lambert/26/README.md

# 26 Octave Filter

[Documentation](docs/README.md).

[Electrical CAD files](ecad/README.md)

[Mechanical CAD files](mcad/README.md)

CC BY-SA
