lambert/26/ecad/pcb/README.md

Requires [pcb version 4.1.2](https://sourceforge.net/projects/pcb/files/pcb/pcb-4.1.2/) or later.
