lambert/26/ecad/pcb/plotfiles/26.999.00.01.01.pcb.pdf

## 26.999.00.01.01.pcb

## 1. Table of Contents (This Page) Created on Sat Feb 13 14:51:58 2021 2. top 3. bottom 4. outline 5. plated-drill 6. componentmask 7. soldermask 8. topsilk 9. bottomsilk 10. bottompaste 11. topassembly 12. bottomassembly 13. fab

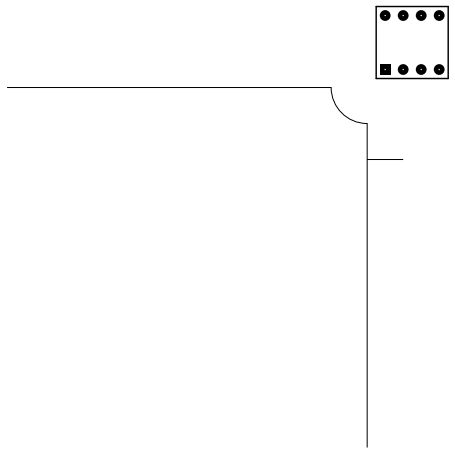
[picture p258: figure]

26.999.00.01.01.pcb, top, scale = 1:1.000

26.999.00.01.01.pcb, bottom (mirrored), scale = 1:1.000

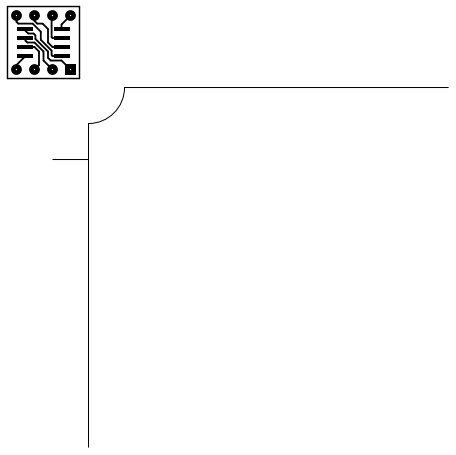
[picture p259: figure]

26.999.00.01.01.pcb, outline, scale = 1:1.000

26.999.00.01.01.pcb, plated-drill, scale = 1:1.000

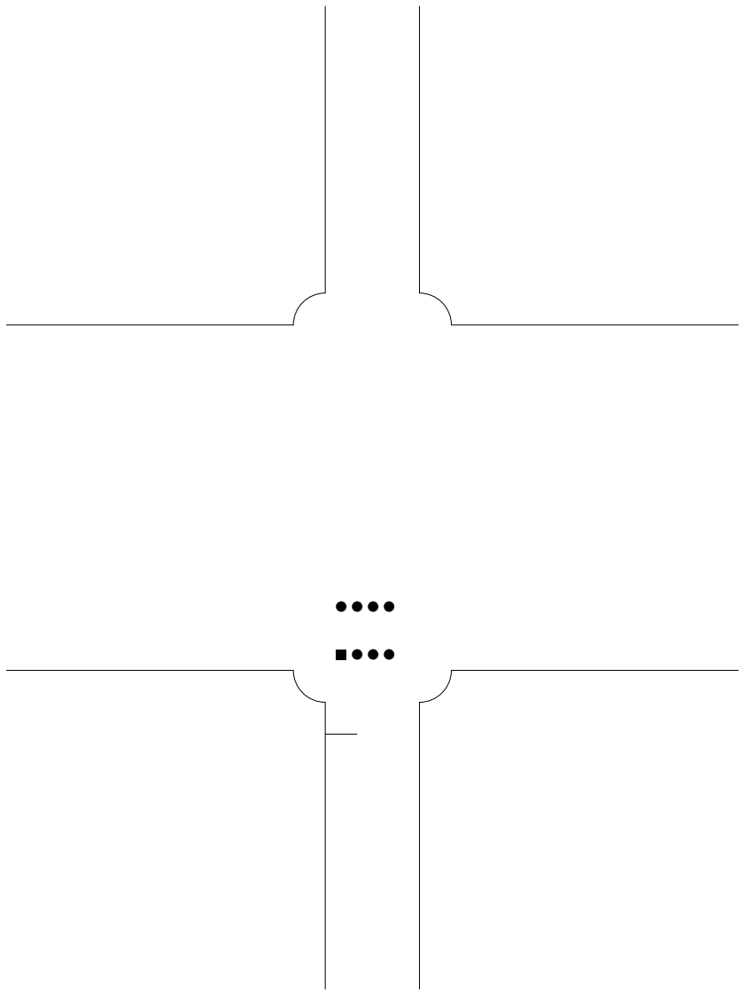
[picture p260: figure]

26.999.00.01.01.pcb, topmask, scale = 1:1.000

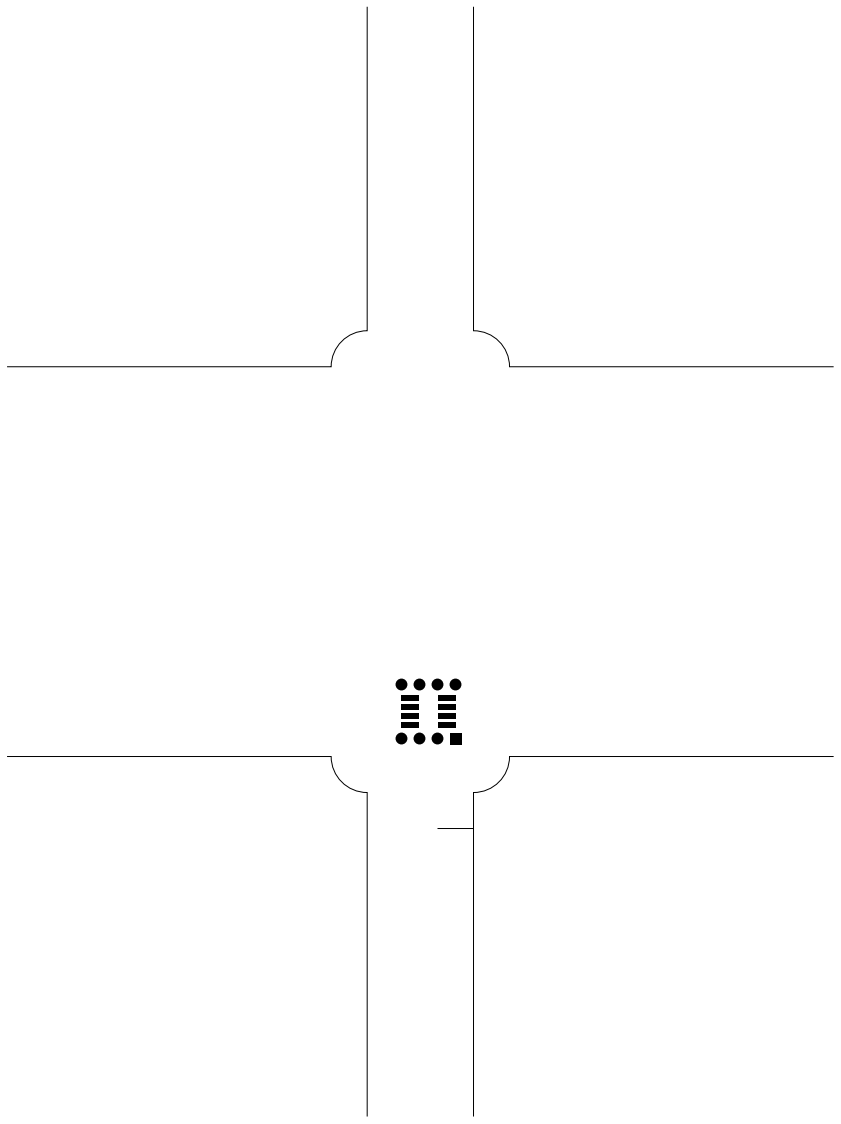
[picture p261: figure]

26.999.00.01.01.pcb, bottommask (mirrored), scale = 1:1.000

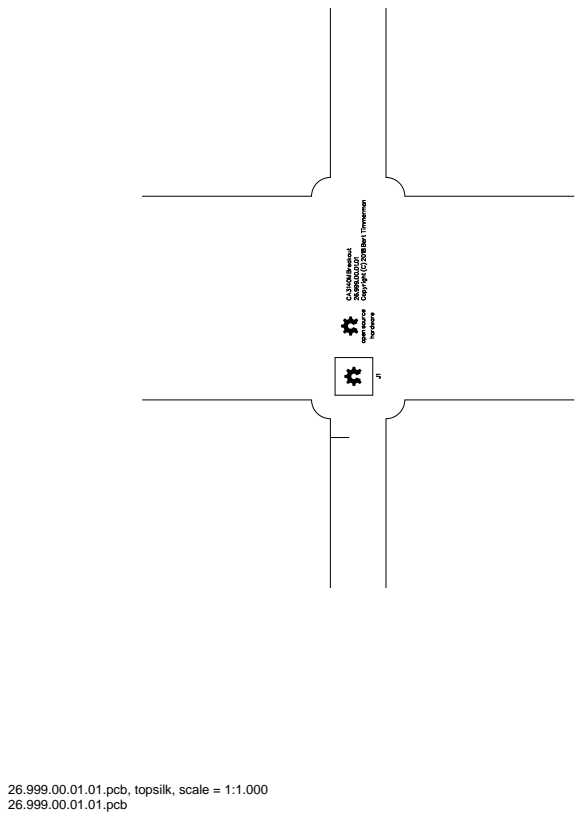
[picture p262: page 8]

26.999.00.01.01.pcb, topsilk, scale = 1:1.000

26.999.00.01.01.pcb, bottomsilk (mirrored), scale = 1:1.000

26.999.00.01.01.pcb, bottompaste (mirrored), scale = 1:1.000

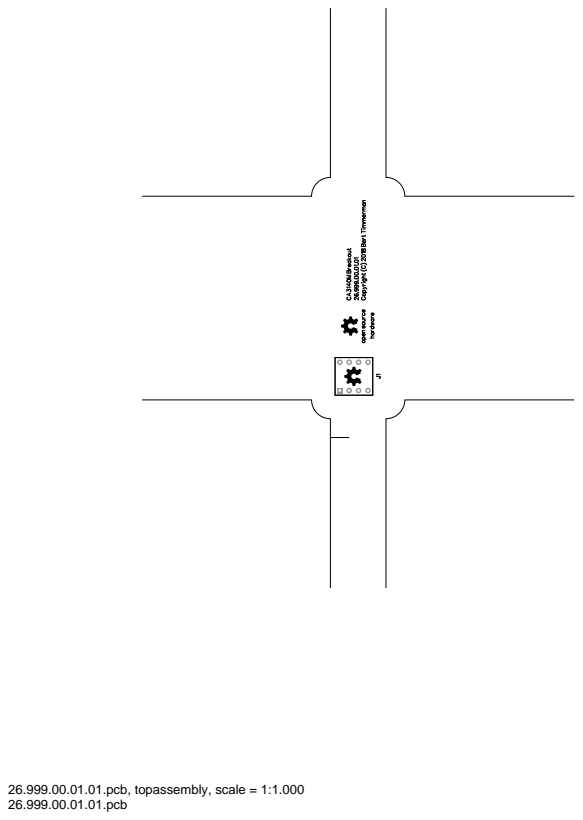
[picture p263: page 11]

26.999.00.01.01.pcb, topassembly, scale = 1:1.000

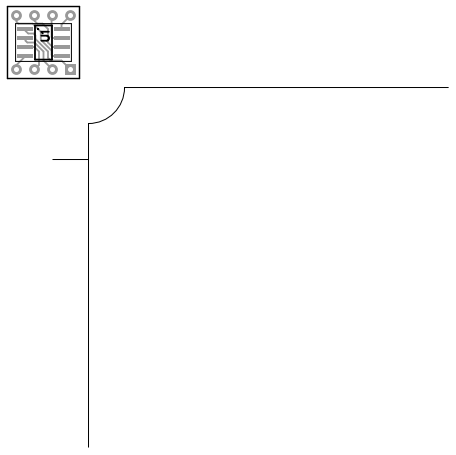
[picture p264: figure]

26.999.00.01.01.pcb, bottomassembly (mirrored), scale = 1:1.000

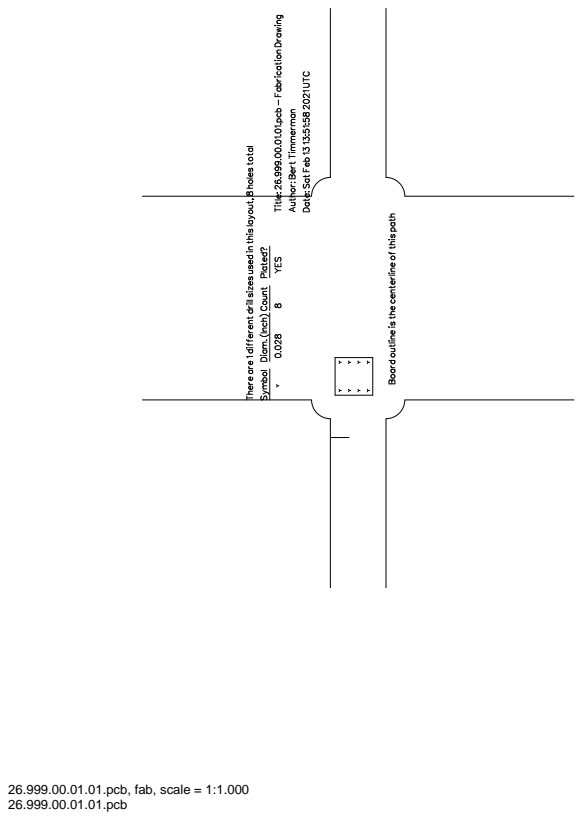
[picture p265: page 13]

26.999.00.01.01.pcb, fab, scale = 1:1.000
