lambert/26/ecad/pcb/plotfiles/26.999.01.01.01.pcb.pdf

## 26.999.01.01.01.pcb

## 1. Table of Contents (This Page) Created on Sat Feb 13 14:51:58 2021 2. top 3. bottom 4. outline 5. plated-drill 6. componentmask 7. soldermask 8. topsilk 9. bottomsilk 10. bottompaste 11. topassembly 12. bottomassembly 13. fab

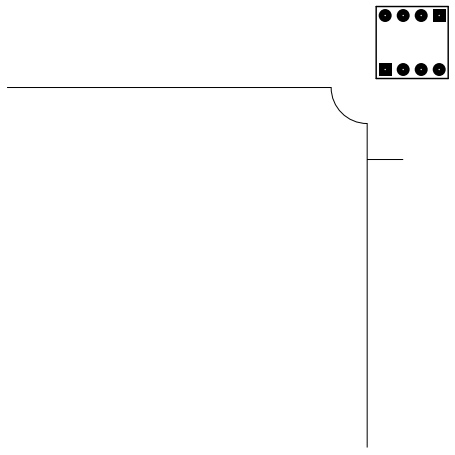
[picture p266: figure]

26.999.01.01.01.pcb, top, scale = 1:1.000

26.999.01.01.01.pcb, bottom (mirrored), scale = 1:1.000

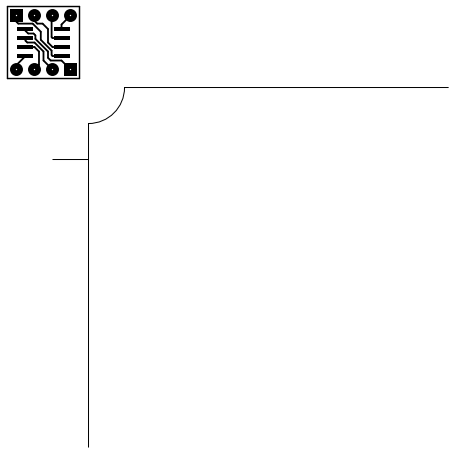
[picture p267: figure]

26.999.01.01.01.pcb, outline, scale = 1:1.000

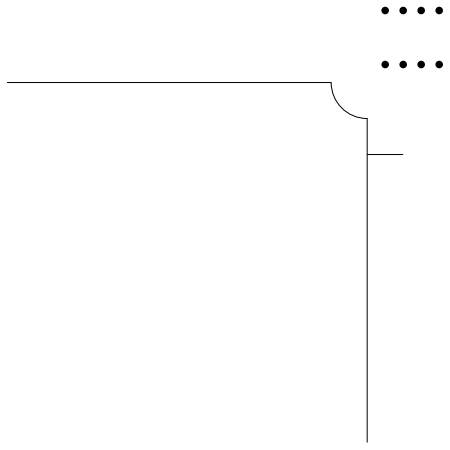
[picture p268: figure]

26.999.01.01.01.pcb, plated-drill, scale = 1:1.000

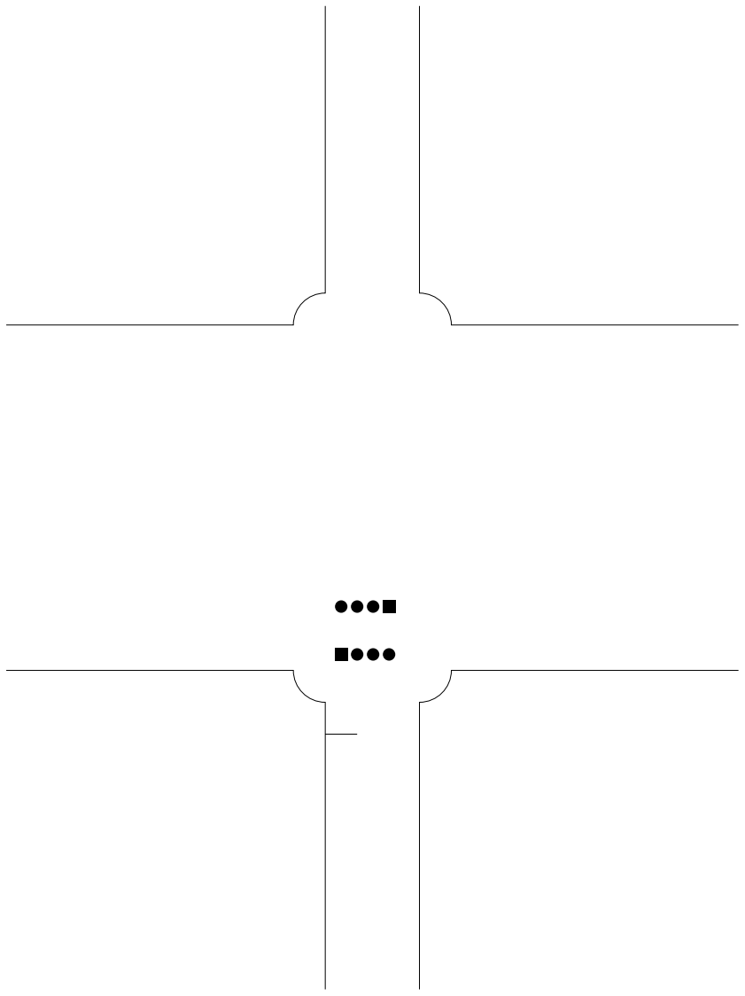
[picture p269: figure]

26.999.01.01.01.pcb, topmask, scale = 1:1.000

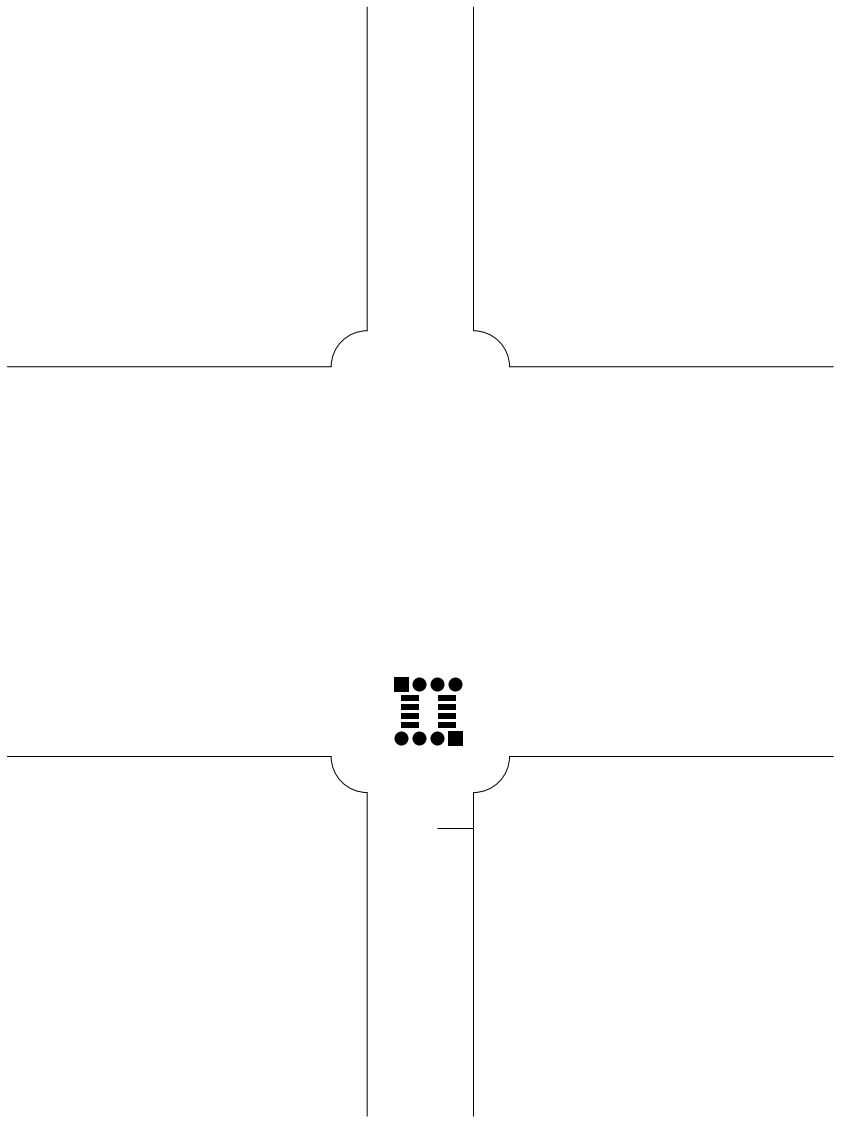
[picture p270: figure]

26.999.01.01.01.pcb, bottommask (mirrored), scale = 1:1.000

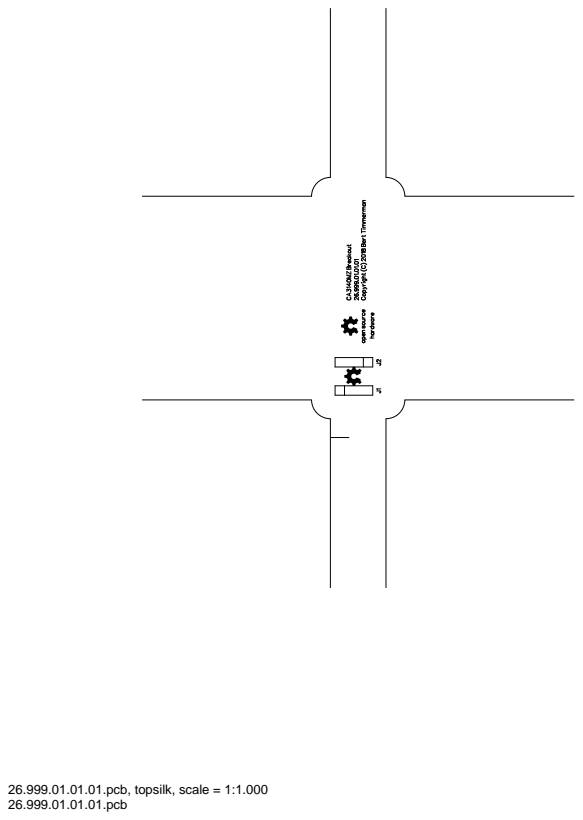
[picture p271: page 8]

26.999.01.01.01.pcb, topsilk, scale = 1:1.000

26.999.01.01.01.pcb, bottomsilk (mirrored), scale = 1:1.000

26.999.01.01.01.pcb, bottompaste (mirrored), scale = 1:1.000

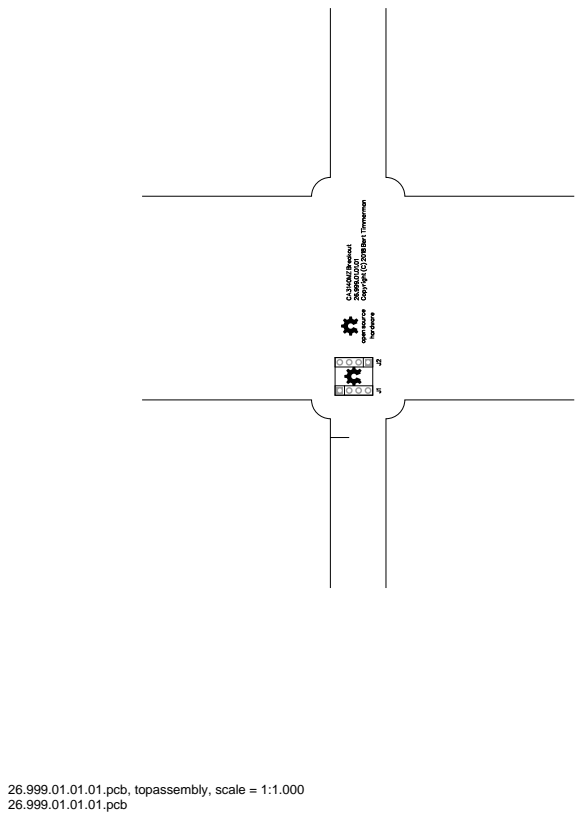
[picture p272: page 11]

26.999.01.01.01.pcb, topassembly, scale = 1:1.000

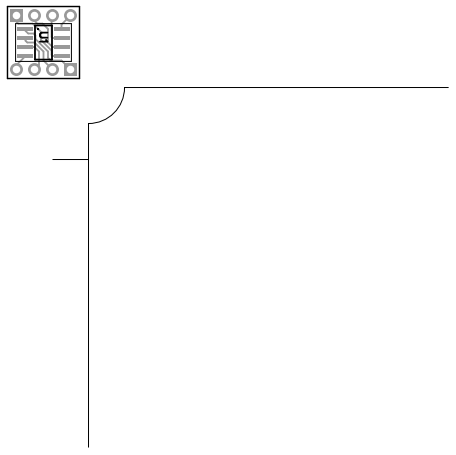
[picture p273: figure]

26.999.01.01.01.pcb, bottomassembly (mirrored), scale = 1:1.000

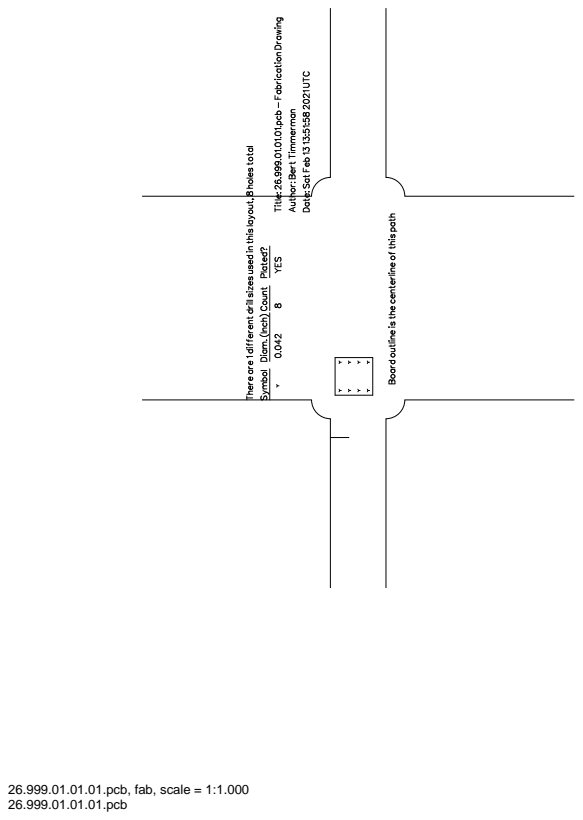
[picture p274: page 13]

26.999.01.01.01.pcb, fab, scale = 1:1.000
