lambert/26/ecad/gnucap/26.000.00.02.07.png

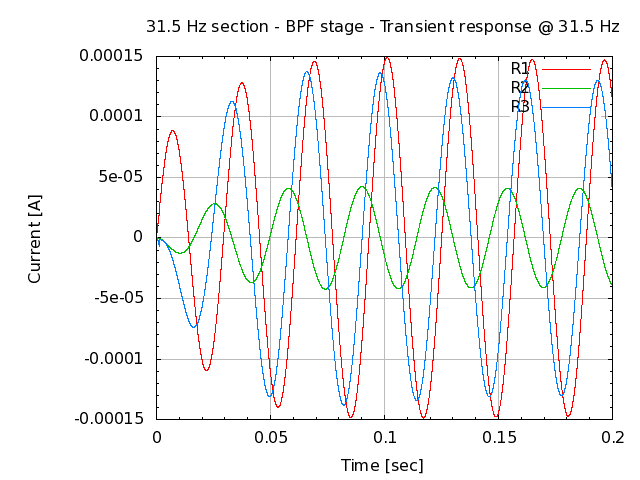
ecad/gnucap/26.000.00.02.07.png
