lambert/26/ecad/pcb/eyecandy/26.002.00.01.01.pcb.top.png

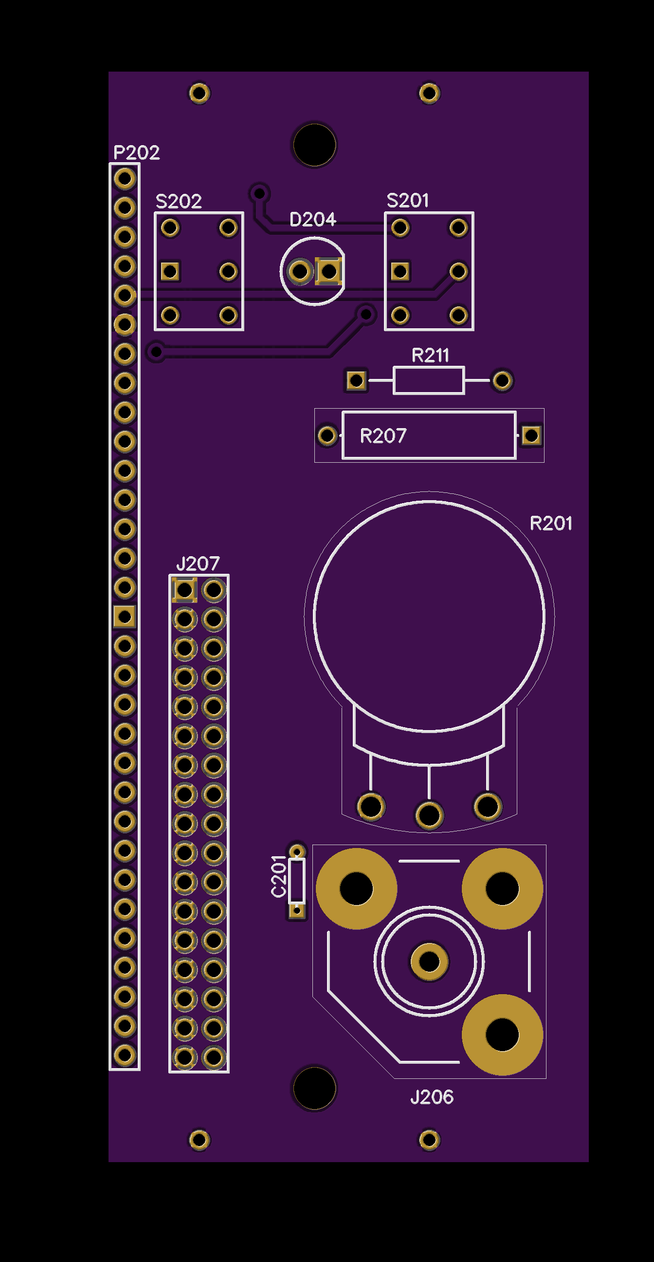
ecad/pcb/eyecandy/26.002.00.01.01.pcb.top.png
