lambert/26/ecad/pcb/eyecandy/26.003.00.01.01.pcb.top.png

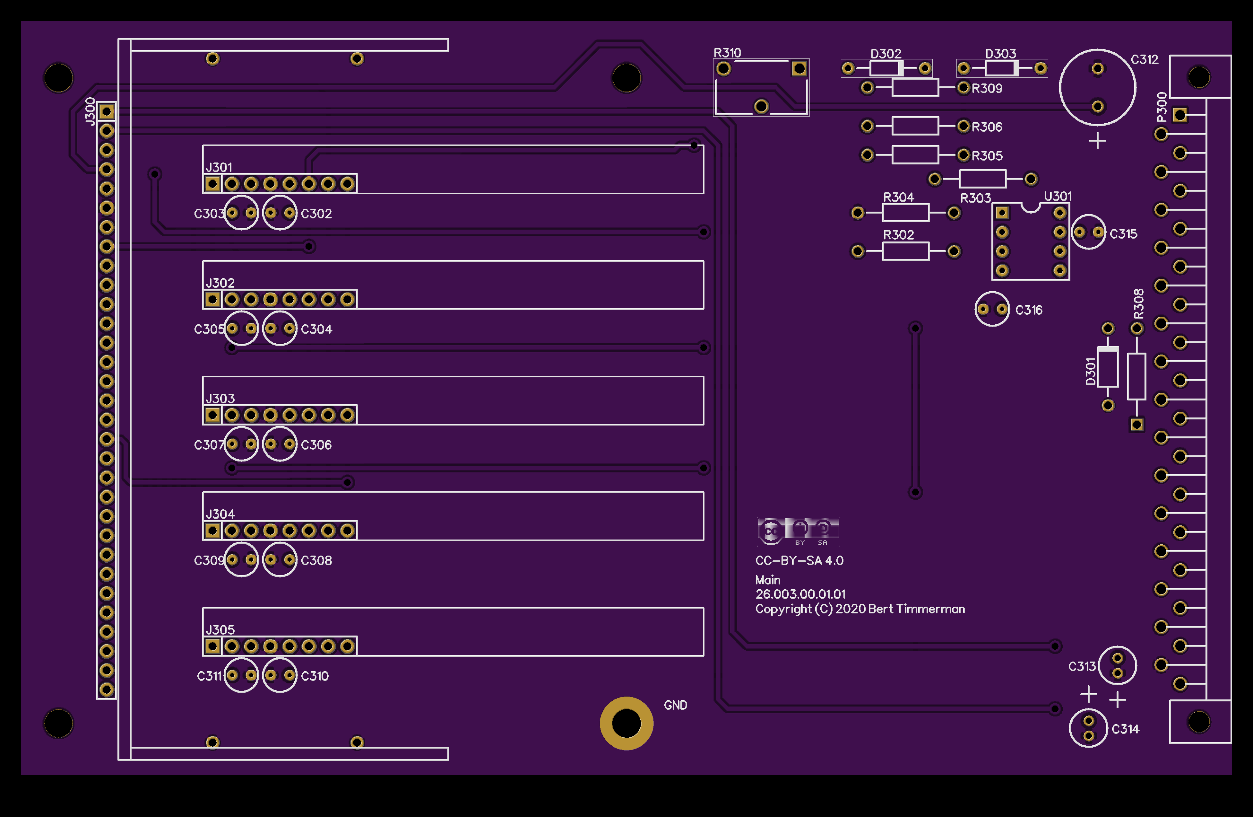
ecad/pcb/eyecandy/26.003.00.01.01.pcb.top.png
