lambert/26/ecad/pcb/eyecandy/26.005.00.01.01.pcb.top.png

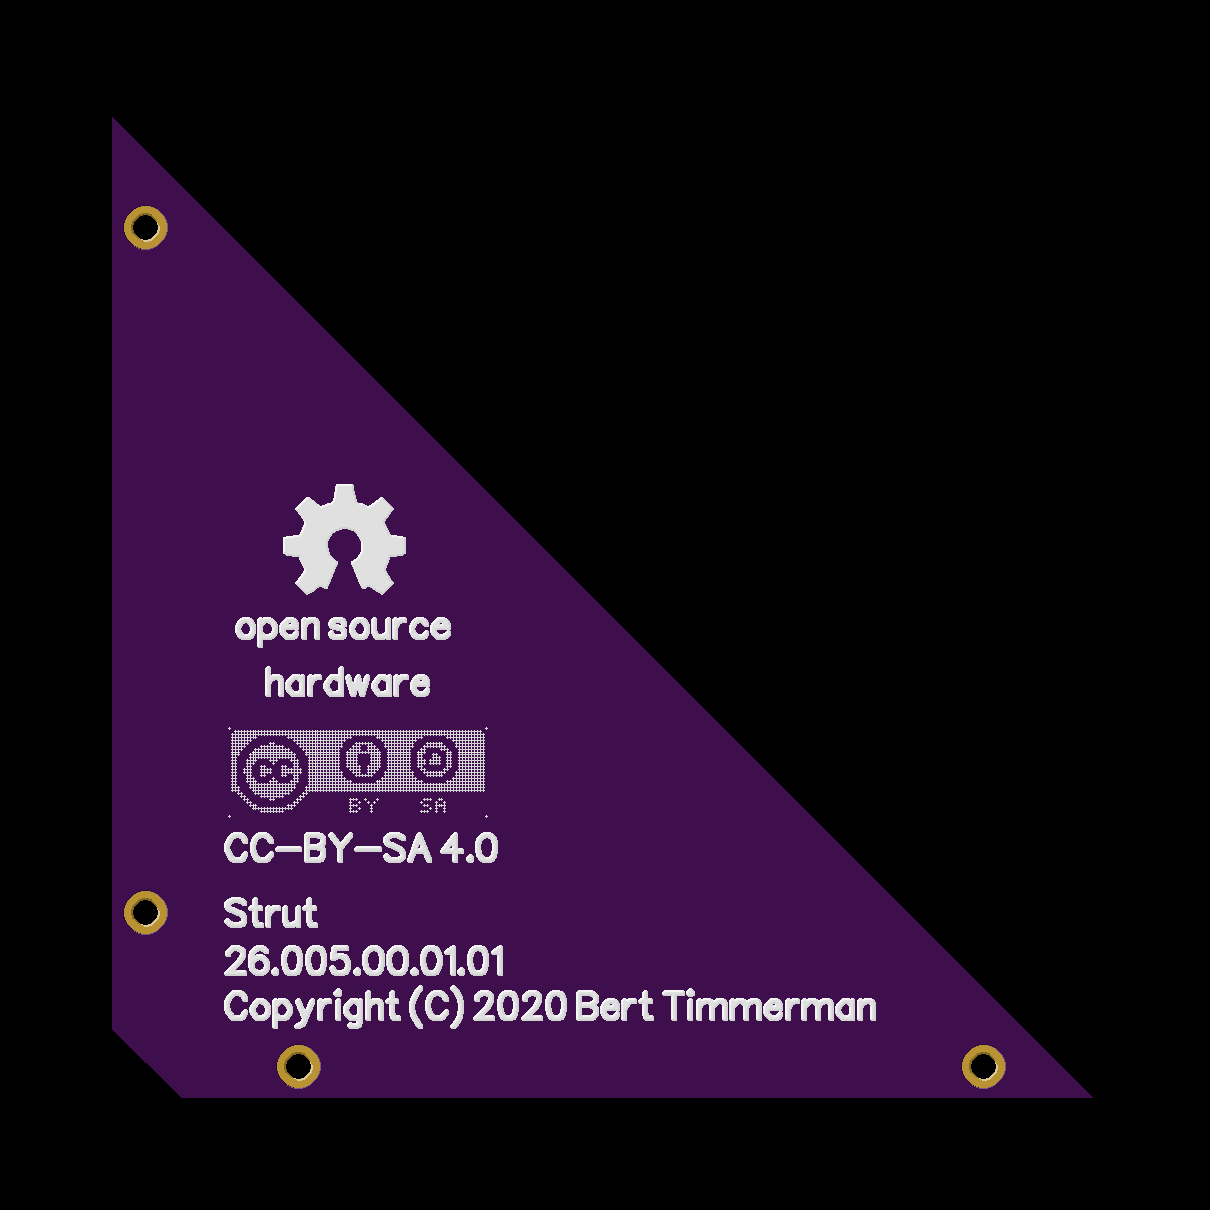
ecad/pcb/eyecandy/26.005.00.01.01.pcb.top.png
