lambert/26/ecad/pcb/eyecandy/26.006.00.01.01.pcb.bottom.png

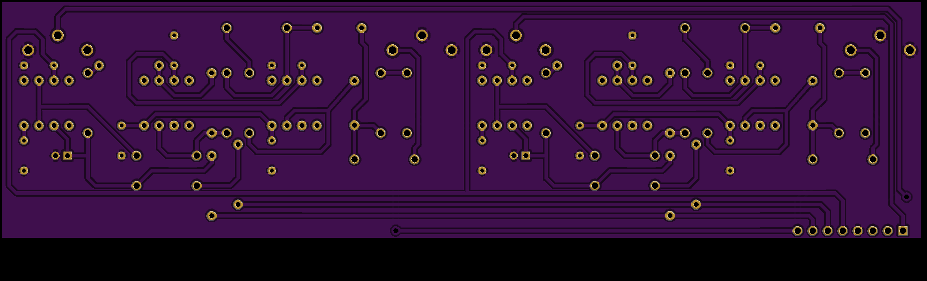
ecad/pcb/eyecandy/26.006.00.01.01.pcb.bottom.png
