lambert/26/ecad/pcb/eyecandy/26.006.02.01.01.pcb.bottom.png

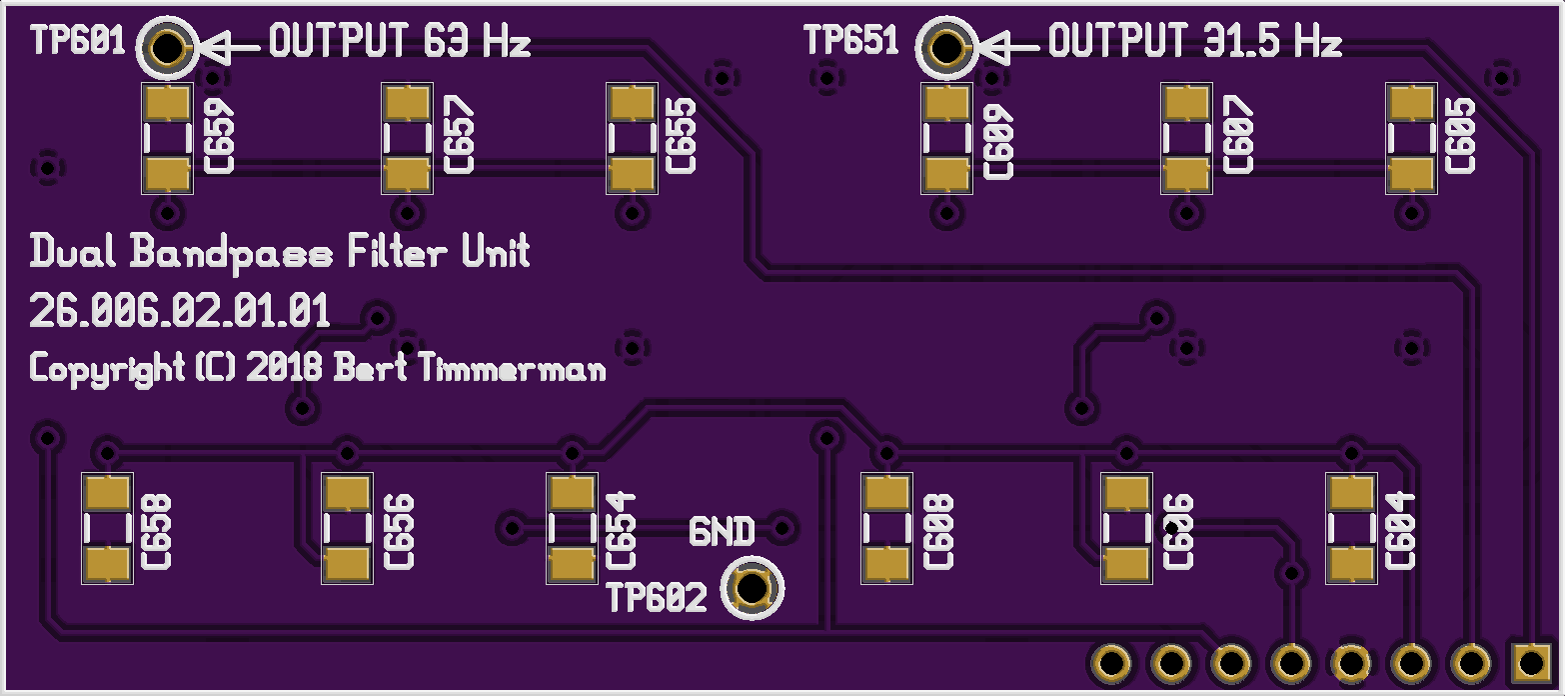
ecad/pcb/eyecandy/26.006.02.01.01.pcb.bottom.png
