lambert/26/ecad/pcb/eyecandy/26.999.00.01.01.pcb.bottom.png

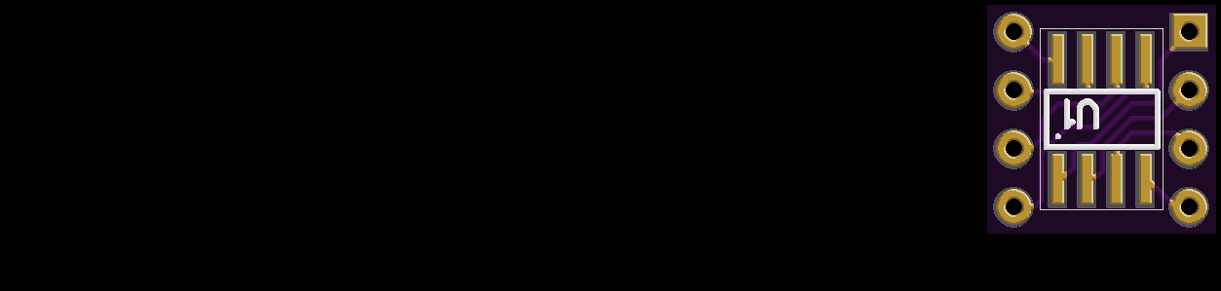
ecad/pcb/eyecandy/26.999.00.01.01.pcb.bottom.png
