lambert/26/docs/purchase/OSH_Park/README.md

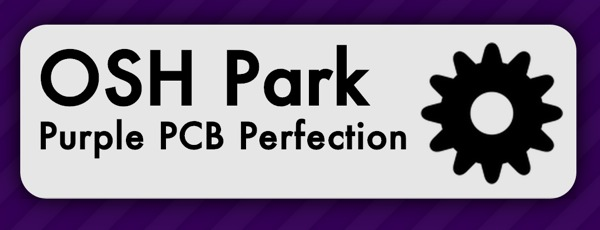
[picture p293: docs/purchase/OSH_Park/OSH_Park_logo.jpg]
OSH_Park_logo
.

----

# 26.004.00 Main board cover and shielding.

**DO NOT ORDER** (Work In Progress).

Top view:

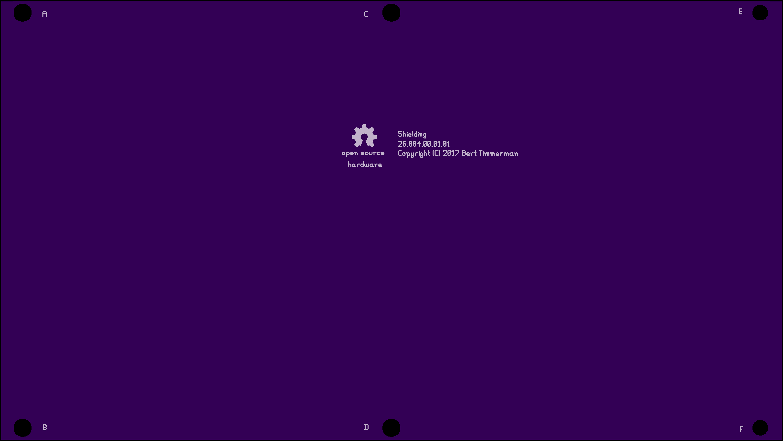
[picture p294: docs/purchase/OSH_Park/26-004-00/26-004-00_top_large.png]


Bottom view:

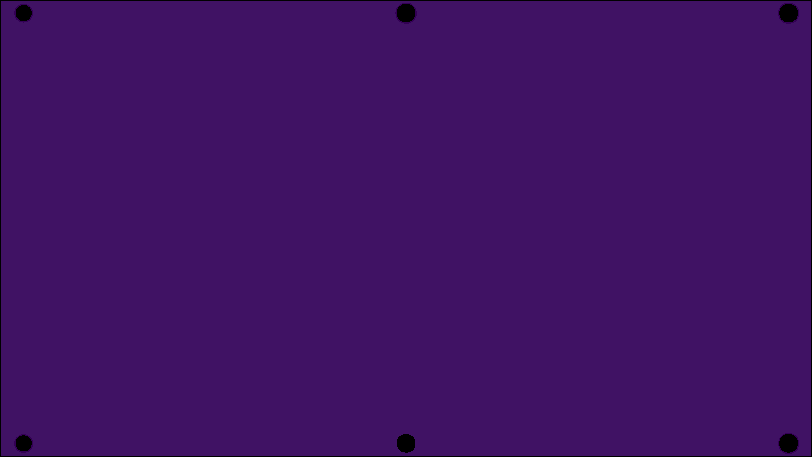
[picture p295: docs/purchase/OSH_Park/26-004-00/26-004-00_bottom_large.png]
Bottom view


[Project description](26-004-00/README.md)

----

# 26.006.00 Band pass filter daughter board.

First PTH version.

**DO NOT ORDER** : contains a connection (polarity) error on all operational amplifiers.

Top view:

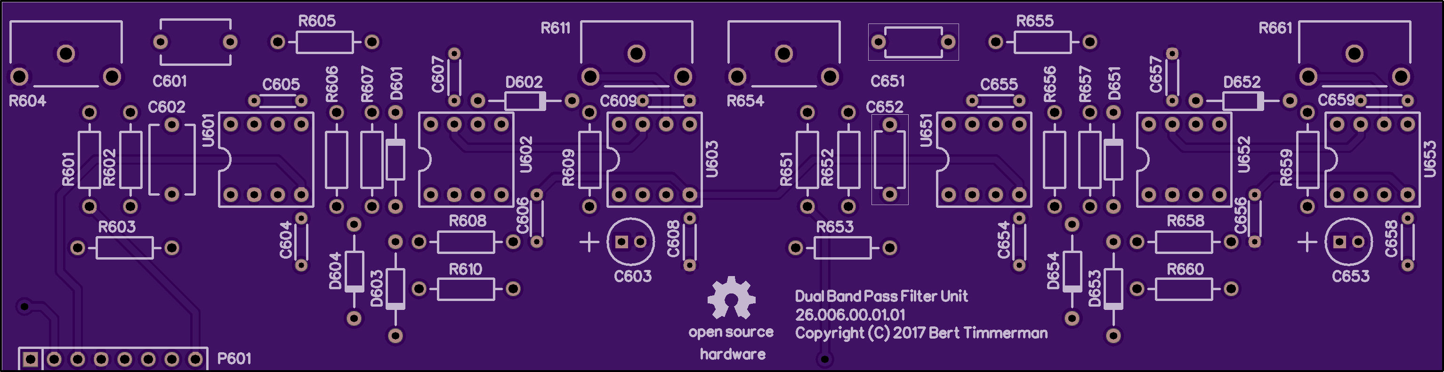
[picture p296: docs/purchase/OSH_Park/26-006-00/26-006-00_top_large.png]


Bottom view:

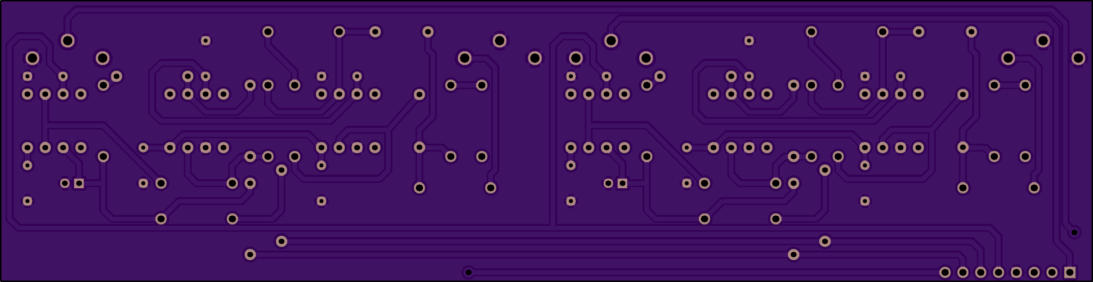
[picture p297: docs/purchase/OSH_Park/26-006-00/26-006-00_bottom_large.png]
Bottom view


[Project description](26-006-00/README.md)

----

# 26.006.01 Band pass filter daughter board.

Debugged PTH version (**DO NOT ORDER** Work In Progress).

----

# 26.006.02 Band pass filter daughter board.

First SMT version (**DO NOT ORDER** Work In Progress).

----

# 26.999.00 SOIC8 - DIP08300 Breakout Board.

**DO NOT ORDER** : Drill holes to tight for male headers.

Top view:

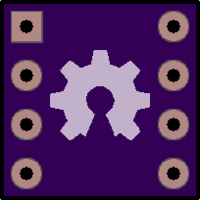
[picture p298: docs/purchase/OSH_Park/26-999-00/26-999-00_top_large.png]


Bottom view:

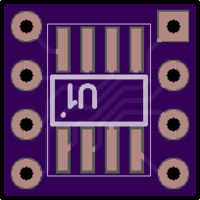
[picture p299: docs/purchase/OSH_Park/26-999-00/26-999-00_bottom_large.png]
Bottom view


[Project description](26-999-00/README.md)

----

# 26.999.01 SOIC8 - DIP08300 Breakout Board.

Top view:

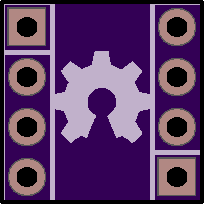
[picture p300: docs/purchase/OSH_Park/26-999-01/26-999-01_top_large.png]


Bottom view:

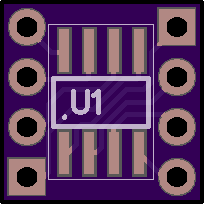
[picture p301: docs/purchase/OSH_Park/26-999-01/26-999-01_bottom_large.png]
Bottom view


[Project description](26-999-01/README.md)
