lambert/26/docs/purchase/OSH_Park/26-001-00/README.md

About your board

We detected a 2 layer board of 2.00 x 5.05 inches (50.8 x 128.3mm)
3 boards will cost $50.45

    Board name
    Description

Notes

    	Processing information
        Processing 26-001-00.zip as generic ZIP file.
        2 layer board of 2.00x5.05 inches.
        Correcting drill zero suppression. Please verify drills align correctly. See help page.
        Your project contains 2 drill files, we've merged them. ["26.001.00.01.01.TXT", "26.001.00.01.01.XLN"]
