lambert/26/mcad/partslist/26.001.00.01.01_front_panel_assembly_partlist.md

# Partlist.

Part: 26.001.00.01.01_front_panel_assembly

Drawn: Bert Timmerman

Date: 20201114

| Part no. | Amount | Description | Value | Vendor | Vendor no. / Standard |
|---|---|---|---|---|---|
| 1 | 1 | 26 front panel layout |128x50.5x1.6 mm | OSH Park | |
| 101 | 2 | Cilinder head screw | M3x25 | | ISO 1580 |
| 102 | 2 | Spacer | 5x3.5x15 | | |
| 103 | 2 | Hexagon nut | M3 | | ISO 4032 |
| 104 | 1 | Knob | Ritel 26 21 60 1 | Conrad | [1416428](https://www.conrad.com/p/ritel-26-21-60-1-control-knob-grey-x-h-21-mm-x-175-mm-1-pcs-1416428) |
| 105 | 1 | Cover | Ritel 30 21 11 1 | Conrad | [1416451](https://www.conrad.com/p/ritel-30-21-11-1-cover-hand-grey-1-pcs-1416451) |
| 106 | 1 | Indicator | Ritel 40 21 00 3 | Conrad | [1416477](https://www.conrad.com/p/ritel-40-21-00-3-pointer-black-1-pcs-1416477) |
