lambert/26/ecad/gschem/BOM/26.999.00.01.01.sch.csv

refdes | footprint | value | mfg | mfg_PN | vendor | vendor_PN | price | documentation | source | comment
J1 | DIP08300____.fp | unknown | unknown | unknown | unknown | unknown | unknown | unknown | unknown | unknown
U1 | SOIC127P600X155-8N____.fp | unknown | unknown | unknown | unknown | unknown | unknown | unknown | unknown | unknown
