lambert/26/ecad/gschem/BOM/26.003.00.01.01.sch.csv

refdes | footprint | value | mfg | mfg_PN | vendor | vendor_PN | price | documentation | source | comment
D303 | DIO1016-425X185_Diotec_1N4148_DO35_C1A2 | 1N4148 | Diotec | 1N4148 | Conrad | 162280 | 0.15 | unknown | unknown | SOD-27
D302 | DIO1016-425X185_Diotec_1N4148_DO35_C1A2 | 1N4148 | Diotec | 1N4148 | Conrad | 162280 | 0.15 | unknown | unknown | SOD-27
D301 | DIO1016-520X270_Diodes_1N4004_DO41_C1A2.fp | 1N4004 | Diotec | 1N4004 | Conrad | 162248 | 0.08 | unknown | unknown | DO-204AL
J305 | CON-SIL-254P-8N____.fp | unknown | W+P | 257-008-1-50-00-6 | Conrad | 719755 | 1.15 | unknown | unknown | female
J304 | CON-SIL-254P-8N____.fp | unknown | W+P | 257-008-1-50-00-6 | Conrad | 719755 | 1.15 | unknown | unknown | female
J303 | CON-SIL-254P-8N____.fp | unknown | W+P | 257-008-1-50-00-6 | Conrad | 719755 | 1.15 | unknown | unknown | female
J302 | CON-SIL-254P-8N____.fp | unknown | W+P | 257-008-1-50-00-6 | Conrad | 719755 | 1.15 | unknown | unknown | female
J301 | CON-SIL-254P-8N____.fp | unknown | W+P | 257-008-1-50-00-6 | Conrad | 719755 | 1.15 | unknown | unknown | female
C316 | CAPR250-450X850____.fp | 100nF | Holystone | RDCX104K050DKA | Conrad | 531855 | 0.10 | unknown | unknown | X7R
C315 | CAPR250-450X850____.fp | 100nF | Holystone | RDCX104K050DKA | Conrad | 531855 | 0.10 | unknown | unknown | X7R
R305 | RES1270-635X229____0.6W.fp | 1M | UNI-OHM | CFR0W2J0105**0 | Conrad | 405612 | 0.11 | unknown | unknown | 0411
R306 | RES1270-635X229____0.6W.fp | 1M | UNI-OHM | CFR0W2J0105**0 | Conrad | 405612 | 0.11 | unknown | unknown | 0411
p3 | PIN165X102____.fp | unknown | unknown | unknown | unknown | unknown | unknown | unknown | unknown | unknown
p4 | PIN165X102____.fp | unknown | unknown | unknown | unknown | unknown | unknown | unknown | unknown | unknown
p1 | PIN165X102____.fp | unknown | unknown | unknown | unknown | unknown | unknown | unknown | unknown | unknown
p2 | PIN165X102____.fp | unknown | unknown | unknown | unknown | unknown | unknown | unknown | unknown | unknown
GND | MTG370-700____.fp | unknown | unknown | unknown | unknown | unknown | unknown | unknown | unknown | unknown
C | MTG370____.fp | unknown | unknown | unknown | unknown | unknown | unknown | unknown | unknown | unknown
B | MTG370____.fp | unknown | unknown | unknown | unknown | unknown | unknown | unknown | unknown | unknown
A | MTG370____.fp | unknown | unknown | unknown | unknown | unknown | unknown | unknown | unknown | unknown
J300 | CON-SIL-254P-31N____.fp | unknown | W+P | 153-034-1-50-00 | Conrad | 738348 | 2.37 | unknown | unknown | female
C312 | CAPPR500-1000X1300____.fp | 100uF/63V | Teapo | SY | Conrad | 444066 | 0.18 | unknown | unknown | unknown
R308 | RES1270-635X229____0.6W.fp | 1k | UNI-OHM | CFR0W2J0102**0 | Conrad | 405256 | 0.11 | unknown | unknown | 0411
U301 | DIPS08300____.fp | CA3140E | Intersil | CA3140E | Conrad | 174785 | 0.92 | unknown | unknown | Conrad 189600 DIP-8 socket
R310 | TRIM_Piher_PT-15LH05__.fp | 10k | Piher | PT 15 LH 05 10K | Conrad | 431230 | 0.53 | unknown | unknown | unknown
R309 | RES1270-635X229____0.6W.fp | 1k | UNI-OHM | CFR0W2J0102**0 | Conrad | 405256 | 0.11 | unknown | unknown | 0411
C311 | CAPR250-450X850____.fp | 100nF | Holystone | RDCX104K050DKA | Conrad | 531855 | 0.10 | unknown | unknown | X7R
C310 | CAPR250-450X850____.fp | 100nF | Holystone | RDCX104K050DKA | Conrad | 531855 | 0.10 | unknown | unknown | X7R
C309 | CAPR250-450X850____.fp | 100nF | Holystone | RDCX104K050DKA | Conrad | 531855 | 0.10 | unknown | unknown | X7R
C308 | CAPR250-450X850____.fp | 100nF | Holystone | RDCX104K050DKA | Conrad | 531855 | 0.10 | unknown | unknown | X7R
C307 | CAPR250-450X850____.fp | 100nF | Holystone | RDCX104K050DKA | Conrad | 531855 | 0.10 | unknown | unknown | X7R
C306 | CAPR250-450X850____.fp | 100nF | Holystone | RDCX104K050DKA | Conrad | 531855 | 0.10 | unknown | unknown | X7R
C305 | CAPR250-450X850____.fp | 100nF | Holystone | RDCX104K050DKA | Conrad | 531855 | 0.10 | unknown | unknown | X7R
C304 | CAPR250-450X850____.fp | 100nF | Holystone | RDCX104K050DKA | Conrad | 531855 | 0.10 | unknown | unknown | X7R
C303 | CAPR250-450X850____.fp | 100nF | Holystone | RDCX104K050DKA | Conrad | 531855 | 0.10 | unknown | unknown | X7R
C302 | CAPR250-450X850____.fp | 100nF | Holystone | RDCX104K050DKA | Conrad | 531855 | 0.10 | unknown | unknown | X7R
R303 | RES1270-635X229____0.6W.fp | 47k | UNI-OHM | CFR0W2J0373**0 | Conrad | 405450 | 0.09 | unknown | unknown | 0411
R304 | RES1270-635X229____0.6W.fp | 4k7 | UNI-OHM | CFR0W2J0472**0 | Conrad | 405337 | 0.11 | unknown | unknown | 0411
C313 | CAPPR200-500X1100____.fp | 10uF/63V | Panasonic | ECA1JM100 | Conrad | 792500 | 0.09 | unknown | unknown | unknown
C314 | CAPPR200-500X1100____.fp | 10uF/63V | Panasonic | ECA1JM100 | Conrad | 792500 | 0.09 | unknown | unknown | unknown
P300 | CON-DIN41617-31N_Assmann_A-31-S1_DIN41617_male.fp | DIN41617 31p | Assmann | A-31-S1 | Conrad | 740560 | 5.12 | unknown | unknown | silver/male
R302 | RES1270-635X229____0.6W.fp | 10k | UNI-OHM | CFR0W2J0103**0 | Conrad | 403370 | 0.09 | unknown | unknown | 0411
