lambert/26/docs/purchase/OSH_Park/26-001-00/bottom_large.png

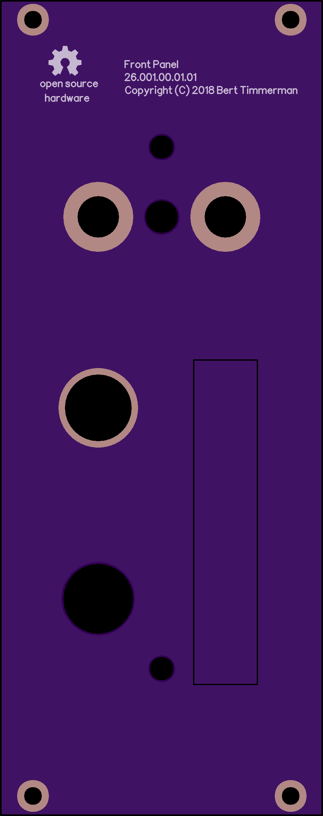
docs/purchase/OSH_Park/26-001-00/bottom_large.png
