lambert/26/docs/purchase/OSH_Park/26-001-00/top.png

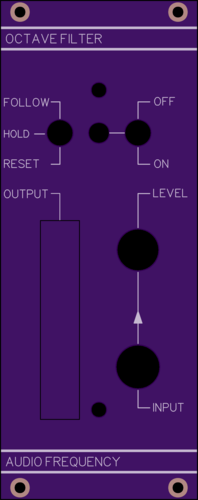
docs/purchase/OSH_Park/26-001-00/top.png
