lambert/26/docs/purchase/OSH_Park/pcb-4-layer-stackup.png

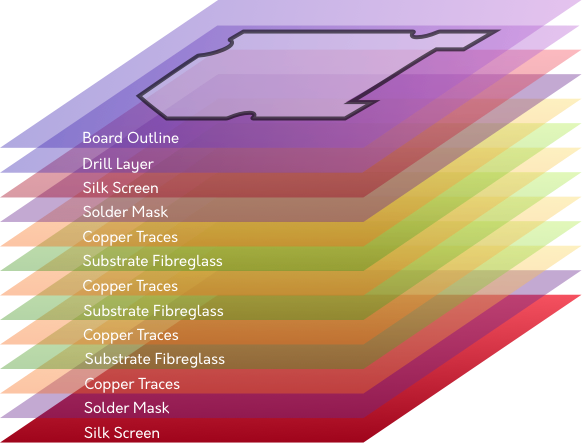
docs/purchase/OSH_Park/pcb-4-layer-stackup.png
