lambert/26/(list of files, cad)

Other CAD files:
mcad/26.000.00.01.01_assembly_ISO_views.dwg
mcad/parts/26_assembly.dwg
mcad/parts/26_BNC_connector_assembly.dwg
mcad/26.000.00.01.02_assembly_top_view.dwg
mcad/parts/26_filter_pcb_smt_assembly.dwg
mcad/26.003.00.03.01_main_pcb_mechanical.dwg
mcad/parts/26_front_panel_assembly.dwg
mcad/26.000.00.01.00_assembly_SW_ISO_view.dwg
mcad/26.006.01.01.01_filter_pcb_assembly.dwg
mcad/parts/26_front_pcb_assembly.dwg
mcad/26.000.00.01.07_assembly_right_view.dwg
mcad/parts/26_main_pcb_assembly.dwg
mcad/26.000.00.01.06_assembly_left_view.dwg
mcad/26.000.00.01.03_assembly_bottom_view.dwg
mcad/26.000.00.01.05_assembly_back_view.dwg
mcad/parts/26_main_pcb.dwg
mcad/26.002.00.01.01_front_pcb_assembly.dwg
mcad/26.000.00.01.04_assembly_front_view.dwg
mcad/26.001.00.01.01_front_panel_assembly.dwg
mcad/26.003.00.01.01_main_pcb_assembly.dwg
mcad/26.003.00.02.02_main_pcb_drill_info.dwg
mcad/26.002.00.03.01_front_pcb_mechanical.dwg
mcad/parts/26.006.00.dwg
mcad/parts/26_shielding_pcb.dwg
mcad/26.001.00.02.01_front_panel_layout.dwg
mcad/parts/26_front_panel_layout.dwg
mcad/26.004.00.03.01_shielding_pcb_mechanical.dwg
mcad/parts/26_filter_pcb_smt.dwg
mcad/parts/26_front_panel.dwg
mcad/parts/26_CON-BNC_Conrad_740837_UG290U_nickel-plated_modified.dwg
mcad/26.001.01.02.01_front_panel_layout.dwg
mcad/parts/26_side_panel.dwg
mcad/26.001.00.03.01_front_panel_mechanical.dwg
mcad/parts/26_front_pcb.dwg
mcad/26.006.01.03.01_filter_pcb_mechanical.dwg
mcad/26.005.00.03.01_side_panel_mechanical.dwg
mcad/26.006.00.02.02_filter_pcb_drill_info.dwg
mcad/26.002.00.02.02_front_pcb_drill_info.dwg
