lambert/26/docs/purchase/OSH_Park/fabrication_services.md

# OSH Park Fabrication Services.

[OSH Park](https://www.oshpark.com/) is a community printed circuit board (PCB) order that brings
you high quality, lead-free boards which are manufactured in the United
States and shipped for free to anywhere in the world.

We offer purple soldermask over bare copper (SMOBC) and an ENIG
(Electroless Nickel Immersion Gold) finish.

Full stackups and design rules are linked under Services below.

Please email us at [support@oshpark.com](mailto://support@oshpark.com) with questions!

## Two Layer Boards.

All two-layer boards ship with FR4 substrate, purple mask over bare
copper, and ENIG (immersion gold) finish.

Minimum design rules are 6 mil trace clearance, 6 mil trace width,
10 mil drill size, and 5 mil annular ring.

Service      | Cost                                          | Time to Ship     | Board Thickness   | Copper Weight |
-------------|-----------------------------------------------|------------------|-------------------|---------------|
Prototype    | $5 per square inch for a set of three boards  | 12 Calendar Days | 63 mil (1.6 mm)   | 1 oz          |
Super Swift  | $10 per square inch for a set of three boards | 5 Business Days  | 63 mil (1.6 mm)   | 1 oz          |
2 oz 0.8mm   | $5 per square inch for a set of three boards  | 2-3 Weeks        | 32 mil (0.8 mm)   | 2 oz          |
medium run   | $1 per square inch. 100 sq inch minimum.      | 15 Calendar Days | 63 mil (1.6 mm)   | 1 oz          |

One-sided boards can be ordered on any of our 2 Layer services.

### 2 Layer Prototype Service.

Our famous 2 layer purple prototype production.

#### Pricing.

$5 per square inch, which includes three copies of your design.

For example, a 2 square inch board would cost $10 and you’d get three
copies of your board.

You can order as many copies as you want, as long as they’re in
multiples of three.

#### Turn Times.

Orders are sent to fabrication daily, and will ship within 12 days.

95% of our 2 layer orders ship in 8 days.

You can get a quote, approve a design, and pay for an order at OSH Park.

For a faster turn time, you may be interested in our Super Swift Service.

For thinner, lighter, or high current boards, you may be interested in
our 2oz-0.8mm Service.

Need more than 100 square inches of boards?

Our 2 Layer Medium Run Service is a less expensive option for larger
orders.

#### Fabrication Specs.

Quick Specs:

  - 2 Layer PCB
  - 6 mil minimum trace width.
  - 6 mil minimum trace spacing.
  - 10 mil minimum drill.
  - 5 mil annular ring.
  - PCB thickness of 1.6 mm (.063”).
  - 1 oz copper on both sides (1.4 mil, 35 um).

Detailed Specs:

  - ENIG (gold) finish for superior soldering and environmental resistance.
  - Solder resist and silkscreen on both sides.
  - Minimum 15 mil keepout distance from traces to the board edge.
  - PCB substrate is FR4 (170 Tg).
  - PCB substrate is compatible with a lead-free process.
  - The boards themselves are also lead free and RoHS compliant.
  - PCB Substrate dielectric constant of 4.6 at 1 MHz.
  - Minimum 4 mil soldermask web.
  - Maximum soldermask expansion, retraction, or shift is 3 mil.
  - Minimum 100 mil width on internal cutouts. See our [Slots]() page for further information.
  - Manufactured in the United States.
  - Castellations are allowed, but not officially supported.
  - Non-plated slots wider than 100 mil are not officially supported.
  - Plated slots and smaller slots are possible, but not officially supported. See our [Slots]() page for more.

#### 2 Layer Stackup.

Thickness | Layer           | Tolerance  |
----------|-----------------|------------|
1 mil     | solder resist   | +/-0.2 mil |
1.4 mil   | 1 oz copper     |            |
60 mil    | core            | +/-6 mil   |
1.4 mil   | 1 oz copper     |            |
1 mil     | solder resist   | +/-0.2 mil |

[IS 410 Compatible FR4 (S1141 170) Datasheet](IS-410-compatible-FR4-(S1141-170)-Datasheet.pdf)

#### 2 layer Drill Specs.

  - Minimum 10 mil drills with 5 mil annular rings.
  - Maximum plated hole size is 265 mils.
  - Unplated holes do not have a maximum size.

### 2 Layer Super Swift Service.

Need 2-layer boards in a hurry?

Our Super Swift Service has the same quality you know and love, with an
even faster turn time of 5 business days.

#### Pricing.

$10 per square inch, which includes three copies of your design.

For example, a 2 square inch board would cost $20 and you’d get three
copies of your board.

This includes our Free Shipping option, although expedited shipping
options are available.

#### Turn Times.

Orders are sent to fabrication daily and are guaranteed to ship within 5
business days. 90% of our super swift orders ship within 4 business days.

You can get a quote, approve a design, and pay for an order at OSH Park.

Super Swift Service is not available for Medium Run or Four Layer orders.

As a special bonus, orders placed before 11AM on Monday will ship by
Friday of that week.

Note for international orders: In most cases, it will cost less and
arrive faster if you order on the standard 2 layer service with
expedited shipping.

#### Fabrication Specs.

Quick Specs:

  - 2 Layer PCB.
  - 6 mil minimum trace width.
  - 6 mil minimum trace spacing.
  - 10 mil minimum drill.
  - 5 mil annular ring.
  - PCB thickness of 1.6 mm (.063”).
  - 1 oz copper on both sides (1.4 mil, 35 um).

Detailed Specs:

  - ENIG (gold) finish for superior soldering and environmental resistance.
  - Solder resist and silkscreen on both sides.
  - Minimum 15 mil keepout distance from traces to the board edge.
  - PCB substrate is FR4 (170 Tg).
  - PCB substrate is compatible with a lead-free process.
  - The boards themselves are also lead free and RoHS compliant.
  - PCB Substrate dielectric constant of 4.6 at 1 MHz.
  - Minimum 4 mil soldermask web.
  - Maximum soldermask expansion, retraction, or shift is 3mil.
  - Minimum 100 mil width on internal cutouts. See our [Slots]() page for further information.
  - Manufactured in the United States.
  - Castellations are allowed, but not officially supported.
  - Non-plated slots wider than 100 mil are not officially supported.
  - Plated slots and smaller slots are possible, but not officially supported. See our [Slots]() page for more.

#### 2 Layer Stackup.

Thickness | Layer           | Tolerance  |
----------|-----------------|------------|
1 mil     | solder resist   | +/-0.2 mil |
1.4 mil   | 1 oz copper     |            |
60 mil    | core            | +/-6 mil   |
1.4 mil   | 1 oz copper     |            |
1 mil     | solder resist   | +/-0.2 mil |

[IS 410 Compatible FR4 (S1141 170) Datasheet](IS-410-compatible-FR4-(S1141-170)-Datasheet.pdf)

#### 2 layer Drill Specs.

  - Minimum 10 mil drills with 5 mil annular rings.
  - Maximum plated hole size is 265 mils.
  - Unplated holes do not have a maximum size.

### 2 Layer 2 oz 0.8 mm Service.

A special stackup intended for a variety of high-power and low weight
circuit designs.

This service features a 0.032” (0.8 mm) thick PCB, and includes 2 oz
(2.8 mil, 70 um) copper.

That’s half the thickness of our standard boards, and with twice the
copper !

#### Pricing.

$5 per square inch, which includes three copies of your design.

For example, a 2 square inch board would cost $10 and you’d get three
copies of your board.

You can order as many copies as you want, as long as they’re in
multiples of three.

#### Turn Times.

Orders are sent to fabrication every week, and have a turn time from the
fab of one week.

You can get a quote, approve a design, and pay for an order at OSH Park.

#### Fabrication Specs.

Quick Specs:

  - 2 Layer PCB.
  - 6 mil minimum trace width.
  - 6 mil minimum trace spacing.
  - 10 mil minimum drill.
  - 5 mil annular ring.
  - PCB thickness of 0.8 mm (.032”).
  - 2oz copper on both sides (70um, 2.8 mil).

Detailed Specs:

  - ENIG (gold) finish for superior soldering and environmental resistance.
  - Solder resist and silkscreen on both sides.
  - Minimum 15 mil keepout distance from traces to the board edge.
  - PCB substrate is FR4 (170 Tg).
  - PCB substrate is compatible with a lead-free process.
  - The boards themselves are also lead free and RoHS compliant.
  - PCB Substrate dielectric constant of 4.6 at 1 MHz.
  - Minimum 4 mil soldermask web.
  - Maximum soldermask expansion, retraction, or shift is 3 mil.
  - Minimum 100 mil width on internal cutouts. See our [Slots]() page for further information.
  - Manufactured in the United States.
  - Castellations are allowed, but not officially supported.
  - Non-plated slots wider than 100 mil are not officially supported.
  - Plated slots and smaller slots are possible, but not officially supported. See our [Slots]() page for more.

#### 2 Layer Stackup.

Thickness | Layer         | Tolerance  |
----------|---------------|------------|
1 mil     | solder resist | +/-0.2 mil |
2.8 mil   | 2 oz copper   |            |
30 mil    | FR4 core      | +/-3 mil   |
2.8 mil   | 2 oz copper |              |
1mil      | solder resist | +/-0.2 mil |

[IS 410 Compatible FR4 (S1141 170) Datasheet](IS-410-compatible-FR4-(S1141-170)-Datasheet.pdf)

#### 2 layer Drill Specs.

  - Minimum 10 mil drills with 5 mil annular rings.
  - Maximum plated hole size is 265 mils.
  - Unplated holes do not have a maximum size.

### 2 Layer Medium Run Service.

Moving to a small production run ?

Our medium run service will help bridge the gap between prototypes and a
full panel.

#### Pricing.

$1 per square inch, 100 square inch minimum.

You can have as many different designs as you want, as long as each
design is ordered in a multiple of 10 boards.

For example, if you had two different 5 square inch designs, you could
order 10 of each for a total cost of $100.

100 inches is just the minimum order.

You can order as much as you’d like beyond that.

#### Turn Times.

Fabrication time can vary for medium run orders, but boards will ship in
15 calendar days or fewer.

Medium Run orders cannot be expedited.

For faster fabrications options, you may be interested in our 2 Layer
Service or even faster 2 Layer Super Swift Service.

You can get a quote, approve a design, and pay for an order at OSH Park.

#### Fabrication Specs.

Quick Specs:

  - 2 Layer PCB.
  - 6 mil minimum trace width.
  - 6 mil minimum trace spacing.
  - 10 mil minimum drill.
  - 5 mil annular ring.
  - PCB thickness of 1.6 mm (.063”).
  - 1 oz copper on both sides (1.4 mil, 35 um).

Detailed Specs:

  - ENIG (gold) finish for superior soldering and environmental resistance.
  - Solder resist and silkscreen on both sides.
  - Minimum 15 mil keepout distance from traces to the board edge.
  - PCB substrate is FR4 (170 Tg).
  - PCB substrate is compatible with a lead-free process.
  - The boards themselves are also lead free and RoHS compliant.
  - PCB Substrate dielectric constant of 4.6 at 1 MHz.
  - Minimum 4 mil soldermask web.
  - Maximum soldermask expansion, retraction, or shift is 3 mil.
  - Minimum 100 mil width on internal cutouts. See our [Slots]() page for further information.
  - Manufactured in the United States.
  - Castellations are allowed, but not officially supported.
  - Non-plated slots wider than 100 mil are not officially supported.
  - Plated slots and smaller slots are possible, but not officially supported. See our [Slots]() page for more.

Thickness | Layer         | Tolerance  |
----------|---------------|------------|
1 mil     | solder resist | +/-0.2 mil |
1.4 mil   | 1 oz copper   |            |
60 mil    | FR4 core      | +/-6 mil   |
1.4 mil   | 1 oz copper |              |
1mil      | solder resist | +/-0.2 mil |

[IS 410 Compatible FR4 (S1141 170) Datasheet](IS-410-compatible-FR4-(S1141-170)-Datasheet.pdf)

#### 2 layer Drill Specs.

  - Minimum 10 mil drills with 5 mil annular rings.
  - Maximum plated hole size is 265 mils.
  - Unplated holes do not have a maximum size.

### 1 Layer Prototype Service.

While we cannot fabricate true single-layer boards, we support single
layer designs on our 2 layer fabrication service.

The cost, stackup, specs, and turn time are identical to that of the 2
layer service.

#### Ordering.

Our automated upload service expects all files to contain gerber data
for a 2 layer design.

This often results in errors when trying to place an order.

In many cases, this issue can be resolved by configuring the design tool
to output data for a 2 layer design.

If only the manufacturing files are available, this usually requires a
few files to be copied and modified.

Our Uploading 1 layer boards page has a guide on doing this.

#### Pricing.

$5 per square inch, which includes three copies of your design.

For example, a 2 square inch board would cost $10 and you’d get three
copies of your board.

You can order as many copies as you want, as long as they’re in
multiples of three.

#### Turn Times.

Orders are sent to fabrication daily, and will ship within 10-12 days.

You can get a quote, approve a design, and pay for an order at OSH Park.

For a faster turn time, you may be interested in our Super Swift Service.

Need more than 100 square inches of boards ?

Our 2 Layer Medium Run Service is a less expensive option for larger
orders.

#### Fabrication Specs.

Quick Specs:

  - 2 Layer PCB.
  - 6 mil minimum trace width.
  - 6 mil minimum trace spacing.
  - 10 mil minimum drill.
  - 5 mil annular ring.
  - PCB thickness of 1.6 mm (.063”).
  - 1 oz copper on both sides (1.4 mil, 35 um).

Detailed Specs:

  - ENIG (gold) finish for superior soldering and environmental resistance.
  - Solder resist and silkscreen on both sides.
  - Minimum 15 mil keepout distance from traces to the board edge.
  - PCB substrate is FR4 (170 Tg).
  - PCB substrate is compatible with a lead-free process.
  - The boards themselves are also lead free and RoHS compliant.
  - PCB Substrate dielectric constant of 4.6 at 1 MHz.
  - Minimum 4 mil soldermask web.
  - Maximum soldermask expansion, retraction, or shift is 3mil.
  - Minimum 100 mil width on internal cutouts. See our [Slots]() page for further information.
  - Manufactured in the United States.
  - Castellations are allowed, but not officially supported.
  - Non-plated slots wider than 100 mil are not officially supported.
  - Plated slots and smaller slots are possible, but not officially supported. See our [Slots]() page for more.

#### 2 Layer Stackup.

Thickness | Layer         | Tolerance  |
----------|---------------|------------|
1 mil     | solder resist | +/-0.2 mil |
1.4 mil   | 1 oz copper   |            |
60 mil    | FR4 core      | +/-6 mil   |
1.4 mil   | 1 oz copper |              |
1mil      | solder resist | +/-0.2 mil |

[IS 410 Compatible FR4 (S1141 170) Datasheet](IS-410-compatible-FR4-(S1141-170)-Datasheet.pdf)

#### 2 layer Drill Specs.

  - Minimum 10 mil drills with 5 mil annular rings.
  - Maximum plated hole size is 265 mils.
  - Unplated holes do not have a maximum size.

## Four Layer Boards.

All 4 layer boards ship with FR408 substrate, purple mask over bare
copper, and ENIG (immersion gold) finish.

Minimum design rules are 5 mil trace clearance, 5 mil trace width,
10 mil drill size, and 4 mil annular ring.

We do not support blind or buried vias.

Service    | Cost                                          | Time to Ship       | Board Thickness | Copper Weight            |
-----------|-----------------------------------------------|--------------------|-----------------|--------------------------|
Prototype  | $10 per square inch for a set of three boards | 9-21 Calendar Days | 63 mil (1.6 mm) | 1 oz outer, 1/2 oz inner |
medium run | $2 per square inch. 150 sq inch minimum.      | 2-4 Weeks          | 63 mil (1.6 mm) | 1 oz outer, 1/2 oz inner |

### 4 Layer Prototype Service.

#### Pricing.

$10 per square inch, which includes three copies of your design.

For example, a 2 square inch board would cost $20 and you’d get three copies of your board.

You can order as many copies as you want, as long as they’re in multiples of three.

#### Turn Times.

Orders are sent to fabrication every other day, and have a turn time from the fab of one week.

95% of our 4 layer orders ship within 12 days.

You can get a quote, approve a design, and pay for an order at OSH Park.

We do not offer Super Swift Service for 4 layer boards.

Need more than 150 square inches of boards ?

Our 4 Layer Medium Run Service is a less expensive option for larger orders.

#### Fabrication Specs.

Quick Specs:

  - 4 Layer PCB.
  - 5 mil minimum trace width.
  - 5 mil minimum trace spacing.
  - 10 mil minimum drill.
  - 4 mil annular ring.
  - PCB thickness of 1.6 mm (.063”).
  - 1 oz copper on both sides (1.4 mil, 35 um).
  - 0.5oz copper on internal layers (0.7 mil, 17.5 um).

Detailed Specs:

  - ENIG (gold) finish for superior soldering and environmental resistance.
  - Solder resist and silkscreen on both sides.
  - Minimum 15 mil keepout distance from traces to the board edge.
  - PCB substrate is FR408 (180Tg).
  - PCB substrate is compatible with a lead-free process.
  - The boards themselves are also lead free and RoHS compliant.
  - PCB Substrate dielectric constant of 3.66 at 1GHz.
  - Minimum 4 mil soldermask web.
  - Maximum soldermask expansion is 2.5 mil.
  - Minimum 100 mil width on internal cutouts. See our [Slots]() page for further information.
  - Manufactured in the United States.
  - Castellations are allowed, but not officially supported.
  - We do not support blind or buried vias.
  - Non-plated slots wider than 100 mil are allowed, but not officially supported.
  - Plated slots and smaller slots are possible, but not officially supported. See our [Slots] page for more.

#### 4 Layer Stackup.

The current 4 layer board stackup is as follows:

Thickness | Layer         | Tolerance   |
----------|---------------|-------------|
1 mil     | solder resist | +/-0.2 mil  |
1.4 mil   | 1 oz copper   |             |
6.7 mil   | FR408 prepreg | +/-0.67 mil |
0.7 mil	  | 0.5 oz copper |             |
47 mil    | FR408 core    | +/-4.7 mil  |
0.7 mil   | 0.5 oz copper |             |
6.7 mil   | FR408 prepreg | +/-0.67 mil |
1.4 mil   | 1 oz copper   |             |
1 mil     | solder resist | +/-0.2 mil  |

The substrate for both the core and prepreg is FR408, with a dielectric
constant of 3.66 at 1 GHz, and is compatible with a lead free process.

The boards themselves are also lead free and RoHS compliant.

[FR408 High Performance Laminate and Prepreg Data Sheet](FR408-High-Performance-Laminate-and-Prepreg-Data-Sheet.pdf)

#### Layer Naming.

When sent to fabrication, the layers are manufactured in the following
order according to their file extension.

We advise following this naming scheme if your design is sensitive to
distance of the inner planes in order to avoid any confusion.

Layer   | Suggested File Extension | Description          |
--------|--------------------------|----------------------|
Layer 1 | .GTL                     | Top or Front layer   |
Layer 2 | .G2L                     | Internal Plane       |
Layer 3 | .G3L                     | Internal Plane       |
Layer 4 | .GBL                     | Bottom or Back layer |

#### Internal Plane Polarity.

When submitting gerbers, we need the “positive” internal planes, meaning
that lines represent copper, not the absence of copper.

Some CAD tools will generate the internal planes as power planes with
“negative” polarity so the lines indicate where copper should be removed.

To work around this, declare the internal planes as signal layers and
use a copper pour to define the power plane.

Take a look at our Positive and Negative Gerbers page for more
information.

#### 4 Layer Drill Specs.

Spec                         | Size    |
-----------------------------|---------|
Minimum annular ring         |   4 mil |
Minimum hole size            |  10 mil |
Maximum plated hole size     | 260 mil |
Maximum non-plated hole size | none    |
Via plating thickness        |   1 mil |
Blind Vias                   | No      |
Buried Vias                  | No      |

### 4 Layer Medium Run Service.

Moving to a small production run ?

Our medium run service will help bridge the gap between prototypes and a
full panel.

#### Pricing.

$2 per square inch, 150 square inch minimum.

You can have as many different designs as you want, as long as each
design is ordered in a multiple of 3 boards.

For example, if you two 25 square inch designs, you could order 3 of
each for a total cost of $300.

150 square inches is just the minimum order.

You can order as much as you’d like beyond that.

#### Turn Times.

Fabrication time can vary for medium run orders.

Boards typically ship within 14 calendar days but may take up 4 weeks.

To make an order, please contact support@oshpark.com.

We do not offer Super Swift Service for 4 layer boards.

For faster options, you may be interested in our Standard 4 Layer
Service.

#### Fabrication Specs.

Quick Specs:

  - 4 Layer PCB.
  - 5 mil minimum trace width.
  - 5 mil minimum trace spacing.
  - 10 mil minimum drill.
  - 4 mil annular ring.
  - PCB thickness of 1.6 mm (.063”).
  - 1 oz copper on both sides (1.4 mil, 35 um).
  - 0.5 oz copper on internal layers (0.7 mil, 17.5 um).

Detailed Specs:

  - ENIG (gold) finish for superior soldering and environmental resistance.
  - Solder resist and silkscreen on both sides.
  - Minimum 15 mil keepout distance from traces to the board edge.
  - PCB substrate is FR408 (180Tg).
  - PCB substrate is compatible with a lead-free process.
  - The boards themselves are also lead free and RoHS compliant.
  - PCB Substrate dielectric constant of 3.66 at 1GHz.
  - Minimum 4 mil soldermask web.
  - Maximum soldermask expansion is 2.5 mil.
  - Minimum 100 mil width on internal cutouts. See our [Slots]() page for further information.
  - Manufactured in the United States.
  - Castellations are allowed, but not officially supported.
  - We do not support blind or buried vias.
  - Non-plated slots wider than 100 mil are allowed, but not officially supported.
  - Plated slots and smaller slots are possible, but not officially supported. See our [Slots]() page for more.

#### 4 Layer Stackup.

The current 4 layer board stackup is as follows:

Thickness | Layer         | Tolerance   |
----------|---------------|-------------|
1 mil     | solder resist | +/-0.2 mil  |
1.4 mil   | 1 oz copper   |             |
6.7 mil   | FR408 prepreg | +/-0.67 mil |
0.7 mil	  | 0.5 oz copper |             |
47 mil    | FR408 core    | +/-4.7 mil  |
0.7 mil   | 0.5 oz copper |             |
6.7 mil   | FR408 prepreg | +/-0.67 mil |
1.4 mil   | 1 oz copper   |             |
1 mil     | solder resist | +/-0.2 mil  |

The substrate for both the core and prepreg is FR408, with a dielectric
constant of 3.66 at 1 GHz, and is compatible with a lead free process.

The boards themselves are also lead free and RoHS compliant.

[FR408 High Performance Laminate and Prepreg Data Sheet](FR408-High-Performance-Laminate-and-Prepreg-Data-Sheet.pdf)

#### Layer Naming.

When sent to fabrication, the layers are manufactured in the following
order according to their file extension.

We advise following this naming scheme if your design is sensitive to
distance of the inner planes in order to avoid any confusion.

Layer   | Suggested File Extension | Description          |
--------|--------------------------|----------------------|
Layer 1 | .GTL                     | Top or Front layer   |
Layer 2 | .G2L                     | Internal Plane       |
Layer 3 | .G3L                     | Internal Plane       |
Layer 4 | .GBL                     | Bottom or Back layer |

#### Internal Plane Polarity.

When submitting gerbers, we need the “positive” internal planes, meaning
that lines represent copper, not the absence of copper.

Some CAD tools will generate the internal planes as power planes with
“negative” polarity so the lines indicate where copper should be removed.

To work around this, declare the internal planes as signal layers and
use a copper pour to define the power plane.

Take a look at our Positive and Negative Gerbers page for more
information.

#### 4 Layer Drill Specs.

Spec                         | Size    |
-----------------------------|---------|
Minimum annular ring         |   4 mil |
Minimum hole size            |  10 mil |
Maximum plated hole size     | 260 mil |
Maximum non-plated hole size | none    |
Via plating thickness        |   1 mil |
Blind Vias                   | No      |
Buried Vias                  | No      |
