lambert/26/docs/26_OCTAVE_FILTER-schematics.pdf

| OCTAVE_FILTER TITLE Front Page
gschem/26.000.00.00.01.sch FILE: 01 01 PAGE OF | 20240609 REVISION: Bert Timmerman DRAWN BY: | A3

# This hardware is released under Creative Commons Share-alike 4.0 International

(http://creativecommons.org/licenses/by-sa/4.0/).

# Note: This is a human-readable summary of (and not a substitute for) the

license (http://creativecommons.org/licenses/by-sa/4.0/legalcode).

# You are free to:

# Share — copy and redistribute the material in any medium or format

# Adapt — remix, transform, and build upon the material

for any purpose, even commercially.

# The licensor cannot revoke these freedoms as long as you follow the license

terms.

# Under the following terms:

# Attribution — You must give appropriate credit, provide a link to the license, and indicate if changes were made. You may do so in any reasonable manner, but

not in any way that suggests the licensor endorses you or your use.

# ShareAlike — If you remix, transform, or build upon the material, you must

distribute your contributions under the same license as the original.

# No additional restrictions — You may not apply legal terms or technological

measures that legally restrict others from doing anything the license permits.

# Notices:

# You do not have to comply with the license for elements of the material in the public domain or where your use is permitted by an applicable exception or

limitation.

# No warranties are given. The license may not give you all of the permissions

necessary for your intended use. For example, other rights such as publicity, privacy, or moral rights may limit how you use the material.

DOC.NR. | | DESCRIPTION STATUS
26.000.00.01.01 | FINAL | Overall - Block diagram
26.000.00.01.02 | FINAL | Overall - Schematic
26.000.00.01.03 | FINAL | 31.5 Hz & 63 Hz module - Schematic
26.000.00.01.04 | FINAL | 125 Hz & 250 Hz module - Schematic
26.000.00.01.05 | FINAL | 500 Hz & 1 kHz module - Schematic
26.000.00.01.06 | FINAL | 2 kHz & 4 kHz module - Schematic
26.000.00.01.07 | FINAL | 8 kHz & 16 kHz module - Schematic
26.001.00.01.01 | FINAL | Front panel - Schematic (DFM)
26.002.00.01.01 | FINAL | Front pcb - Schematic (DFM)
26.003.00.01.01 | FINAL | Main pcb - Schematic (DFM)
26.003.01.01.01 | TBD | Main pcb (PTH + SMT) - Schematic (DFM)
26.004.00.01.01 | FINAL | Shielding pcb - Schematic (DFM)
26.005.00.01.01 | FINAL | Strut pcb - Schematic (DFM)
26.006.00.01.01 | VOID | 31.5 Hz & 63 Hz module (PTH) - Schematic (DFM)
26.006.01.01.01 | VOID | 31.5 Hz & 63 Hz module (PTH+SMT) - Schematic (DFM)
26.006.02.01.01 | FINAL | 31.5 Hz & 63 Hz module (PTH+SMT) - Schematic (DFM)
26.007.01.01.01 | FINAL | 125 Hz & 250 Hz module (PTH+SMT) - Schematic (DFM)
26.008.01.01.01 | FINAL | 500 Hz & 1 kHz module (PTH+SMT) - Schematic (DFM)
26.009.01.01.01 | TBD | 2 kHz & 4 kHz module (PTH+SMT) - Schematic (DFM)
26.010.01.01.01 | TBD | 8 kHz & 16 kHz module (PTH+SMT) - Schematic (DFM)
26.999.00.01.01 | VOID | CA3140M breakout pcb (PTH+SMT) - Schematic (DFM)
26.999.01.01.01 | FINAL | CA3140M breakout pcb (PTH+SMT) - Schematic (DFM)

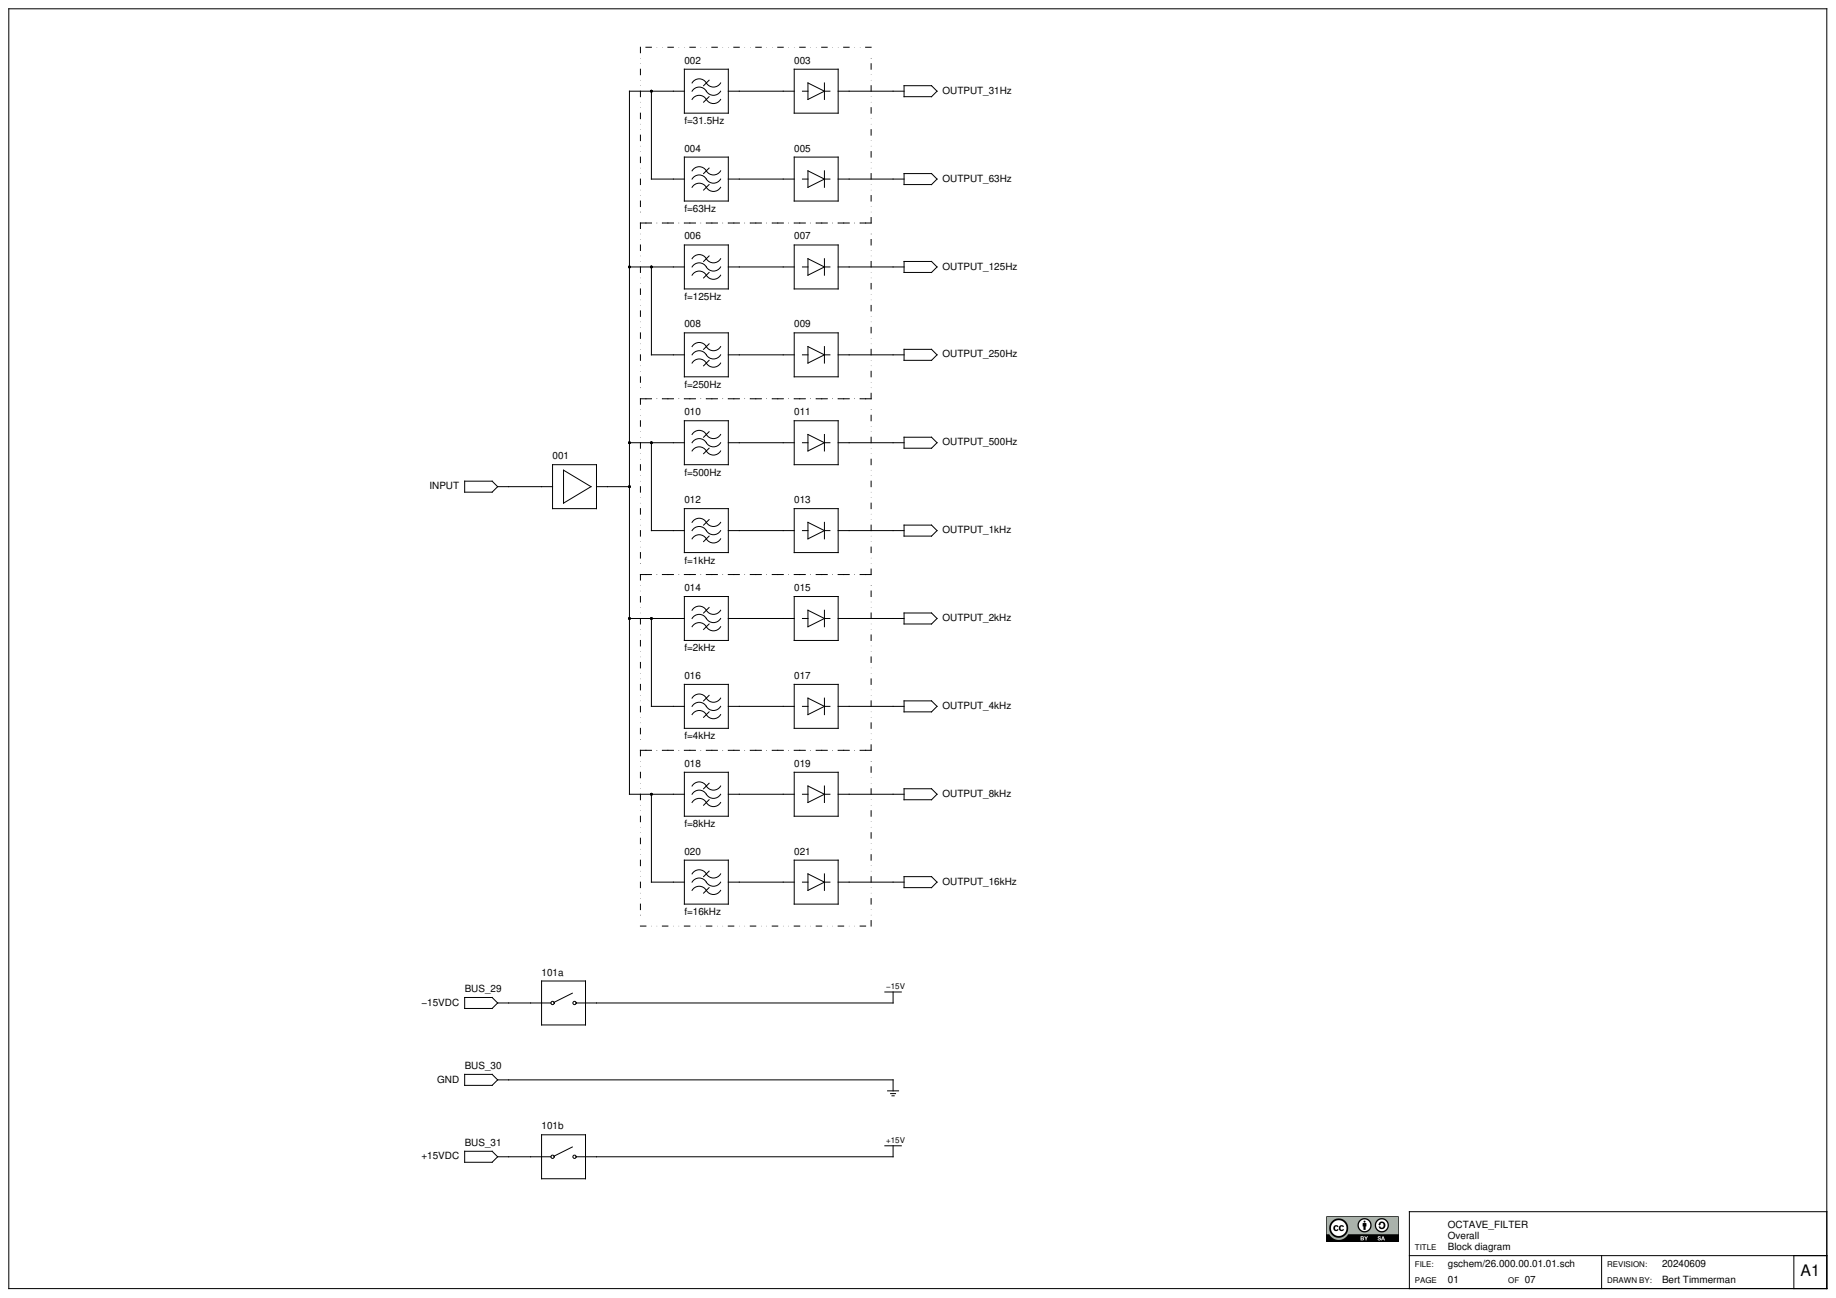
[picture p348: page 2]
07 gschem/26.000.00.01.01.sch; Block diagram; Bert Timmerman

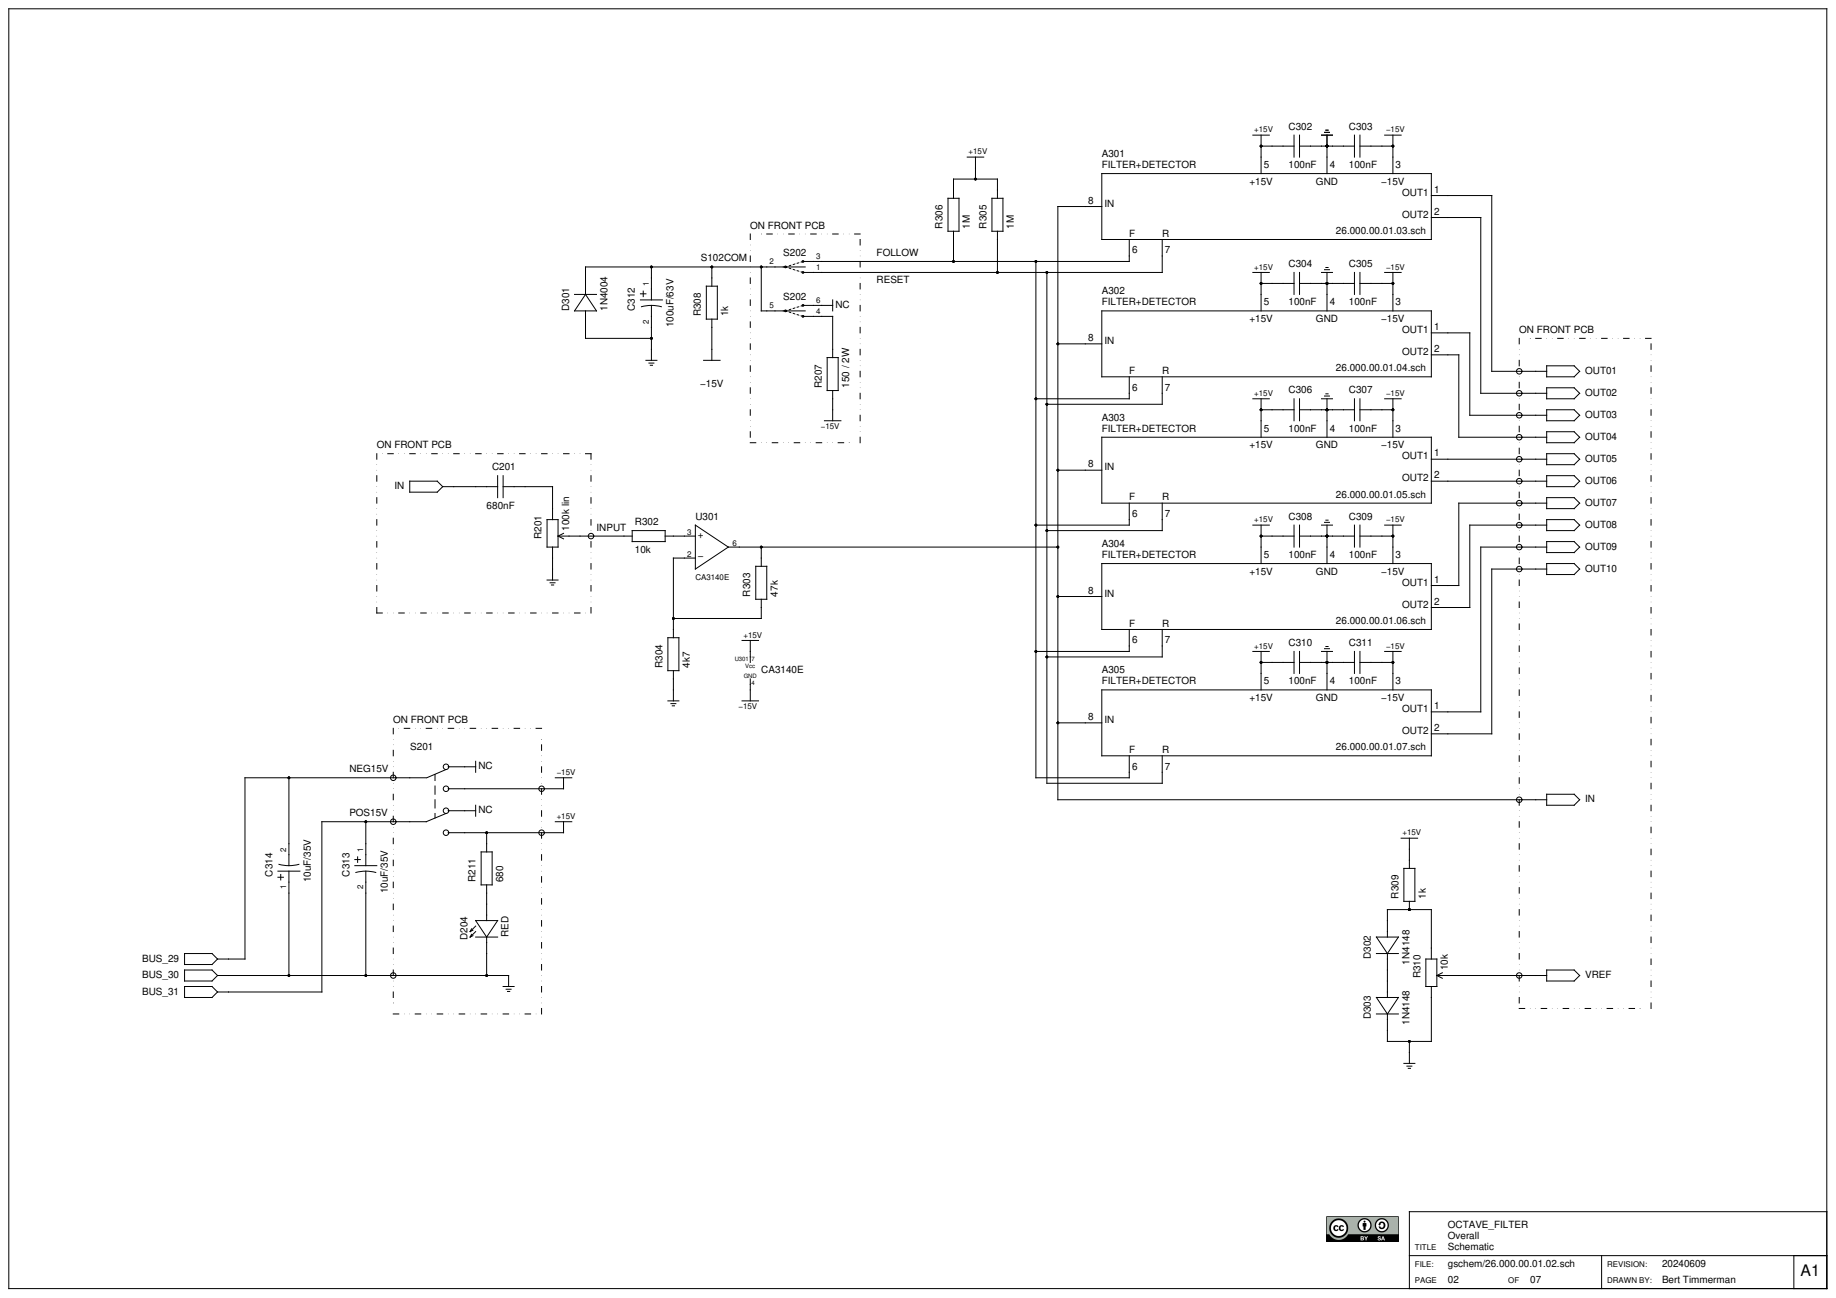
[picture p349: page 3]

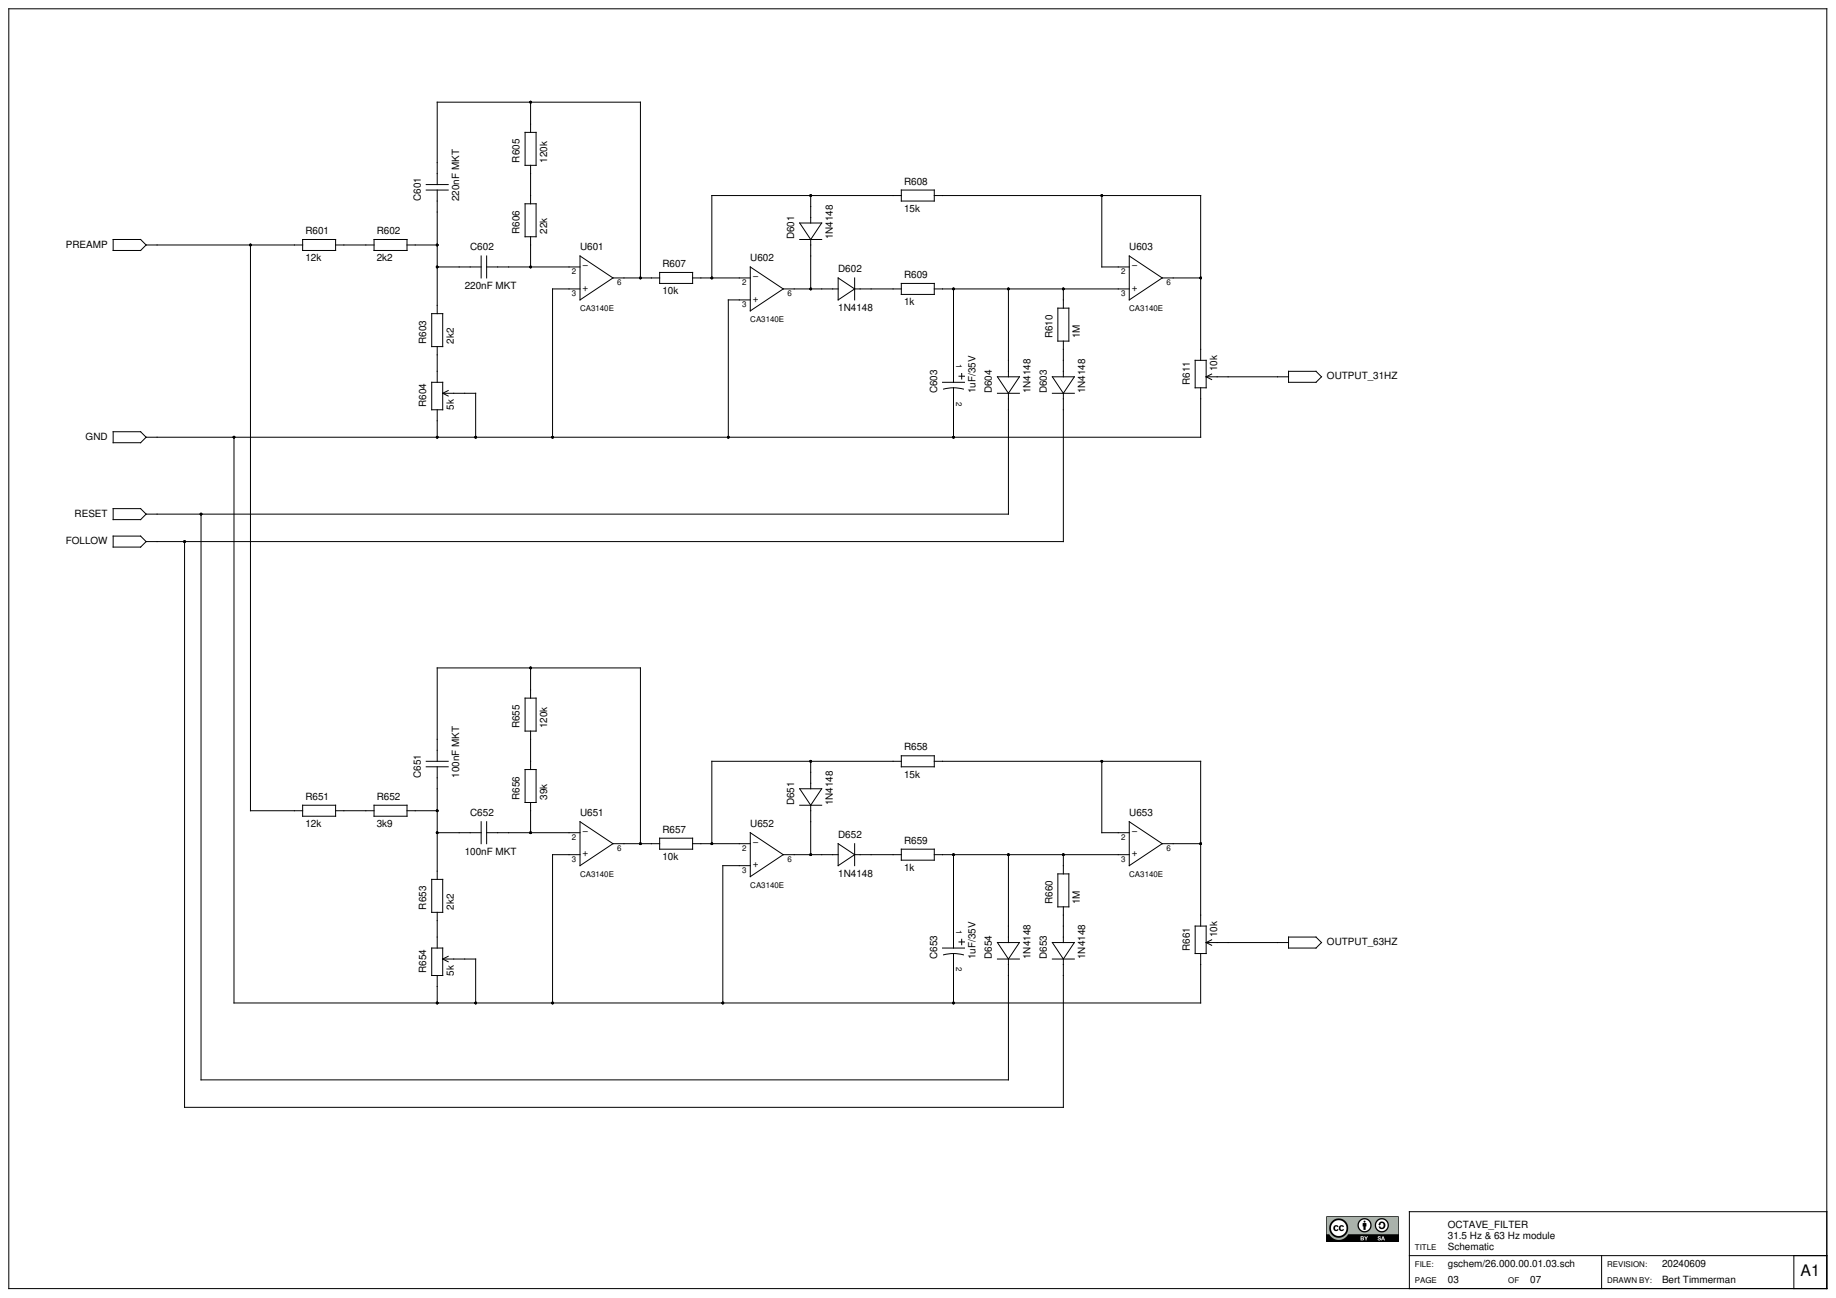
[picture p350: page 4]

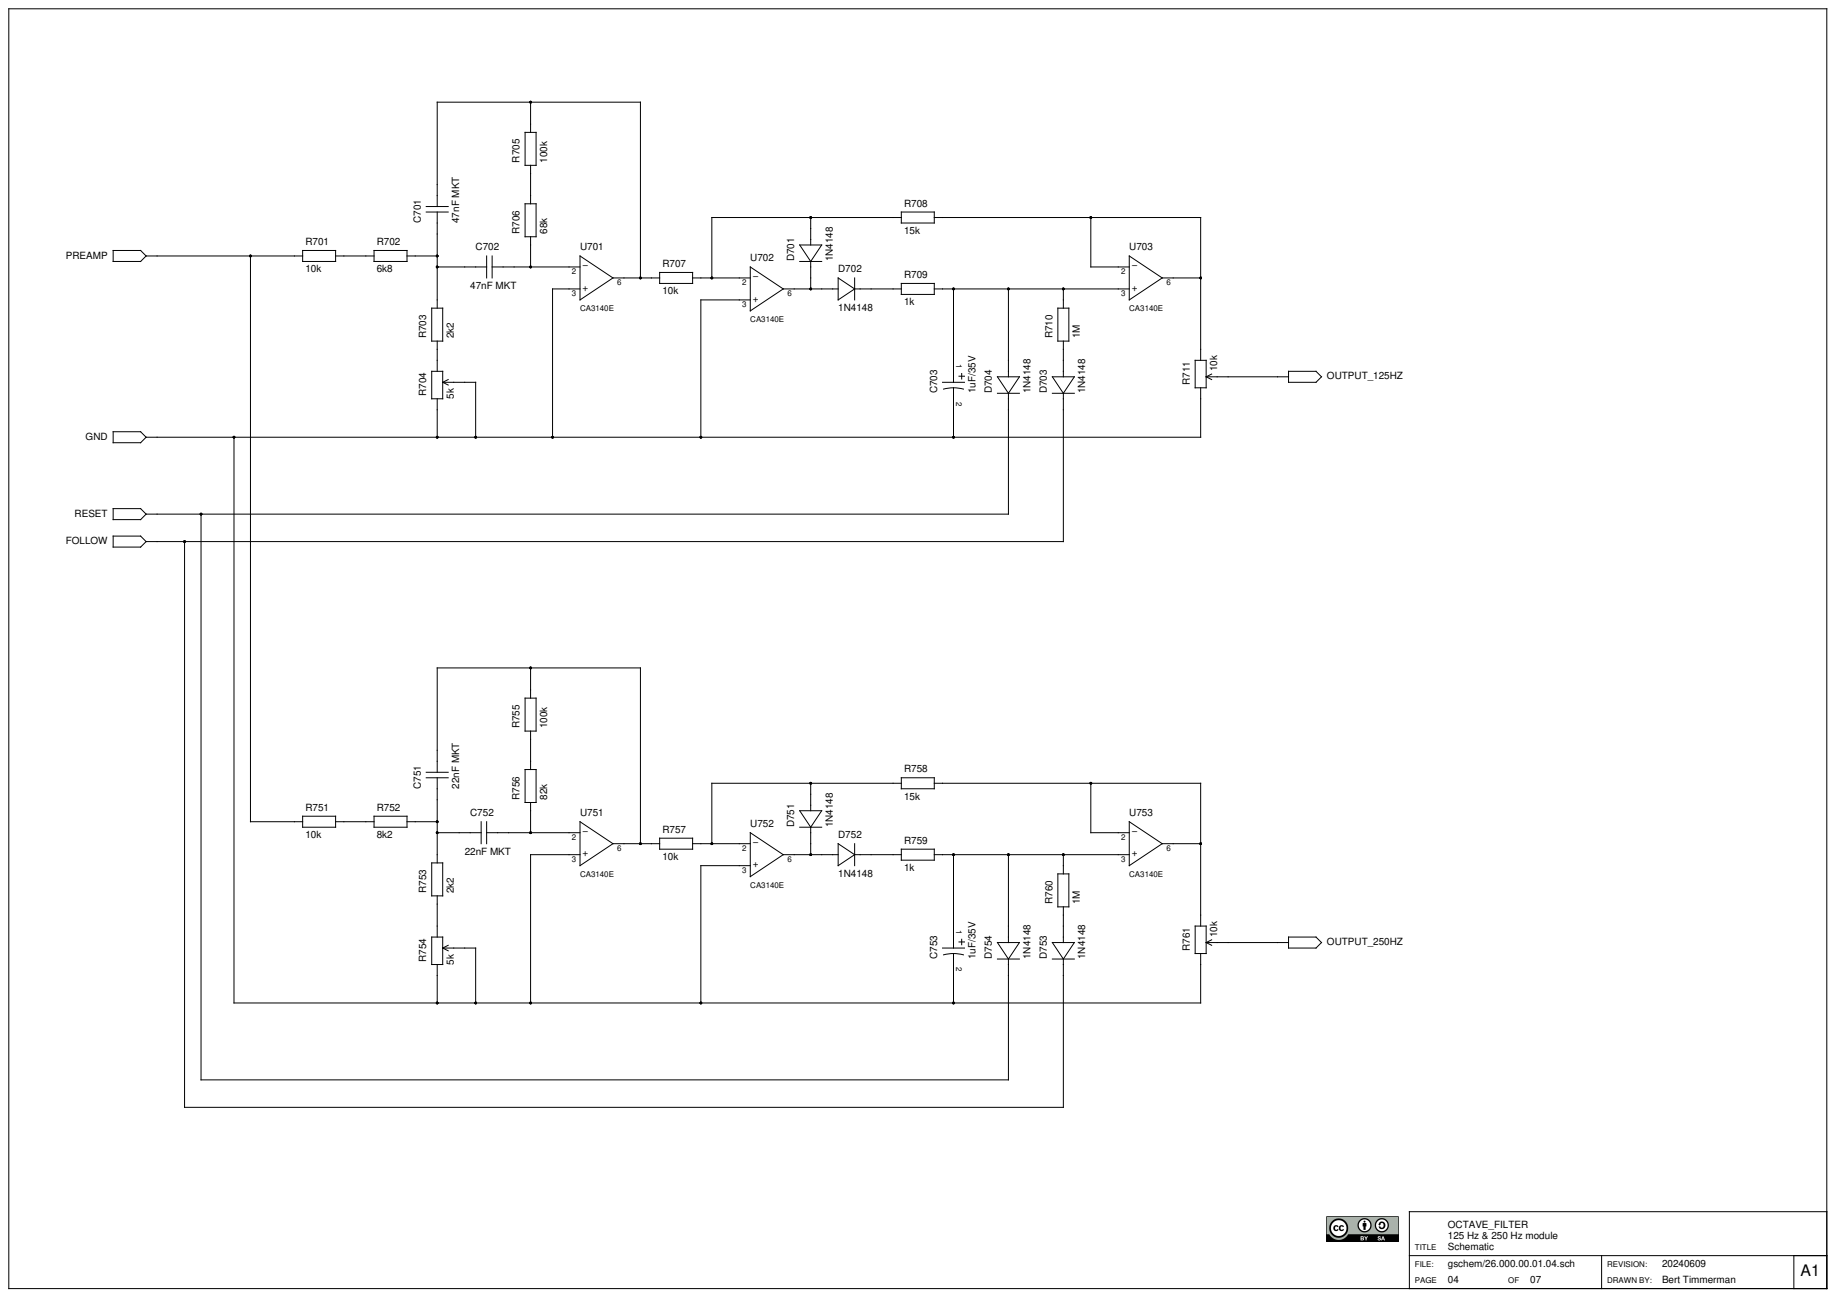
[picture p351: page 5]

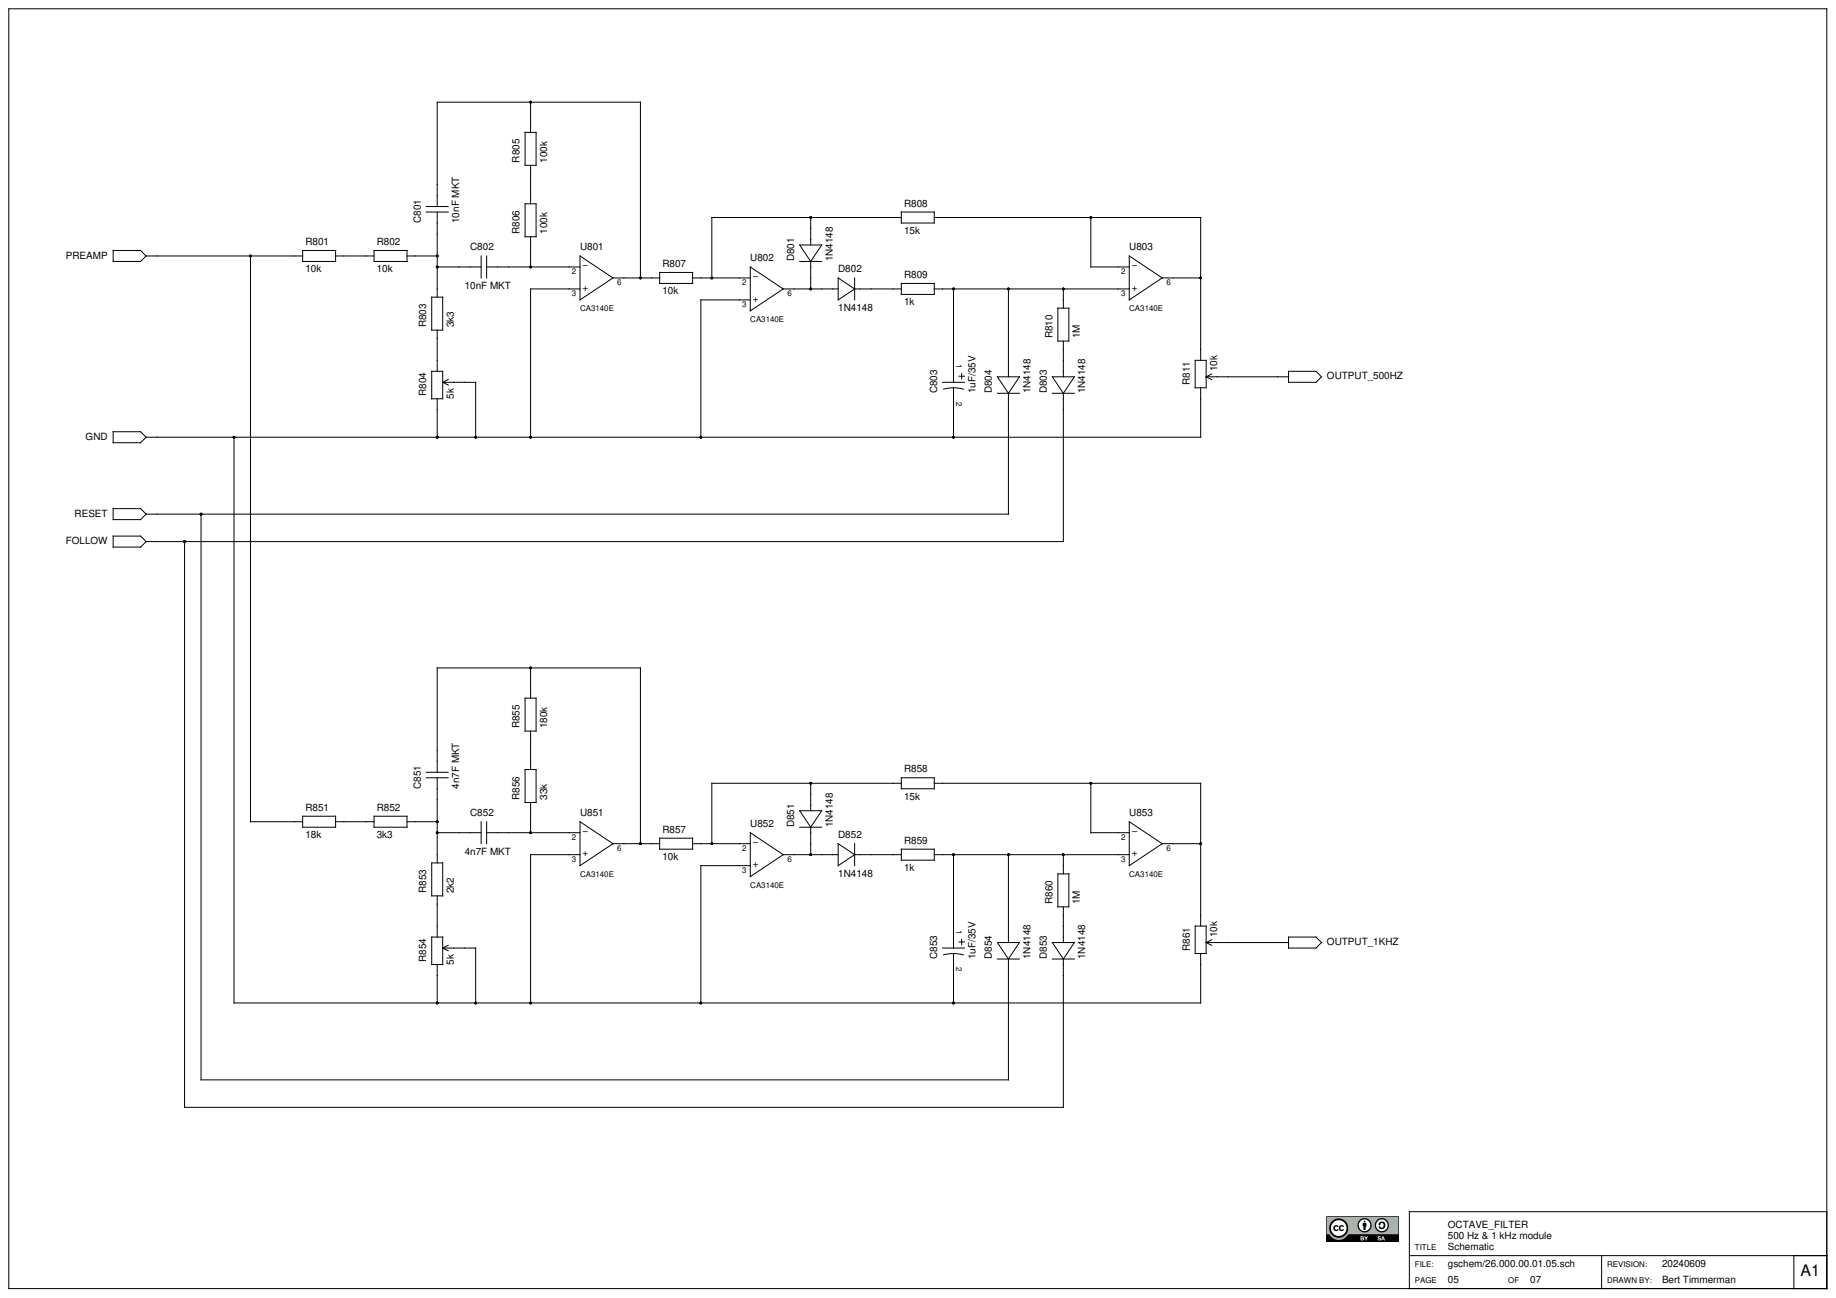
[picture p352: page 6]

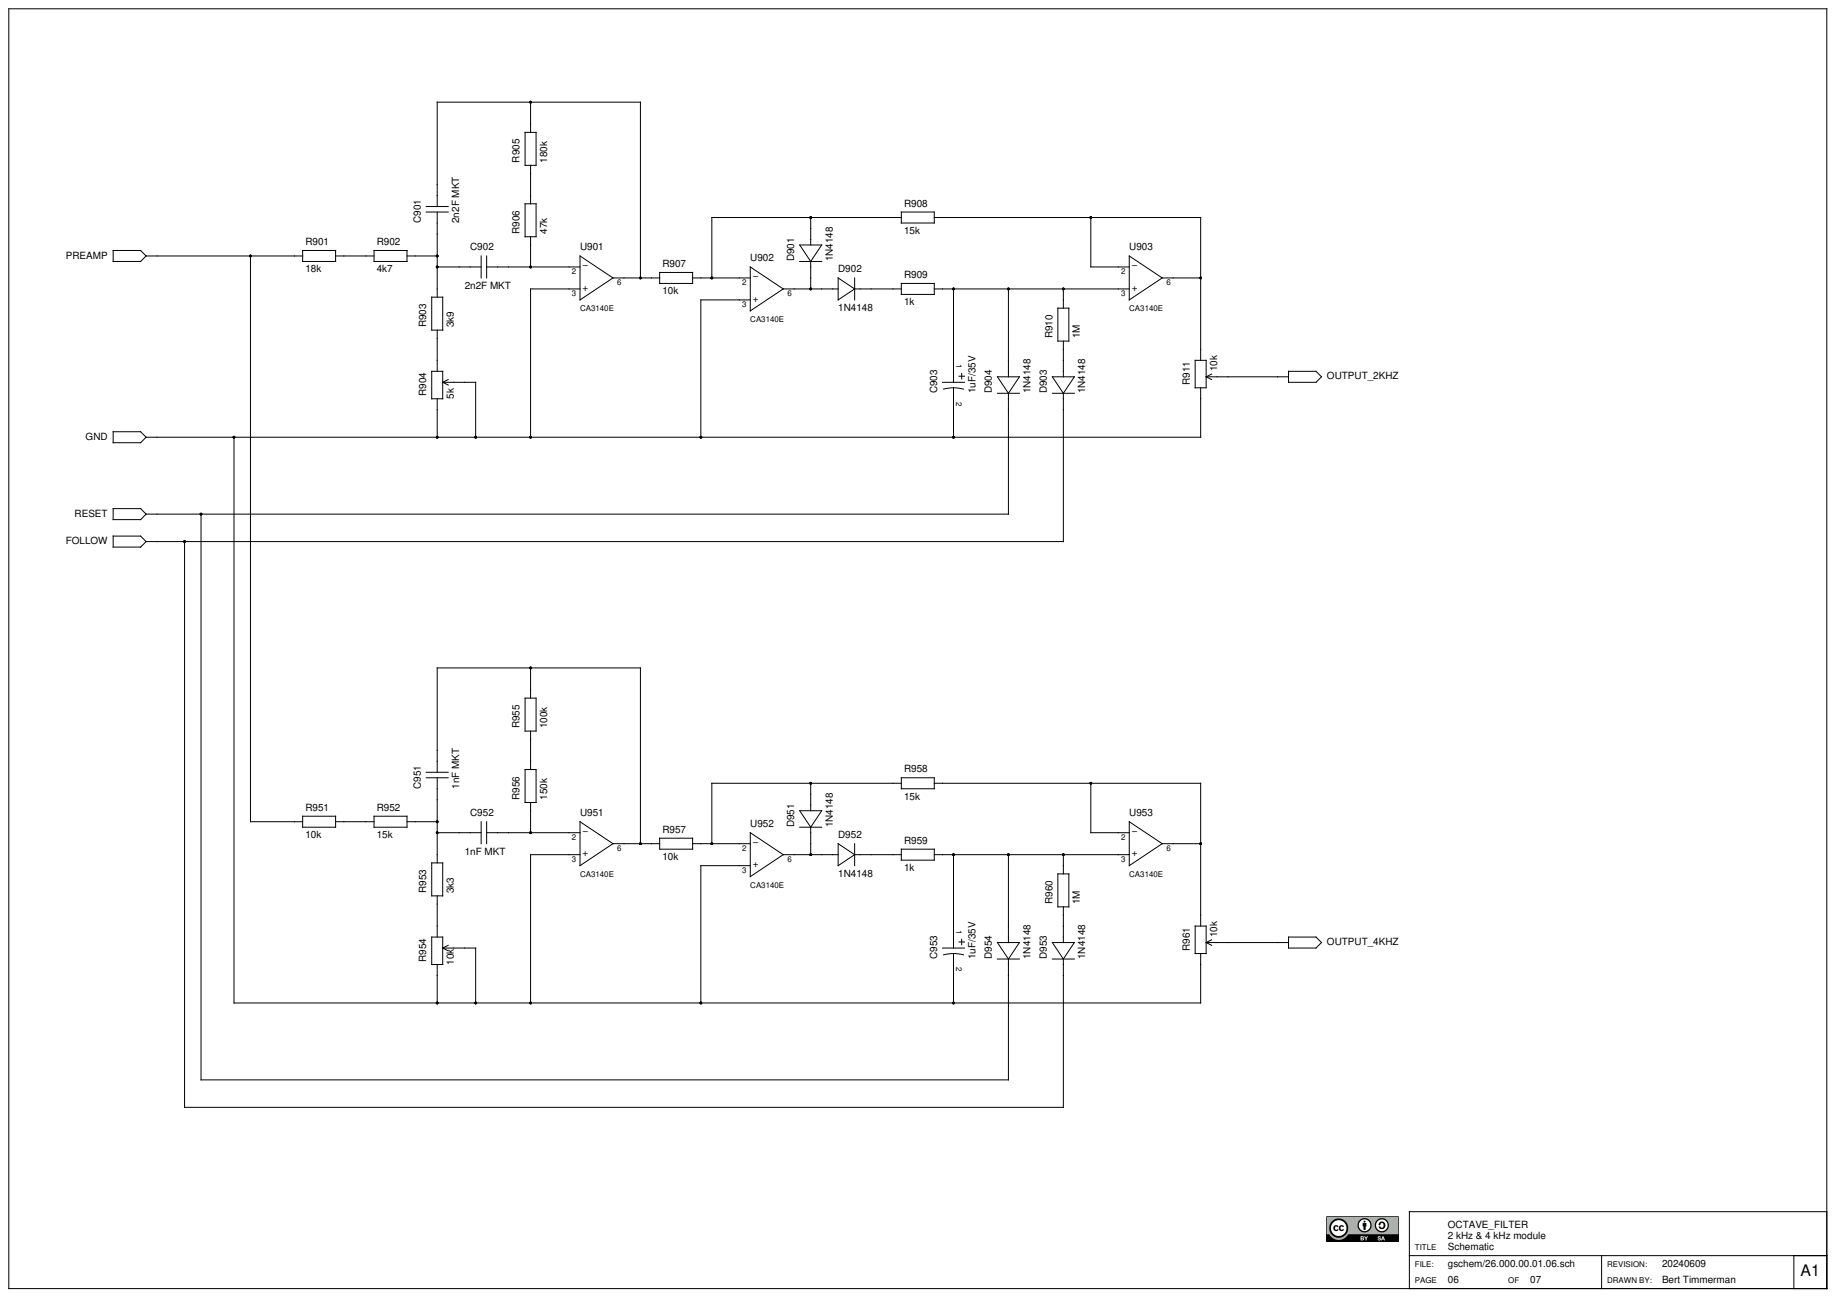
[picture p353: page 7]

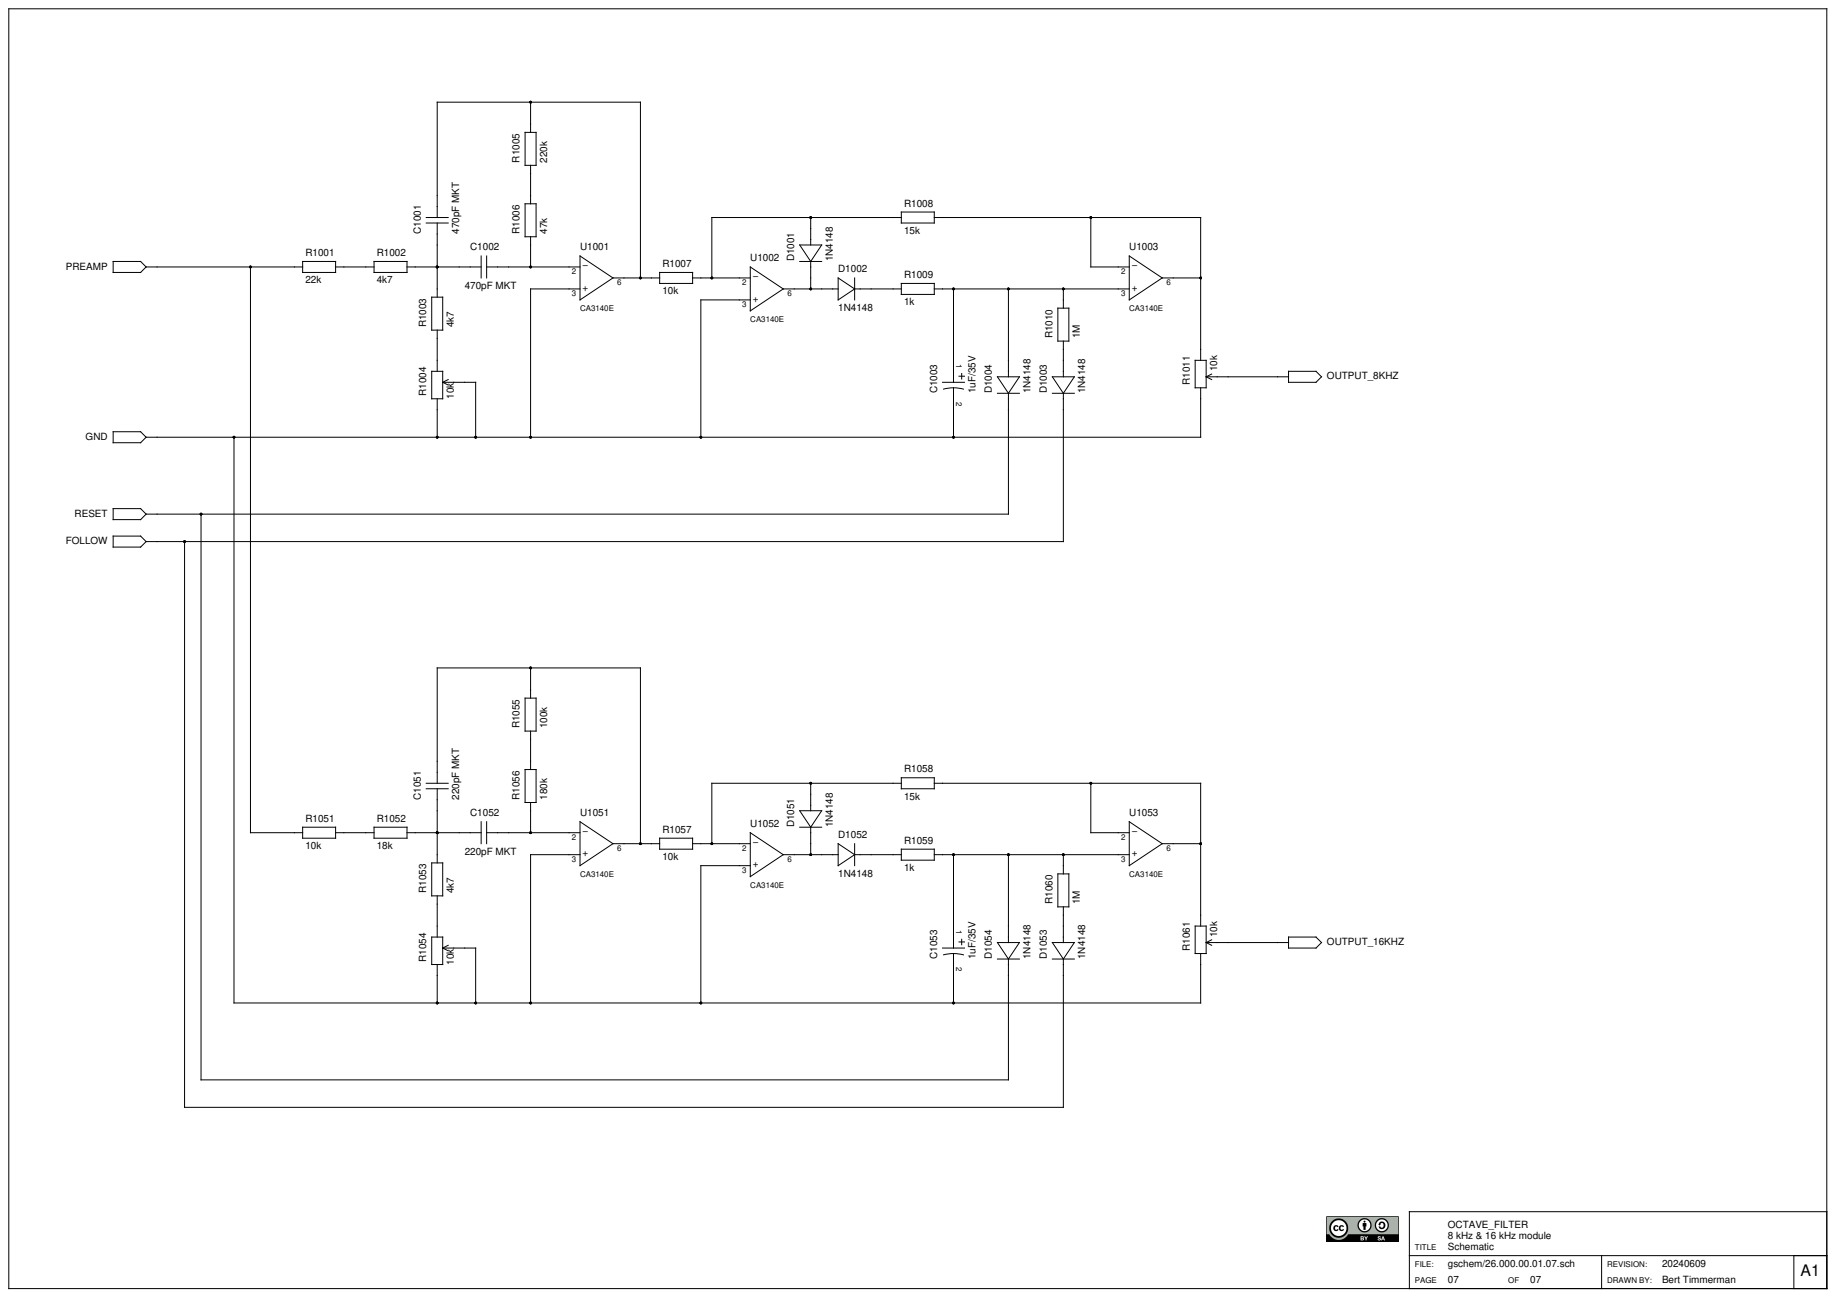
[picture p354: page 8]

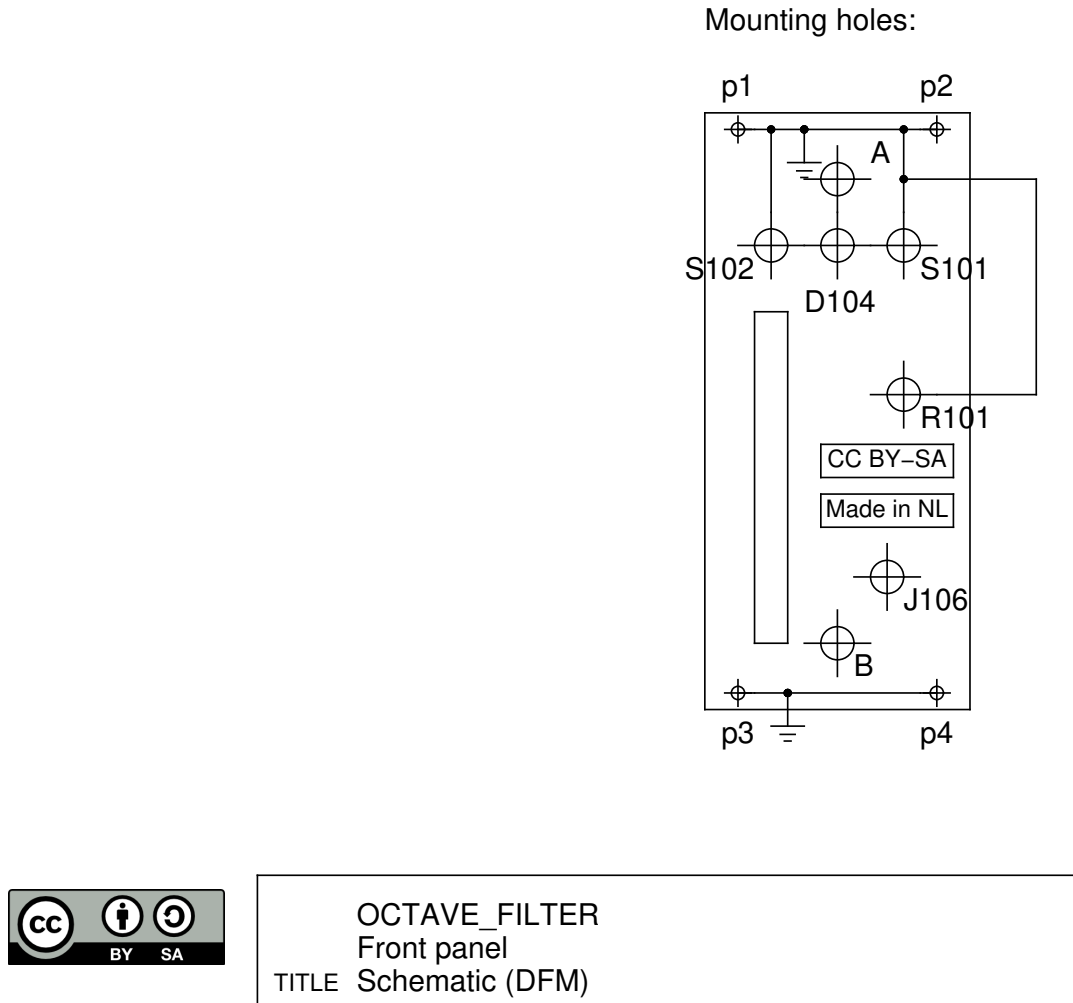
[picture p355: page 9]
Bert Timmerman; Schematic (DFM); Front panel; Mounting holes:

Made in NL

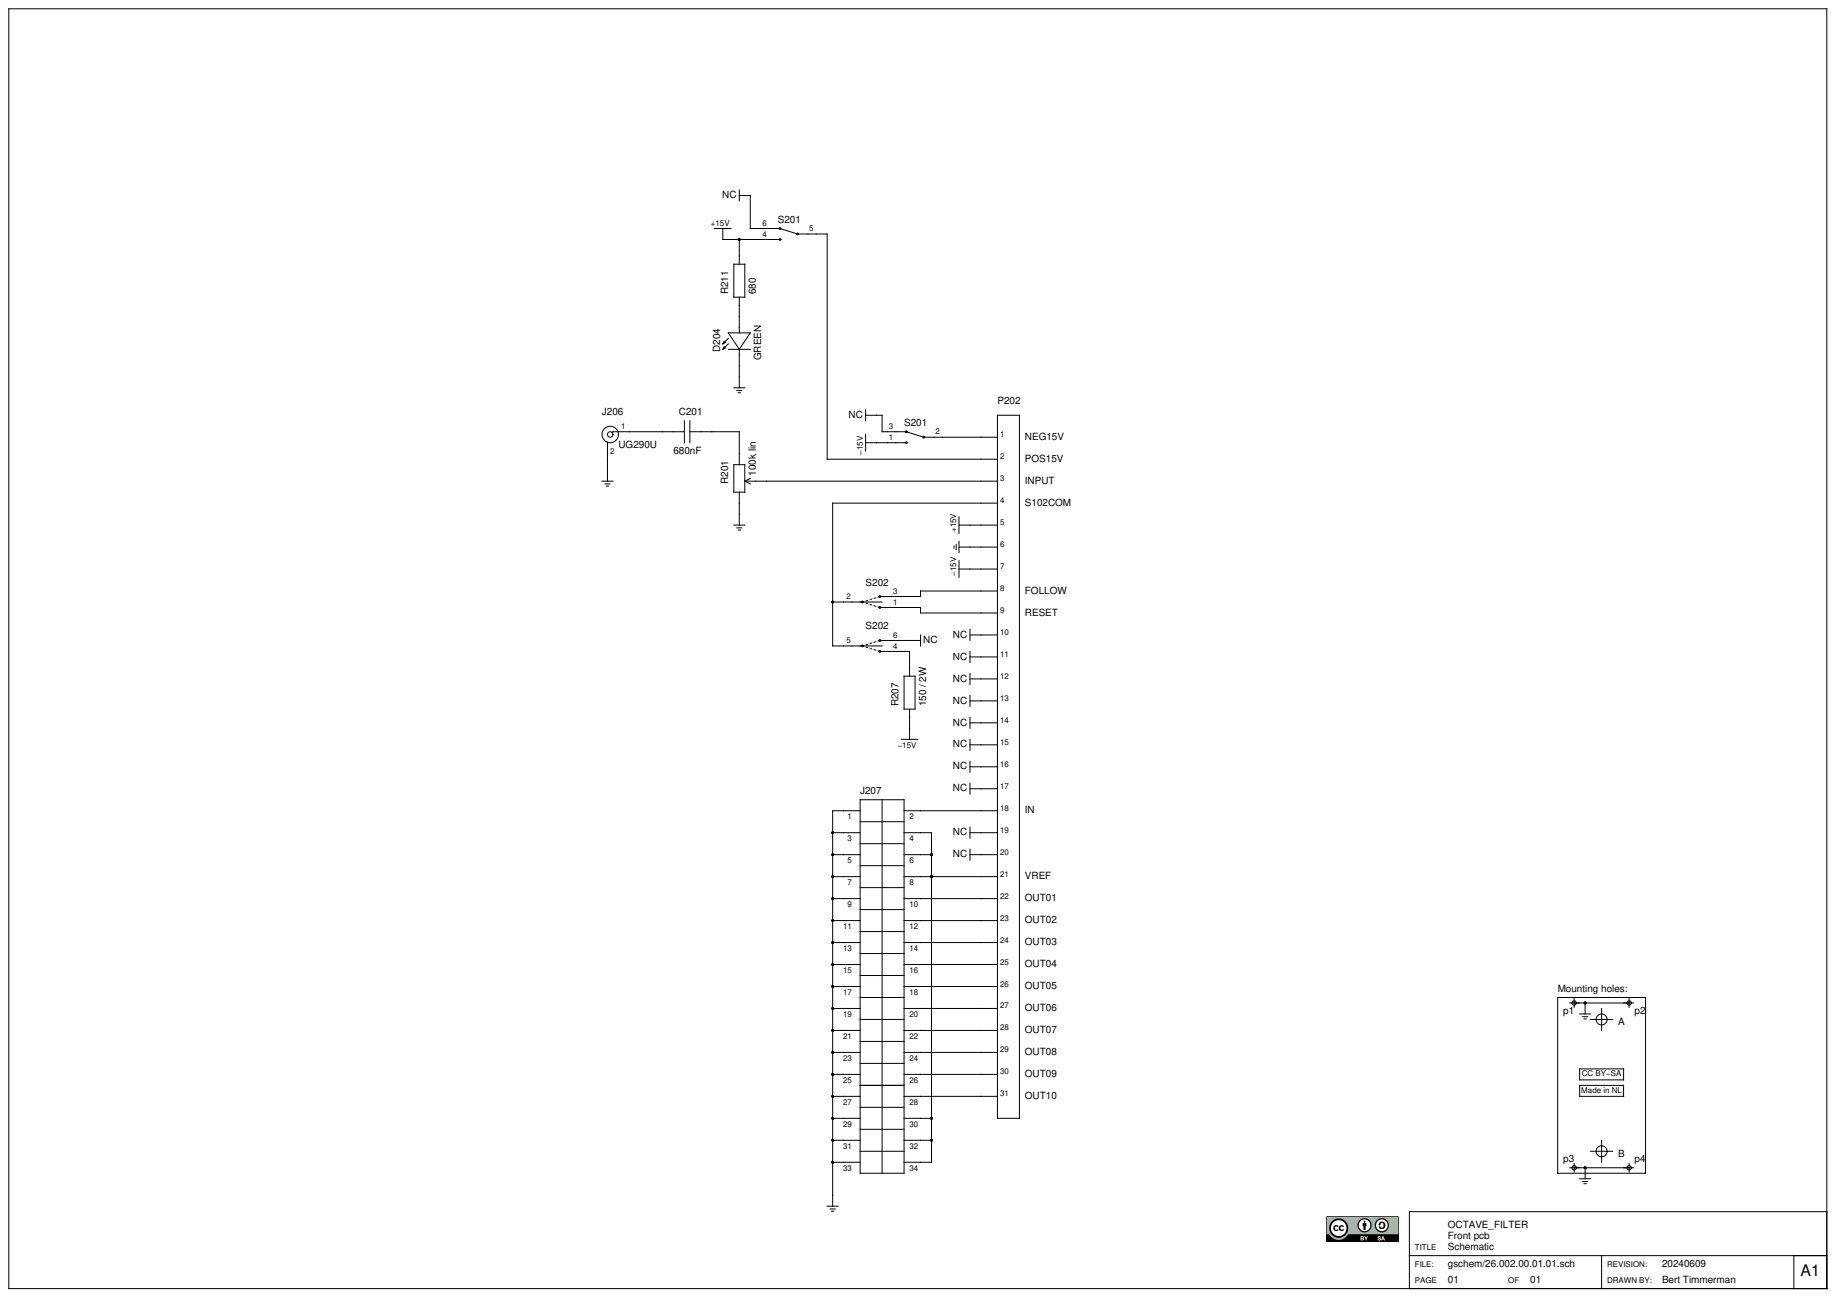
[picture p356: page 10]

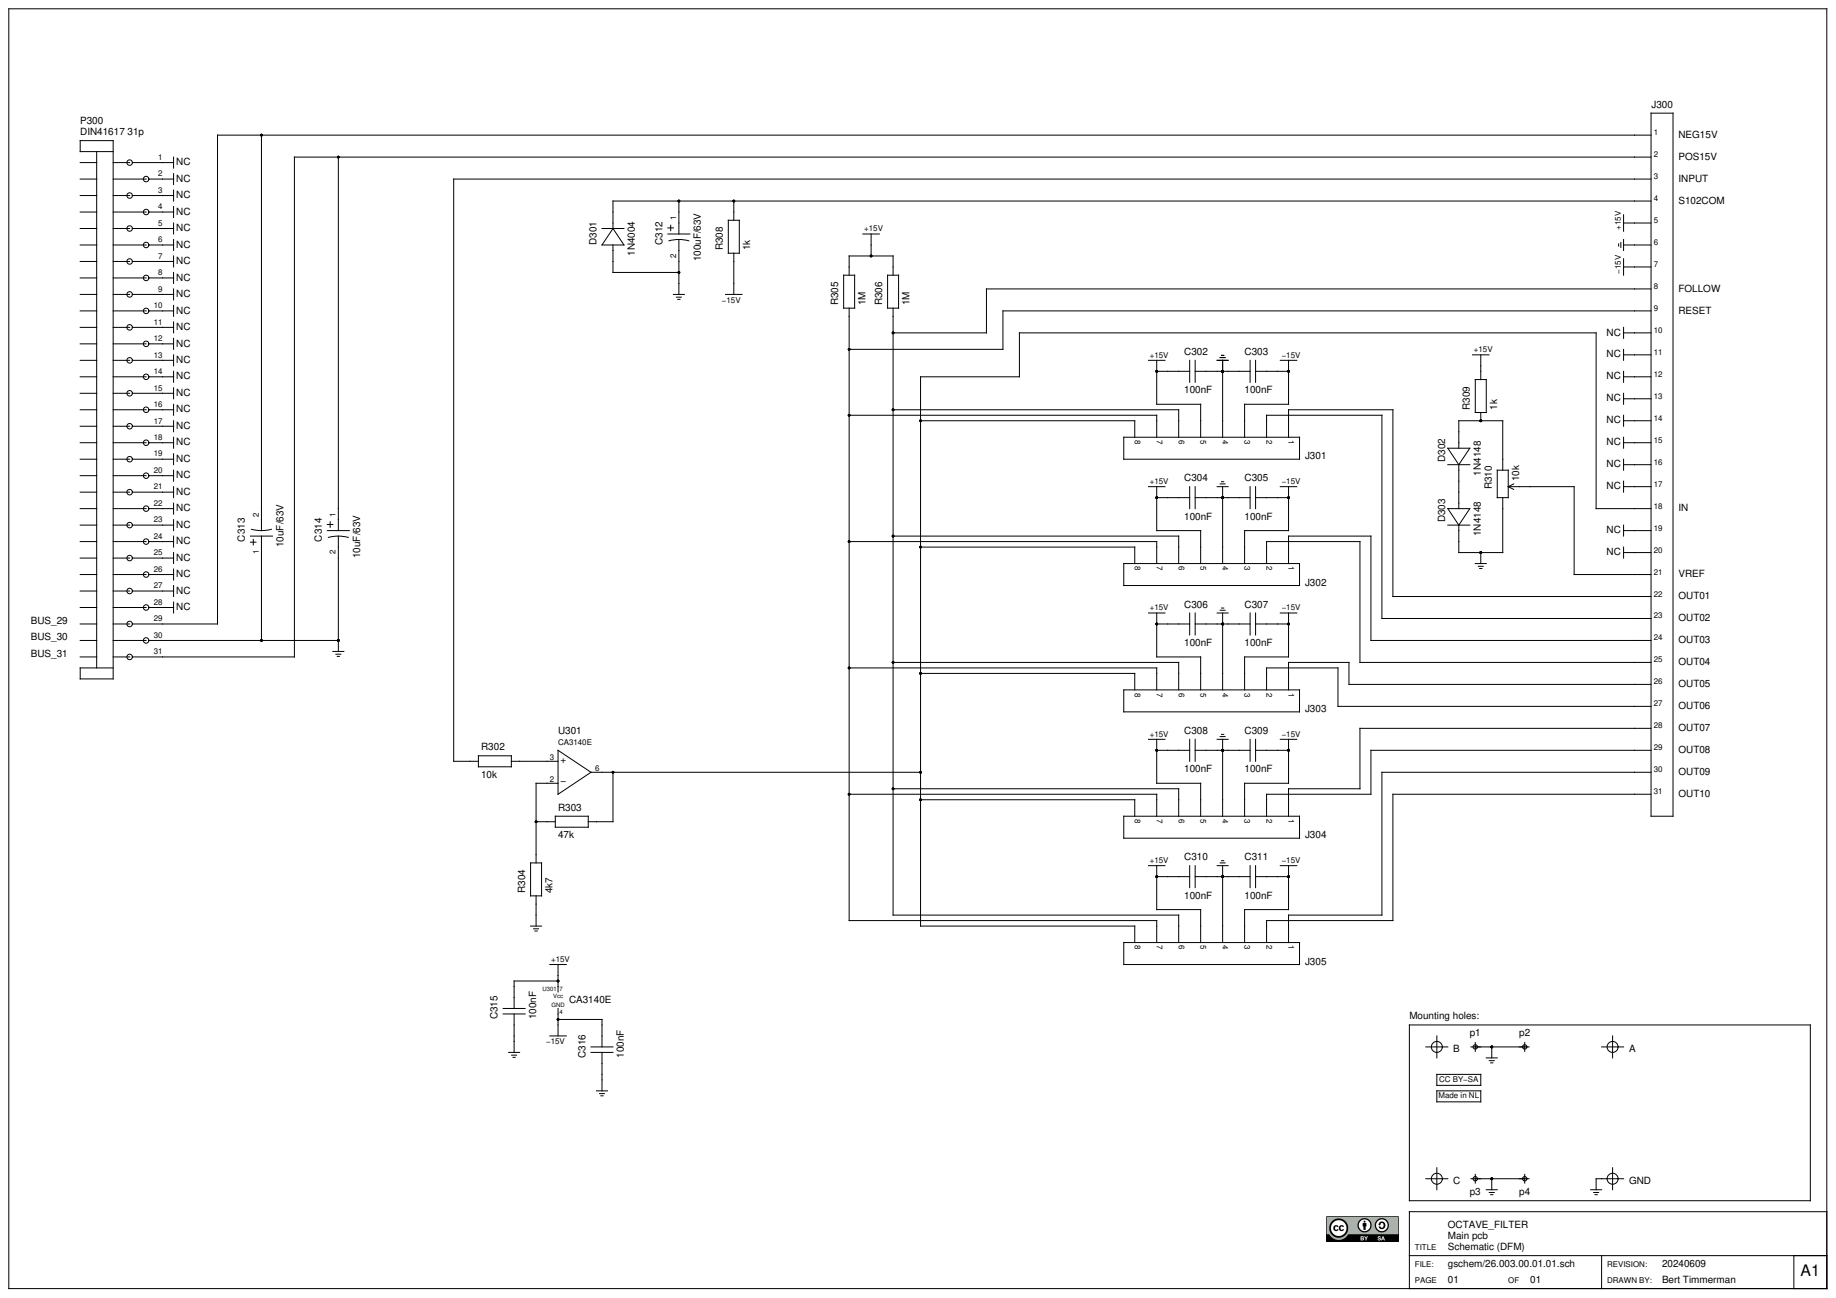
[picture p357: page 11]

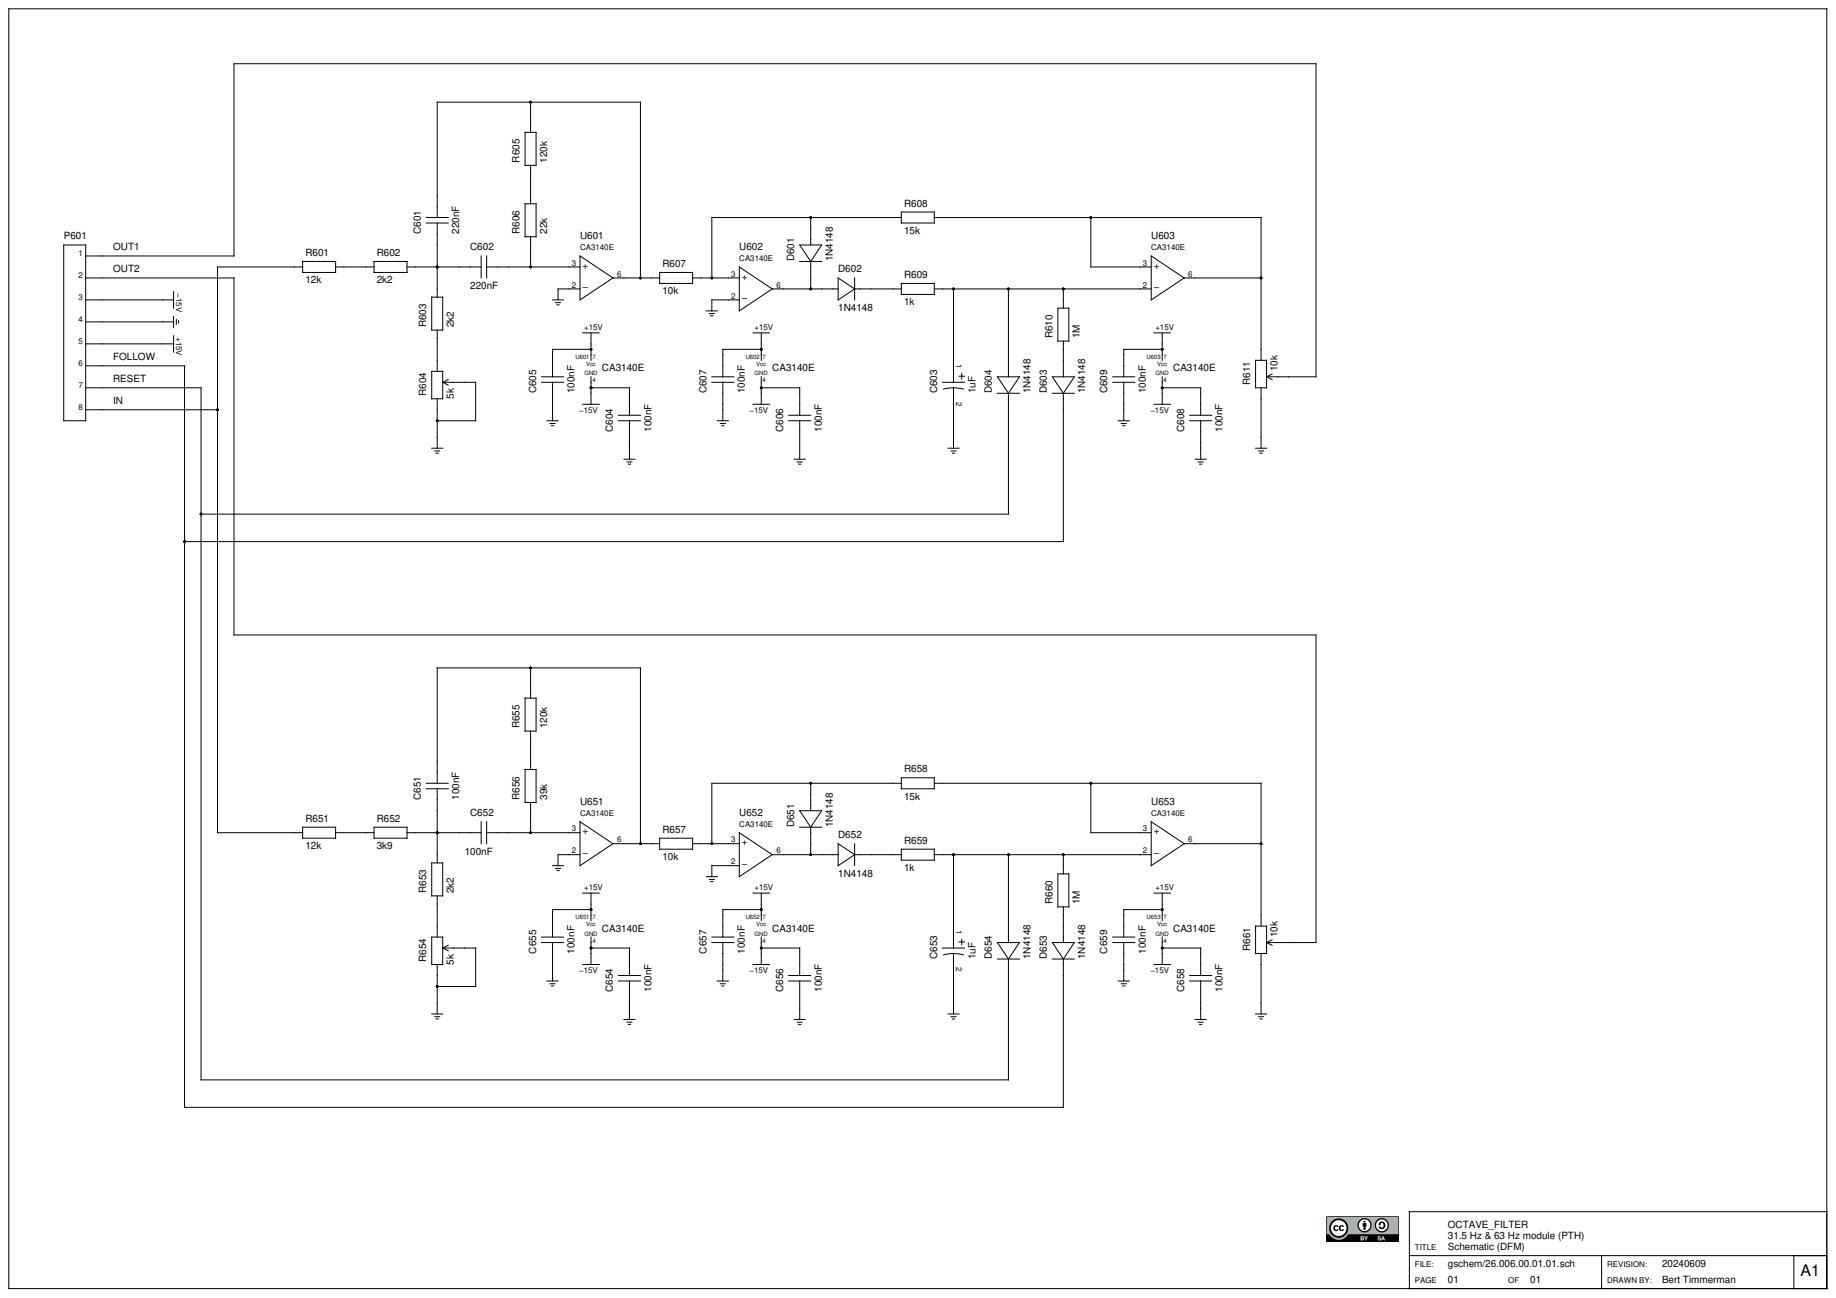
[picture p358: page 12]

OCTAVE_FILTER
31.5 Hz & 63 Hz module (PTH)
Schematic (DFM)

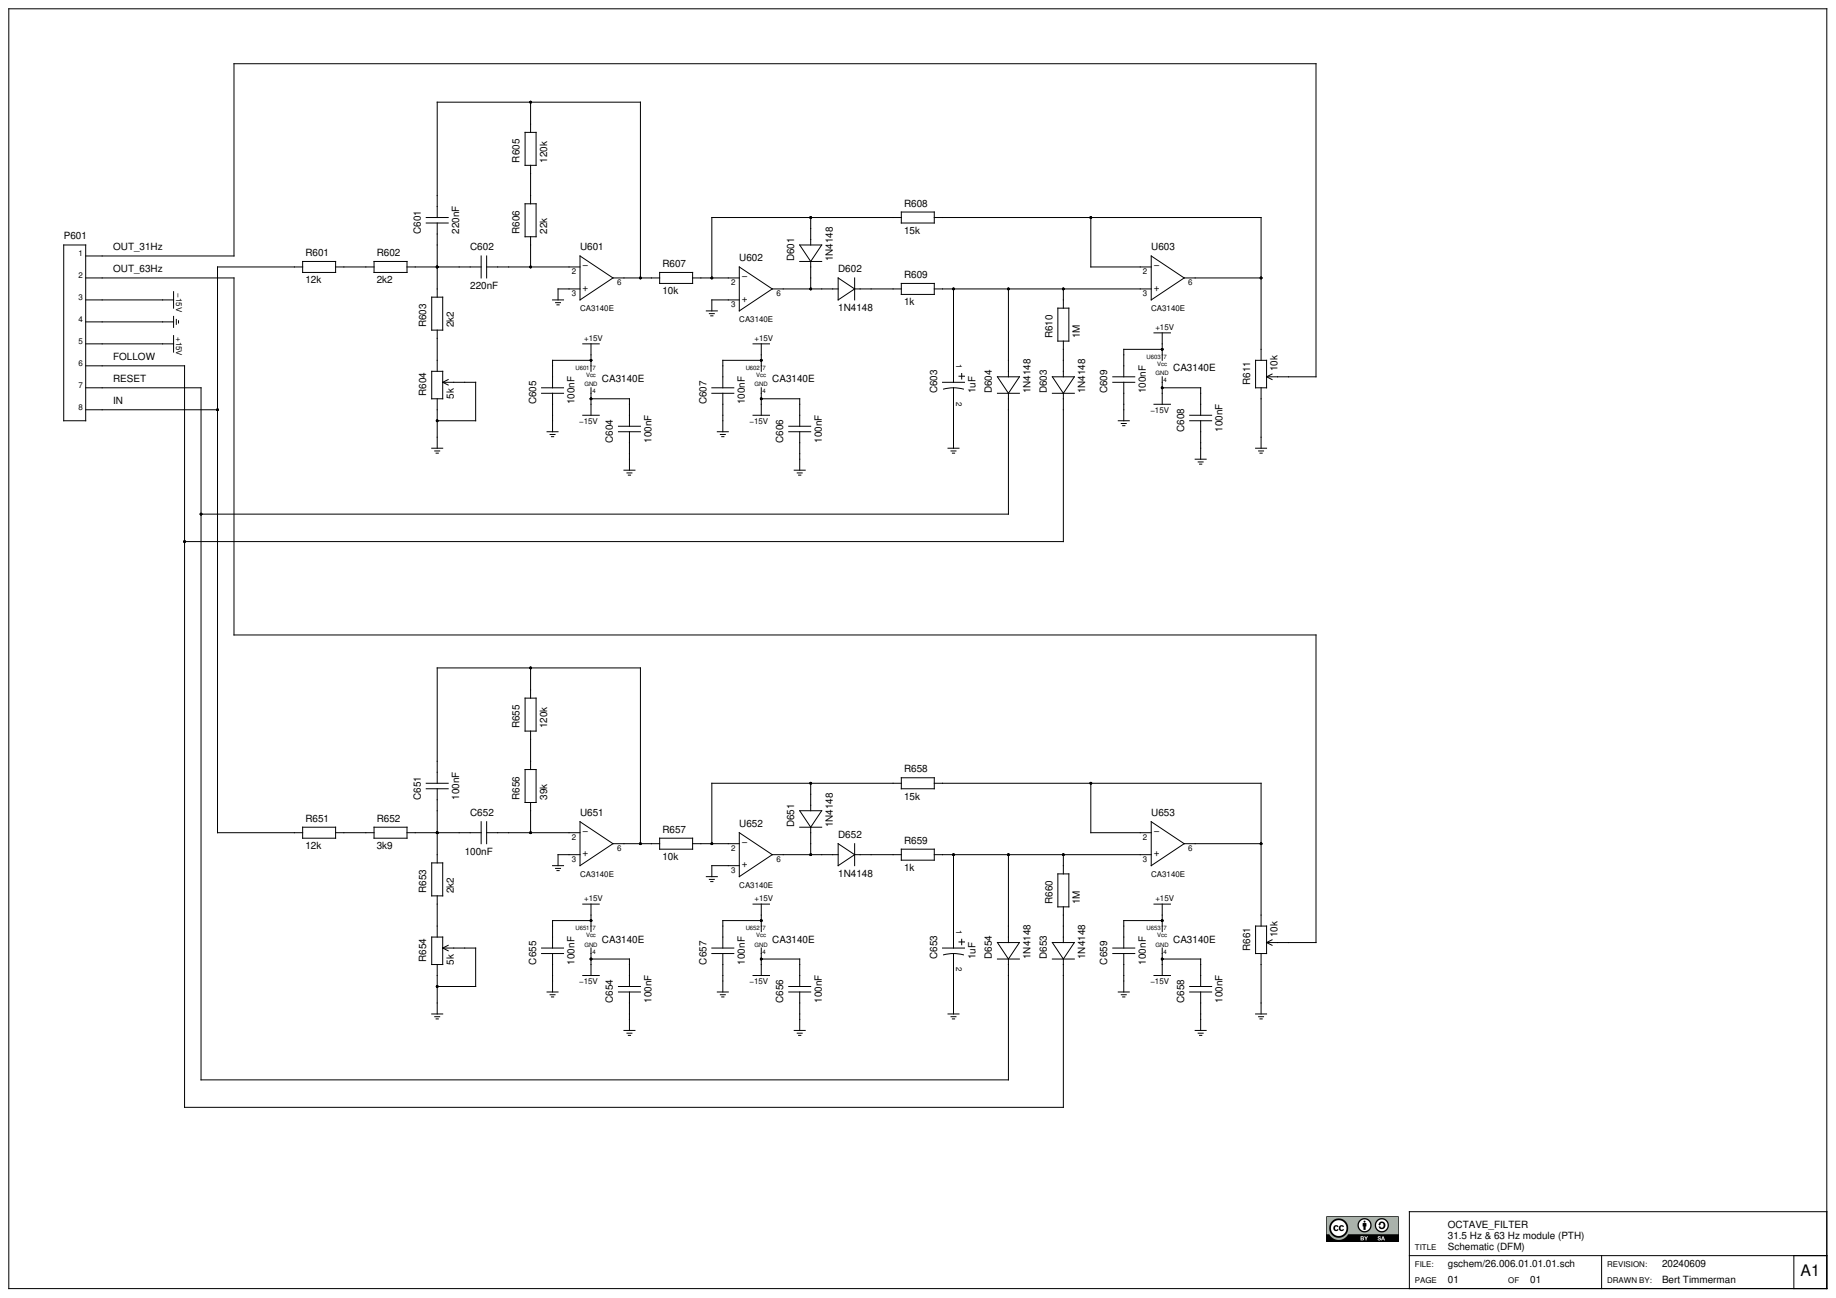
[picture p359: page 13]

OCTAVE_FILTER
31.5 Hz & 63 Hz module (PTH)
Schematic (DFM)

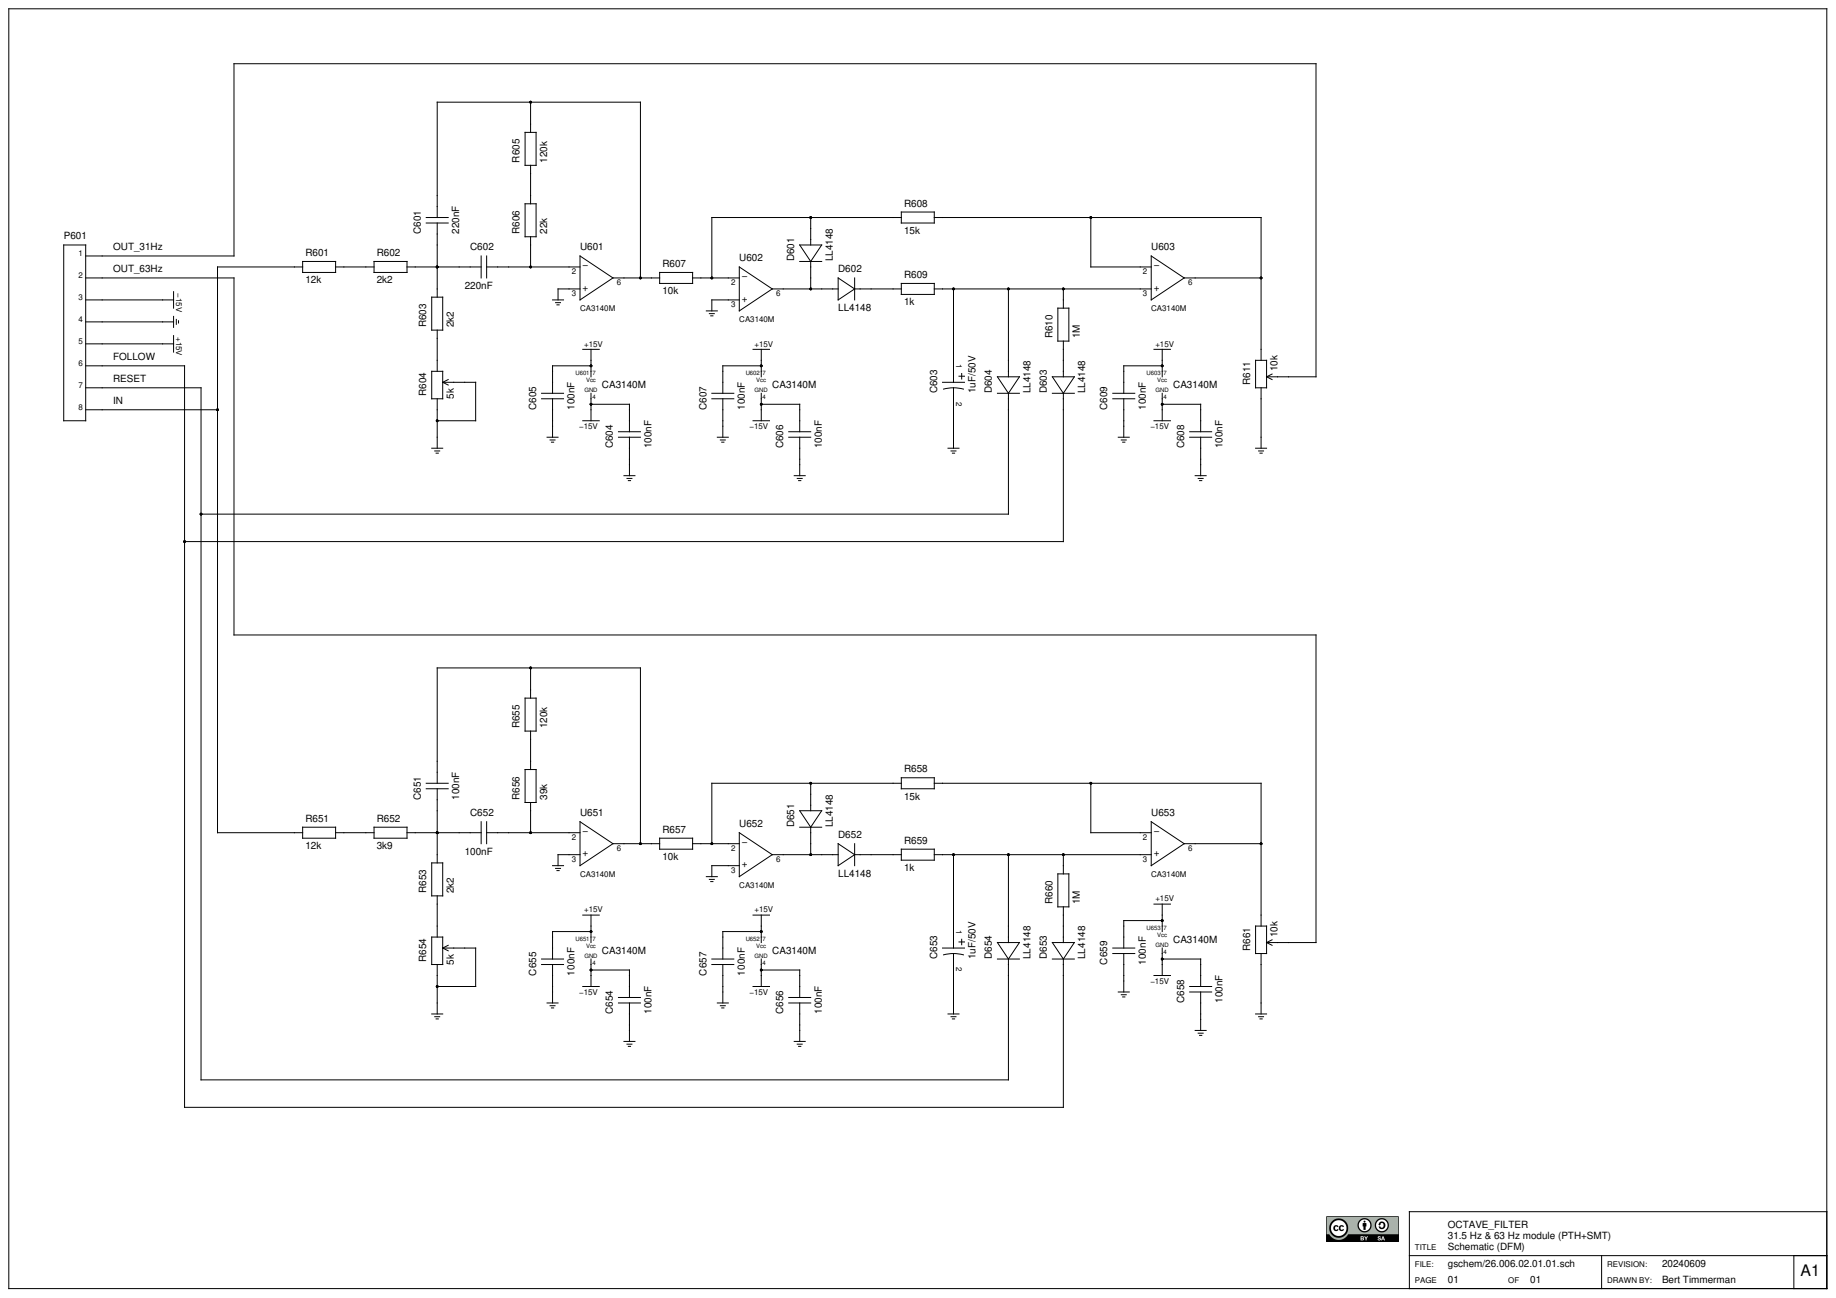
[picture p360: page 14]

OCTAVE_FILTER
31.5 Hz & 63 Hz module (PTH+SMT)
Schematic (DFM)

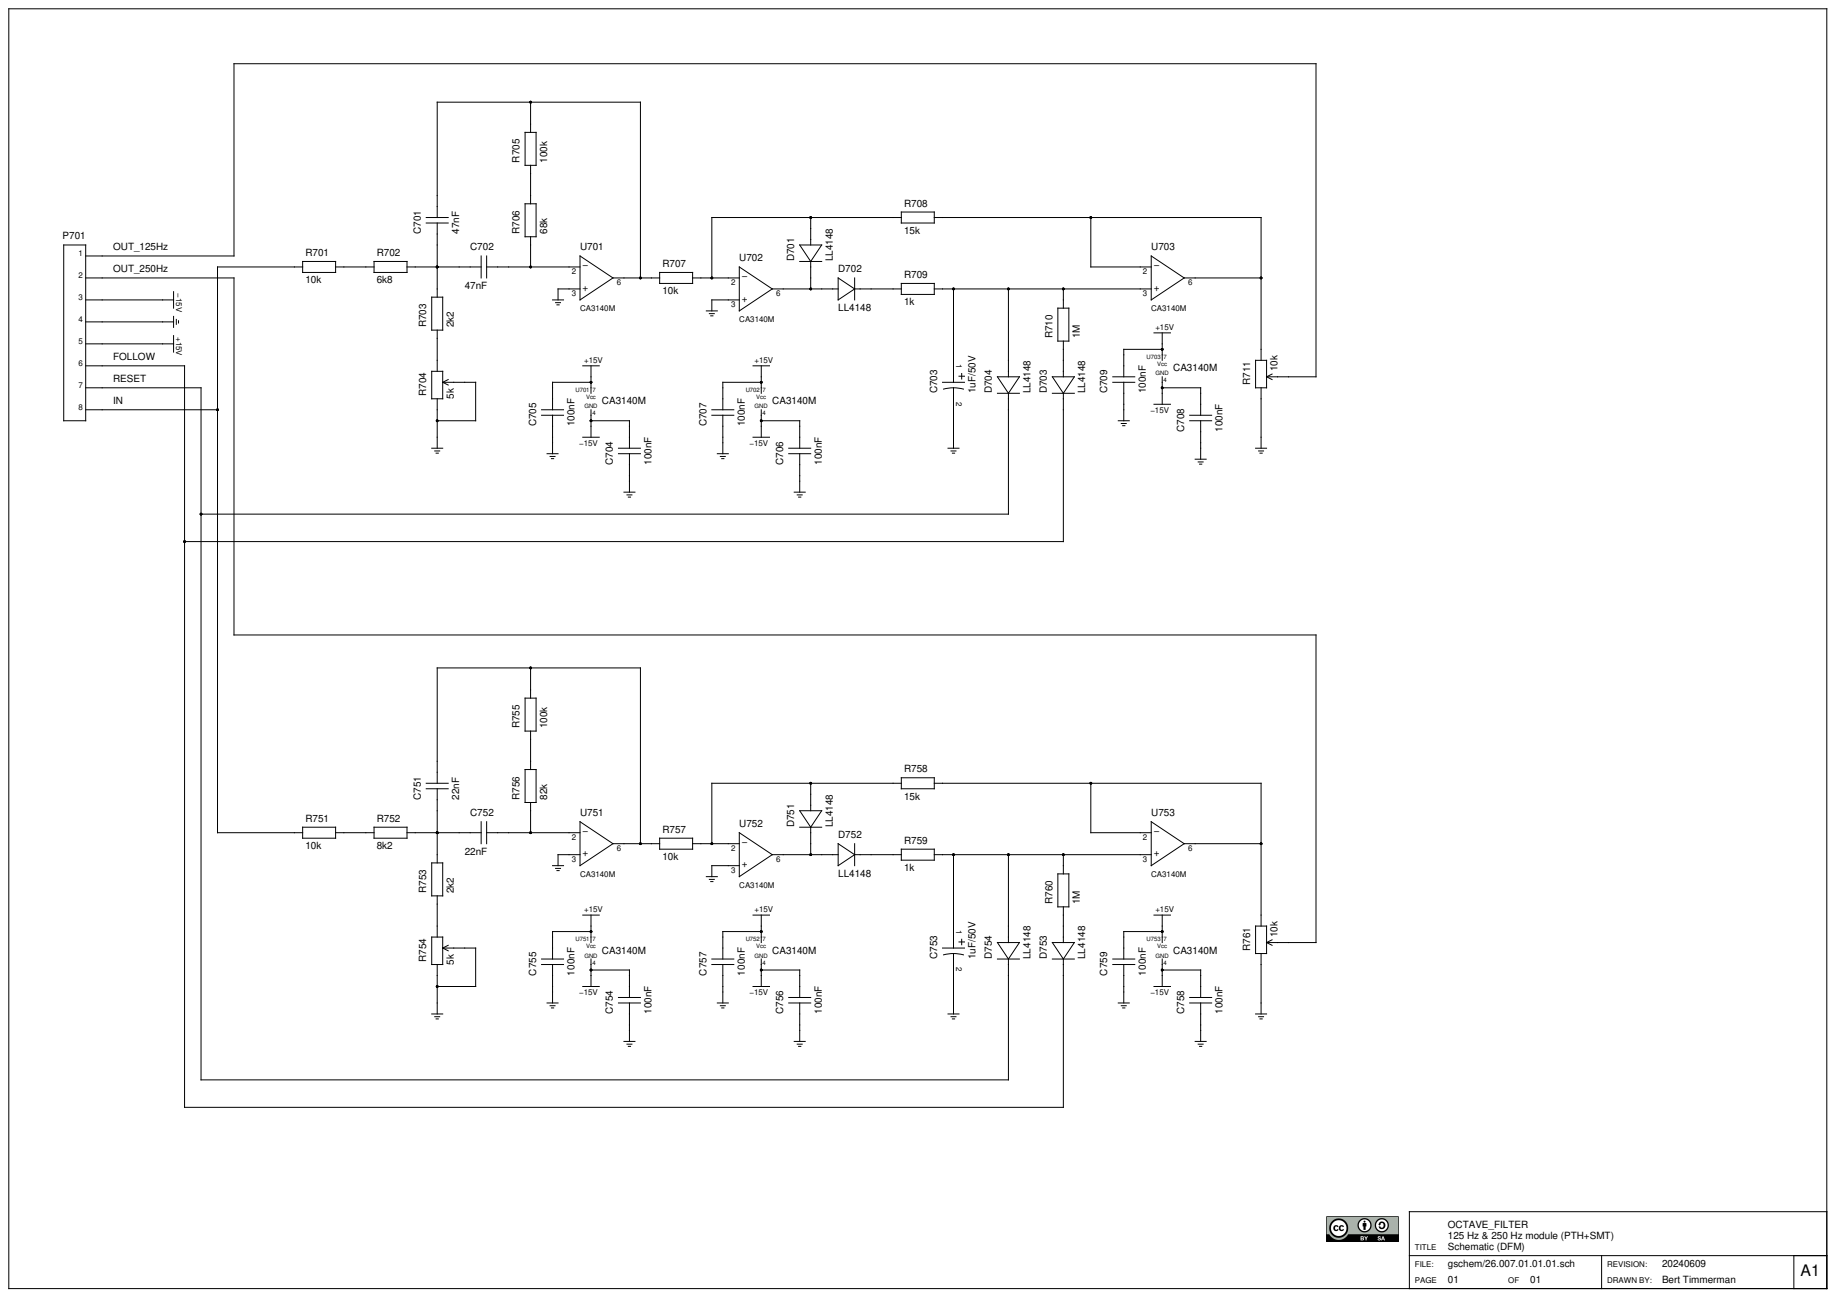
[picture p361: page 15]

OCTAVE_FILTER
125 Hz & 250 Hz module (PTH+SMT)
Schematic (DFM)

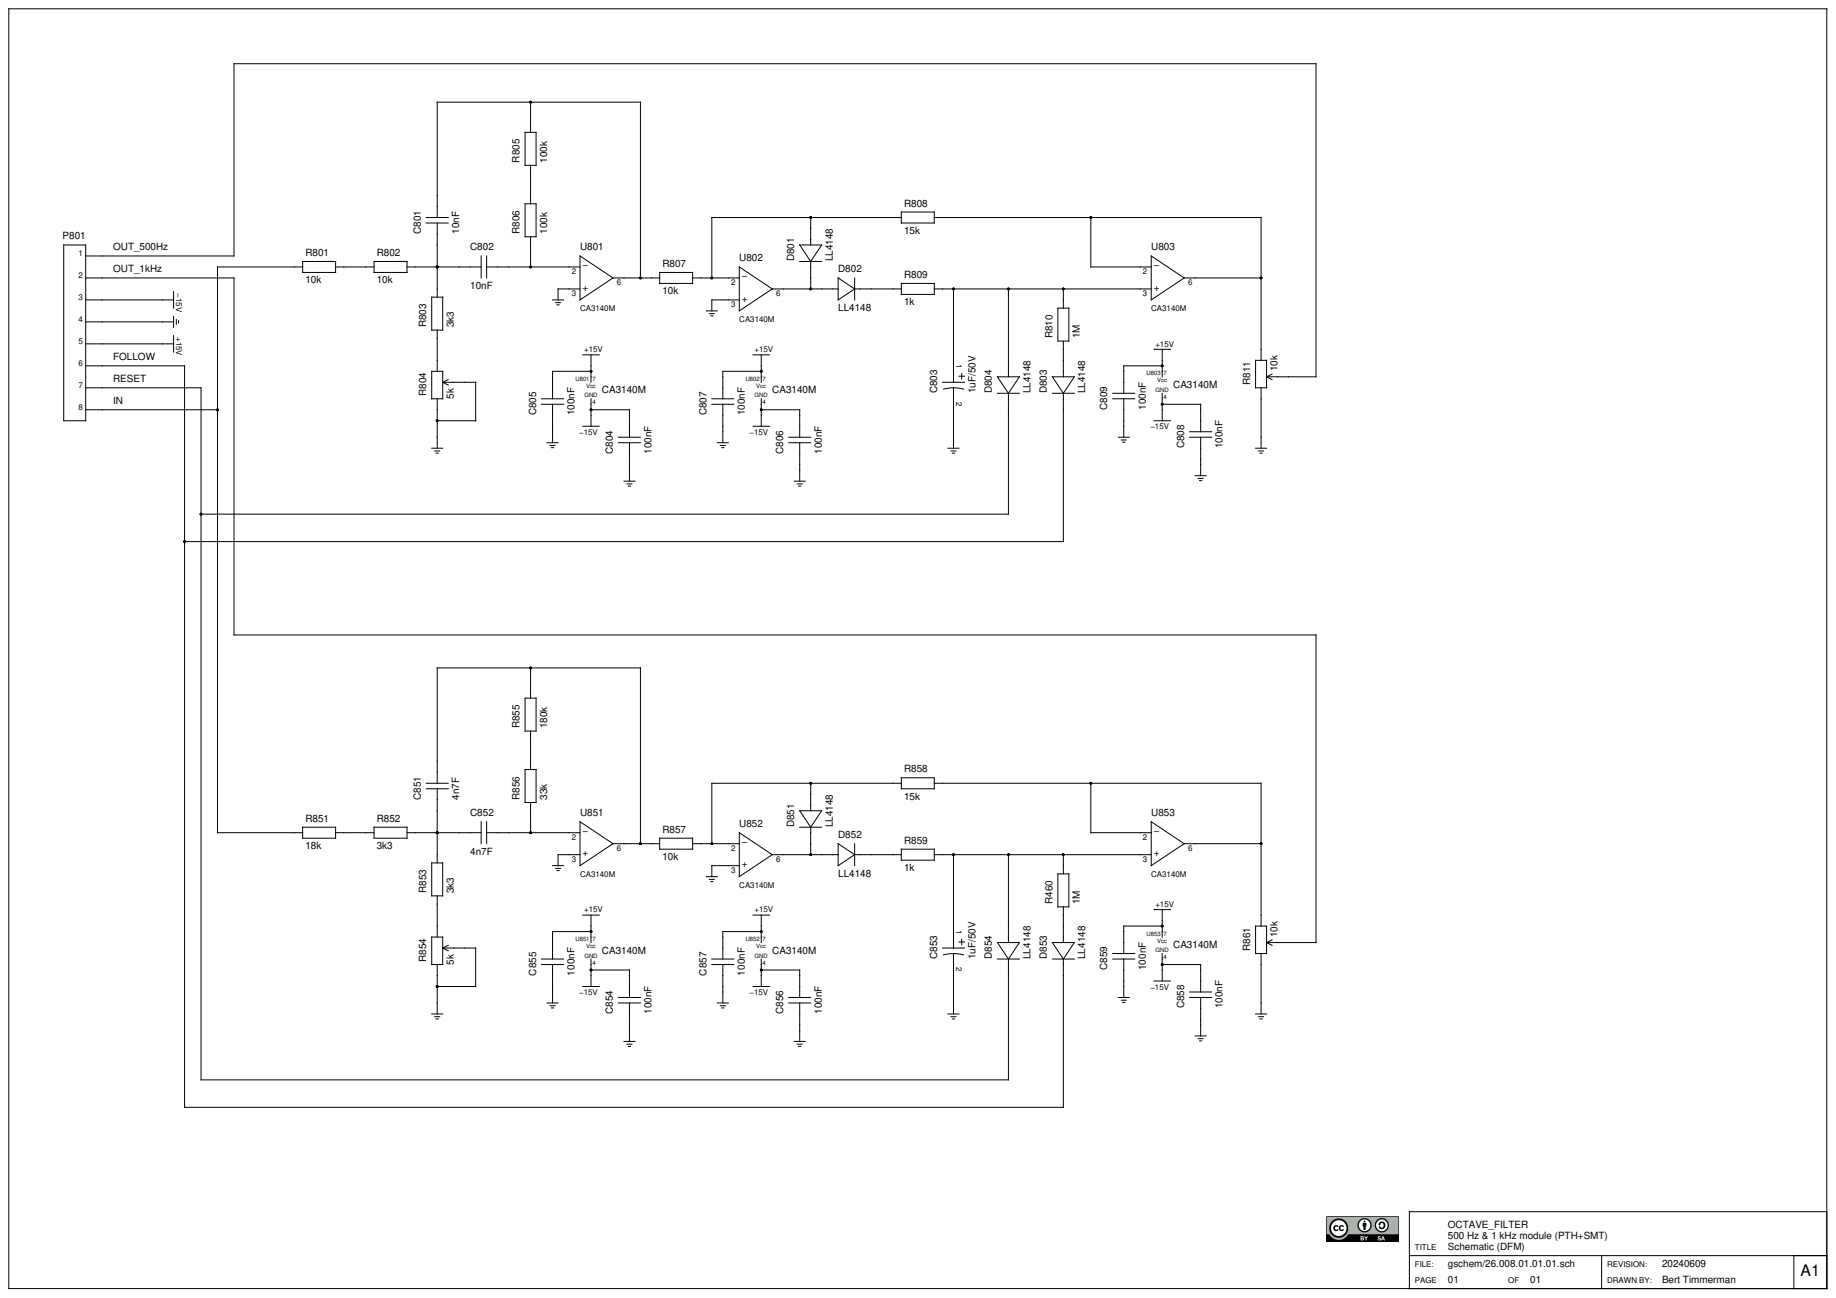
[picture p362: page 16]

OCTAVE_FILTER
500 Hz & 1 kHz module (PTH+SMT)
Schematic (DFM)

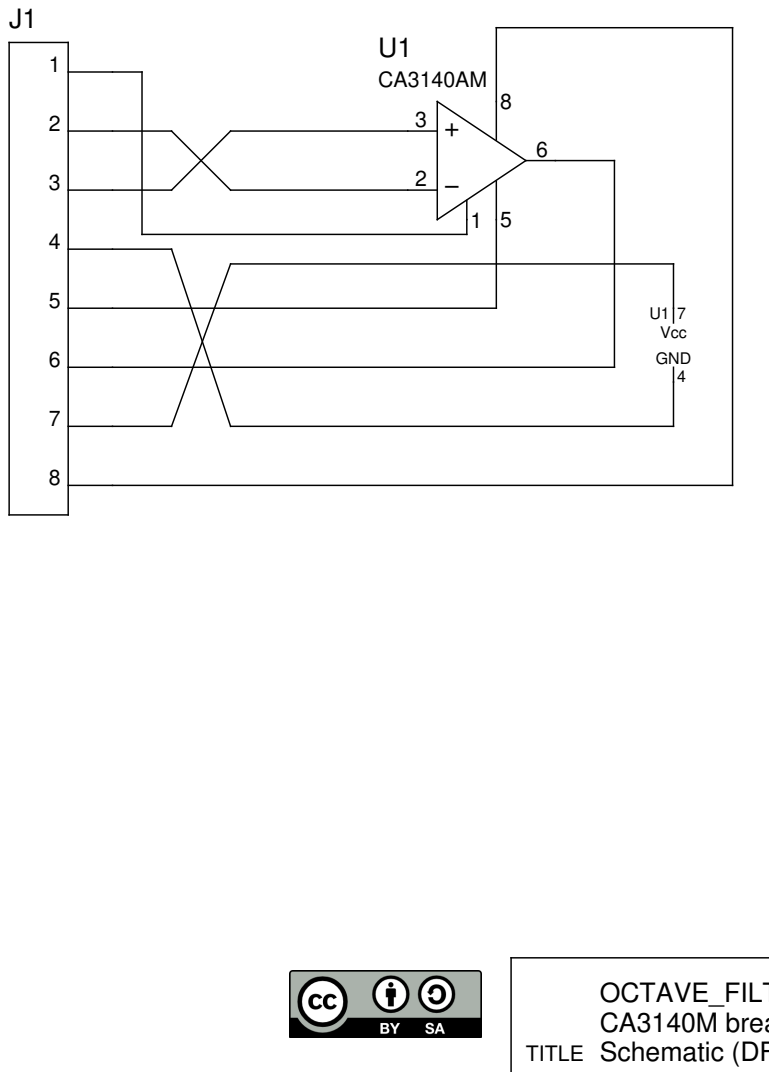
[picture p363: page 17]
PAGE; DRAWN BY:; Bert Timmerman

OCTAVE_FILTER
CA3140M breakout pcb (PTH+SMT)
Schematic (DFM)
gschem/26.999.00.01.01.sch

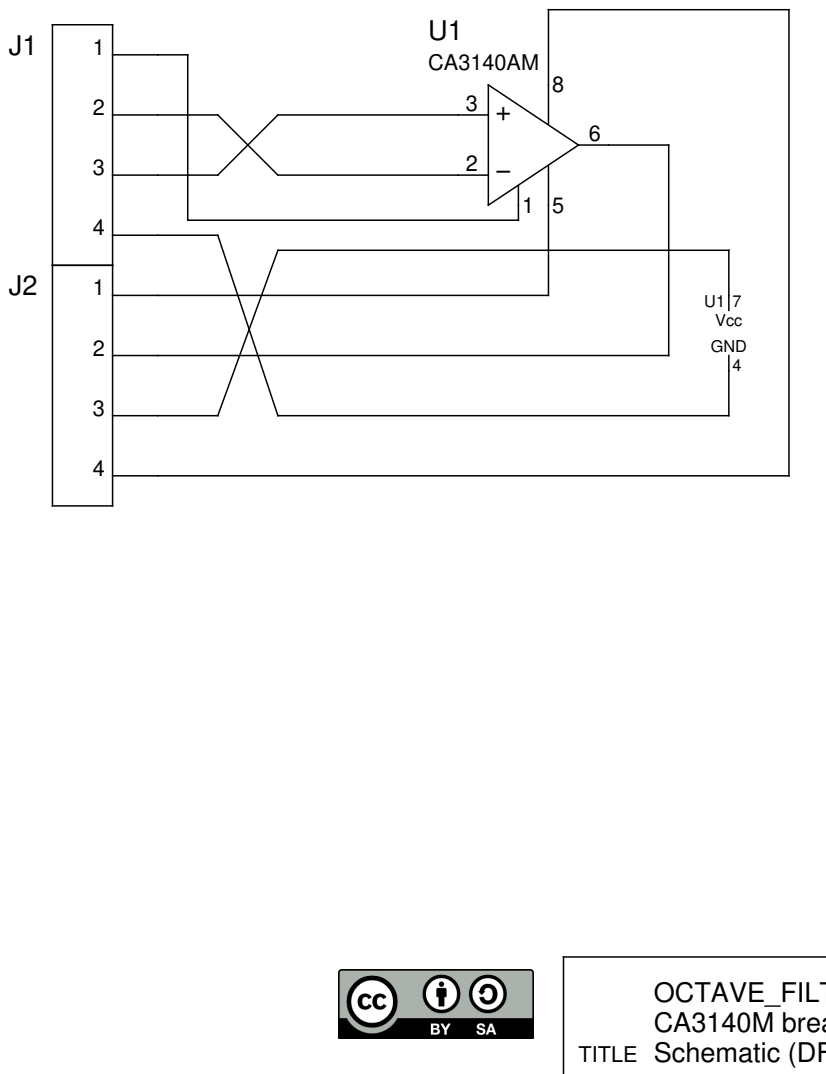
[picture p364: page 18]
PAGE; DRAWN BY:; Bert Timmerman

OCTAVE_FILTER
CA3140M breakout pcb (PTH+SMT)
Schematic (DFM)
gschem/26.999.01.01.01.sch
