lambert/26/docs/26_OCTAVE_FILTER-schematics_DFS.pdf

This hardware is released under Creative Commons Share-alike 4.0 International (http://creativecommons.org/licenses/by-sa/4.0/).

Note: This is a human-readable summary of (and not a substitute for) the license (http://creativecommons.org/licenses/by-sa/4.0/legalcode).

You are free to:

Share — copy and redistribute the material in any medium or format

Adapt — remix, transform, and build upon the material
for any purpose, even commercially.

The licensor cannot revoke these freedoms as long as you follow the license terms.

Under the following terms:

Attribution — You must give appropriate credit, provide a link to the license, and indicate if changes were made. You may do so in any reasonable manner, but not in any way that suggests the licensor endorses you or your use.

ShareAlike — If you remix, transform, or build upon the material, you must distribute your contributions under the same license as the original.

No additional restrictions — You may not apply legal terms or technological measures that legally restrict others from doing anything the license permits.

Notices:

You do not have to comply with the license for elements of the material in the public domain or where your use is permitted by an applicable exception or limitation.

No warranties are given. The license may not give you all of the permissions necessary for your intended use. For example, other rights such as publicity, privacy, or moral rights may limit how you use the material.

| DOC.NR. | | DESCRIPTION STATUS
| 26.001.00.00.01 | FINAL | Pre-amplifier - Frequency response
| 26.001.00.01.01 | FINAL | Pre-amplifier - Transient response (31.5 Hz)
| 26.001.00.01.02 | FINAL | Pre-amplifier - Transient response (16 kHz)
| 26.001.00.01.03 | FINAL | Pre-amplifier - Transient response (1 kHz)
| 26.002.00.00.01 | FINAL | 31.5 Hz Band-pass Filter - Frequency response
| 26.002.00.01.01 | FINAL | 31.5 Hz Band-pass Filter - Transient response (31.5 Hz)
| 26.002.00.01.02 | FINAL | 31.5 Hz Band-pass Filter - Transient response (16 kHz)
| 26.002.00.02.01 | FINAL | 31.5 Hz Band-pass Filter - Transient response (31.5 Hz)
| 26.002.00.02.02 | FINAL | 31.5 Hz Band-pass Filter - Transient response (16 kHz)
| 26.002.00.03.01 | FINAL | 31.5 Hz Band-pass Filter - Transient response (31.5 Hz)
| 26.002.00.03.02 | FINAL | 31.5 Hz Band-pass Filter - Transient response (16 kHz)
| 26.003.00.00.01 | FINAL | 31.5 Hz Detector - Frequency response
| 26.003.00.01.01 | FINAL | 31.5 Hz Detector - Transient response (31.5 Hz)
| 26.003.00.02.01 | FINAL | 31.5 Hz Detector - Transient response (31.5 Hz)
| 26.003.00.03.01 | FINAL | 31.5 Hz Detector - Transient response (31.5 Hz)
| 26.004.00.00.01 | FINAL | 63 Hz Band-pass Filter - Frequency response
| 26.004.00.01.01 | FINAL | 63 Hz Band-pass Filter - Transient response (63 Hz)
| 26.004.00.01.01 | FINAL | 63 Hz Band-pass Filter - Transient response (63 Hz)
| 26.004.00.01.02 | FINAL | 63 Hz Band-pass Filter - Transient response (16 kHz)
| 26.004.00.02.01 | FINAL | 63 Hz Band-pass Filter - Transient response (63 Hz)
| 26.004.00.02.02 | FINAL | 63 Hz Band-pass Filter - Transient response (16 kHz)
| 26.004.00.03.01 | FINAL | 63 Hz Band-pass Filter - Transient response (63 Hz)
| 26.004.00.03.02 | FINAL | 63 Hz Band-pass Filter - Transient response (16 kHz)
| 26.005.00.00.01 | FINAL | 63 Hz Detector - Frequency response
| 26.005.00.01.01 | FINAL | 63 Hz Detector - Transient response (63 Hz)
| 26.005.00.02.01 | FINAL | 63 Hz Detector - Transient response (63 Hz)
| 26.005.00.03.01 | FINAL | 63 Hz Detector - Transient response (63 Hz)
| 26.006.00.00.01 | FINAL | 125 Hz Band-pass Filter - Frequency response
| 26.006.00.01.01 | FINAL | 125 Hz Band-pass Filter - Transient response (125 Hz)
| 26.006.00.01.02 | FINAL | 125 Hz Band-pass Filter - Transient response (16 kHz)
| 26.006.00.02.01 | FINAL | 125 Hz Band-pass Filter - Transient response (125 Hz)
| 26.006.00.02.02 | FINAL | 125 Hz Band-pass Filter - Transient response (16 kHz)
| 26.006.00.03.01 | FINAL | 125 Hz Band-pass Filter - Transient response (125 Hz)
| OCTAVE_FILTER TITLE Front Page
gnucap/26.000.00.00.01.sch FILE: 01 01 PAGE OF | 20240607 REVISION: Bert Timmerman DRAWN BY: | A3

DOC.NR. | | DESCRIPTION STATUS | DOC.NR. | | DESCRIPTION STATUS
26.006.00.03.02 | FINAL | 125 Hz Band−pass Filter − Transient response (16 kHz) | 26.012.00.02.02 | FINAL | 1 kHz Band−pass Filter − Transient response (16 kHz)
26.007.00.00.01 | FINAL | 125 Hz Detector − Frequency response | 26.012.00.02.03 | FINAL | 1 kHz Band−pass Filter − Transient response (31.5 Hz)
26.007.00.01.01 | FINAL | 125 Hz Detector − Transient response (125 Hz) | 26.012.00.03.01 | FINAL | 1 kHz Band−pass Filter − Transient response (1 kHz)
26.007.00.01.01 | FINAL | 125 Hz Detector − Transient response (125 Hz) | 26.012.00.03.02 | FINAL | 1 kHz Band−pass Filter − Transient response (16 kHz)
26.007.00.02.01 | FINAL | 125 Hz Detector − Transient response (125 Hz) | 26.012.00.03.03 | FINAL | 1 kHz Band−pass Filter − Transient response (31.5 Hz)
26.007.00.03.01 | FINAL | 125 Hz Detector − Transient response (125 Hz) | 26.013.00.00.01 | FINAL | 1 kHz Detector − Frequency response
26.008.00.00.01 | FINAL | 250 Hz Band−pass Filter − Frequency response | 26.013.00.01.01 | FINAL | 1 kHz Detector − Transient response (1 kHz)
26.008.00.01.01 | FINAL | 250 Hz Band−pass Filter − Transient response (250 Hz) | 26.013.00.02.01 | FINAL | 1 kHz Detector − Transient response (1 kHz)
26.008.00.01.02 | FINAL | 250 Hz Band−pass Filter − Transient response (16 kHz) | 26.013.00.03.01 | FINAL | 1 kHz Detector − Transient response (1 kHz)
26.008.00.02.01 | FINAL | 250 Hz Band−pass Filter − Transient response (250 Hz) | 26.014.00.00.01 | FINAL | 2 kHz Band−pass Filter − Frequency response
26.008.00.02.02 | FINAL | 250 Hz Band−pass Filter − Transient response (16 kHz) | 26.014.00.01.01 | FINAL | 2 kHz Band−pass Filter − Transient response (2 kHz)
26.008.00.03.01 | FINAL | 250 Hz Band−pass Filter − Transient response (250 Hz) | 26.014.00.01.02 | FINAL | 2 kHz Band−pass Filter − Transient response (16 kHz)
26.008.00.03.02 | FINAL | 250 Hz Band−pass Filter − Transient response (16 kHz) | 26.014.00.01.03 | FINAL | 2 kHz Band−pass Filter − Transient response (31.5 Hz)
26.009.00.00.01 | FINAL | 250 Hz Detector − Frequency response | 26.014.00.02.01 | FINAL | 2 kHz Band−pass Filter − Transient response (2 kHz)
26.009.00.01.01 | FINAL | 250 Hz Detector − Transient response (250 Hz) | 26.014.00.02.02 | FINAL | 2 kHz Band−pass Filter − Transient response (16 kHz)
26.009.00.02.01 | FINAL | 250 Hz Detector − Transient response (250 Hz) | 26.014.00.02.03 | FINAL | 2 kHz Band−pass Filter − Transient response (31.5 Hz)
26.009.00.03.01 | FINAL | 250 Hz Detector − Transient response (250 Hz) | 26.014.00.03.01 | FINAL | 2 kHz Band−pass Filter − Transient response (2 kHz)
26.010.00.00.01 | FINAL | 500 Hz Band−pass Filter − Frequency response | 26.014.00.03.02 | FINAL | 2 kHz Band−pass Filter − Transient response (16 kHz)
26.010.00.01.01 | FINAL | 500 Hz Band−pass Filter − Transient response (500 Hz) | 26.014.00.03.03 | FINAL | 2 kHz Band−pass Filter − Transient response (31.5 Hz)
26.010.00.01.02 | FINAL | 500 Hz Band−pass Filter − Transient response (16 kHz) | 26.015.00.00.01 | FINAL | 2 kHz Detector − Frequency response
26.010.00.02.01 | FINAL | 500 Hz Band−pass Filter − Transient response (500 Hz) | 26.015.00.01.01 | FINAL | 2 kHz Detector − Transient response (2 kHz)
26.010.00.02.02 | FINAL | 500 Hz Band−pass Filter − Transient response (16 kHz) | 26.015.00.02.01 | FINAL | 2 kHz Detector − Transient response (2 kHz)
26.010.00.03.01 | FINAL | 500 Hz Band−pass Filter − Transient response (500 Hz) | 26.015.00.03.01 | FINAL | 2 kHz Detector − Transient response (2 kHz)
26.010.00.03.02 | FINAL | 500 Hz Band−pass Filter − Transient response (16 kHz) | 26.016.00.00.01 | FINAL | 4 kHz Band−pass Filter − Frequency response
26.011.00.00.01 | FINAL | 500 Hz Detector − Frequency response | 26.016.00.01.01 | FINAL | 4 kHz Band−pass Filter − Transient response (4 kHz)
26.011.00.01.01 | FINAL | 500 Hz Detector − Transient response (500 Hz) | 26.016.00.01.02 | FINAL | 4 kHz Band−pass Filter − Transient response (16 kHz)
26.011.00.02.01 | FINAL | 500 Hz Detector − Transient response (500 Hz) | 26.016.00.01.03 | FINAL | 4 kHz Band−pass Filter − Transient response (31.5 Hz)
26.011.00.03.01 | FINAL | 500 Hz Detector − Transient response (500 Hz) | 26.016.00.02.01 | FINAL | 4 kHz Band−pass Filter − Transient response (4 kHz)
26.012.00.00.01 | FINAL | 1 kHz Band−pass Filter − Frequency response | 26.016.00.02.02 | FINAL | 4 kHz Band−pass Filter − Transient response (16 kHz)
26.012.00.01.01 | FINAL | 1 kHz Band−pass Filter − Transient response (1 kHz) | 26.016.00.02.03 | FINAL | 4 kHz Band−pass Filter − Transient response (31.5 Hz)
26.012.00.01.02 | FINAL | 1 kHz Band−pass Filter − Transient response (16 kHz) | 26.016.00.03.01 | FINAL | 4 kHz Band−pass Filter − Transient response (4 kHz)
26.012.00.01.03 | FINAL | 1 kHz Band−pass Filter − Transient response (31.5 Hz) | 26.016.00.03.02 | FINAL | 4 kHz Band−pass Filter − Transient response (16 kHz)
26.012.00.02.01 | FINAL | 1 kHz Band−pass Filter − Transient response (1 kHz) | 26.016.00.03.03 | FINAL | 4 kHz Band−pass Filter − Transient response (31.5 Hz)
| | | OCTAVE_FILTER TITLE Front Page
gnucap/26.000.00.00.02.sch 01 01 | 20240607 Bert Timmerman | A3

| OCTAVE_FILTER TITLE Front Page
gnucap/26.000.00.00.03.sch 01 01 | 20240608 Bert Timmerman | A3
DOC.NR. | | DESCRIPTION STATUS
26.017.00.00.01 | FINAL | 4 kHz Detector − Frequency response
26.017.00.01.01 | FINAL | 4 kHz Detector − Transient response (4 kHz)
26.017.00.02.01 | FINAL | 4 kHz Detector − Transient response (4 kHz)
26.017.00.03.01 | FINAL | 4 kHz Detector − Transient response (4 kHz)
26.018.00.00.01 | FINAL | 8 kHz Band−pass Filter − Frequency response
26.018.00.01.01 | FINAL | 8 kHz Band−pass Filter − Transient response (8 kHz)
26.018.00.01.02 | FINAL | 8 kHz Band−pass Filter − Transient response (16 kHz)
26.018.00.01.03 | FINAL | 8 kHz Band−pass Filter − Transient response (31.5 Hz)
26.018.00.02.01 | FINAL | 8 kHz Band−pass Filter − Transient response (8 kHz)
26.018.00.02.02 | FINAL | 8 kHz Band−pass Filter − Transient response (16 kHz)
26.018.00.02.03 | FINAL | 8 kHz Band−pass Filter − Transient response (31.5 Hz)
26.018.00.03.01 | FINAL | 8 kHz Band−pass Filter − Transient response (8 kHz)
26.018.00.03.02 | FINAL | 8 kHz Band−pass Filter − Transient response (16 kHz)
26.018.00.03.03 | FINAL | 8 kHz Band−pass Filter − Transient response (31.5 Hz)
26.019.00.00.01 | FINAL | 8 kHz Detector − Frequency response
26.019.00.01.01 | FINAL | 8 kHz Detector − Transient response (8 kHz)
26.019.00.02.01 | FINAL | 8 kHz Detector − Transient response (8 kHz)
26.019.00.03.01 | FINAL | 8 kHz Detector − Transient response (8 kHz)
26.020.00.00.01 | FINAL | 16 kHz Band−pass Filter − Frequency response
26.020.00.01.01 | FINAL | 16 kHz Band−pass Filter − Transient response (16 kHz)
26.020.00.01.02 | FINAL | 16 kHz Band−pass Filter − Transient response (31.5 Hz)
26.020.00.02.01 | FINAL | 16 kHz Band−pass Filter − Transient response (16 kHz)
26.020.00.02.02 | FINAL | 16 kHz Band−pass Filter − Transient response (31.5 Hz)
26.020.00.03.01 | FINAL | 16 kHz Band−pass Filter − Transient response (16 kHz)
26.020.00.03.02 | FINAL | 16 kHz Band−pass Filter − Transient response (31.5 Hz)
26.021.00.00.01 | FINAL | 16 kHz Detector − Frequency response
26.021.00.01.01 | FINAL | 16 kHz Detector − Transient response (16 kHz)
26.021.00.02.01 | FINAL | 16 kHz Detector − Transient response (16 kHz)
26.021.00.03.01 | FINAL | 16 kHz Detector − Transient response (16 kHz)

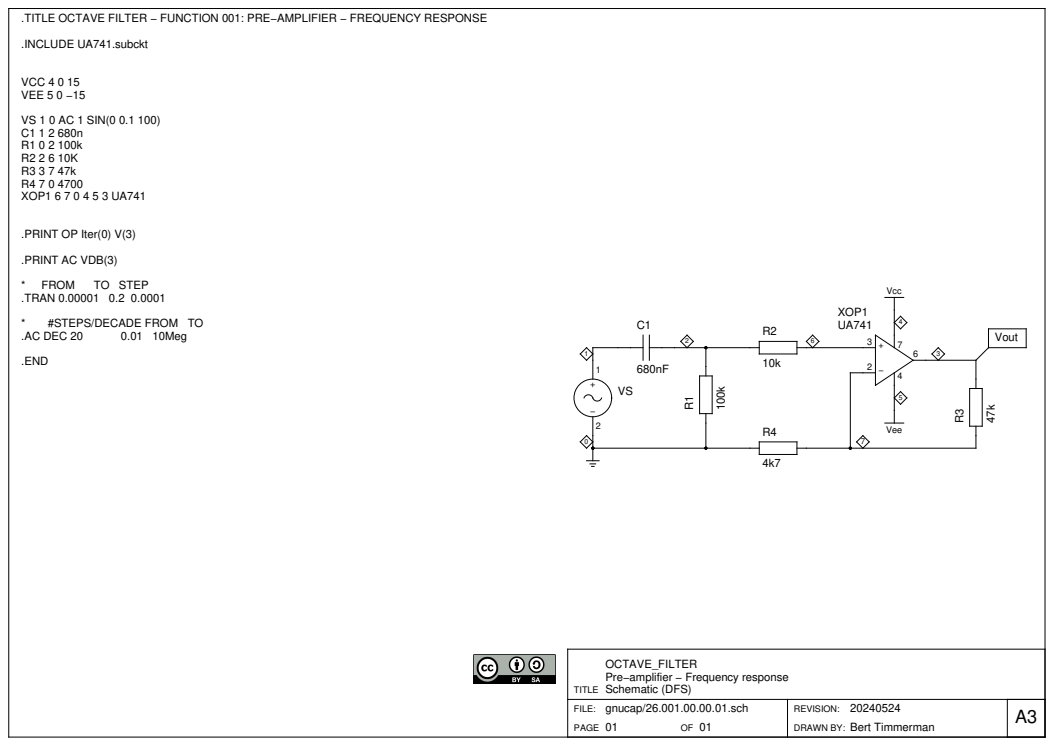
[picture p365: page 4]
Bert Timmerman gnucap/26.001.00.00.01.sch 01; 6 Vout; .INCLUDE UA741.subckt; VCC 4 0 15 VEE 5 0 −15; VS 1 0 AC 1 SIN(0 0.1 100) C1 1 2 680n R1 0 2 100k R2 2 6 10K R3 3 7 47k R4 7 0 4700 XOP1 6 7 0 4 5 3 UA741; FROM; TO STEP; .TRAN 0.00001 0.2 0.0001; #STEPS/DECADE FROM TO; .AC DEC 20; 0.01 10Meg

.TITLE OCTAVE FILTER − FUNCTION 001: PRE−AMPLIFIER − FREQUENCY RESPONSE

.PRINT OP Iter(0) V(3)

.PRINT AC VDB(3)

OCTAVE_FILTER
Pre−amplifier − Frequency response
Schematic (DFS)

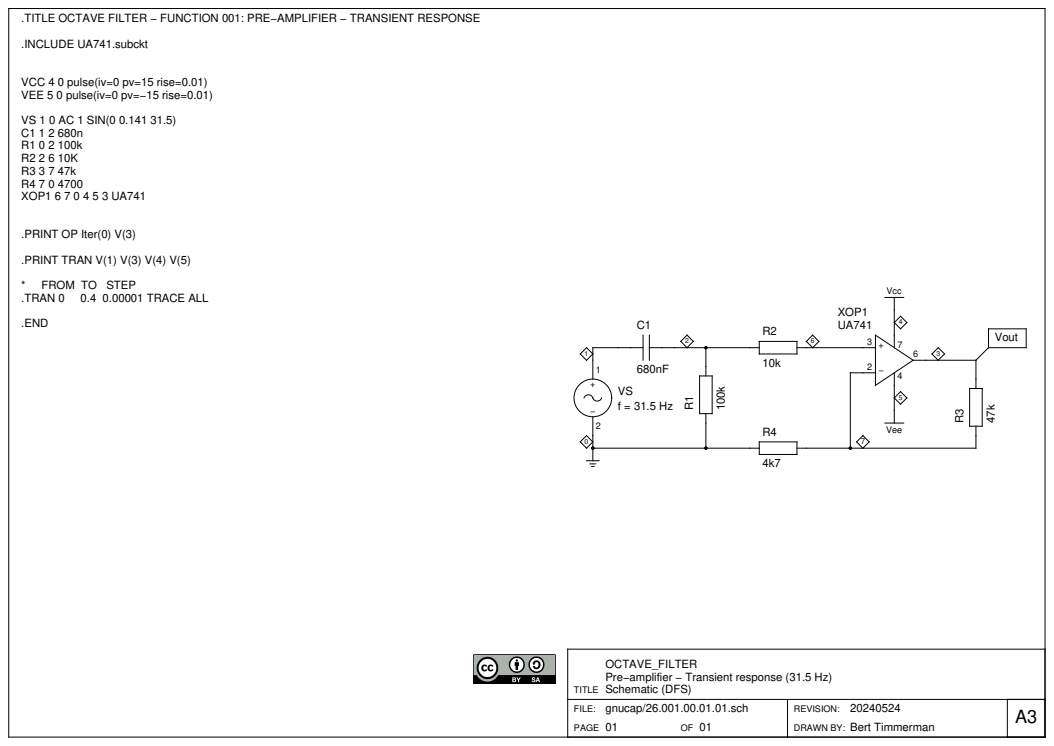
[picture p366: page 5]
Bert Timmerman gnucap/26.001.00.01.01.sch 01; VSf = 31.5 Hz; .INCLUDE UA741.subckt; VS 1 0 AC 1 SIN(0 0.141 31.5) C1 1 2 680n R1 0 2 100k R2 2 6 10K R3 3 7 47k R4 7 0 4700 XOP1 6 7 0 4 5 3 UA741; .PRINT TRAN V(1) V(3) V(4) V(5); FROM TO STEP; .TRAN 0; 0.4 0.00001 TRACE ALL

.TITLE OCTAVE FILTER − FUNCTION 001: PRE−AMPLIFIER − TRANSIENT RESPONSE

VCC 4 0 pulse(iv=0 pv=15 rise=0.01)
VEE 5 0 pulse(iv=0 pv=−15 rise=0.01)

.PRINT OP Iter(0) V(3)

OCTAVE_FILTER
Pre−amplifier − Transient response (31.5 Hz)
Schematic (DFS)

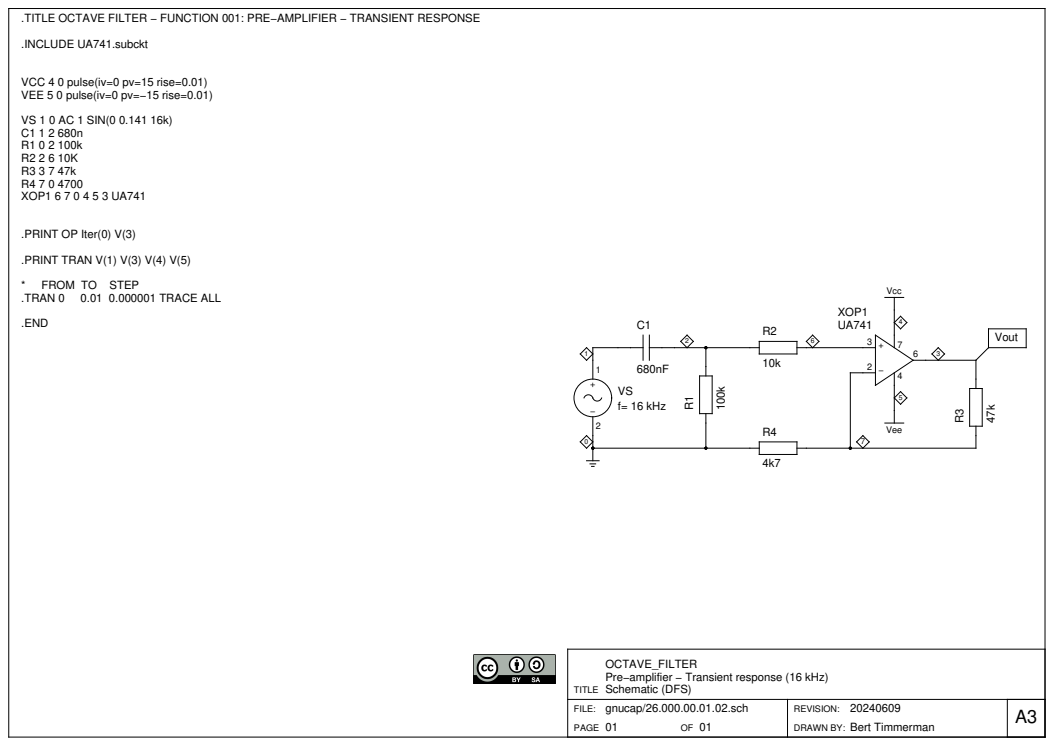
[picture p367: page 6]
Bert Timmerman gnucap/26.000.00.01.02.sch 01; VSf= 16 kHz; .INCLUDE UA741.subckt; VS 1 0 AC 1 SIN(0 0.141 16k) C1 1 2 680n R1 0 2 100k R2 2 6 10K R3 3 7 47k R4 7 0 4700 XOP1 6 7 0 4 5 3 UA741; .PRINT TRAN V(1) V(3) V(4) V(5); FROM TO STEP; .TRAN 0; 0.01 0.000001 TRACE ALL

.TITLE OCTAVE FILTER − FUNCTION 001: PRE−AMPLIFIER − TRANSIENT RESPONSE

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

.PRINT OP Iter(0) V(3)

OCTAVE_FILTER
Pre−amplifier − Transient response (16 kHz)
Schematic (DFS)

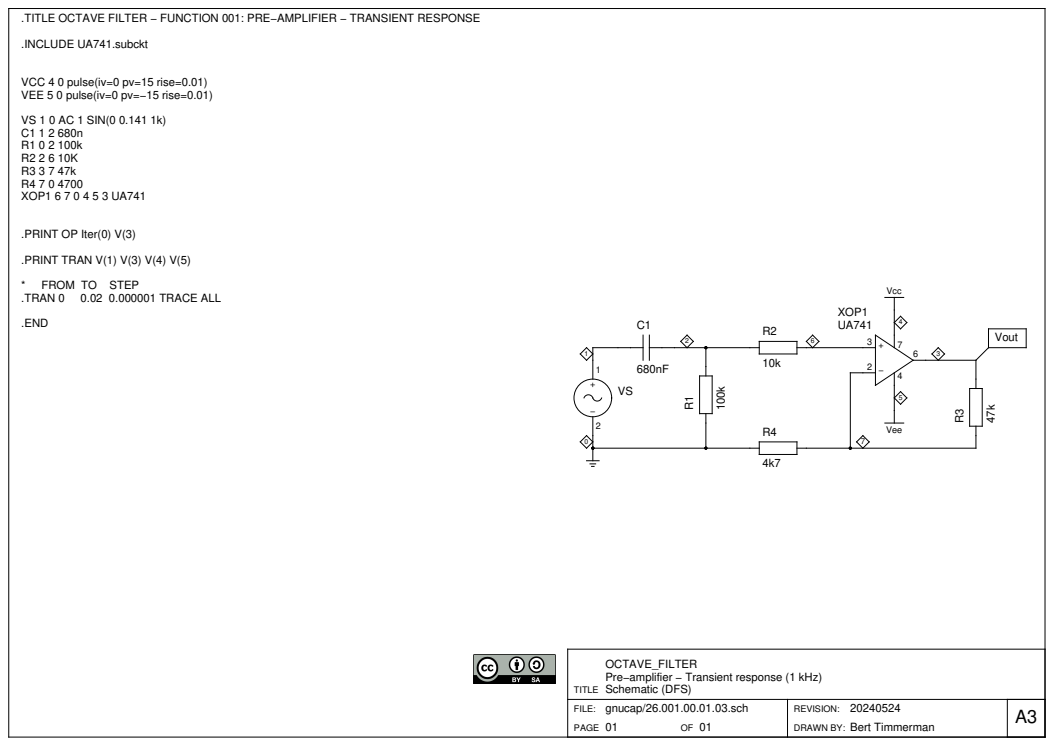
[picture p368: page 7]
Bert Timmerman gnucap/26.001.00.01.03.sch 01; .INCLUDE UA741.subckt; VS 1 0 AC 1 SIN(0 0.141 1k) C1 1 2 680n R1 0 2 100k R2 2 6 10K R3 3 7 47k R4 7 0 4700 XOP1 6 7 0 4 5 3 UA741; .PRINT TRAN V(1) V(3) V(4) V(5); FROM TO STEP; .TRAN 0; 0.02 0.000001 TRACE ALL

.TITLE OCTAVE FILTER − FUNCTION 001: PRE−AMPLIFIER − TRANSIENT RESPONSE

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

.PRINT OP Iter(0) V(3)

OCTAVE_FILTER
Pre−amplifier − Transient response (1 kHz)
Schematic (DFS)

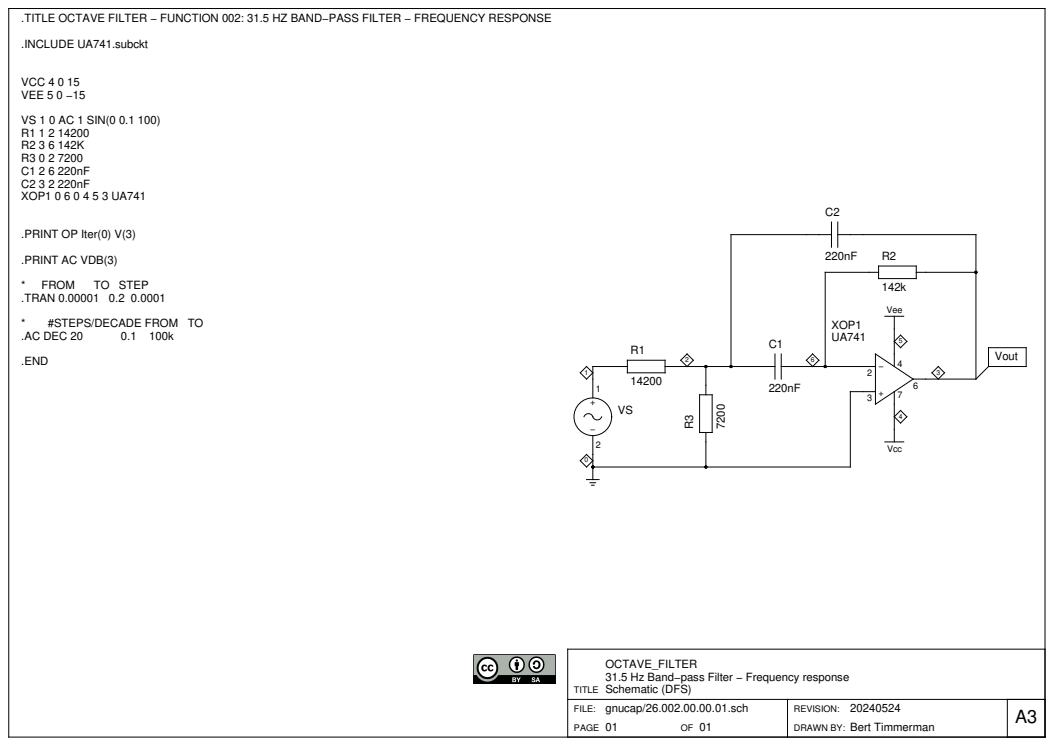
[picture p369: page 8]
Bert Timmerman gnucap/26.002.00.00.01.sch 01; .INCLUDE UA741.subckt; VCC 4 0 15 VEE 5 0 −15; VS 1 0 AC 1 SIN(0 0.1 100) R1 1 2 14200 R2 3 6 142K R3 0 2 7200 C1 2 6 220nF C2 3 2 220nF XOP1 0 6 0 4 5 3 UA741; FROM; TO STEP; .TRAN 0.00001 0.2 0.0001; #STEPS/DECADE FROM TO; .AC DEC 20

.TITLE OCTAVE FILTER − FUNCTION 002: 31.5 HZ BAND−PASS FILTER − FREQUENCY RESPONSE

.PRINT OP Iter(0) V(3)

.PRINT AC VDB(3)

OCTAVE_FILTER
31.5 Hz Band−pass Filter − Frequency response
Schematic (DFS)

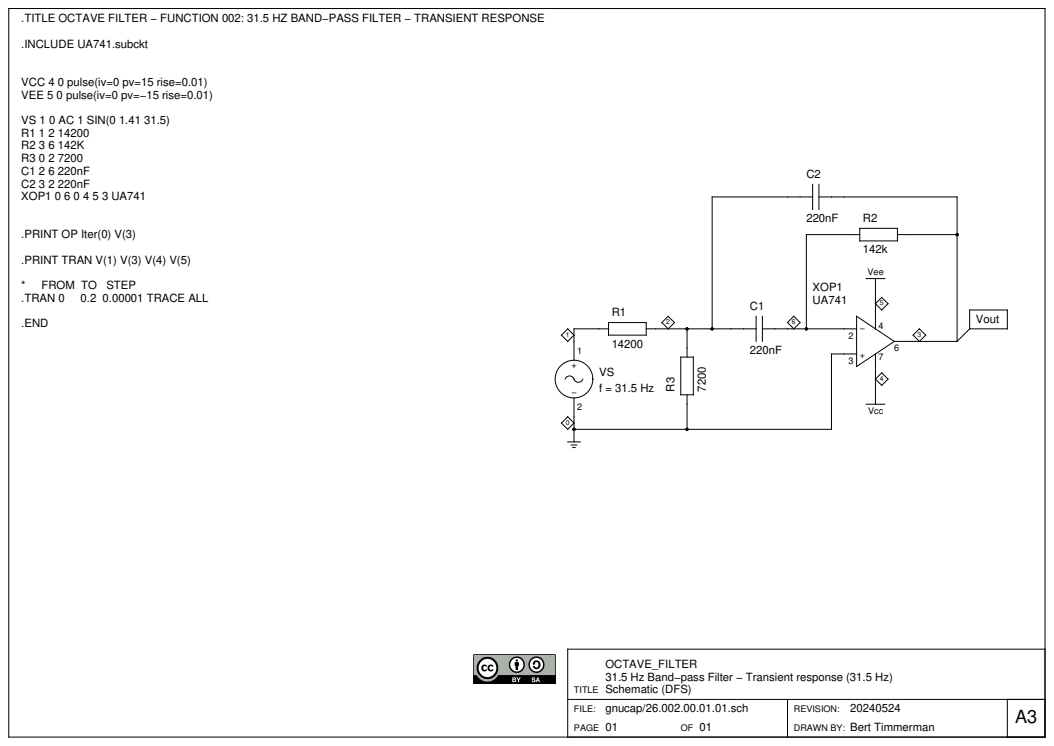
[picture p370: page 9]
Bert Timmerman gnucap/26.002.00.01.01.sch 01; VSf = 31.5 Hz; .INCLUDE UA741.subckt; VS 1 0 AC 1 SIN(0 1.41 31.5) R1 1 2 14200 R2 3 6 142K R3 0 2 7200 C1 2 6 220nF C2 3 2 220nF XOP1 0 6 0 4 5 3 UA741; .PRINT TRAN V(1) V(3) V(4) V(5); FROM TO STEP; .TRAN 0; 0.2 0.00001 TRACE ALL

.TITLE OCTAVE FILTER − FUNCTION 002: 31.5 HZ BAND−PASS FILTER − TRANSIENT RESPONSE

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

.PRINT OP Iter(0) V(3)

OCTAVE_FILTER
31.5 Hz Band−pass Filter − Transient response (31.5 Hz)
Schematic (DFS)

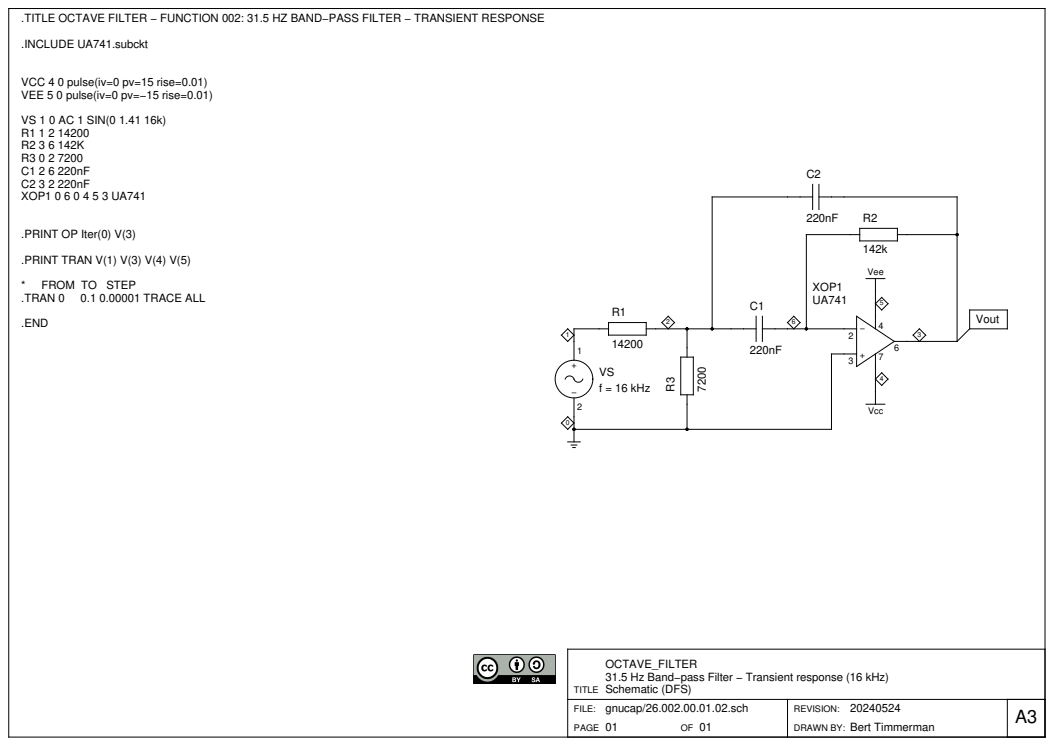
[picture p371: page 10]
Bert Timmerman gnucap/26.002.00.01.02.sch 01; VSf = 16 kHz; .INCLUDE UA741.subckt; VS 1 0 AC 1 SIN(0 1.41 16k) R1 1 2 14200 R2 3 6 142K R3 0 2 7200 C1 2 6 220nF C2 3 2 220nF XOP1 0 6 0 4 5 3 UA741; .PRINT TRAN V(1) V(3) V(4) V(5); FROM TO STEP; .TRAN 0; 0.1 0.00001 TRACE ALL

.TITLE OCTAVE FILTER − FUNCTION 002: 31.5 HZ BAND−PASS FILTER − TRANSIENT RESPONSE

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

.PRINT OP Iter(0) V(3)

OCTAVE_FILTER
31.5 Hz Band−pass Filter − Transient response (16 kHz)
Schematic (DFS)

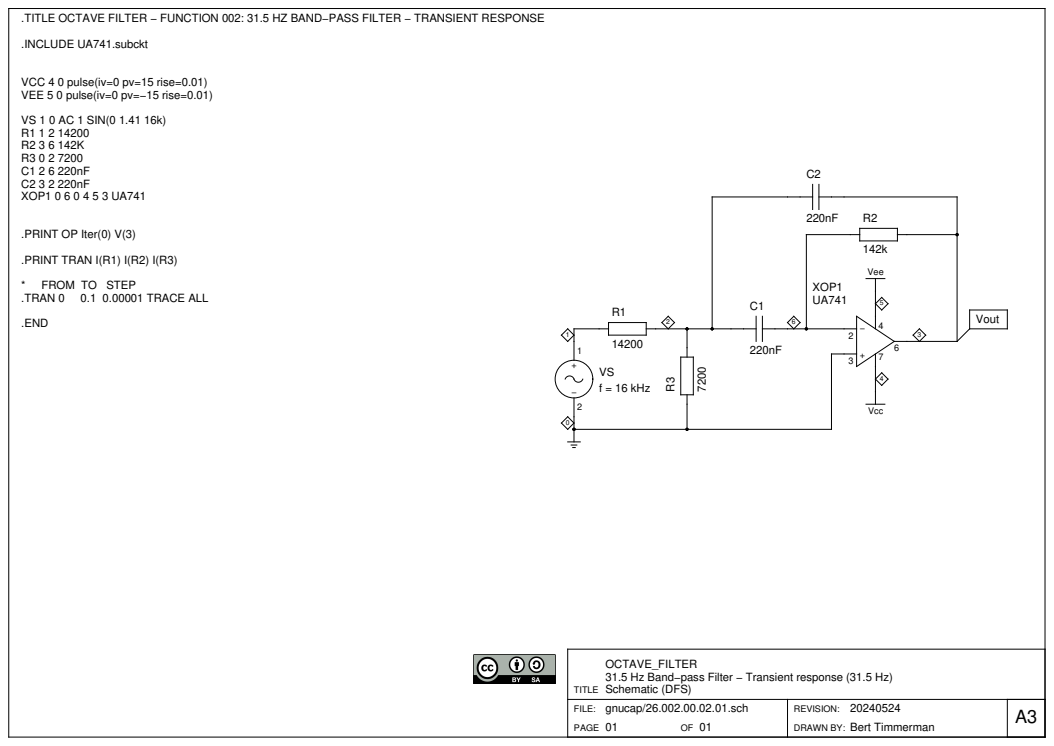
[picture p372: page 11]
Bert Timmerman gnucap/26.002.00.02.01.sch 01; VSf = 16 kHz; .INCLUDE UA741.subckt; VS 1 0 AC 1 SIN(0 1.41 16k) R1 1 2 14200 R2 3 6 142K R3 0 2 7200 C1 2 6 220nF C2 3 2 220nF XOP1 0 6 0 4 5 3 UA741; .PRINT TRAN I(R1) I(R2) I(R3); FROM TO STEP; .TRAN 0; 0.1 0.00001 TRACE ALL

.TITLE OCTAVE FILTER − FUNCTION 002: 31.5 HZ BAND−PASS FILTER − TRANSIENT RESPONSE

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

.PRINT OP Iter(0) V(3)

OCTAVE_FILTER
31.5 Hz Band−pass Filter − Transient response (31.5 Hz)
Schematic (DFS)

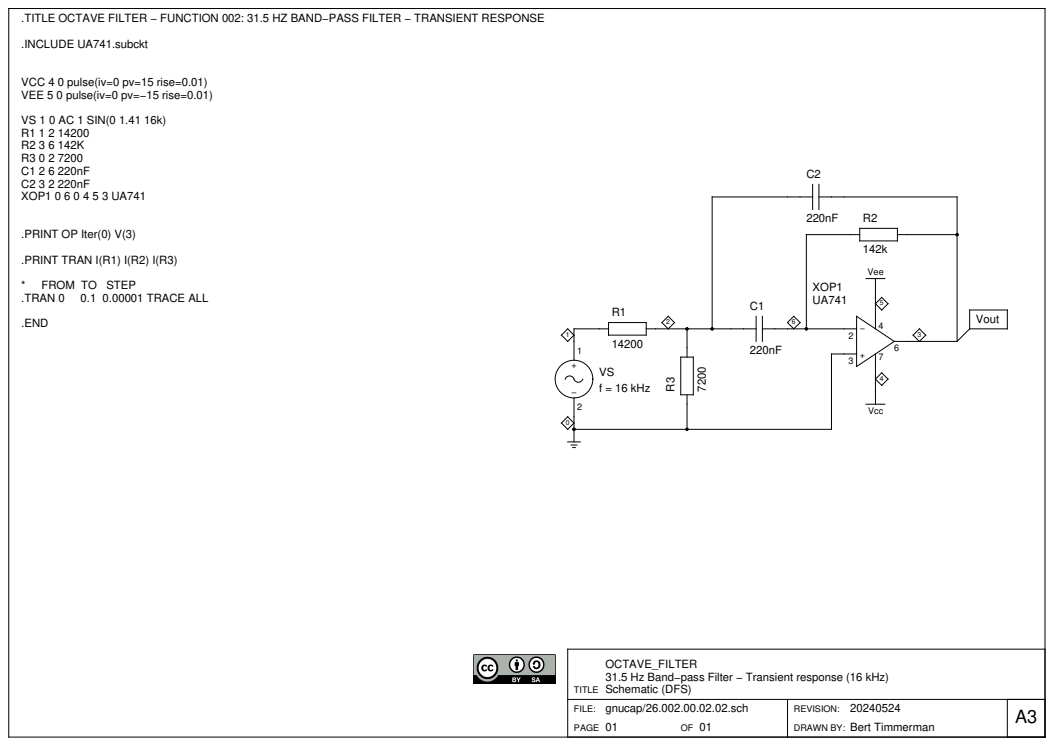
[picture p373: page 12]
Bert Timmerman gnucap/26.002.00.02.02.sch 01; VSf = 16 kHz; .INCLUDE UA741.subckt; VS 1 0 AC 1 SIN(0 1.41 16k) R1 1 2 14200 R2 3 6 142K R3 0 2 7200 C1 2 6 220nF C2 3 2 220nF XOP1 0 6 0 4 5 3 UA741; .PRINT TRAN I(R1) I(R2) I(R3); FROM TO STEP; .TRAN 0; 0.1 0.00001 TRACE ALL

.TITLE OCTAVE FILTER − FUNCTION 002: 31.5 HZ BAND−PASS FILTER − TRANSIENT RESPONSE

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

.PRINT OP Iter(0) V(3)

OCTAVE_FILTER
31.5 Hz Band−pass Filter − Transient response (16 kHz)
Schematic (DFS)

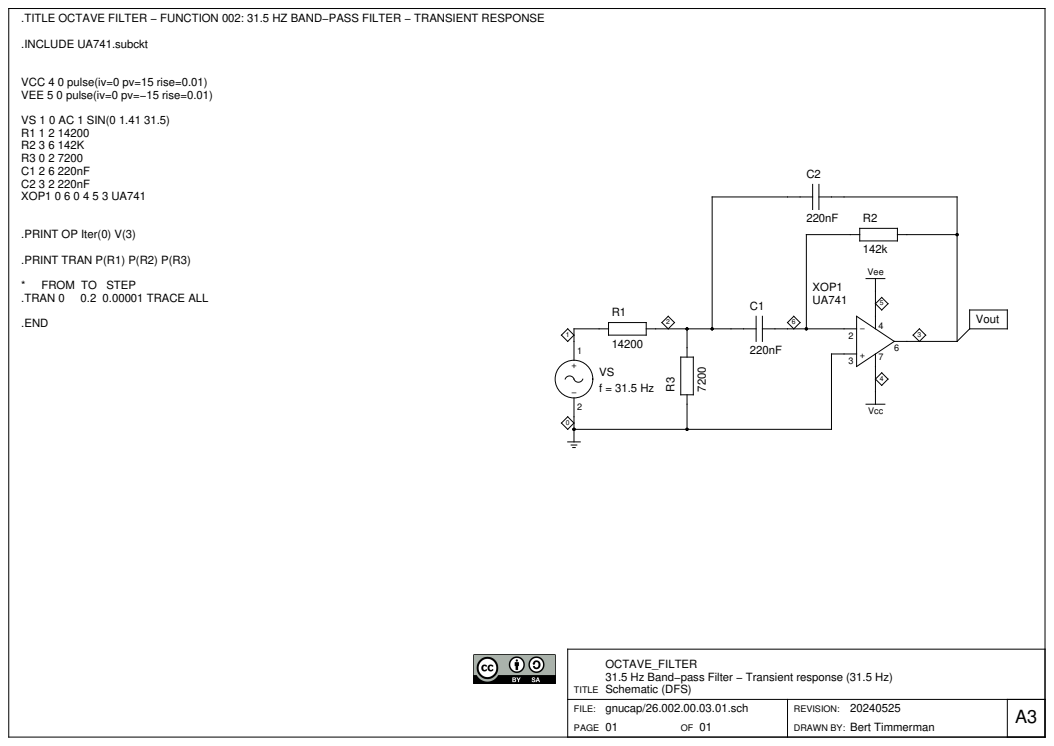
[picture p374: page 13]
Bert Timmerman gnucap/26.002.00.03.01.sch 01; VSf = 31.5 Hz; .INCLUDE UA741.subckt; VS 1 0 AC 1 SIN(0 1.41 31.5) R1 1 2 14200 R2 3 6 142K R3 0 2 7200 C1 2 6 220nF C2 3 2 220nF XOP1 0 6 0 4 5 3 UA741; .PRINT TRAN P(R1) P(R2) P(R3); FROM TO STEP; .TRAN 0; 0.2 0.00001 TRACE ALL

.TITLE OCTAVE FILTER − FUNCTION 002: 31.5 HZ BAND−PASS FILTER − TRANSIENT RESPONSE

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

.PRINT OP Iter(0) V(3)

OCTAVE_FILTER
31.5 Hz Band−pass Filter − Transient response (31.5 Hz)
Schematic (DFS)

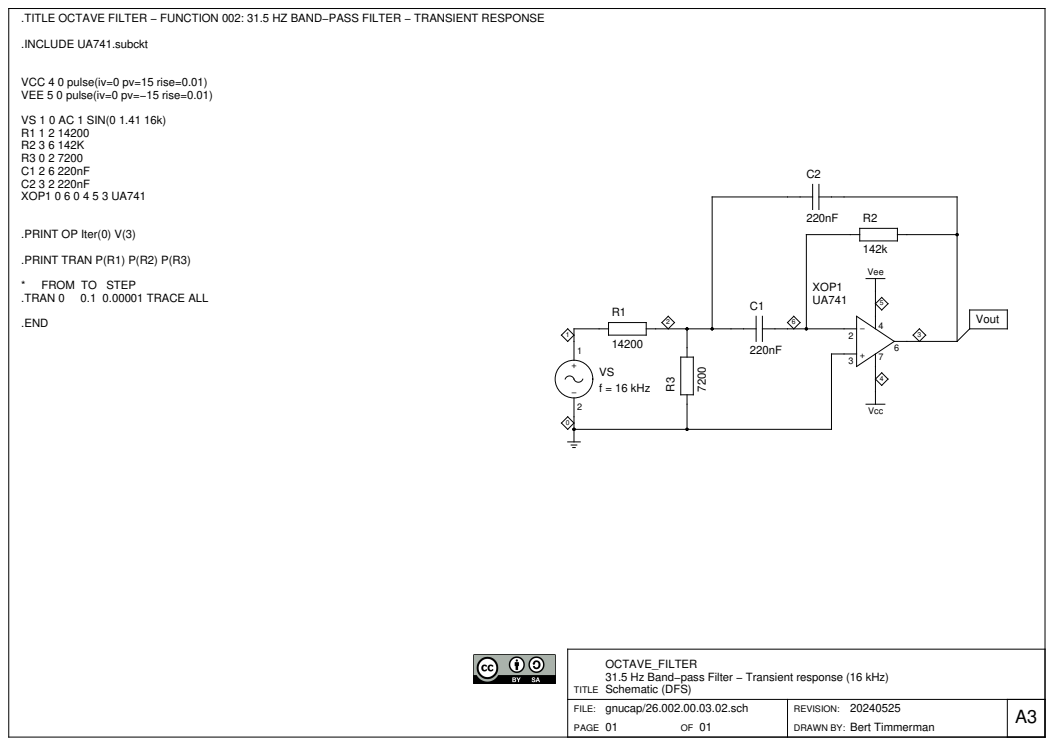
[picture p375: page 14]
Bert Timmerman gnucap/26.002.00.03.02.sch 01; VSf = 16 kHz; .INCLUDE UA741.subckt; VS 1 0 AC 1 SIN(0 1.41 16k) R1 1 2 14200 R2 3 6 142K R3 0 2 7200 C1 2 6 220nF C2 3 2 220nF XOP1 0 6 0 4 5 3 UA741; .PRINT TRAN P(R1) P(R2) P(R3); FROM TO STEP; .TRAN 0; 0.1 0.00001 TRACE ALL

.TITLE OCTAVE FILTER − FUNCTION 002: 31.5 HZ BAND−PASS FILTER − TRANSIENT RESPONSE

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

.PRINT OP Iter(0) V(3)

OCTAVE_FILTER
31.5 Hz Band−pass Filter − Transient response (16 kHz)
Schematic (DFS)

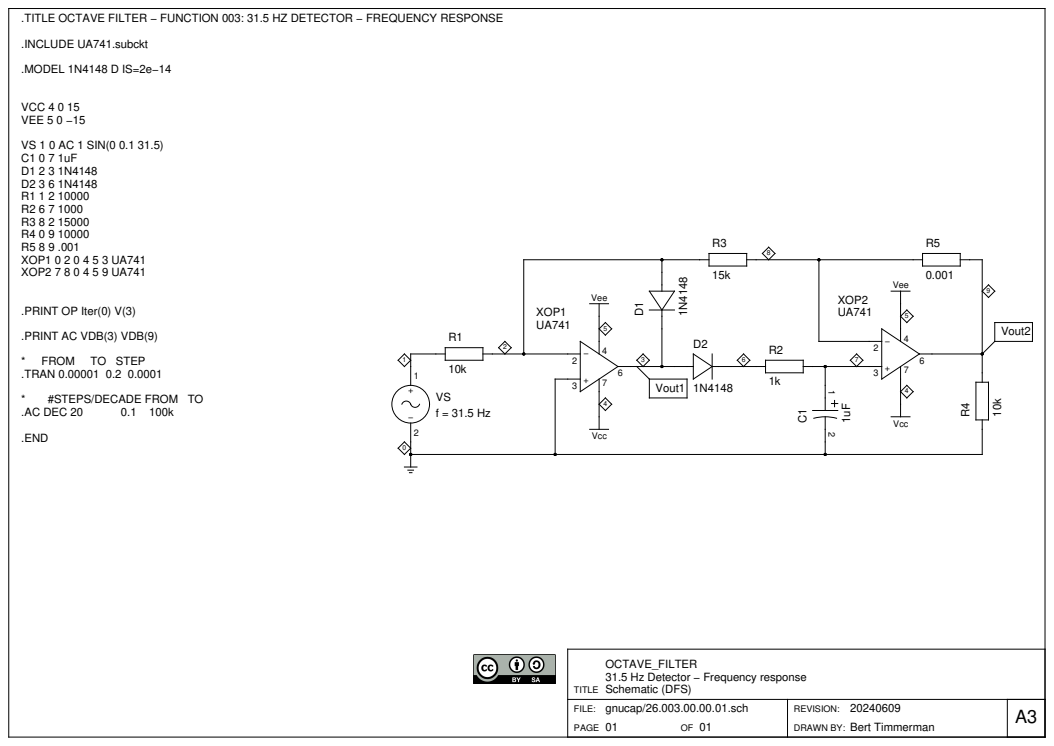
[picture p376: page 15]

.TITLE OCTAVE FILTER − FUNCTION 003: 31.5 HZ DETECTOR − FREQUENCY RESPONSE

.PRINT AC VDB(3) VDB(9)

OCTAVE_FILTER
31.5 Hz Detector − Frequency response
Schematic (DFS)

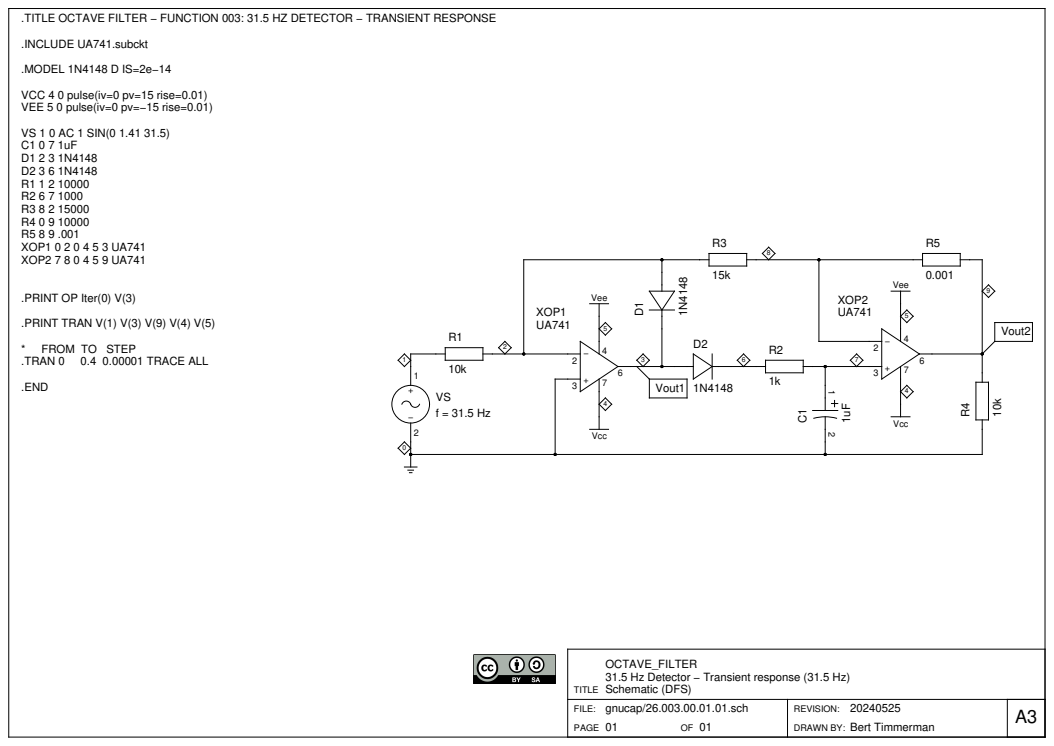
[picture p377: page 16]

.TITLE OCTAVE FILTER − FUNCTION 003: 31.5 HZ DETECTOR − TRANSIENT RESPONSE

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

OCTAVE_FILTER
31.5 Hz Detector − Transient response (31.5 Hz)
Schematic (DFS)

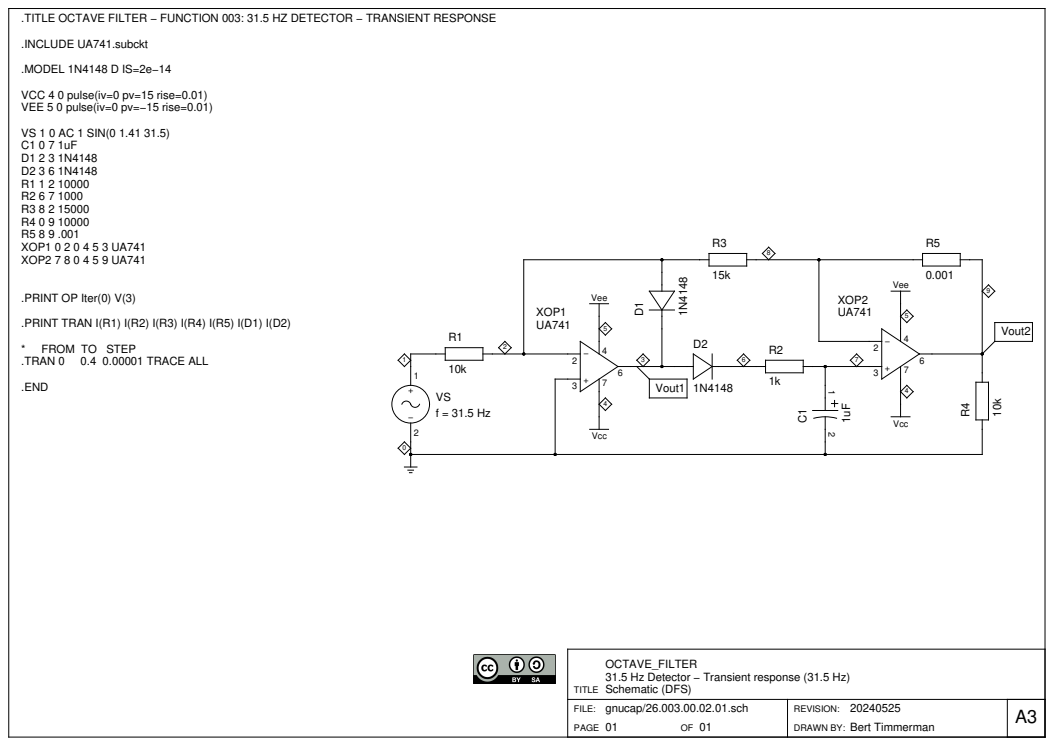
[picture p378: page 17]

.TITLE OCTAVE FILTER − FUNCTION 003: 31.5 HZ DETECTOR − TRANSIENT RESPONSE

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

OCTAVE_FILTER
31.5 Hz Detector − Transient response (31.5 Hz)
Schematic (DFS)

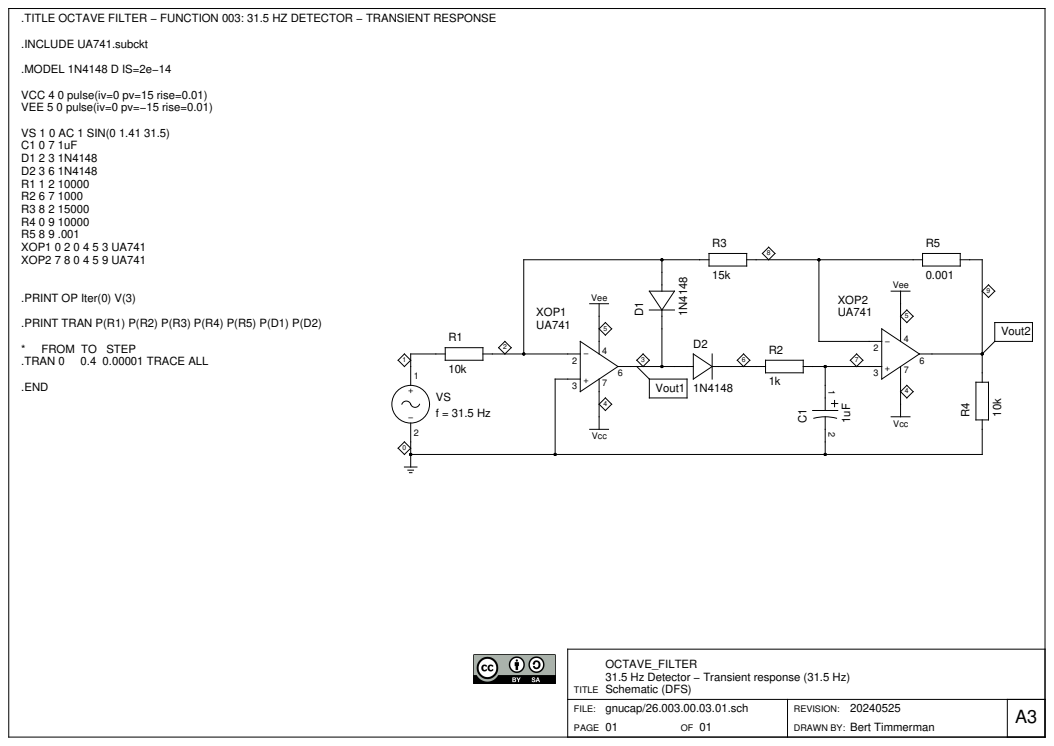
[picture p379: page 18]

.TITLE OCTAVE FILTER − FUNCTION 003: 31.5 HZ DETECTOR − TRANSIENT RESPONSE

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

OCTAVE_FILTER
31.5 Hz Detector − Transient response (31.5 Hz)
Schematic (DFS)

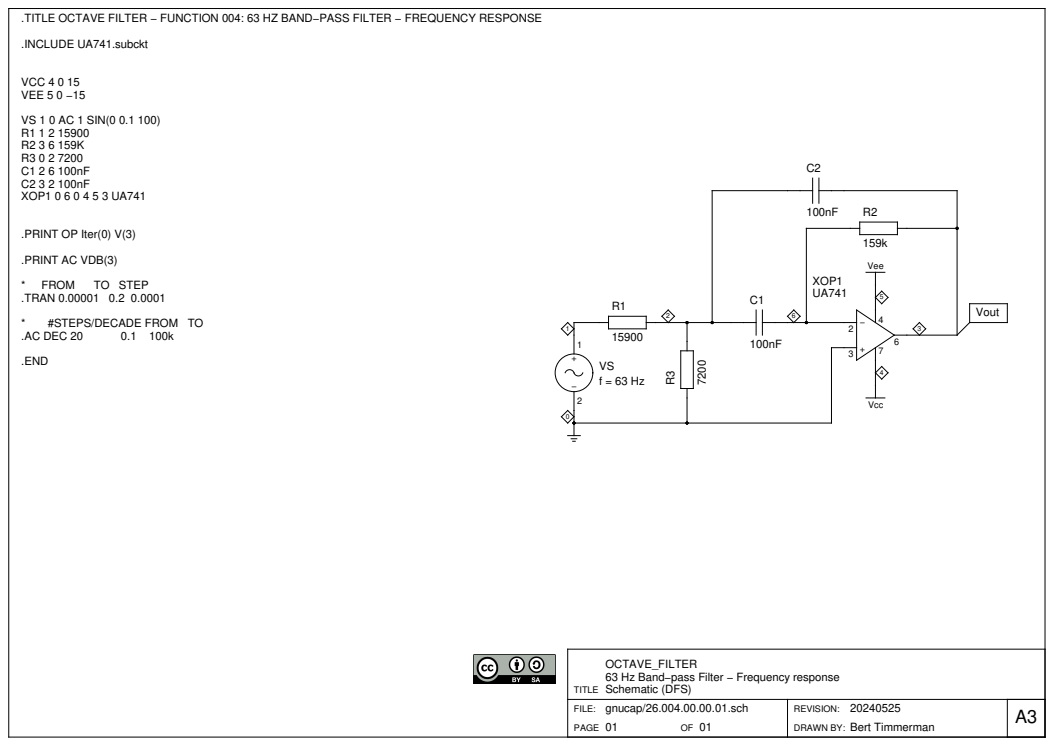
[picture p380: page 19]
Bert Timmerman gnucap/26.004.00.00.01.sch 01; VSf = 63 Hz; .INCLUDE UA741.subckt; VCC 4 0 15 VEE 5 0 −15; VS 1 0 AC 1 SIN(0 0.1 100) R1 1 2 15900 R2 3 6 159K R3 0 2 7200 C1 2 6 100nF C2 3 2 100nF XOP1 0 6 0 4 5 3 UA741; FROM; TO STEP; .TRAN 0.00001 0.2 0.0001; #STEPS/DECADE FROM TO; .AC DEC 20

.TITLE OCTAVE FILTER − FUNCTION 004: 63 HZ BAND−PASS FILTER − FREQUENCY RESPONSE

.PRINT OP Iter(0) V(3)

.PRINT AC VDB(3)

OCTAVE_FILTER
63 Hz Band−pass Filter − Frequency response
Schematic (DFS)

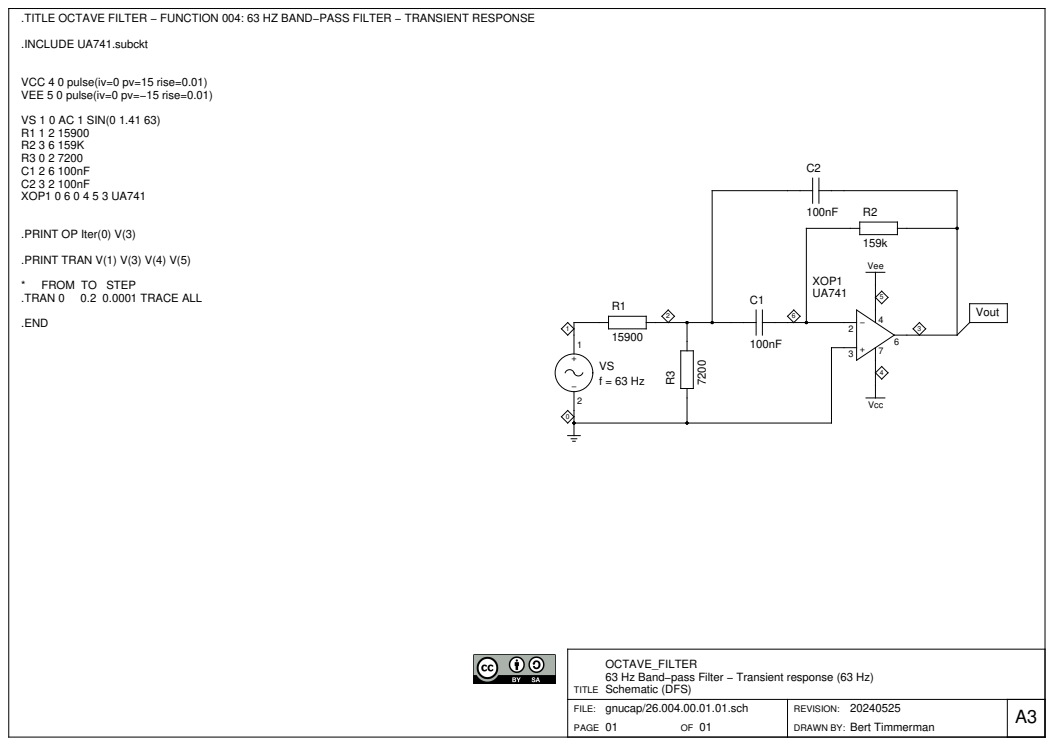
[picture p381: page 20]
Bert Timmerman gnucap/26.004.00.01.01.sch 01; VSf = 63 Hz; .INCLUDE UA741.subckt; VS 1 0 AC 1 SIN(0 1.41 63) R1 1 2 15900 R2 3 6 159K R3 0 2 7200 C1 2 6 100nF C2 3 2 100nF XOP1 0 6 0 4 5 3 UA741; .PRINT TRAN V(1) V(3) V(4) V(5); FROM TO STEP; .TRAN 0; 0.2 0.0001 TRACE ALL

.TITLE OCTAVE FILTER − FUNCTION 004: 63 HZ BAND−PASS FILTER − TRANSIENT RESPONSE

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

.PRINT OP Iter(0) V(3)

OCTAVE_FILTER
63 Hz Band−pass Filter − Transient response (63 Hz)
Schematic (DFS)

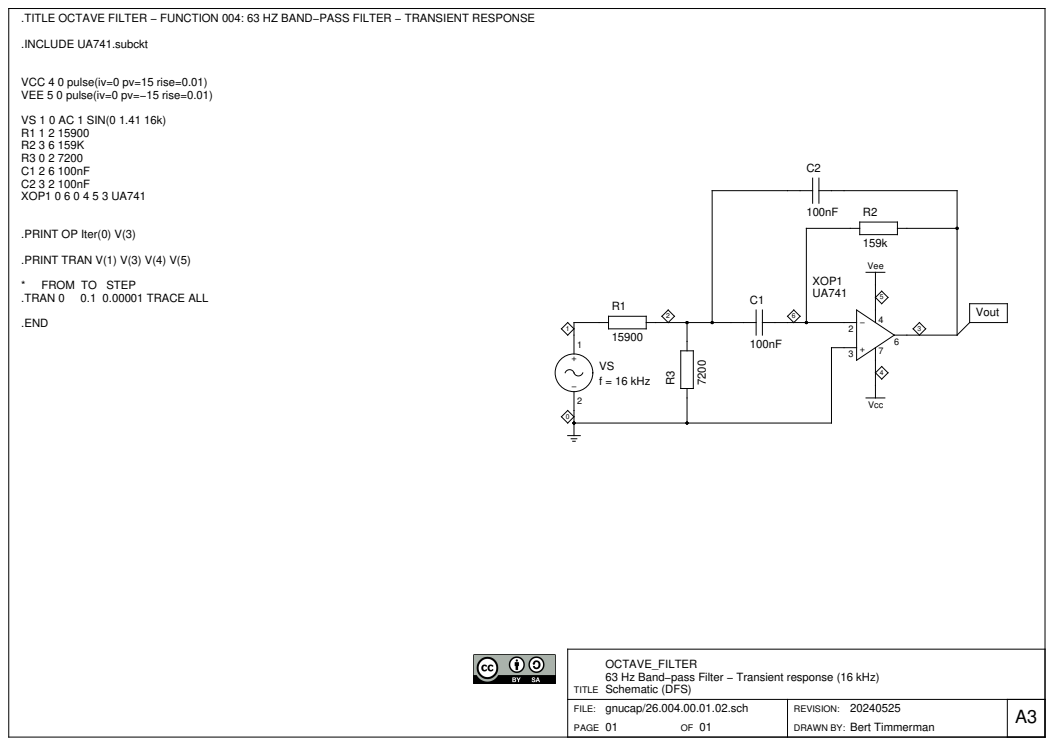
[picture p382: page 21]
Bert Timmerman gnucap/26.004.00.01.02.sch 01; VSf = 16 kHz; .INCLUDE UA741.subckt; VS 1 0 AC 1 SIN(0 1.41 16k) R1 1 2 15900 R2 3 6 159K R3 0 2 7200 C1 2 6 100nF C2 3 2 100nF XOP1 0 6 0 4 5 3 UA741; .PRINT TRAN V(1) V(3) V(4) V(5); FROM TO STEP; .TRAN 0; 0.1 0.00001 TRACE ALL

.TITLE OCTAVE FILTER − FUNCTION 004: 63 HZ BAND−PASS FILTER − TRANSIENT RESPONSE

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

.PRINT OP Iter(0) V(3)

OCTAVE_FILTER
63 Hz Band−pass Filter − Transient response (16 kHz)
Schematic (DFS)

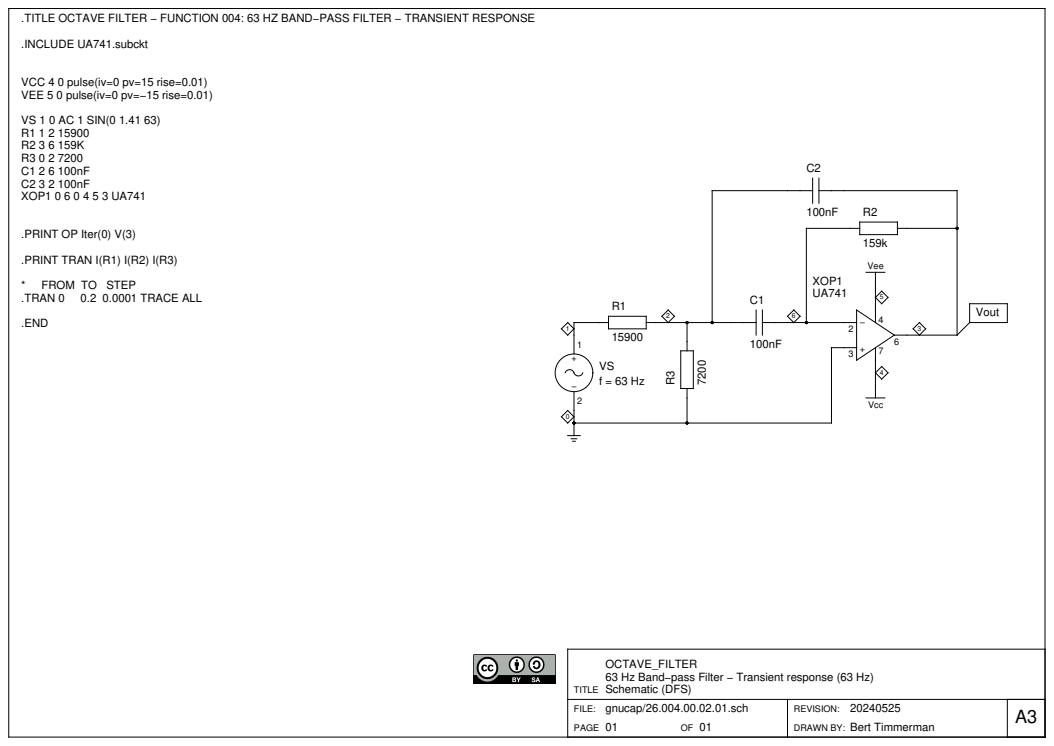
[picture p383: page 22]
Bert Timmerman gnucap/26.004.00.02.01.sch 01; VSf = 63 Hz; .INCLUDE UA741.subckt; VS 1 0 AC 1 SIN(0 1.41 63) R1 1 2 15900 R2 3 6 159K R3 0 2 7200 C1 2 6 100nF C2 3 2 100nF XOP1 0 6 0 4 5 3 UA741; .PRINT TRAN I(R1) I(R2) I(R3); FROM TO STEP; .TRAN 0; 0.2 0.0001 TRACE ALL

.TITLE OCTAVE FILTER − FUNCTION 004: 63 HZ BAND−PASS FILTER − TRANSIENT RESPONSE

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

.PRINT OP Iter(0) V(3)

OCTAVE_FILTER
63 Hz Band−pass Filter − Transient response (63 Hz)
Schematic (DFS)

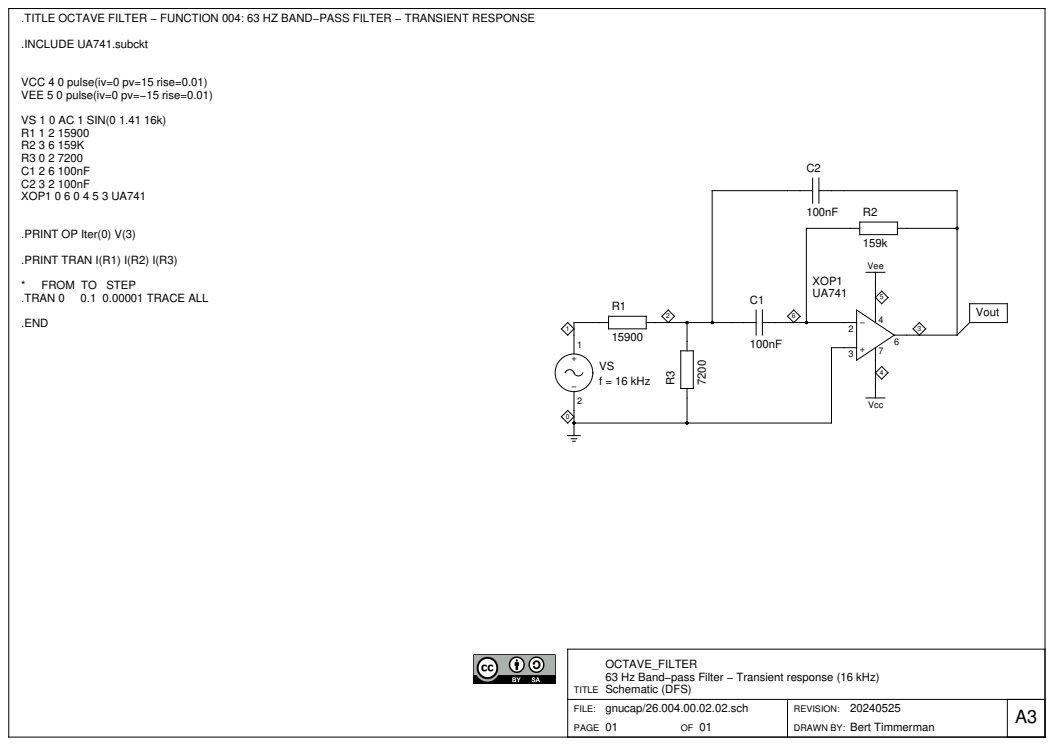
[picture p384: page 23]
Bert Timmerman gnucap/26.004.00.02.02.sch 01; VSf = 16 kHz; .INCLUDE UA741.subckt; VS 1 0 AC 1 SIN(0 1.41 16k) R1 1 2 15900 R2 3 6 159K R3 0 2 7200 C1 2 6 100nF C2 3 2 100nF XOP1 0 6 0 4 5 3 UA741; .PRINT TRAN I(R1) I(R2) I(R3); FROM TO STEP; .TRAN 0; 0.1 0.00001 TRACE ALL

.TITLE OCTAVE FILTER − FUNCTION 004: 63 HZ BAND−PASS FILTER − TRANSIENT RESPONSE

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

.PRINT OP Iter(0) V(3)

OCTAVE_FILTER
63 Hz Band−pass Filter − Transient response (16 kHz)
Schematic (DFS)

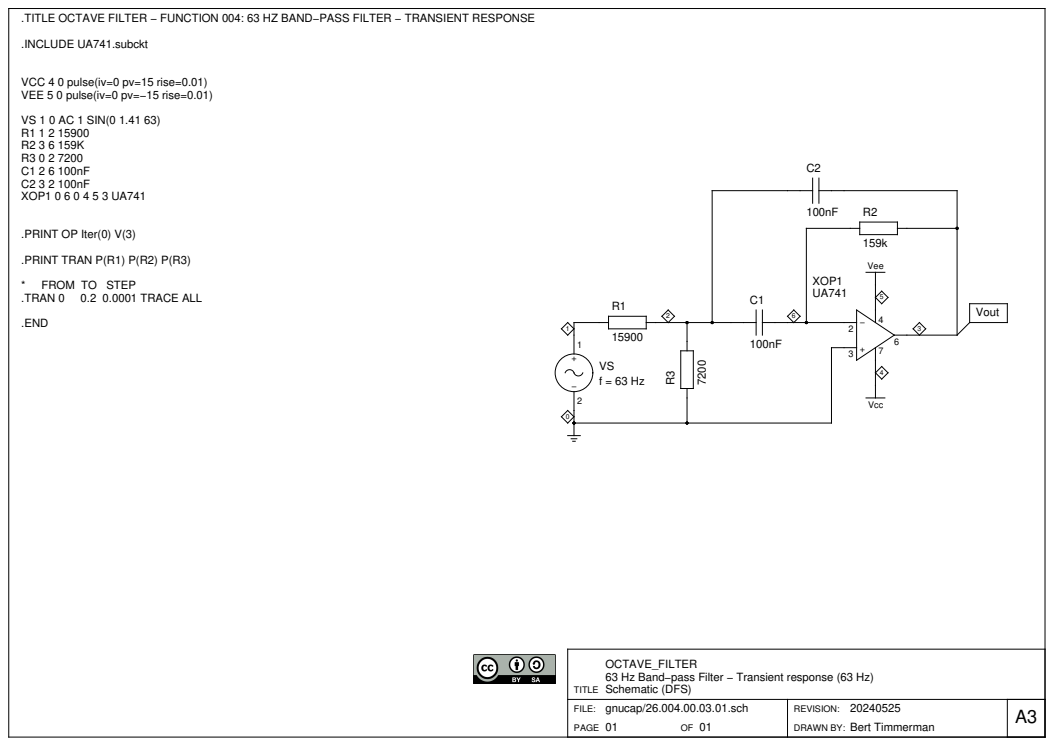
[picture p385: page 24]
Bert Timmerman gnucap/26.004.00.03.01.sch 01; VSf = 63 Hz; .INCLUDE UA741.subckt; VS 1 0 AC 1 SIN(0 1.41 63) R1 1 2 15900 R2 3 6 159K R3 0 2 7200 C1 2 6 100nF C2 3 2 100nF XOP1 0 6 0 4 5 3 UA741; .PRINT TRAN P(R1) P(R2) P(R3); FROM TO STEP; .TRAN 0; 0.2 0.0001 TRACE ALL

.TITLE OCTAVE FILTER − FUNCTION 004: 63 HZ BAND−PASS FILTER − TRANSIENT RESPONSE

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

.PRINT OP Iter(0) V(3)

OCTAVE_FILTER
63 Hz Band−pass Filter − Transient response (63 Hz)
Schematic (DFS)

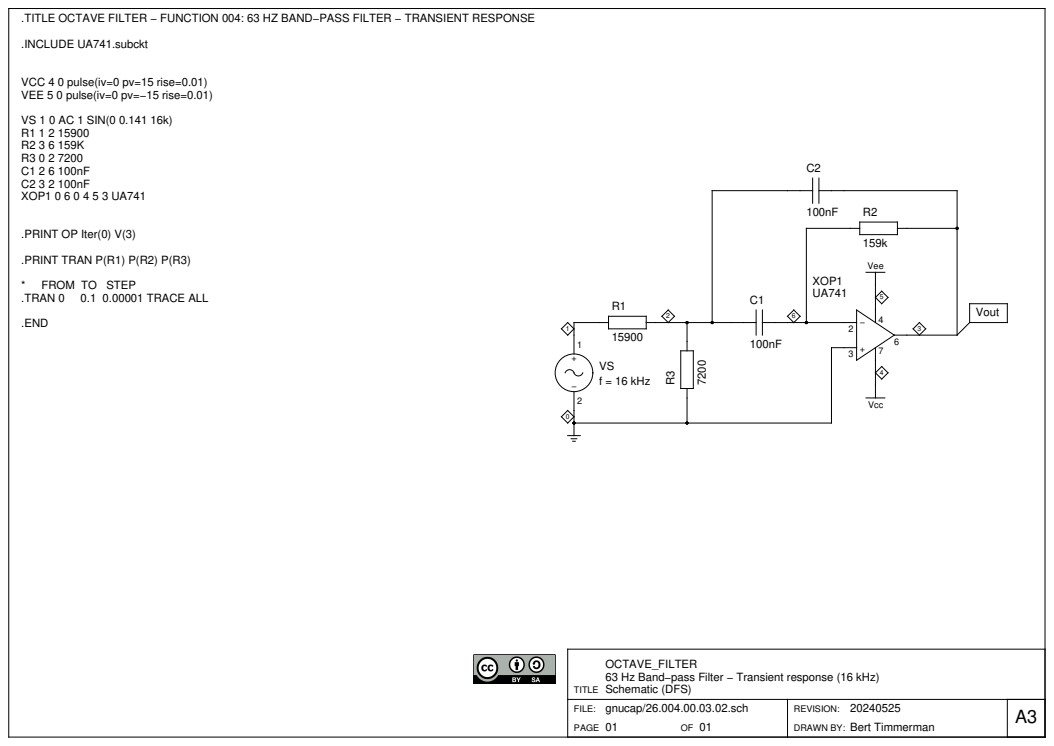
[picture p386: page 25]
Bert Timmerman gnucap/26.004.00.03.02.sch 01; VSf = 16 kHz; .INCLUDE UA741.subckt; VS 1 0 AC 1 SIN(0 0.141 16k) R1 1 2 15900 R2 3 6 159K R3 0 2 7200 C1 2 6 100nF C2 3 2 100nF XOP1 0 6 0 4 5 3 UA741; .PRINT TRAN P(R1) P(R2) P(R3); FROM TO STEP; .TRAN 0; 0.1 0.00001 TRACE ALL

.TITLE OCTAVE FILTER − FUNCTION 004: 63 HZ BAND−PASS FILTER − TRANSIENT RESPONSE

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

.PRINT OP Iter(0) V(3)

OCTAVE_FILTER
63 Hz Band−pass Filter − Transient response (16 kHz)
Schematic (DFS)

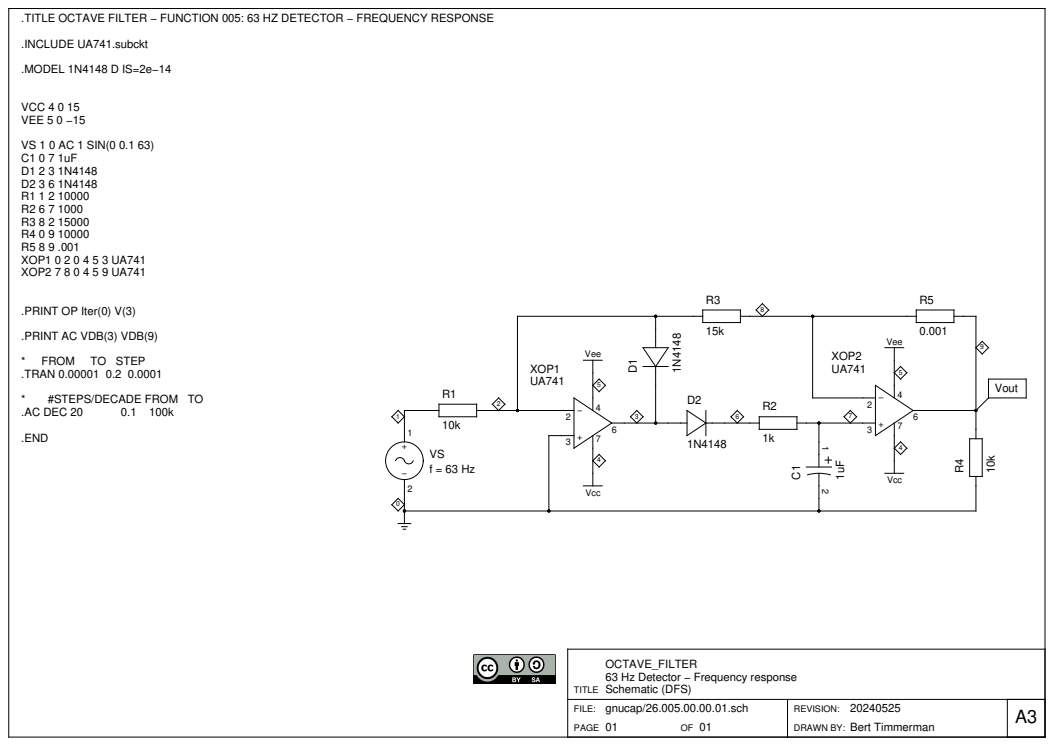
[picture p387: page 26]

.TITLE OCTAVE FILTER − FUNCTION 005: 63 HZ DETECTOR − FREQUENCY RESPONSE

.PRINT AC VDB(3) VDB(9)

OCTAVE_FILTER
63 Hz Detector − Frequency response
Schematic (DFS)

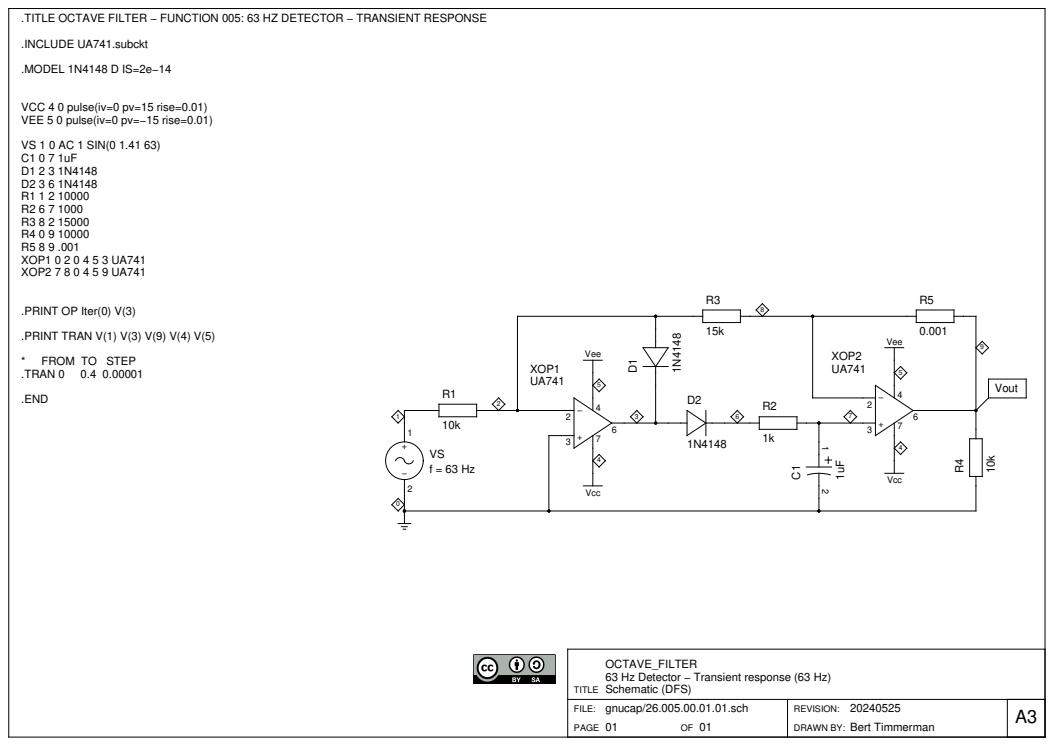
[picture p388: page 27]

.TITLE OCTAVE FILTER − FUNCTION 005: 63 HZ DETECTOR − TRANSIENT RESPONSE

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

OCTAVE_FILTER
63 Hz Detector − Transient response (63 Hz)
Schematic (DFS)

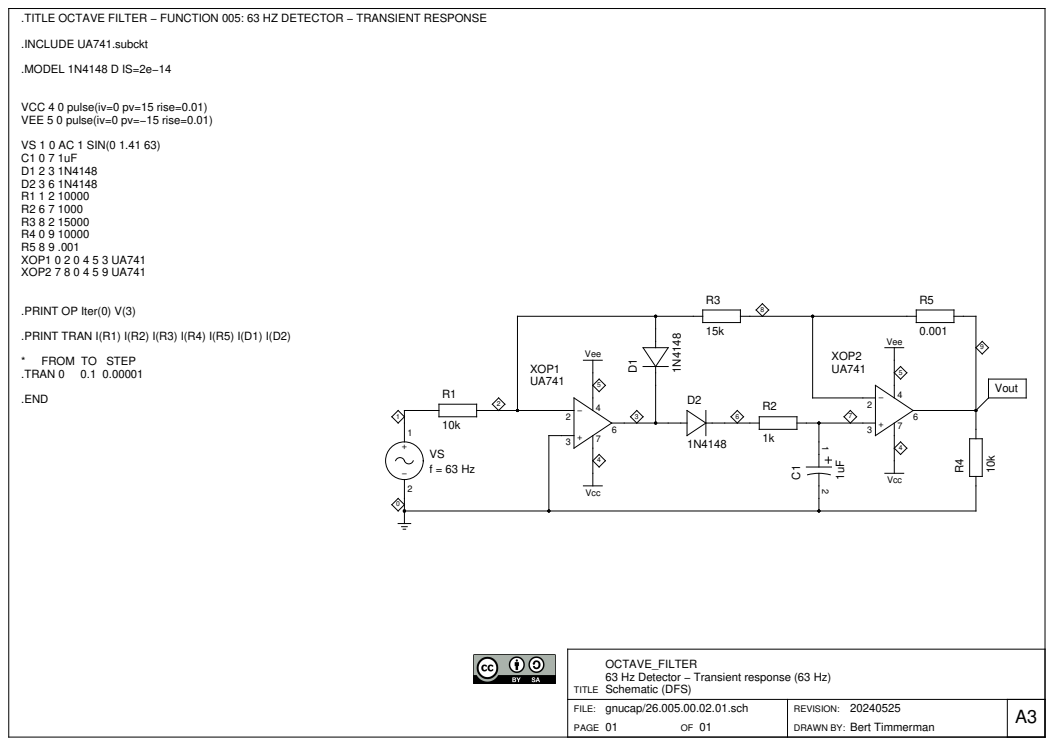
[picture p389: page 28]

.TITLE OCTAVE FILTER − FUNCTION 005: 63 HZ DETECTOR − TRANSIENT RESPONSE

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

OCTAVE_FILTER
63 Hz Detector − Transient response (63 Hz)
Schematic (DFS)

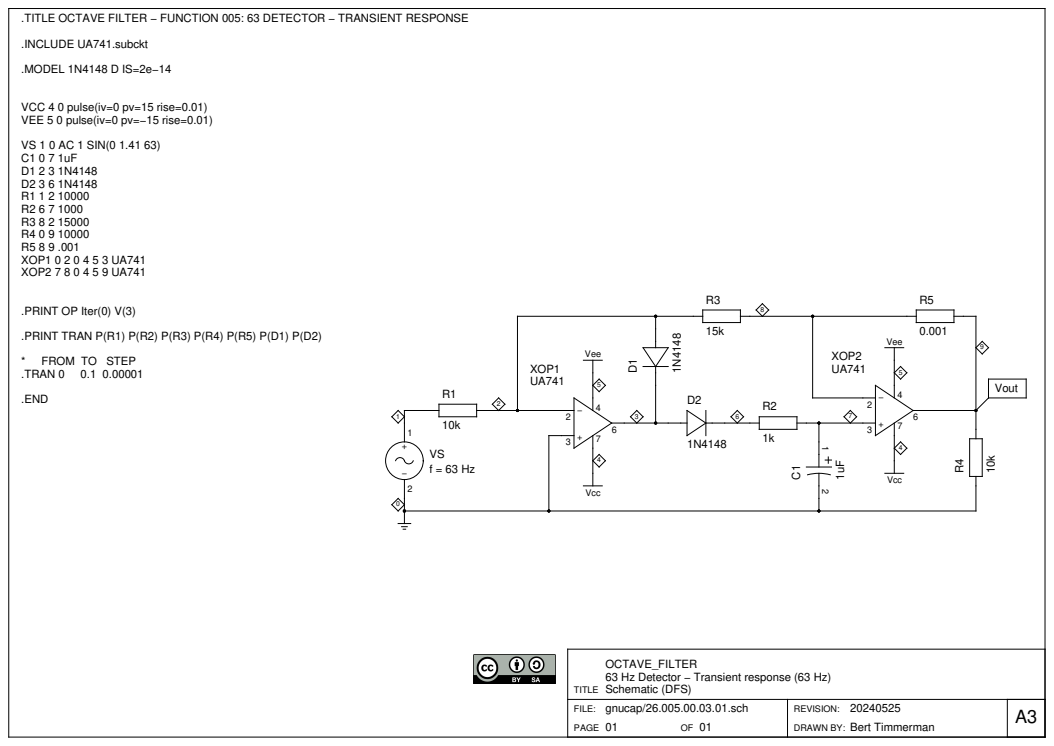
[picture p390: page 29]

.TITLE OCTAVE FILTER − FUNCTION 005: 63 DETECTOR − TRANSIENT RESPONSE

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

OCTAVE_FILTER
63 Hz Detector − Transient response (63 Hz)
Schematic (DFS)

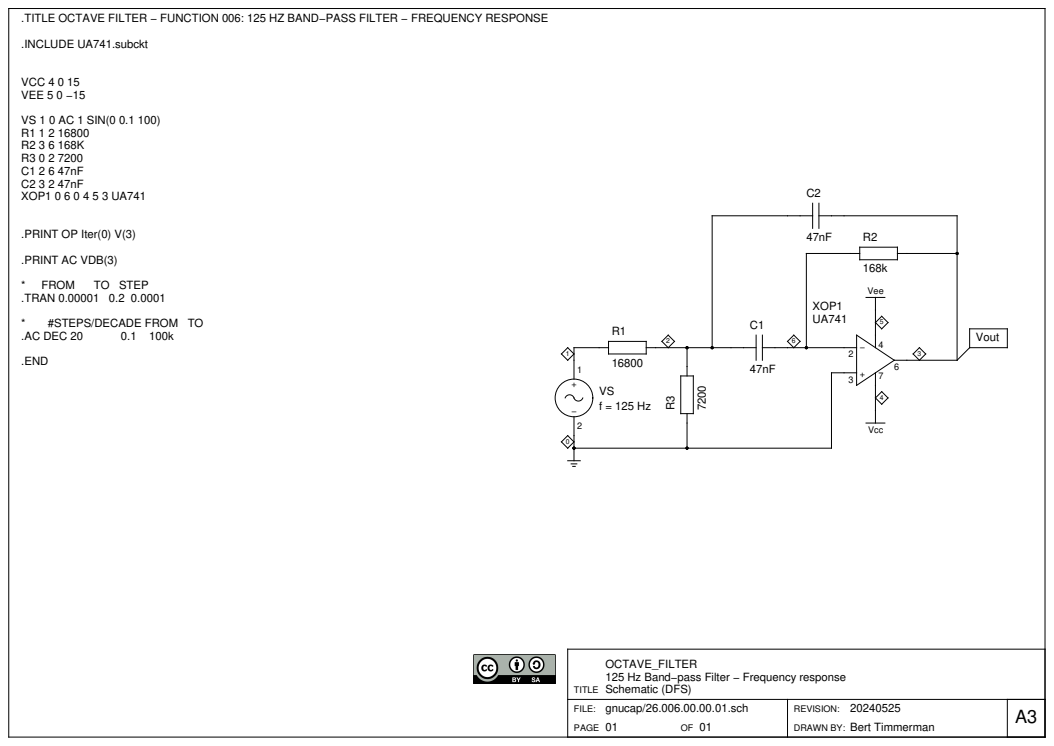
[picture p391: page 30]
Bert Timmerman gnucap/26.006.00.00.01.sch 01; .INCLUDE UA741.subckt; VCC 4 0 15 VEE 5 0 −15; VS 1 0 AC 1 SIN(0 0.1 100) R1 1 2 16800 R2 3 6 168K R3 0 2 7200 C1 2 6 47nF C2 3 2 47nF XOP1 0 6 0 4 5 3 UA741; FROM; TO STEP; .TRAN 0.00001 0.2 0.0001; #STEPS/DECADE FROM TO; .AC DEC 20; VSf = 125 Hz

.TITLE OCTAVE FILTER − FUNCTION 006: 125 HZ BAND−PASS FILTER − FREQUENCY RESPONSE

.PRINT OP Iter(0) V(3)

.PRINT AC VDB(3)

OCTAVE_FILTER
125 Hz Band−pass Filter − Frequency response
Schematic (DFS)

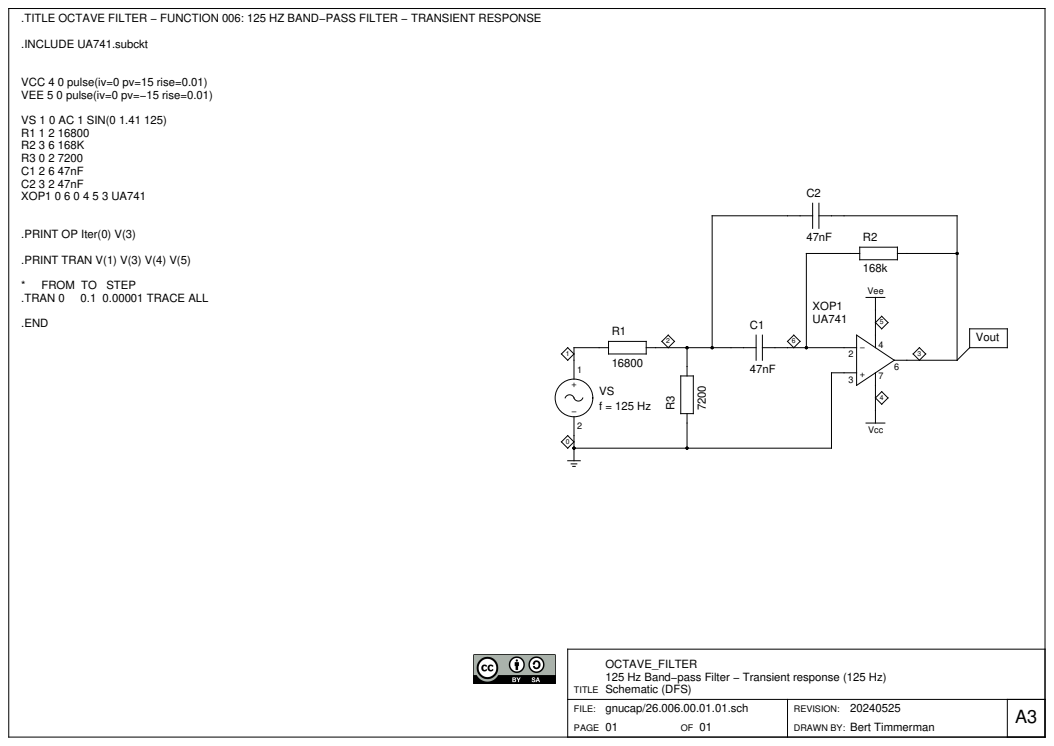
[picture p392: page 31]
Bert Timmerman gnucap/26.006.00.01.01.sch 01; .INCLUDE UA741.subckt; VS 1 0 AC 1 SIN(0 1.41 125) R1 1 2 16800 R2 3 6 168K R3 0 2 7200 C1 2 6 47nF C2 3 2 47nF XOP1 0 6 0 4 5 3 UA741; .PRINT TRAN V(1) V(3) V(4) V(5); FROM TO STEP; .TRAN 0; 0.1 0.00001 TRACE ALL; VSf = 125 Hz

.TITLE OCTAVE FILTER − FUNCTION 006: 125 HZ BAND−PASS FILTER − TRANSIENT RESPONSE

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

.PRINT OP Iter(0) V(3)

OCTAVE_FILTER
125 Hz Band−pass Filter − Transient response (125 Hz)
Schematic (DFS)

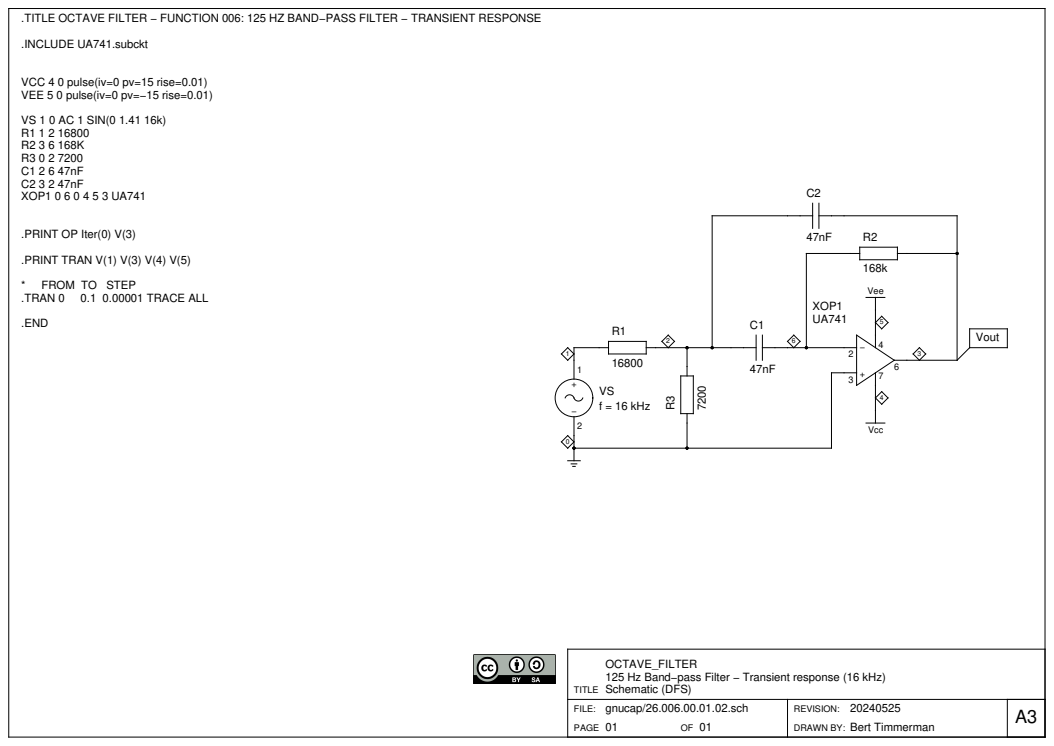
[picture p393: page 32]
Bert Timmerman gnucap/26.006.00.01.02.sch 01; .INCLUDE UA741.subckt; VS 1 0 AC 1 SIN(0 1.41 16k) R1 1 2 16800 R2 3 6 168K R3 0 2 7200 C1 2 6 47nF C2 3 2 47nF XOP1 0 6 0 4 5 3 UA741; .PRINT TRAN V(1) V(3) V(4) V(5); FROM TO STEP; .TRAN 0; 0.1 0.00001 TRACE ALL; VSf = 16 kHz

.TITLE OCTAVE FILTER − FUNCTION 006: 125 HZ BAND−PASS FILTER − TRANSIENT RESPONSE

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

.PRINT OP Iter(0) V(3)

OCTAVE_FILTER
125 Hz Band−pass Filter − Transient response (16 kHz)
Schematic (DFS)

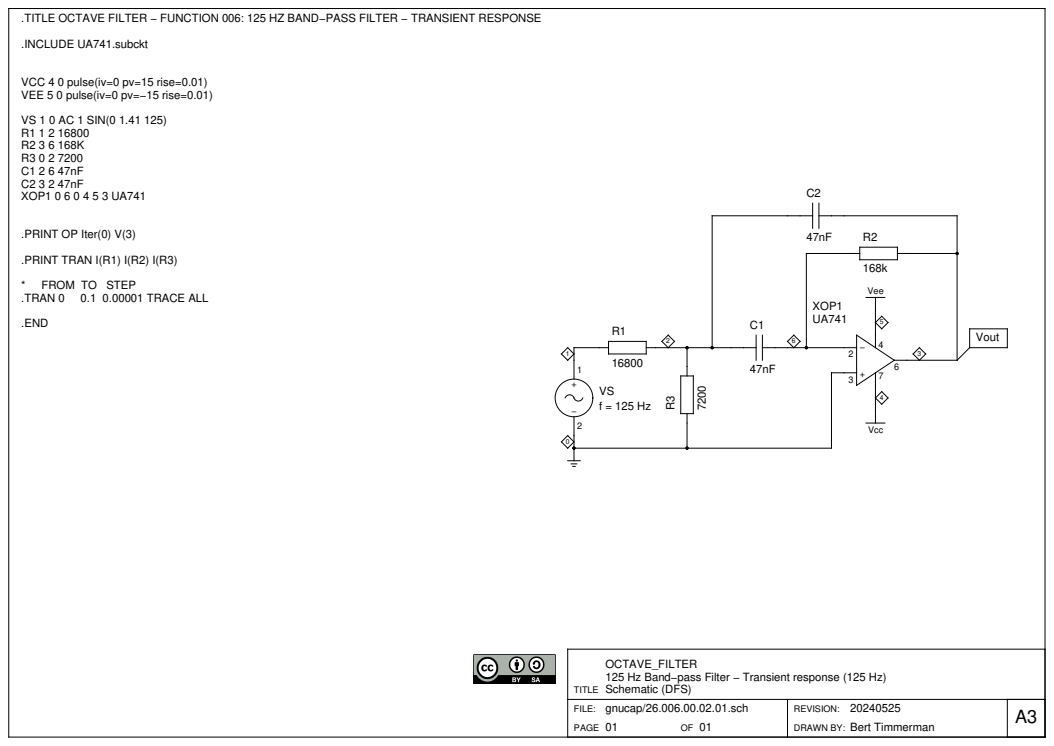
[picture p394: page 33]
Bert Timmerman gnucap/26.006.00.02.01.sch 01; .INCLUDE UA741.subckt; VS 1 0 AC 1 SIN(0 1.41 125) R1 1 2 16800 R2 3 6 168K R3 0 2 7200 C1 2 6 47nF C2 3 2 47nF XOP1 0 6 0 4 5 3 UA741; .PRINT TRAN I(R1) I(R2) I(R3); FROM TO STEP; .TRAN 0; 0.1 0.00001 TRACE ALL; VSf = 125 Hz

.TITLE OCTAVE FILTER − FUNCTION 006: 125 HZ BAND−PASS FILTER − TRANSIENT RESPONSE

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

.PRINT OP Iter(0) V(3)

OCTAVE_FILTER
125 Hz Band−pass Filter − Transient response (125 Hz)
Schematic (DFS)

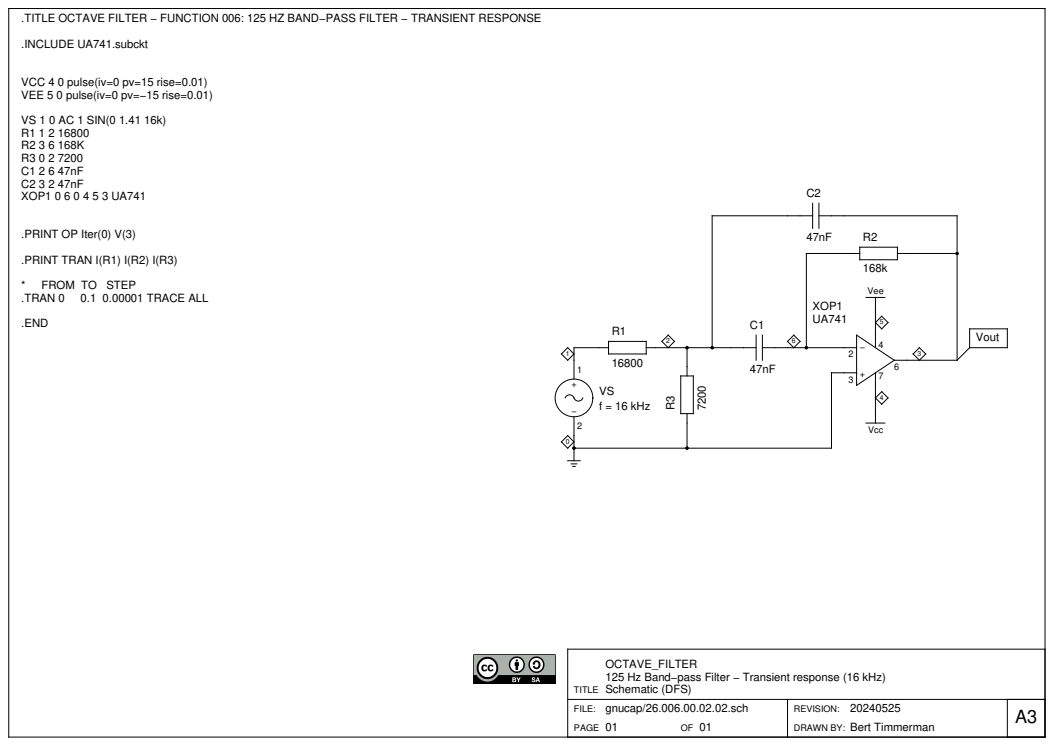
[picture p395: page 34]
Bert Timmerman gnucap/26.006.00.02.02.sch 01; .INCLUDE UA741.subckt; VS 1 0 AC 1 SIN(0 1.41 16k) R1 1 2 16800 R2 3 6 168K R3 0 2 7200 C1 2 6 47nF C2 3 2 47nF XOP1 0 6 0 4 5 3 UA741; .PRINT TRAN I(R1) I(R2) I(R3); FROM TO STEP; .TRAN 0; 0.1 0.00001 TRACE ALL; VSf = 16 kHz

.TITLE OCTAVE FILTER − FUNCTION 006: 125 HZ BAND−PASS FILTER − TRANSIENT RESPONSE

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

.PRINT OP Iter(0) V(3)

OCTAVE_FILTER
125 Hz Band−pass Filter − Transient response (16 kHz)
Schematic (DFS)

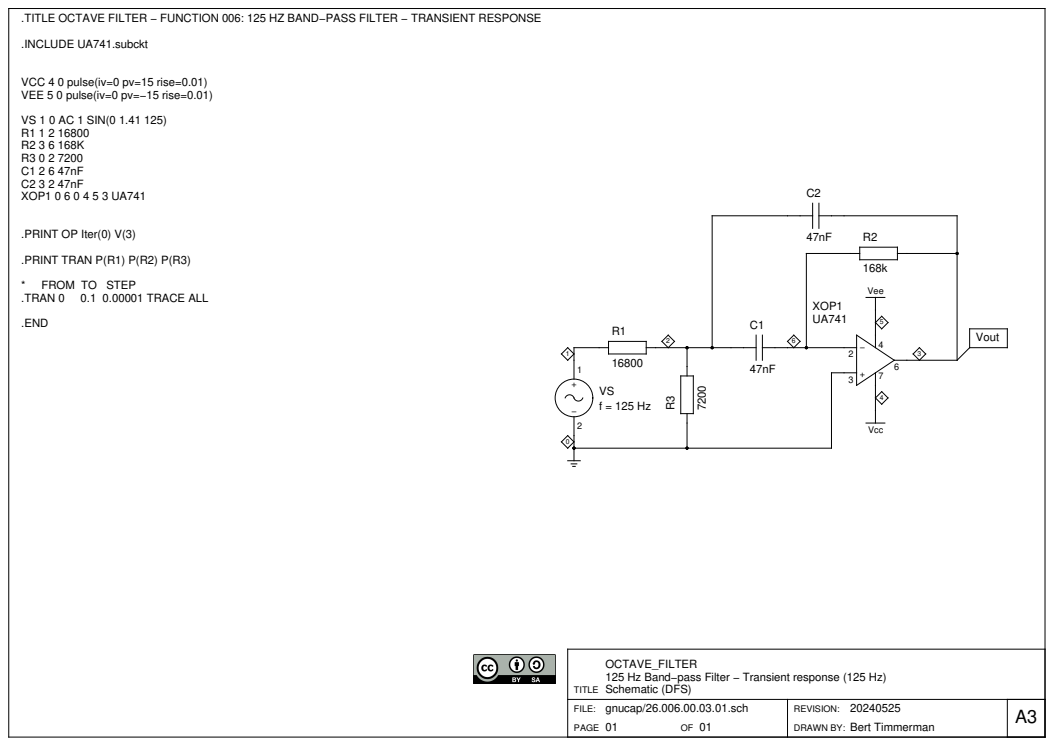
[picture p396: page 35]
Bert Timmerman gnucap/26.006.00.03.01.sch 01; .INCLUDE UA741.subckt; VS 1 0 AC 1 SIN(0 1.41 125) R1 1 2 16800 R2 3 6 168K R3 0 2 7200 C1 2 6 47nF C2 3 2 47nF XOP1 0 6 0 4 5 3 UA741; .PRINT TRAN P(R1) P(R2) P(R3); FROM TO STEP; .TRAN 0; 0.1 0.00001 TRACE ALL; VSf = 125 Hz

.TITLE OCTAVE FILTER − FUNCTION 006: 125 HZ BAND−PASS FILTER − TRANSIENT RESPONSE

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

.PRINT OP Iter(0) V(3)

OCTAVE_FILTER
125 Hz Band−pass Filter − Transient response (125 Hz)
Schematic (DFS)

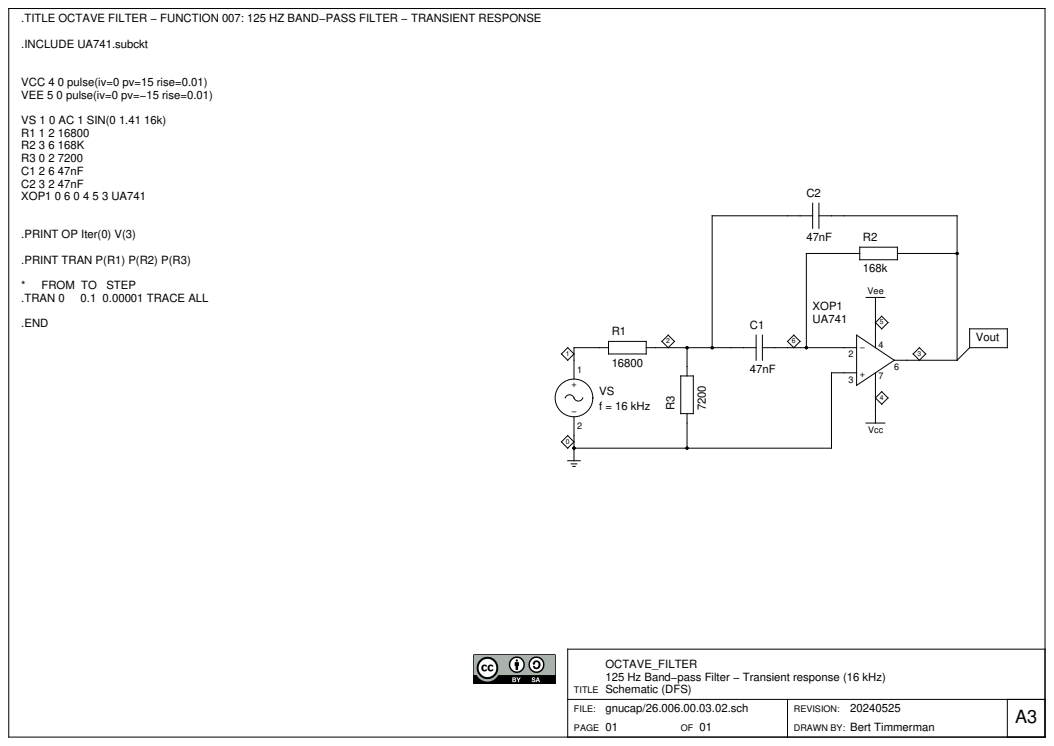
[picture p397: page 36]
Bert Timmerman gnucap/26.006.00.03.02.sch 01; .INCLUDE UA741.subckt; VS 1 0 AC 1 SIN(0 1.41 16k) R1 1 2 16800 R2 3 6 168K R3 0 2 7200 C1 2 6 47nF C2 3 2 47nF XOP1 0 6 0 4 5 3 UA741; .PRINT TRAN P(R1) P(R2) P(R3); FROM TO STEP; .TRAN 0; 0.1 0.00001 TRACE ALL; VSf = 16 kHz

.TITLE OCTAVE FILTER − FUNCTION 007: 125 HZ BAND−PASS FILTER − TRANSIENT RESPONSE

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

.PRINT OP Iter(0) V(3)

OCTAVE_FILTER
125 Hz Band−pass Filter − Transient response (16 kHz)
Schematic (DFS)

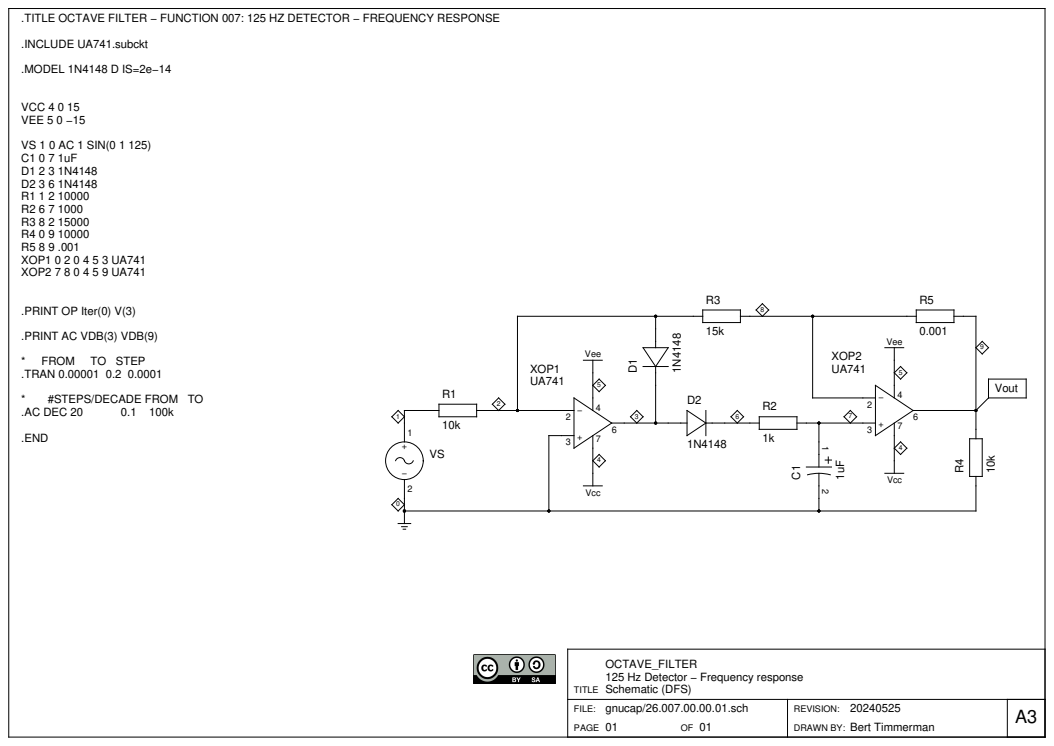
[picture p398: page 37]

.TITLE OCTAVE FILTER − FUNCTION 007: 125 HZ DETECTOR − FREQUENCY RESPONSE

.PRINT AC VDB(3) VDB(9)

OCTAVE_FILTER
125 Hz Detector − Frequency response
Schematic (DFS)

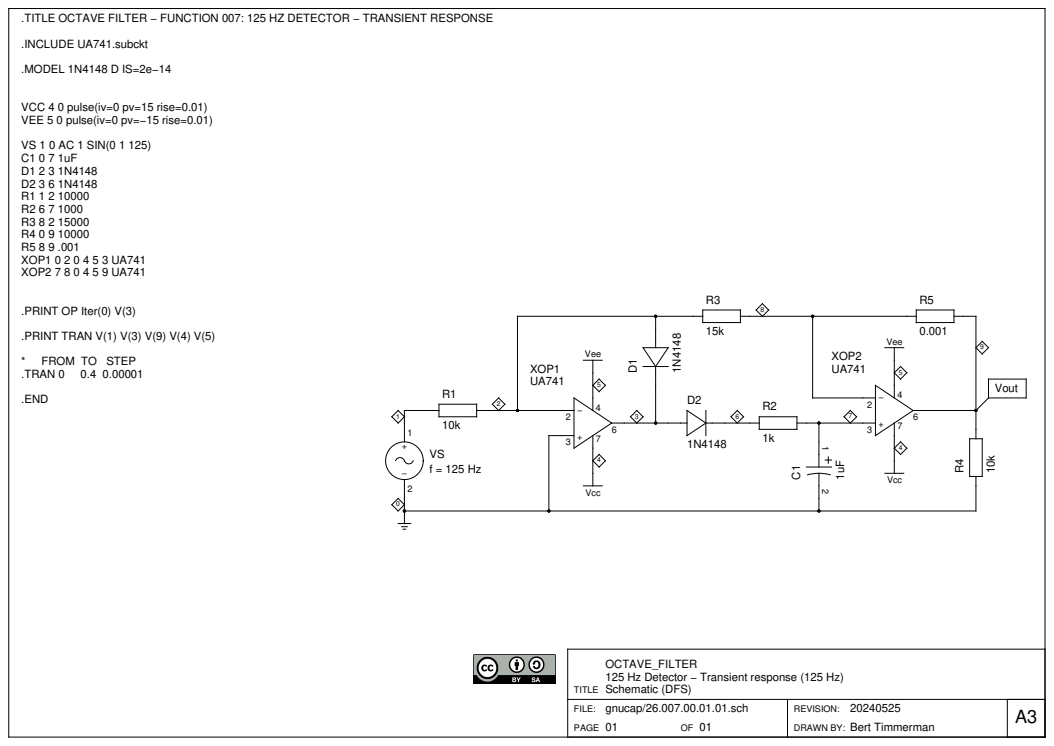
[picture p399: page 38]

.TITLE OCTAVE FILTER − FUNCTION 007: 125 HZ DETECTOR − TRANSIENT RESPONSE

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

OCTAVE_FILTER
125 Hz Detector − Transient response (125 Hz)
Schematic (DFS)

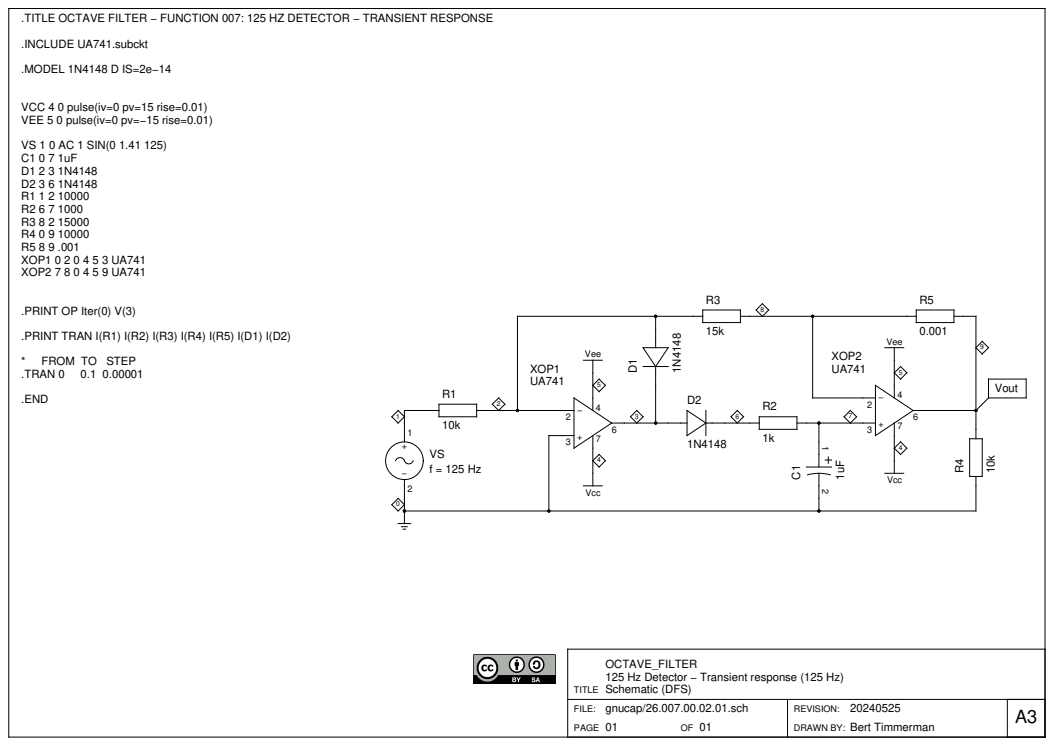
[picture p400: page 39]

.TITLE OCTAVE FILTER − FUNCTION 007: 125 HZ DETECTOR − TRANSIENT RESPONSE

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

OCTAVE_FILTER
125 Hz Detector − Transient response (125 Hz)
Schematic (DFS)

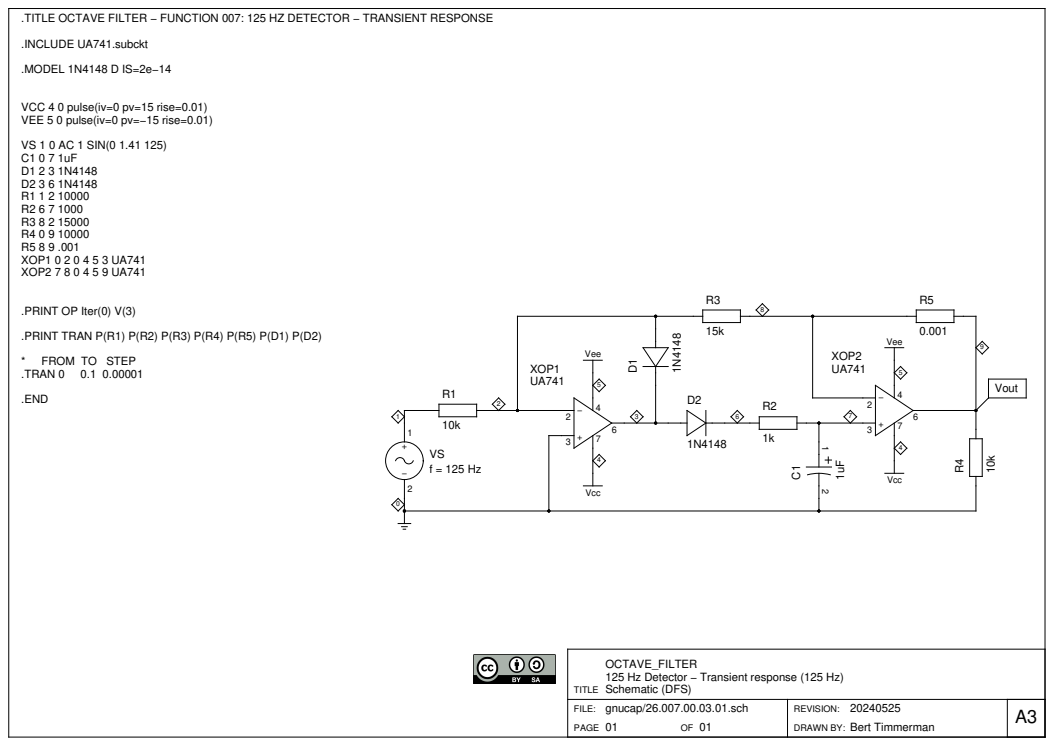
[picture p401: page 40]

.TITLE OCTAVE FILTER − FUNCTION 007: 125 HZ DETECTOR − TRANSIENT RESPONSE

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

OCTAVE_FILTER
125 Hz Detector − Transient response (125 Hz)
Schematic (DFS)

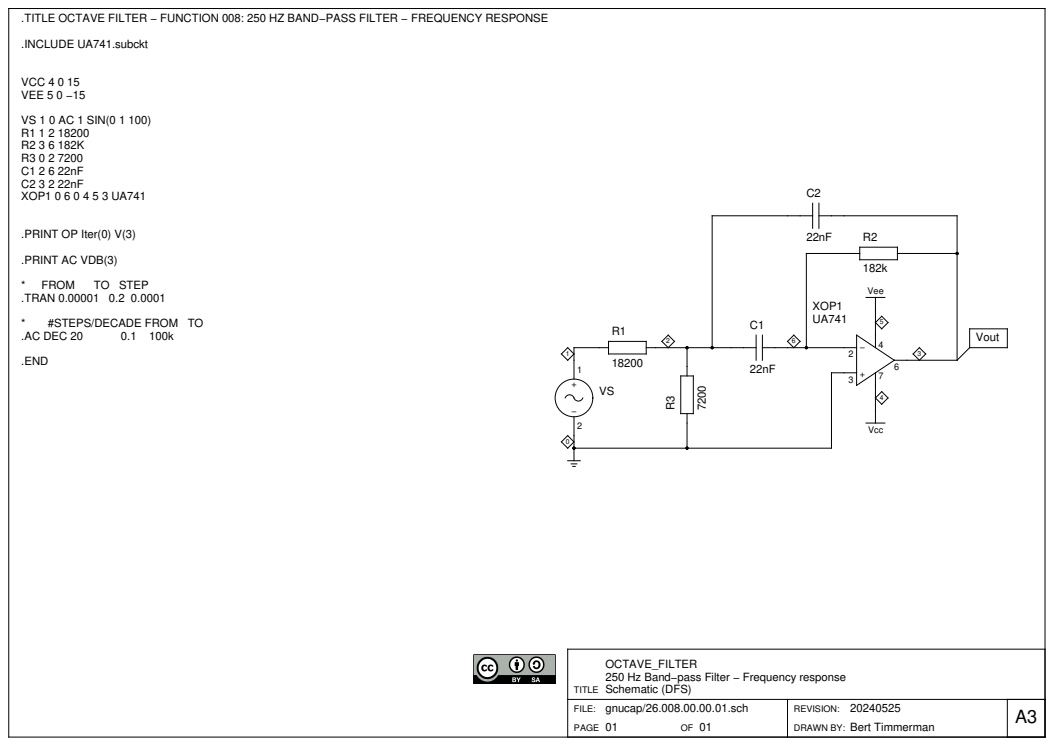
[picture p402: page 41]
Bert Timmerman gnucap/26.008.00.00.01.sch 01; .INCLUDE UA741.subckt; VCC 4 0 15 VEE 5 0 −15; VS 1 0 AC 1 SIN(0 1 100) R1 1 2 18200 R2 3 6 182K R3 0 2 7200 C1 2 6 22nF C2 3 2 22nF XOP1 0 6 0 4 5 3 UA741; FROM; TO STEP; .TRAN 0.00001 0.2 0.0001; #STEPS/DECADE FROM TO; .AC DEC 20

.TITLE OCTAVE FILTER − FUNCTION 008: 250 HZ BAND−PASS FILTER − FREQUENCY RESPONSE

.PRINT OP Iter(0) V(3)

.PRINT AC VDB(3)

OCTAVE_FILTER
250 Hz Band−pass Filter − Frequency response
Schematic (DFS)

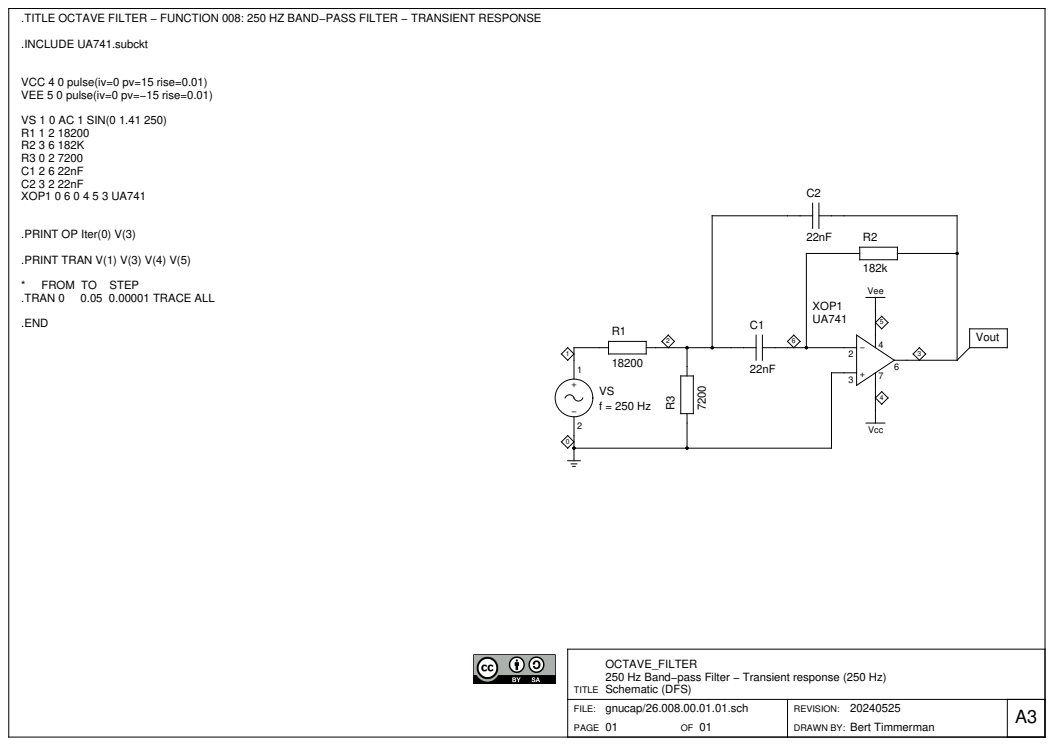
[picture p403: page 42]
Bert Timmerman gnucap/26.008.00.01.01.sch 01; .INCLUDE UA741.subckt; VS 1 0 AC 1 SIN(0 1.41 250) R1 1 2 18200 R2 3 6 182K R3 0 2 7200 C1 2 6 22nF C2 3 2 22nF XOP1 0 6 0 4 5 3 UA741; .PRINT TRAN V(1) V(3) V(4) V(5); FROM TO STEP; .TRAN 0; 0.05 0.00001 TRACE ALL; VSf = 250 Hz

.TITLE OCTAVE FILTER − FUNCTION 008: 250 HZ BAND−PASS FILTER − TRANSIENT RESPONSE

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

.PRINT OP Iter(0) V(3)

OCTAVE_FILTER
250 Hz Band−pass Filter − Transient response (250 Hz)
Schematic (DFS)

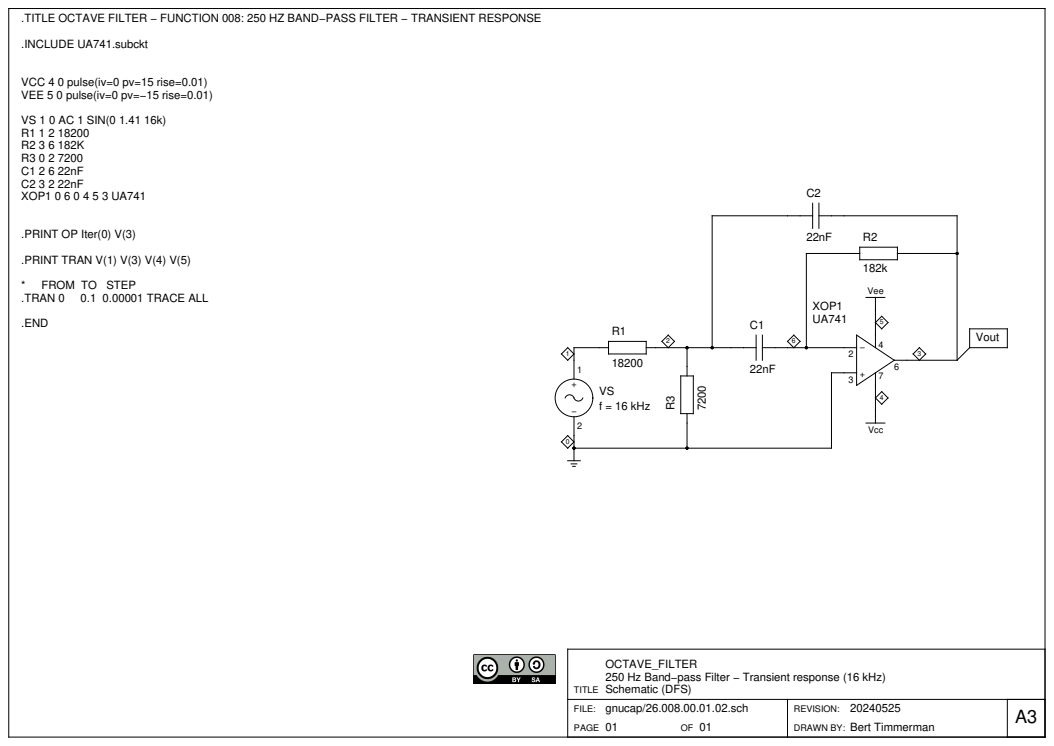
[picture p404: page 43]
Bert Timmerman gnucap/26.008.00.01.02.sch 01; .INCLUDE UA741.subckt; VS 1 0 AC 1 SIN(0 1.41 16k) R1 1 2 18200 R2 3 6 182K R3 0 2 7200 C1 2 6 22nF C2 3 2 22nF XOP1 0 6 0 4 5 3 UA741; .PRINT TRAN V(1) V(3) V(4) V(5); FROM TO STEP; .TRAN 0; 0.1 0.00001 TRACE ALL; VSf = 16 kHz

.TITLE OCTAVE FILTER − FUNCTION 008: 250 HZ BAND−PASS FILTER − TRANSIENT RESPONSE

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

.PRINT OP Iter(0) V(3)

OCTAVE_FILTER
250 Hz Band−pass Filter − Transient response (16 kHz)
Schematic (DFS)
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
