lambert/26/mcad/plotfiles/26.001.00.03.01_front_panel_mechanical.pdf

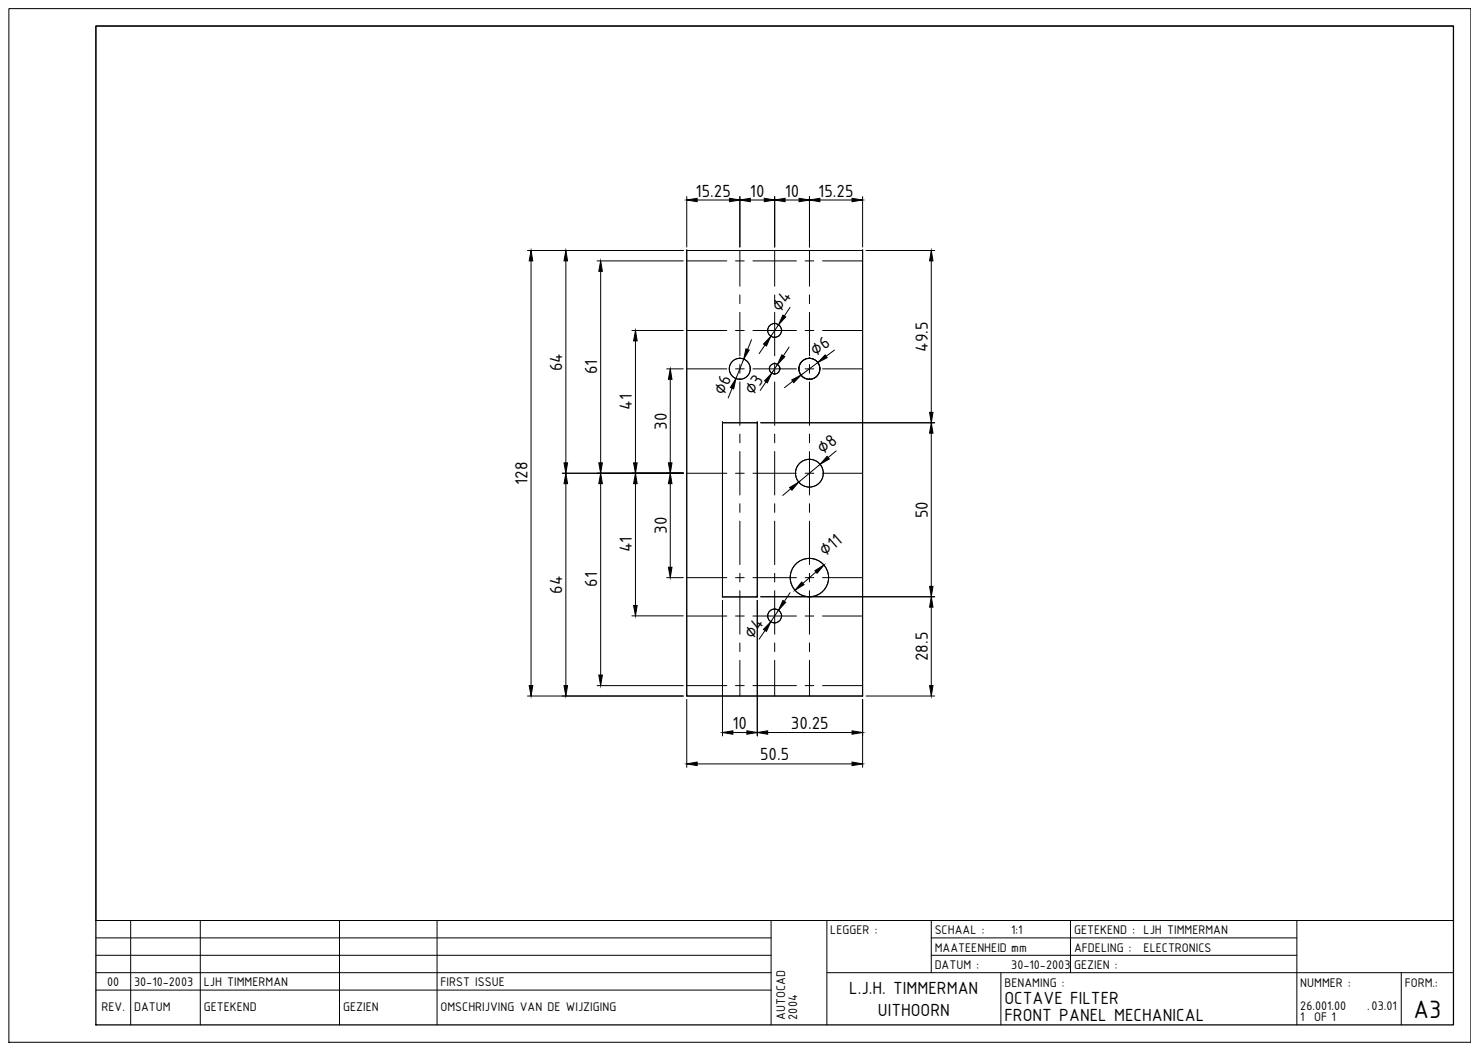
[picture p405: page 1]
REV.; DATUM; GETEKEND; GEZIEN; OMSCHRIJVING VAN DE WIJZIGING; DATUM : SCHAAL : MAATEENHEID : LEGGER :; AFDELING : GETEKEND : GEZIEN : BENAMING :; FORM.: . OF NUMMER : 26.001.00; A3 OCTAVE FILTER FRONT PANEL MECHANICAL 1:1 mm30-10-2003; LJH TIMMERMAN ELECTRONICS L.J.H. TIMMERMAN

2004 UITHOORN 00 30-10-2003 LJH TIMMERMAN FIRST ISSUE
