lambert/26/ecad/pcb/plotfiles/26.001.00.01.01.pcb.pdf

## 26.001.00.01.01.pcb

## 1. Table of Contents (This Page) Created on Sat Feb 13 14:51:55 2021 2. top 3. bottom 4. outline 5. plated-drill 6. unplated-drill 7. componentmask 8. soldermask 9. topsilk 10. bottomsilk 11. bottompaste 12. topassembly 13. bottomassembly 14. fab

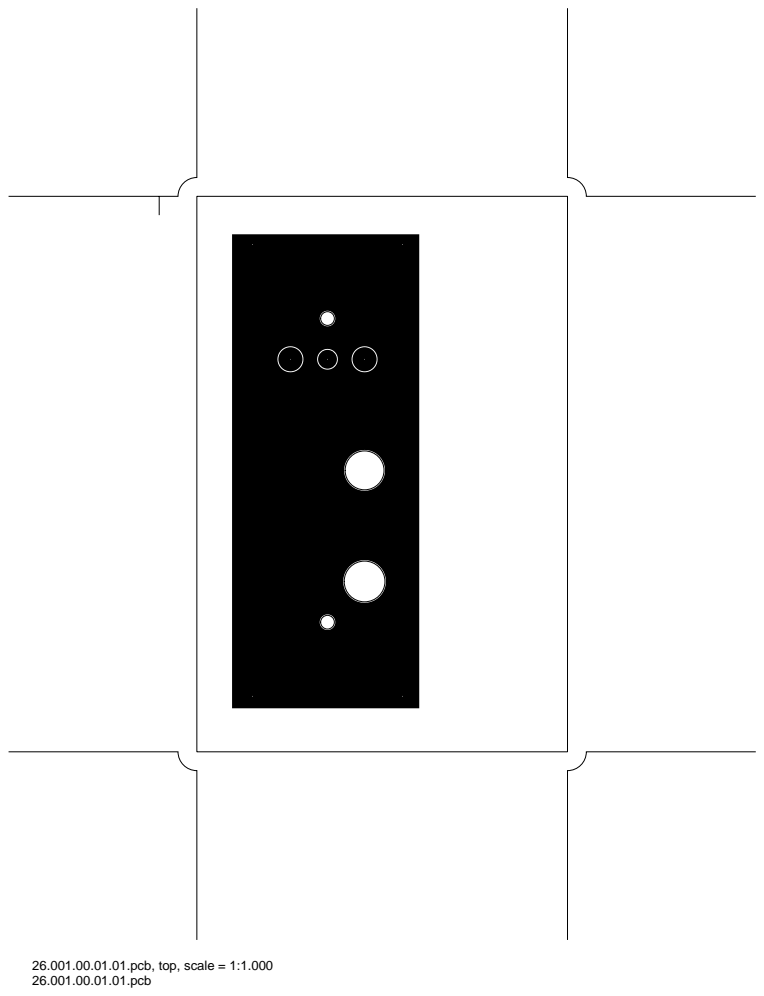
[picture p406: page 2]

26.001.00.01.01.pcb, top, scale = 1:1.000

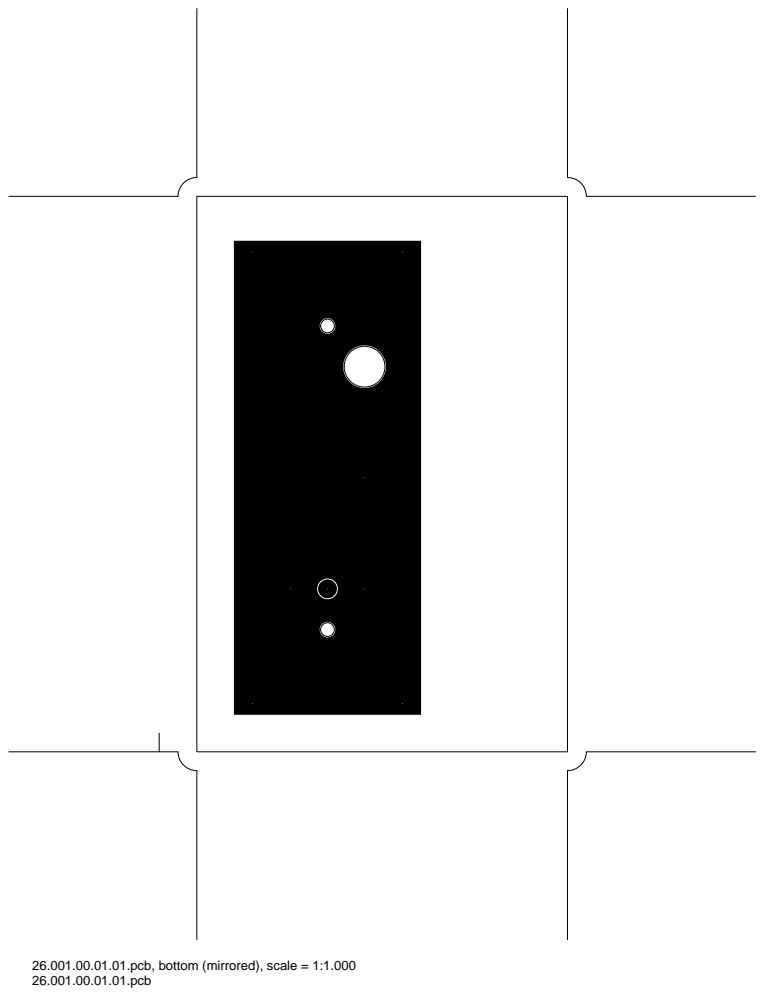
[picture p407: page 3]

26.001.00.01.01.pcb, bottom (mirrored), scale = 1:1.000

26.001.00.01.01.pcb, outline, scale = 1:1.000

26.001.00.01.01.pcb, plated-drill, scale = 1:1.000

26.001.00.01.01.pcb, unplated-drill, scale = 1:1.000

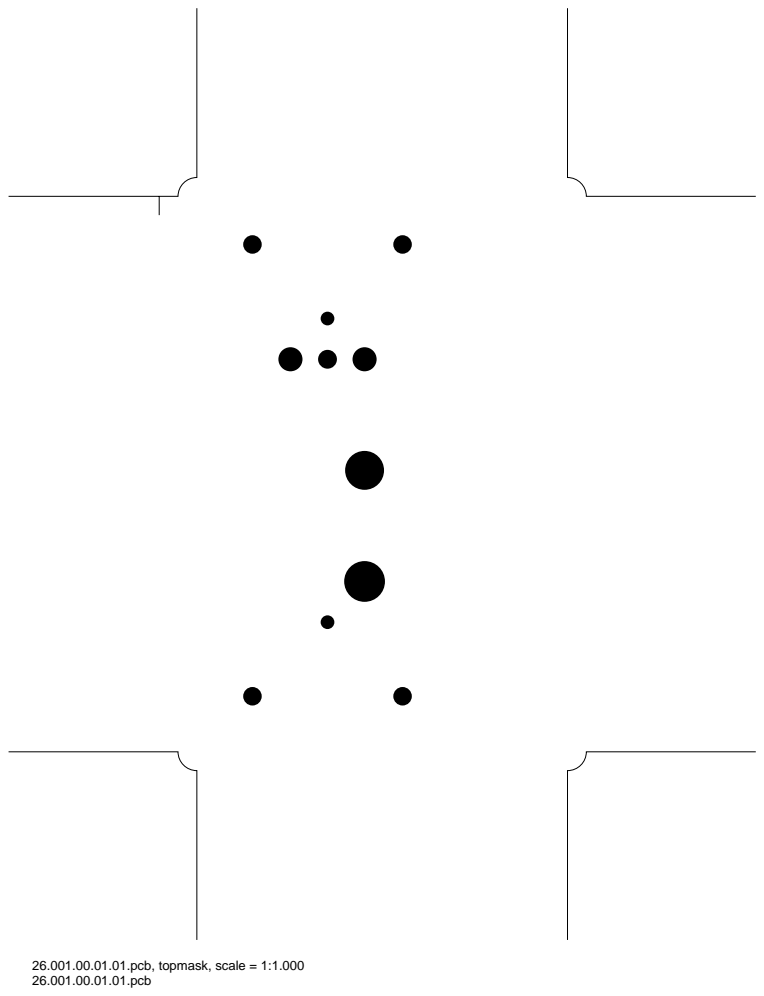
[picture p408: page 7]

26.001.00.01.01.pcb, topmask, scale = 1:1.000

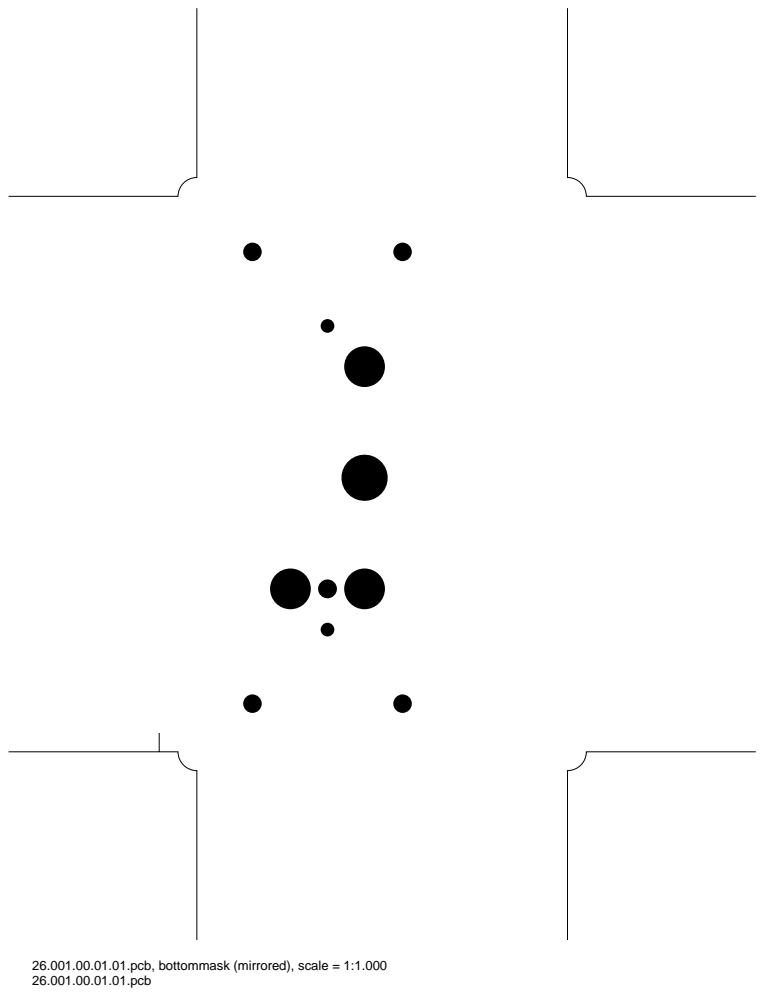
[picture p409: page 8]

26.001.00.01.01.pcb, bottommask (mirrored), scale = 1:1.000

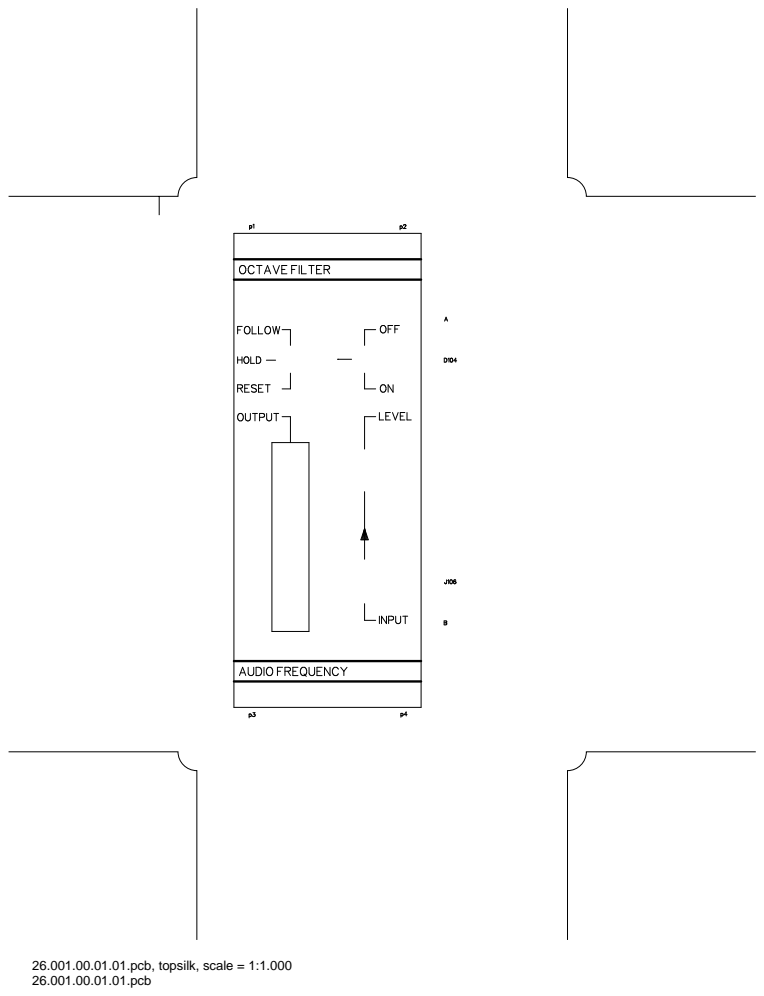
[picture p410: page 9]

26.001.00.01.01.pcb, topsilk, scale = 1:1.000

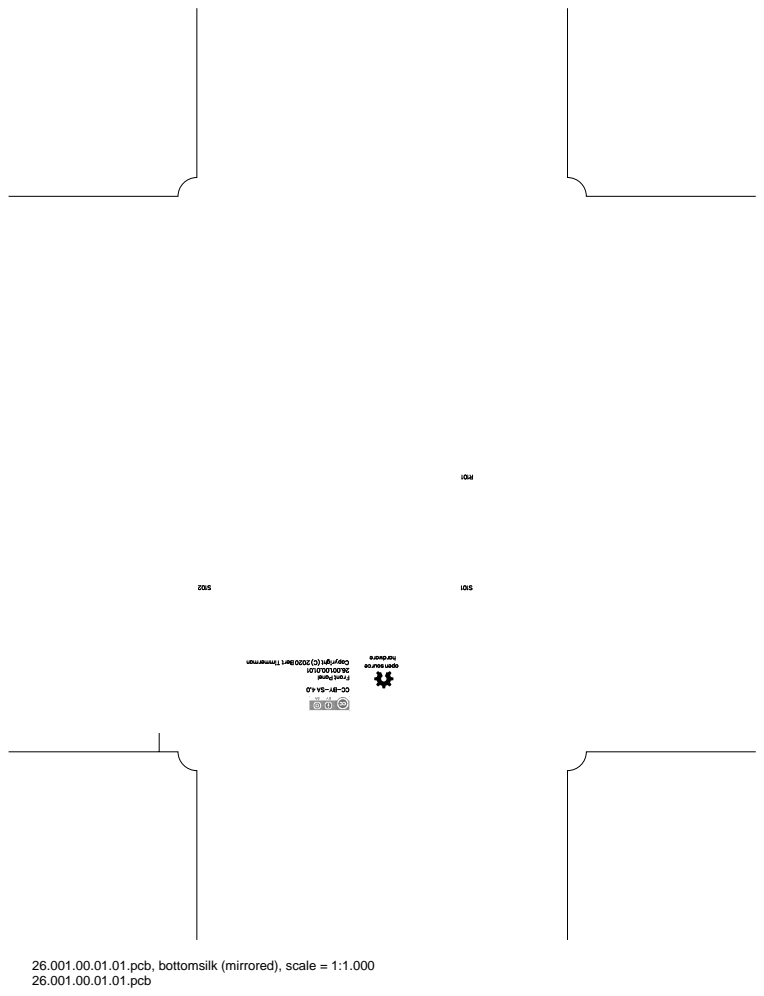
[picture p411: page 10]

26.001.00.01.01.pcb, bottomsilk (mirrored), scale = 1:1.000

26.001.00.01.01.pcb, bottompaste (mirrored), scale = 1:1.000

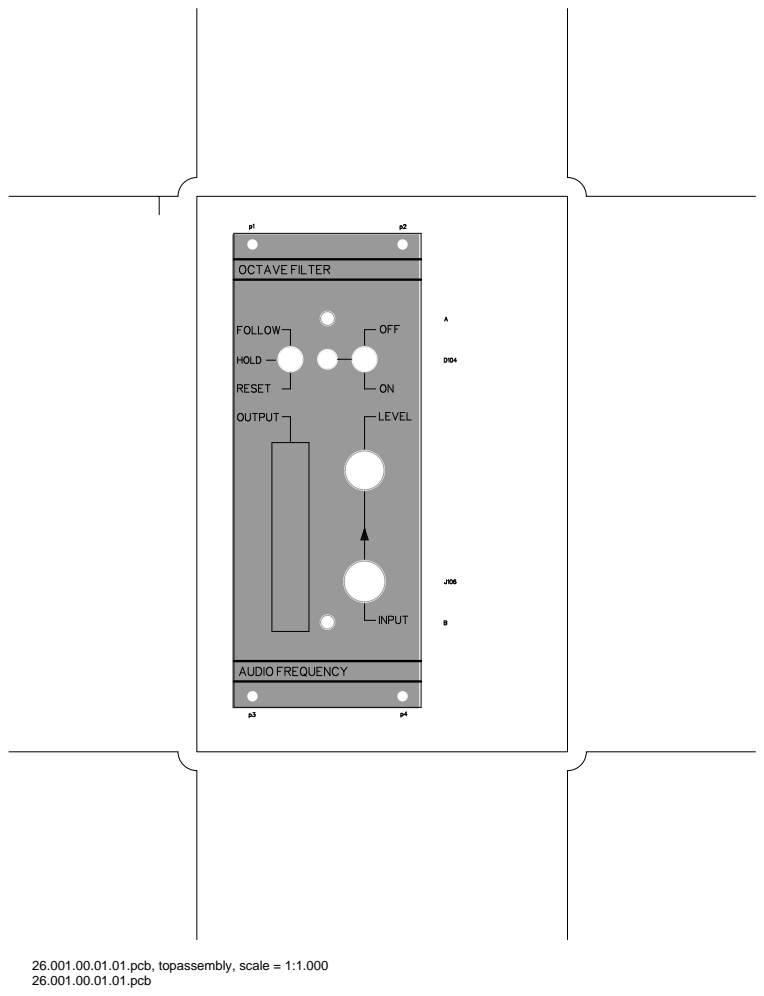
[picture p412: page 12]

26.001.00.01.01.pcb, topassembly, scale = 1:1.000

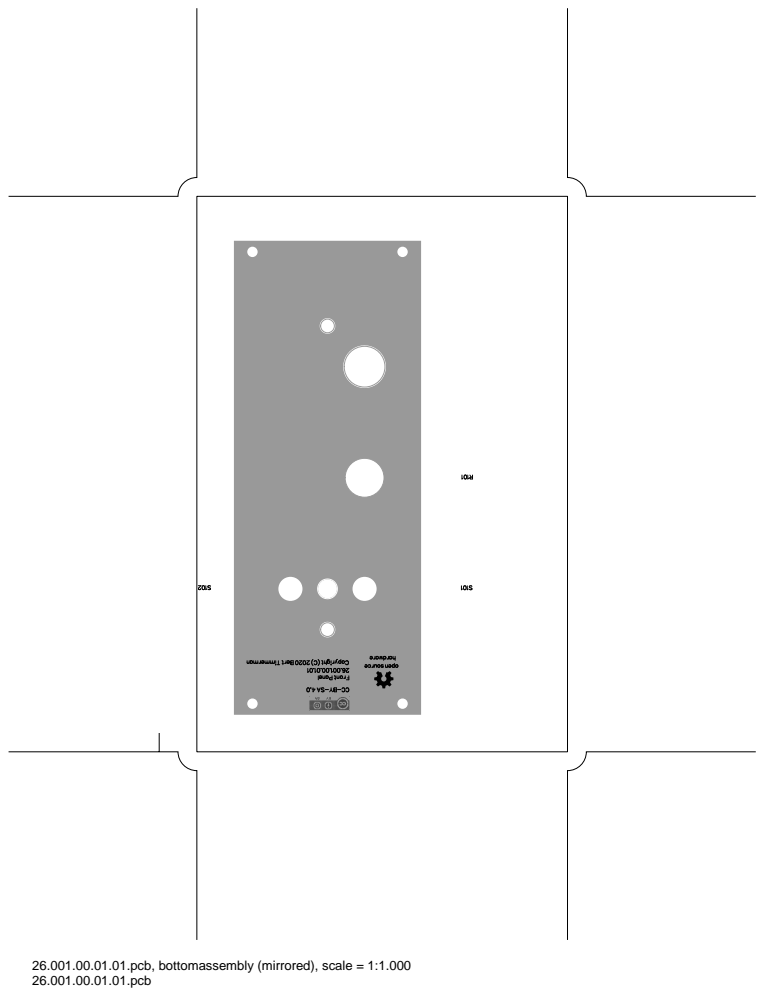
[picture p413: page 13]

26.001.00.01.01.pcb, bottomassembly (mirrored), scale = 1:1.000

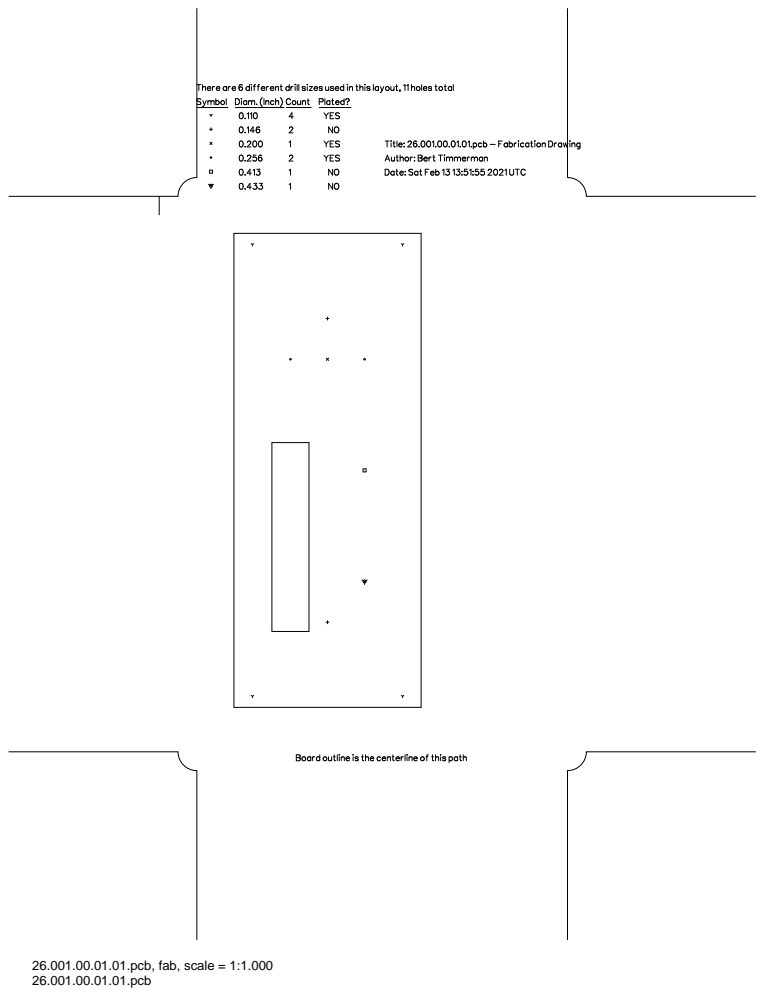
[picture p414: page 14]

26.001.00.01.01.pcb, fab, scale = 1:1.000
