lambert/26/ecad/pcb/plotfiles/26.003.00.01.01.pcb.pdf

## 26.003.00.01.01.pcb

## 1. Table of Contents (This Page) Created on Sat Feb 13 14:51:56 2021 2. top 3. bottom 4. outline 5. keepout 6. plated-drill 7. unplated-drill 8. componentmask 9. soldermask 10. topsilk 11. bottomsilk 12. topassembly 13. bottomassembly 14. fab

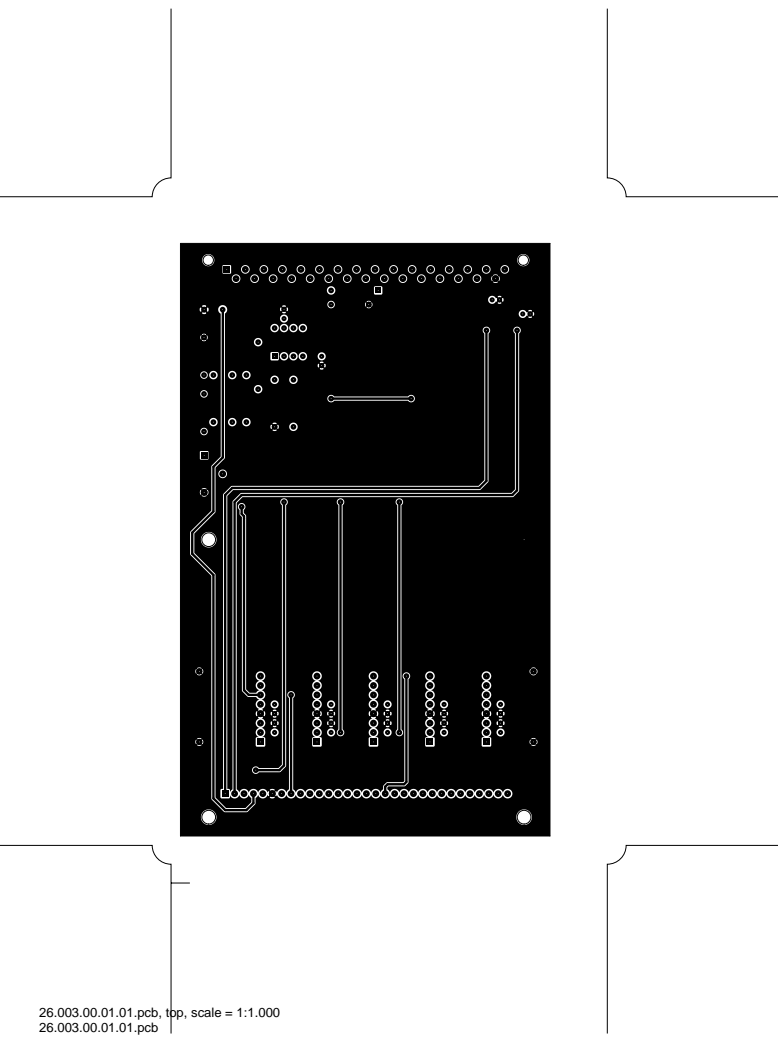
[picture p426: page 2]

26.003.00.01.01.pcb, top, scale = 1:1.000

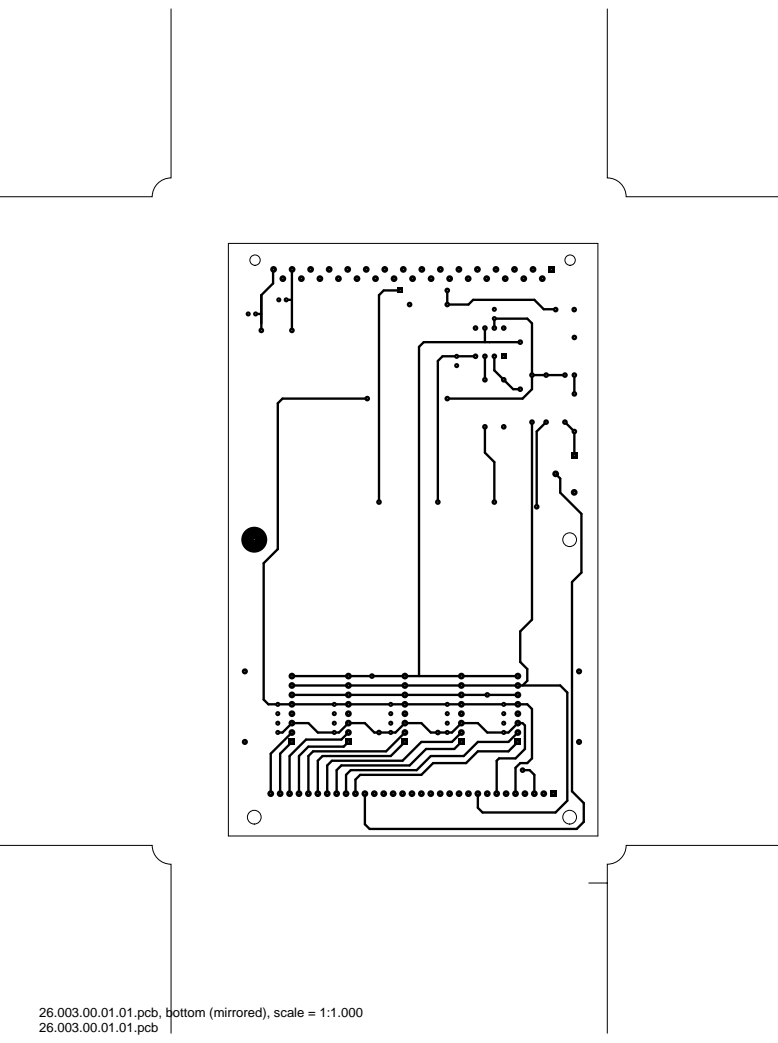
[picture p427: page 3]

26.003.00.01.01.pcb, bottom (mirrored), scale = 1:1.000

26.003.00.01.01.pcb, outline, scale = 1:1.000

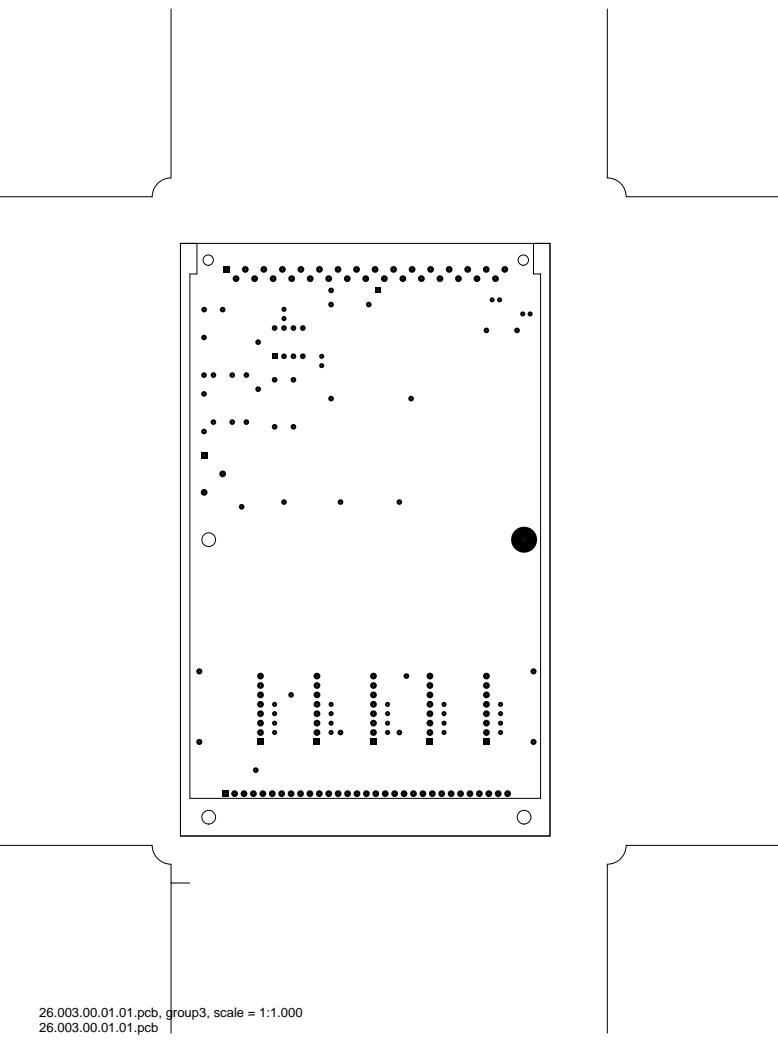
[picture p428: page 5]
26.003.00.01.01.pcb, group3, scale = 1:1.000

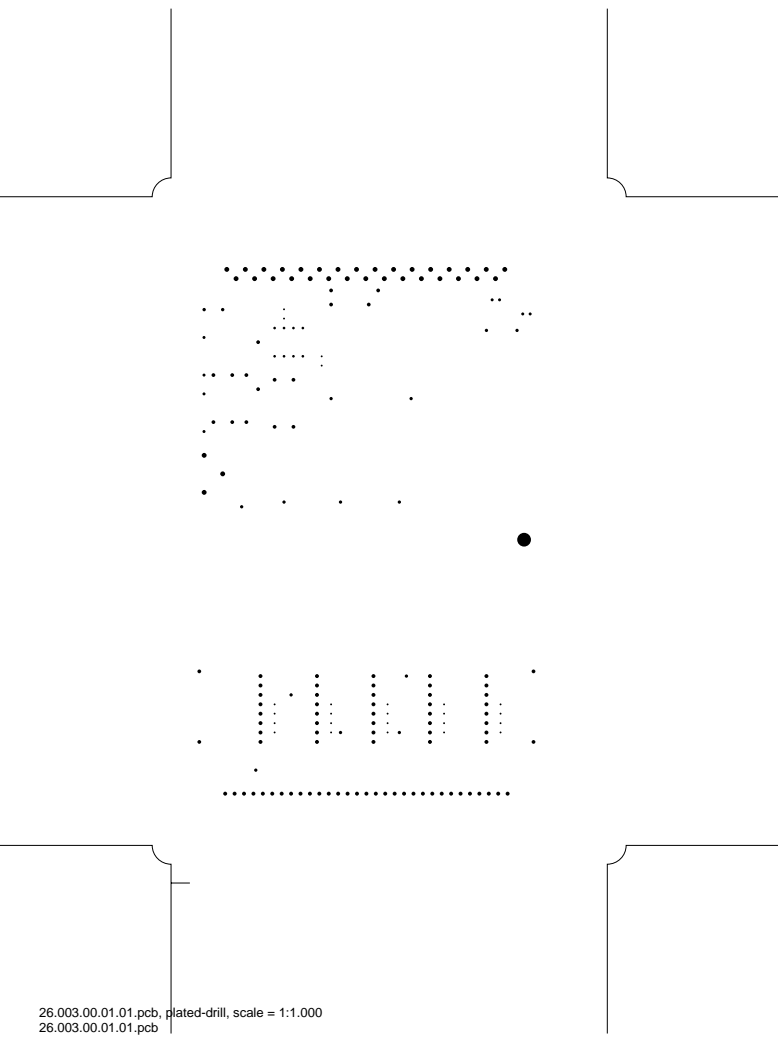
[picture p429: page 6]

26.003.00.01.01.pcb, plated-drill, scale = 1:1.000

26.003.00.01.01.pcb, unplated-drill, scale = 1:1.000

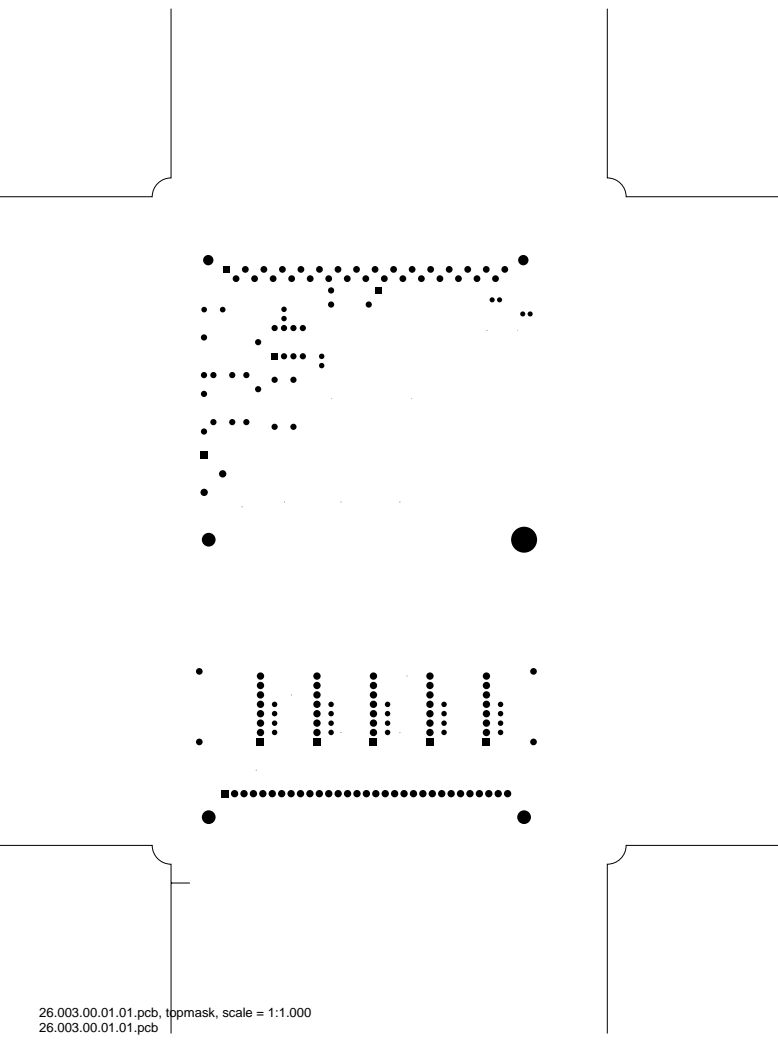
[picture p430: page 8]

26.003.00.01.01.pcb, topmask, scale = 1:1.000

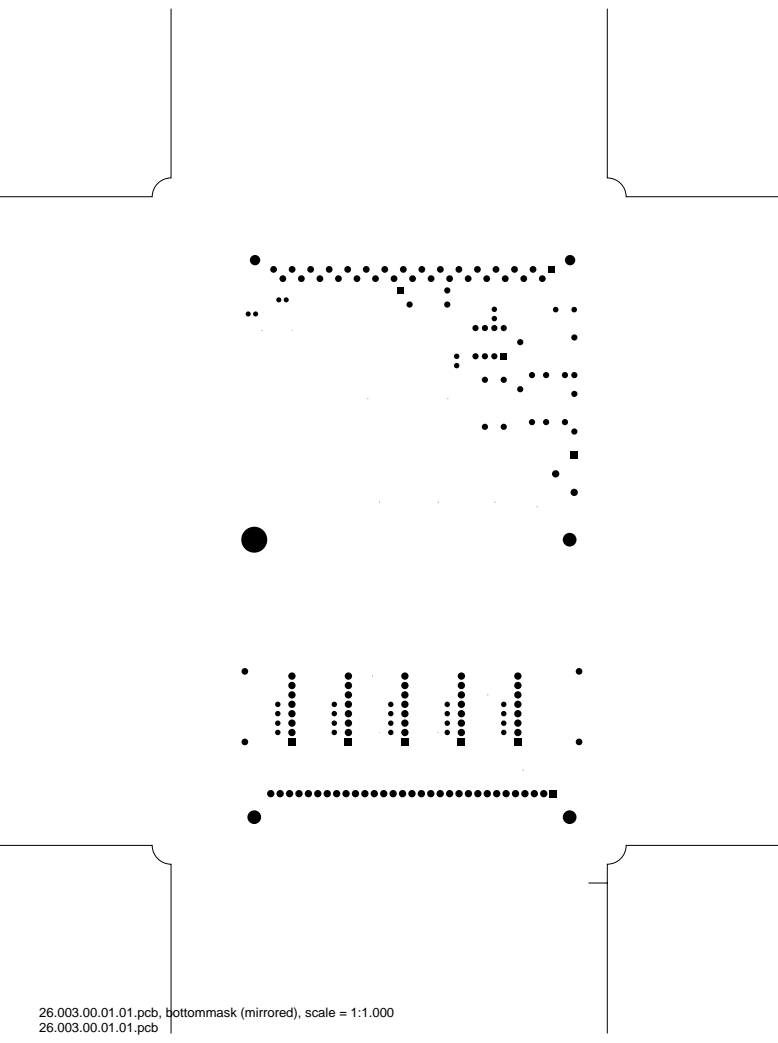
[picture p431: page 9]

26.003.00.01.01.pcb, bottommask (mirrored), scale = 1:1.000

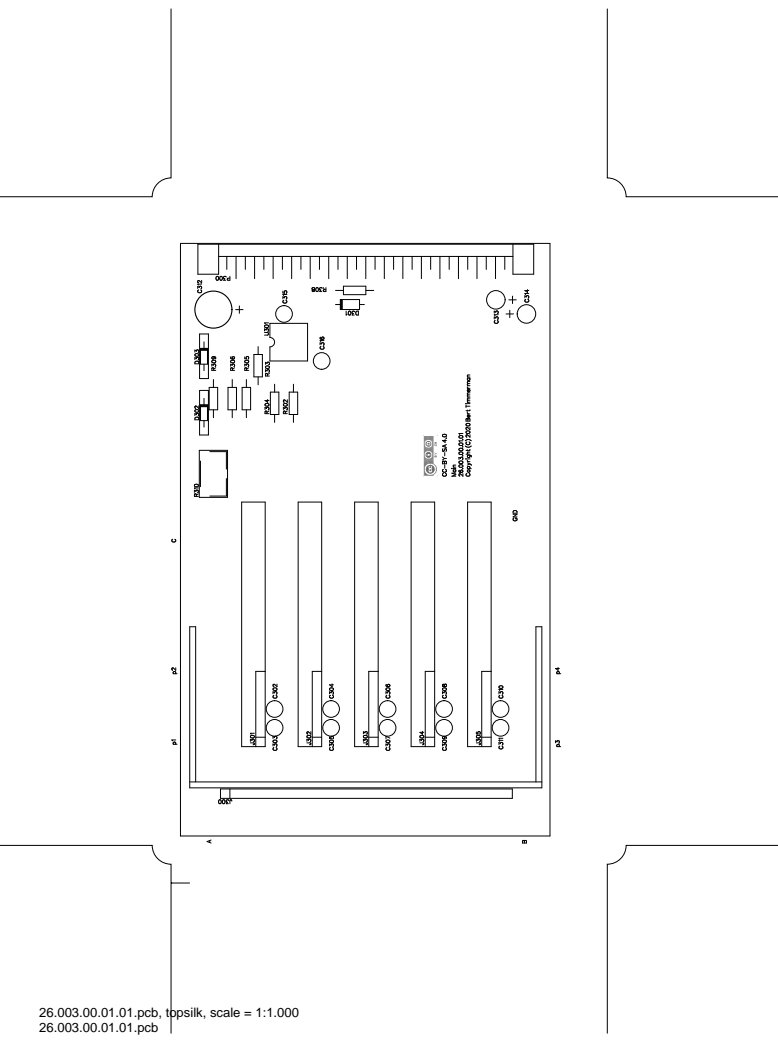
[picture p432: page 10]

26.003.00.01.01.pcb, topsilk, scale = 1:1.000

26.003.00.01.01.pcb, bottomsilk (mirrored), scale = 1:1.000

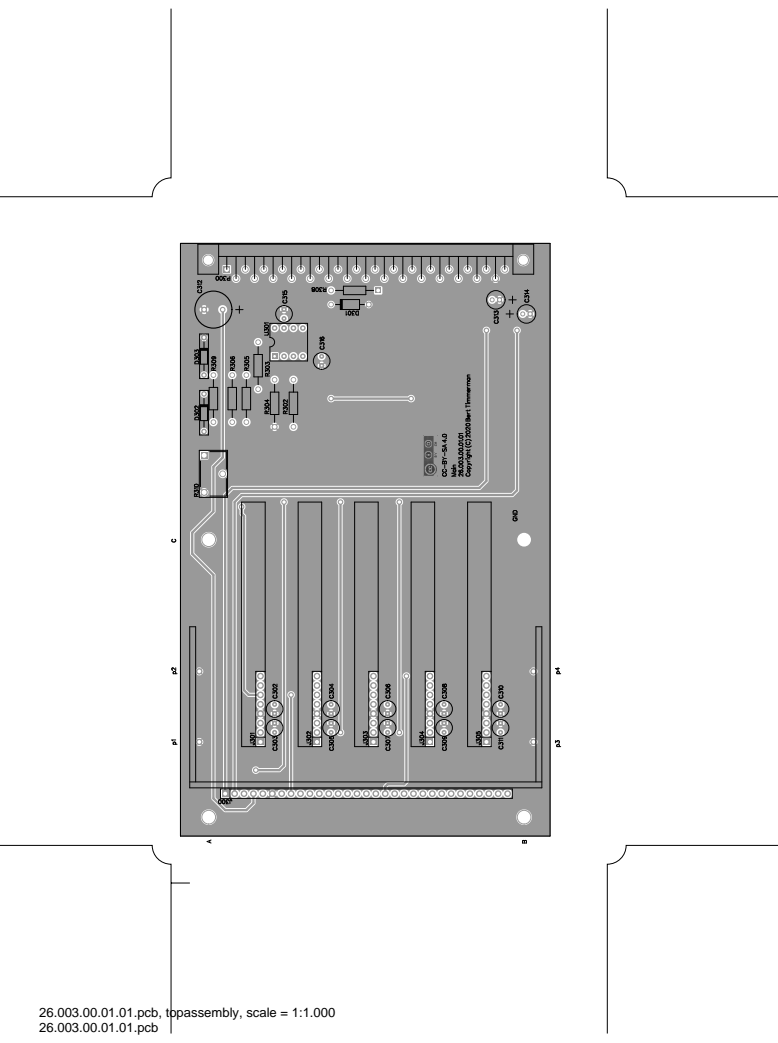
[picture p433: page 12]

26.003.00.01.01.pcb, topassembly, scale = 1:1.000

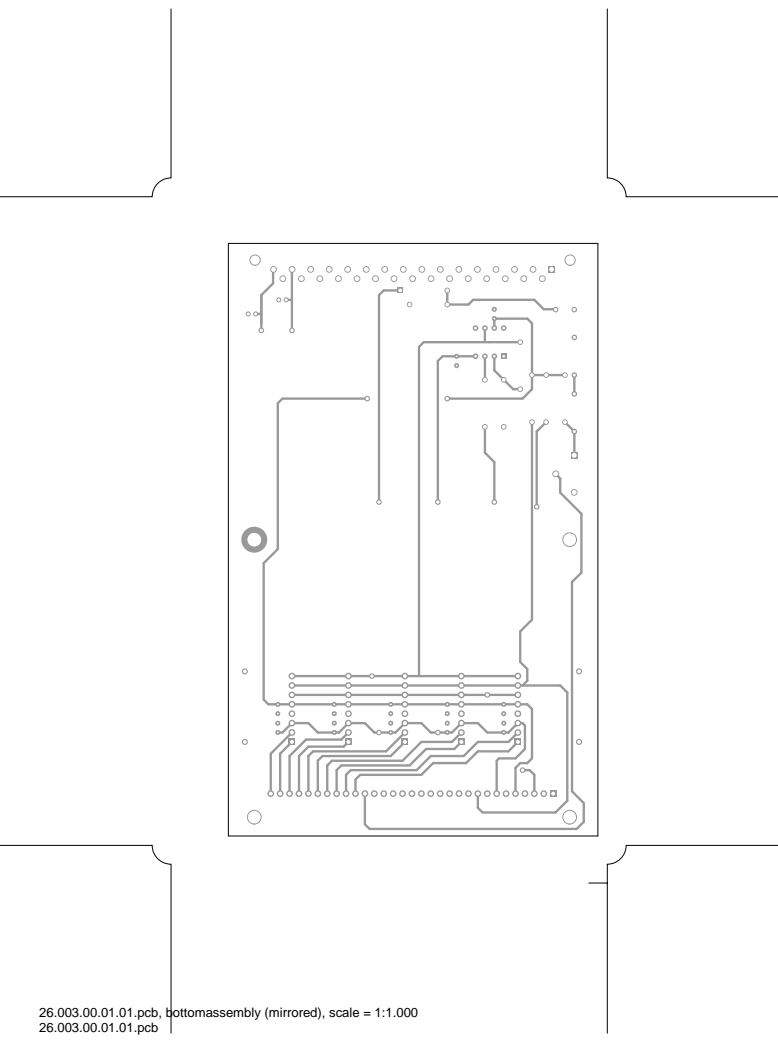
[picture p434: page 13]

26.003.00.01.01.pcb, bottomassembly (mirrored), scale = 1:1.000

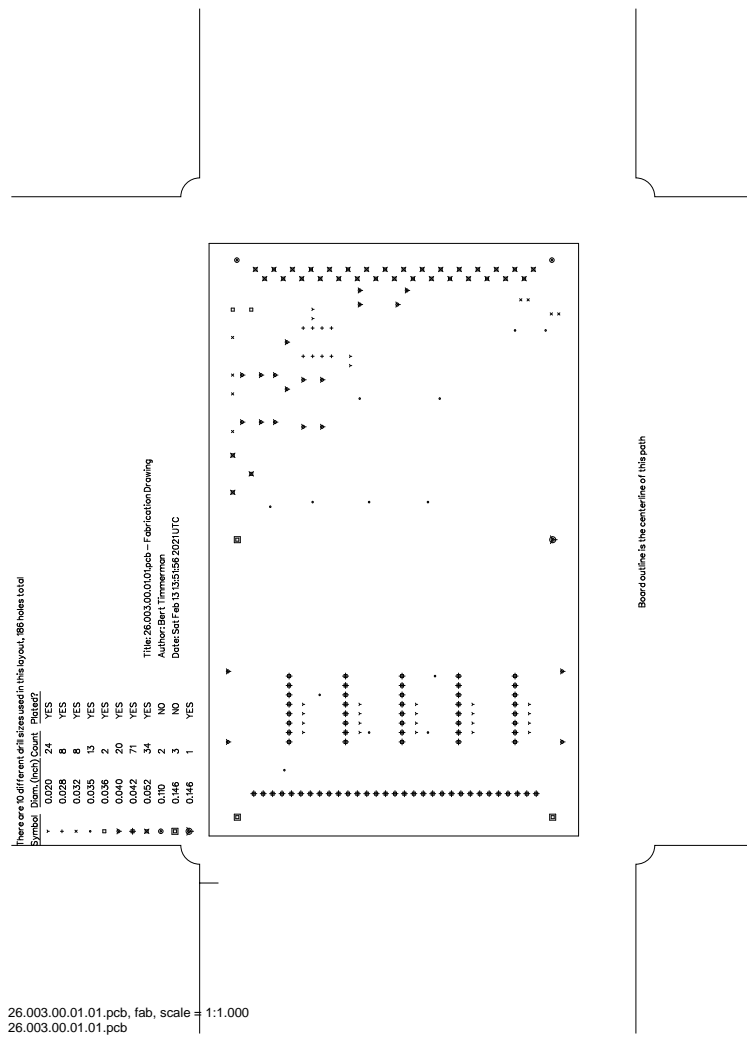
[picture p435: page 14]

26.003.00.01.01.pcb, fab, scale = 1:1.000
