lambert/26/ecad/pcb/plotfiles/26.004.00.01.01.pcb.pdf

## 26.004.00.01.01.pcb

## 1. Table of Contents (This Page) Created on Sat Feb 13 14:51:56 2021 2. top 3. bottom 4. outline 5. plated-drill 6. componentmask 7. soldermask 8. topsilk 9. bottomsilk 10. topassembly 11. bottomassembly 12. fab

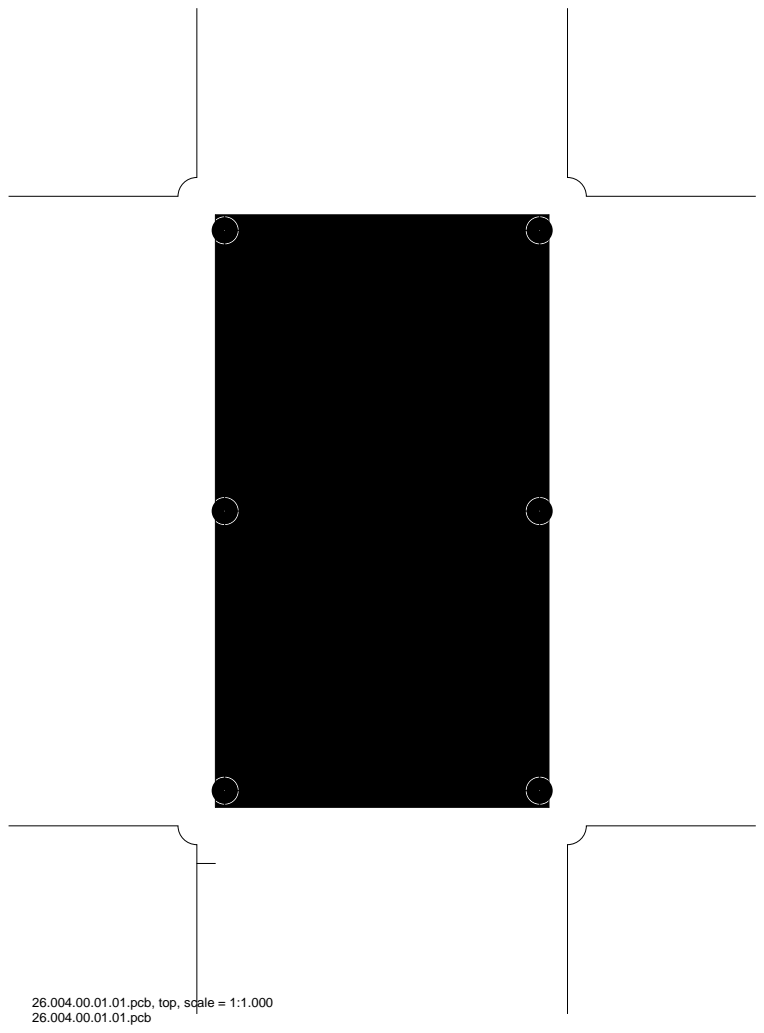
[picture p436: page 2]

26.004.00.01.01.pcb, top, scale = 1:1.000

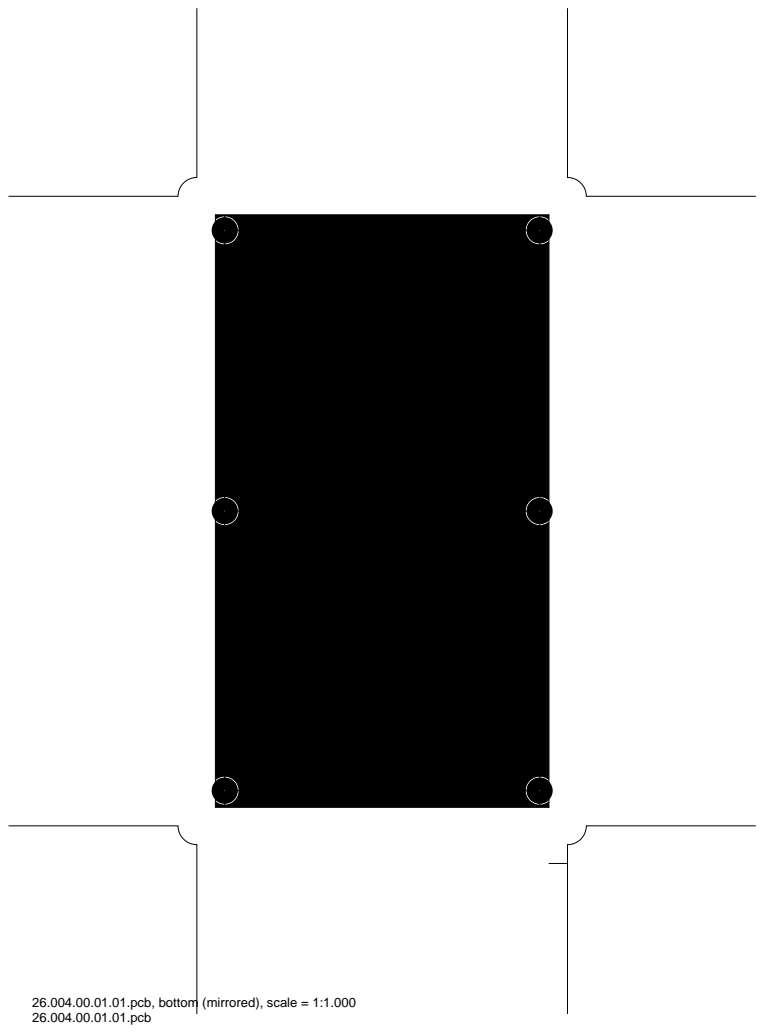
[picture p437: page 3]

26.004.00.01.01.pcb, bottom (mirrored), scale = 1:1.000

26.004.00.01.01.pcb, outline, scale = 1:1.000

26.004.00.01.01.pcb, plated-drill, scale = 1:1.000

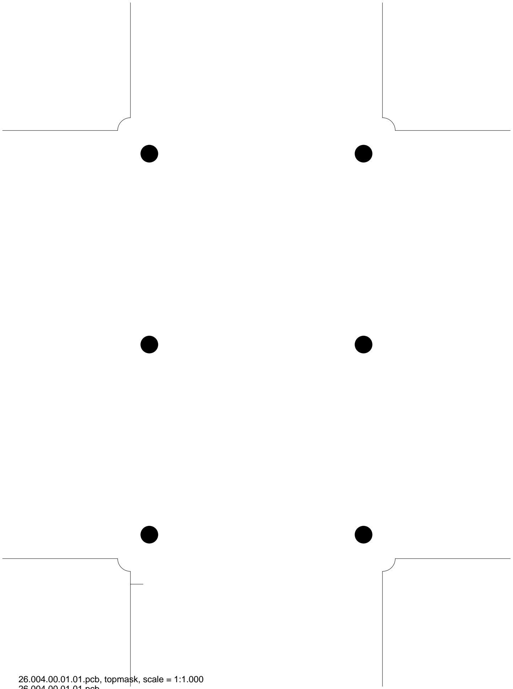
[picture p438: figure]
26.004.00.01.01.pcb, topmask, scale = 1:1.000

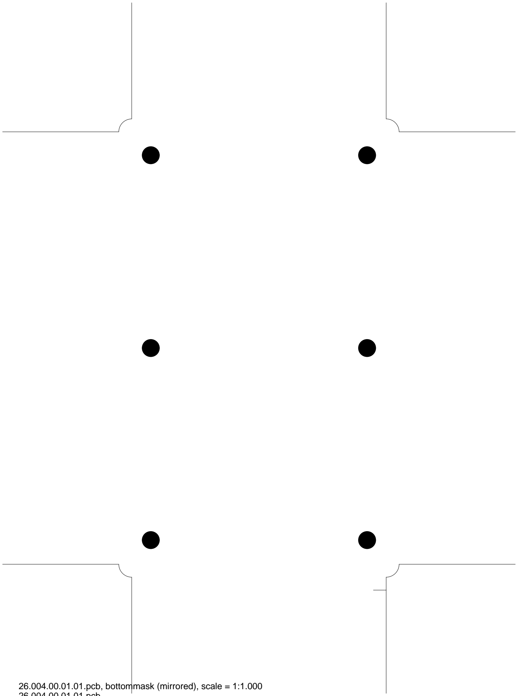
[picture p439: figure]

26.004.00.01.01.pcb, bottommask (mirrored), scale = 1:1.000

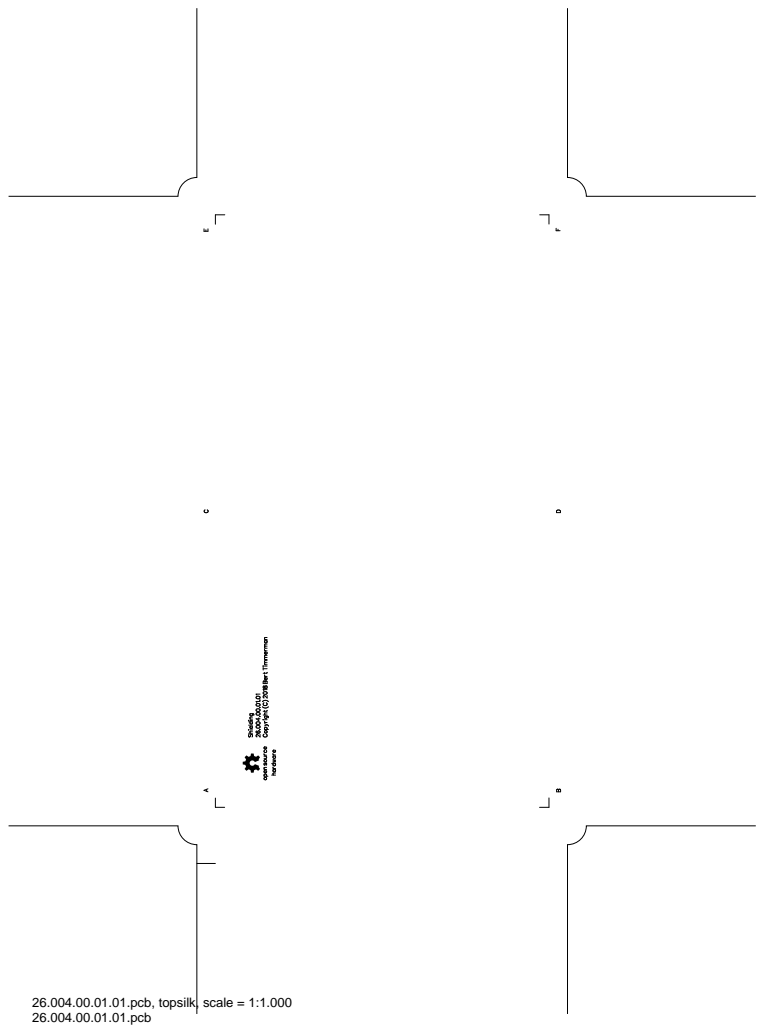
[picture p440: page 8]

26.004.00.01.01.pcb, topsilk, scale = 1:1.000

26.004.00.01.01.pcb, bottomsilk (mirrored), scale = 1:1.000

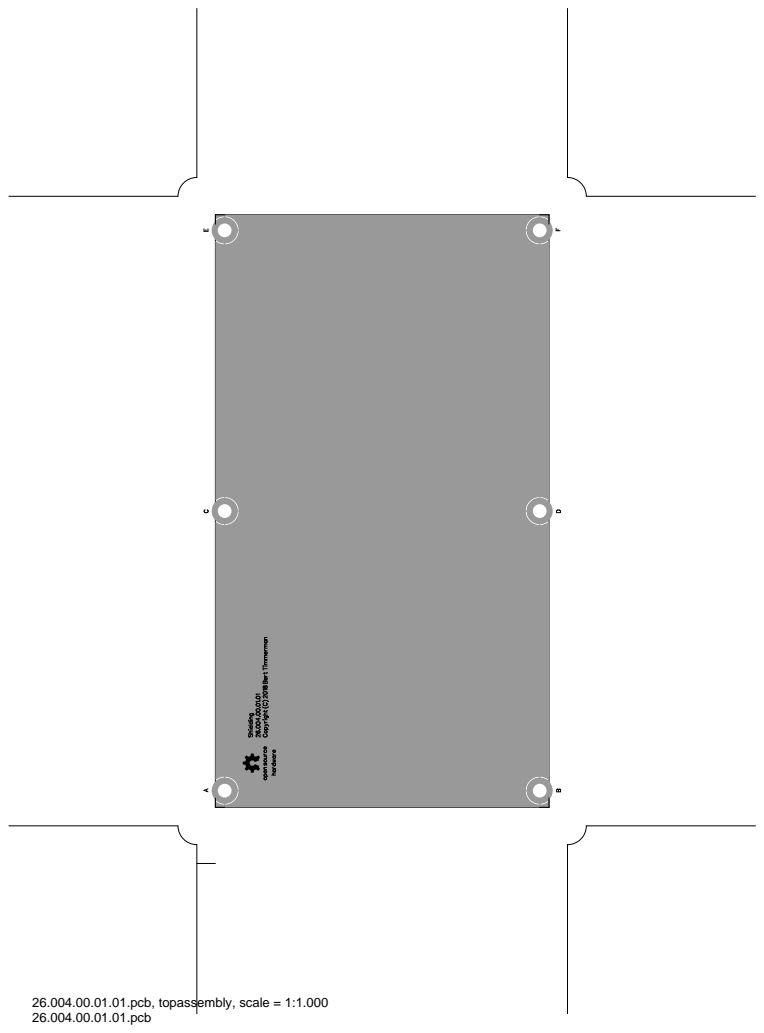
[picture p441: page 10]

26.004.00.01.01.pcb, topassembly, scale = 1:1.000

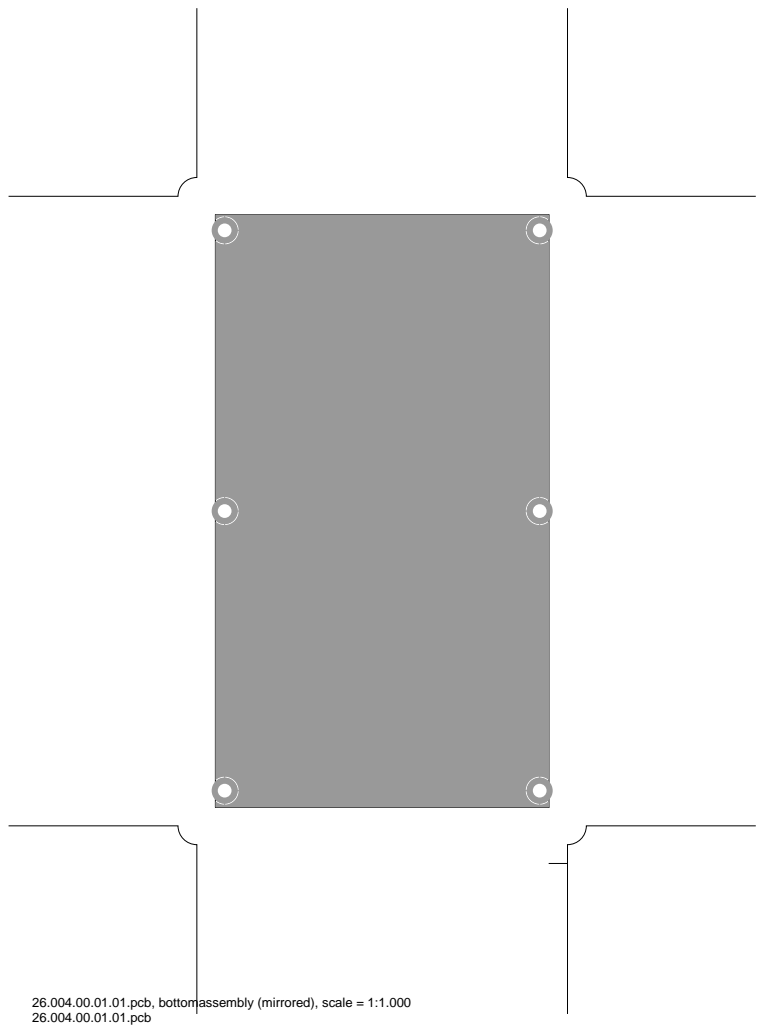
[picture p442: page 11]

26.004.00.01.01.pcb, bottomassembly (mirrored), scale = 1:1.000

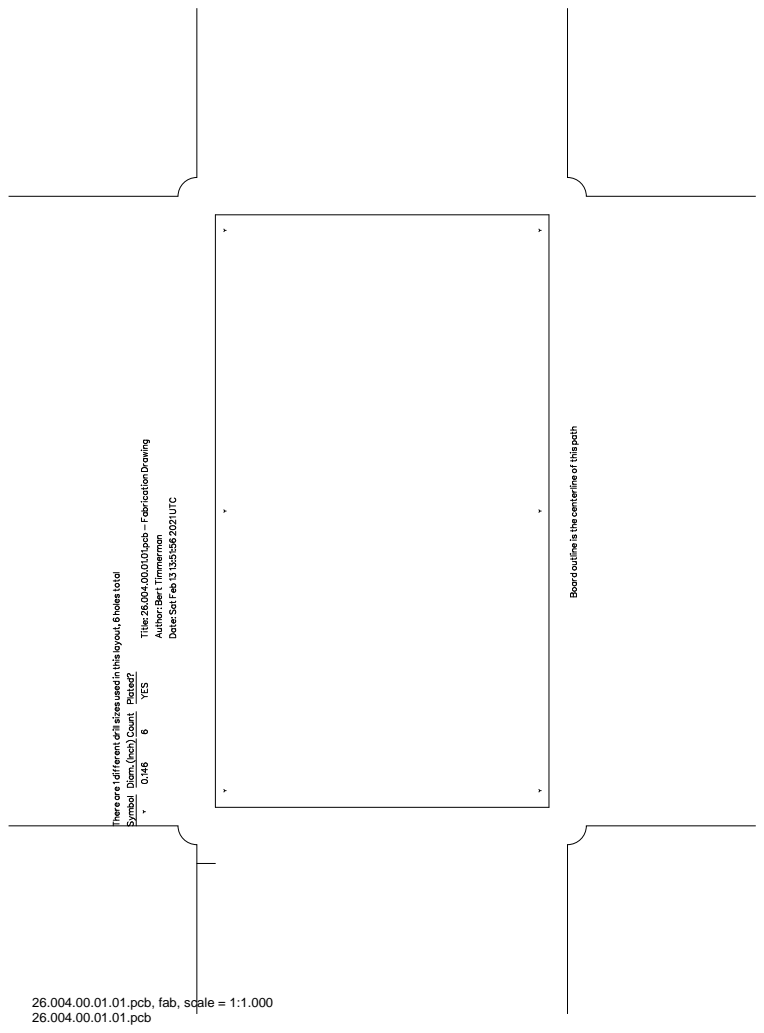
[picture p443: page 12]

26.004.00.01.01.pcb, fab, scale = 1:1.000
