lambert/26/ecad/pcb/plotfiles/26.006.01.01.01.pcb.pdf

## 26.006.01.01.01.pcb

## 1. Table of Contents (This Page) Created on Sat Feb 13 14:51:57 2021 2. component 3. solder 4. outline 5. plated-drill 6. componentmask 7. soldermask 8. topsilk 9. bottomsilk 10. topassembly 11. bottomassembly 12. fab

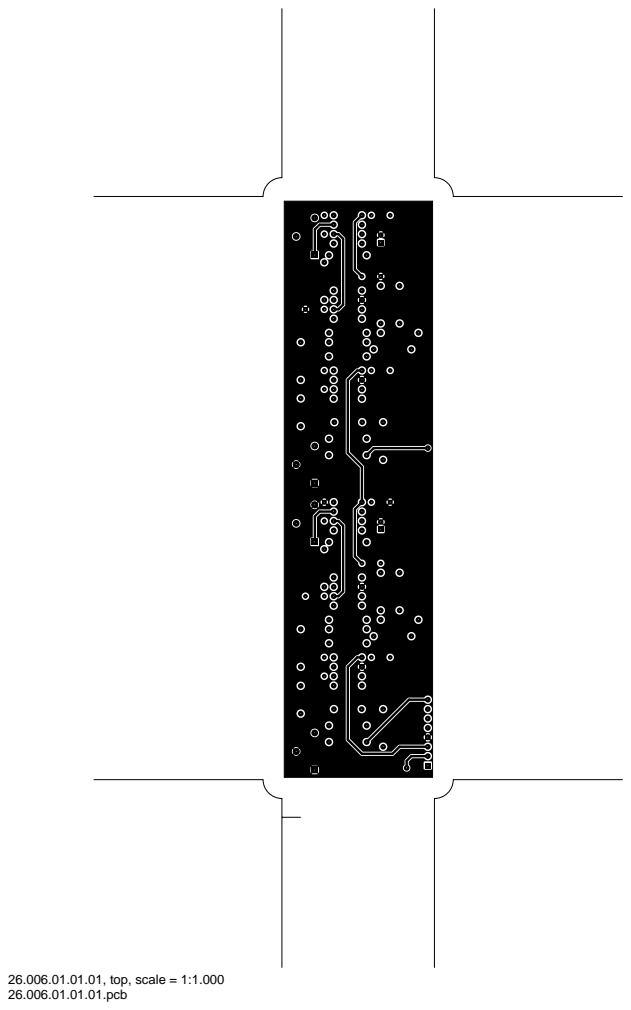
[picture p453: page 2]
26.006.01.01.01, top, scale = 1:1.000

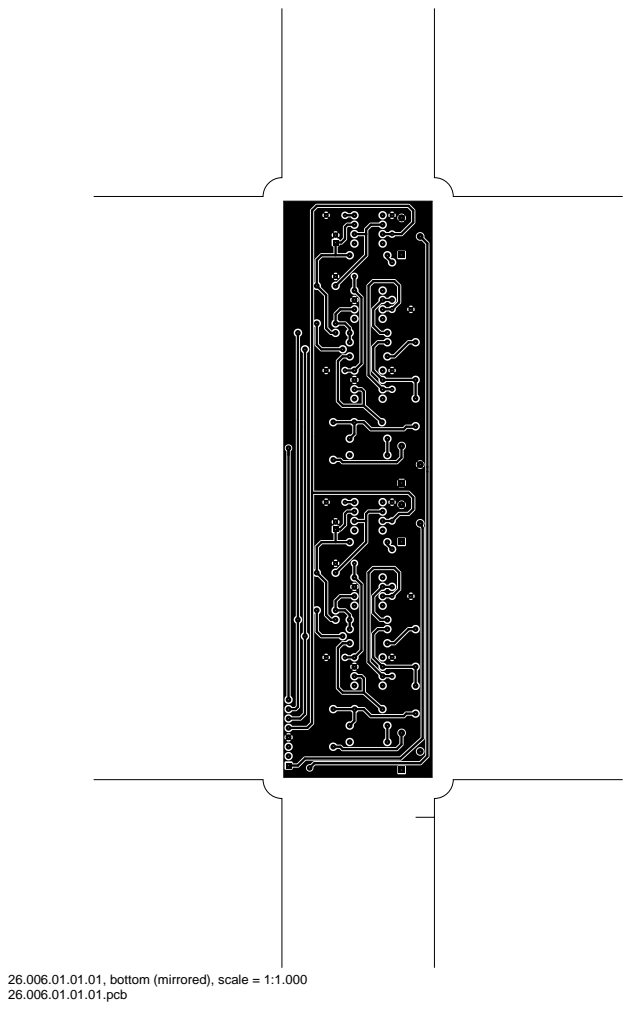
[picture p454: page 3]

26.006.01.01.01, bottom (mirrored), scale = 1:1.000

26.006.01.01.01, outline, scale = 1:1.000

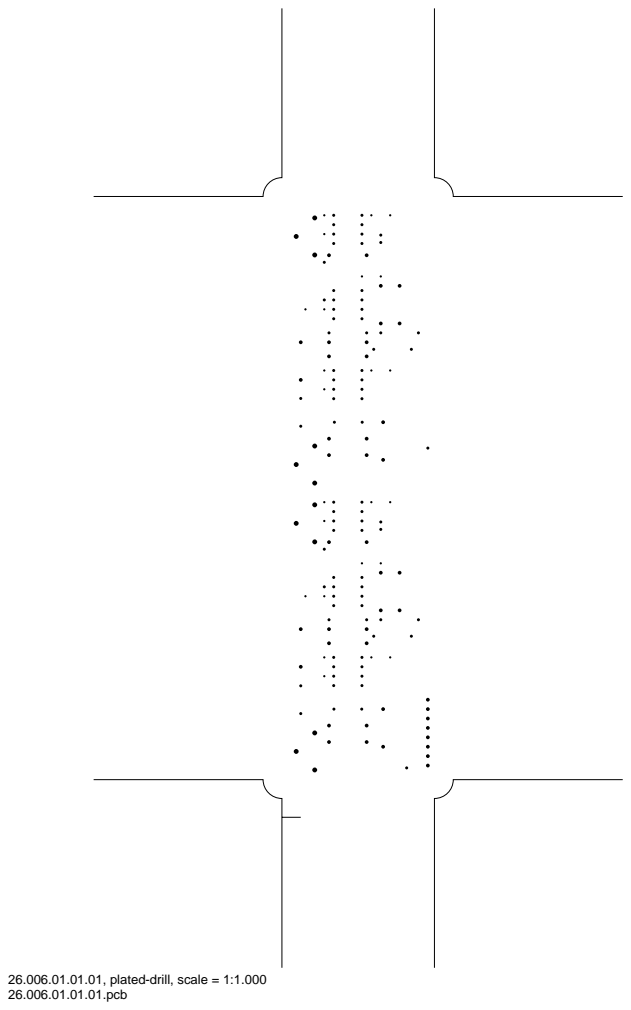
[picture p455: page 5]

26.006.01.01.01, plated-drill, scale = 1:1.000

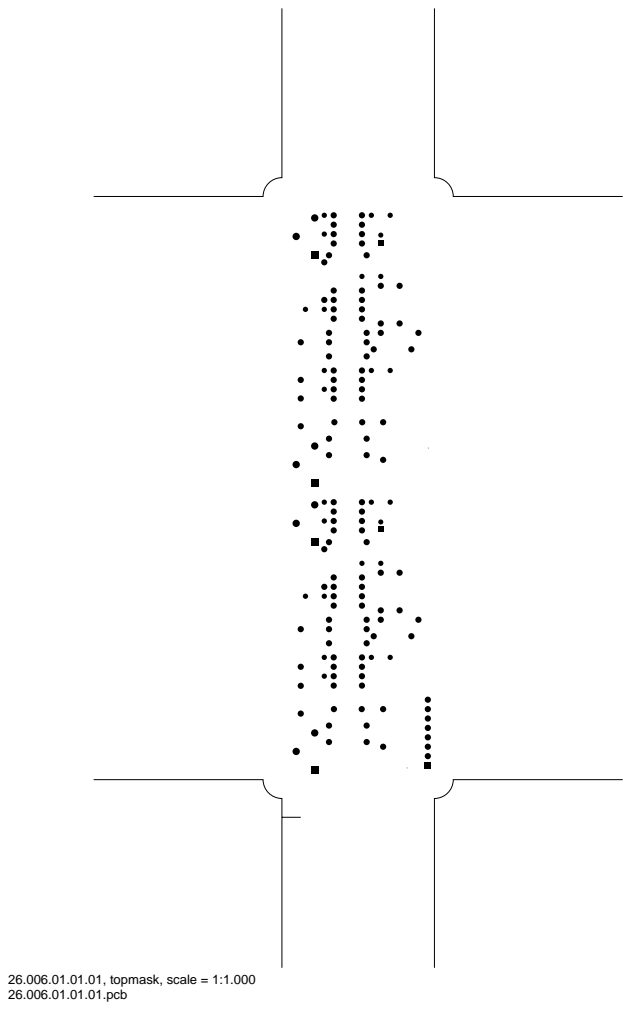
[picture p456: page 6]
26.006.01.01.01, topmask, scale = 1:1.000

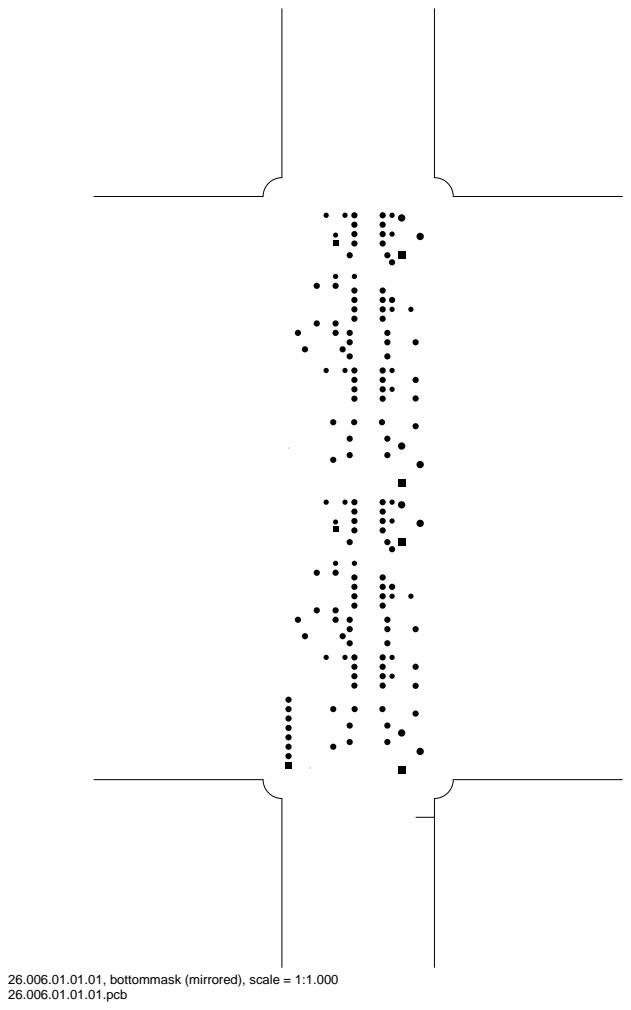
[picture p457: page 7]

26.006.01.01.01, bottommask (mirrored), scale = 1:1.000

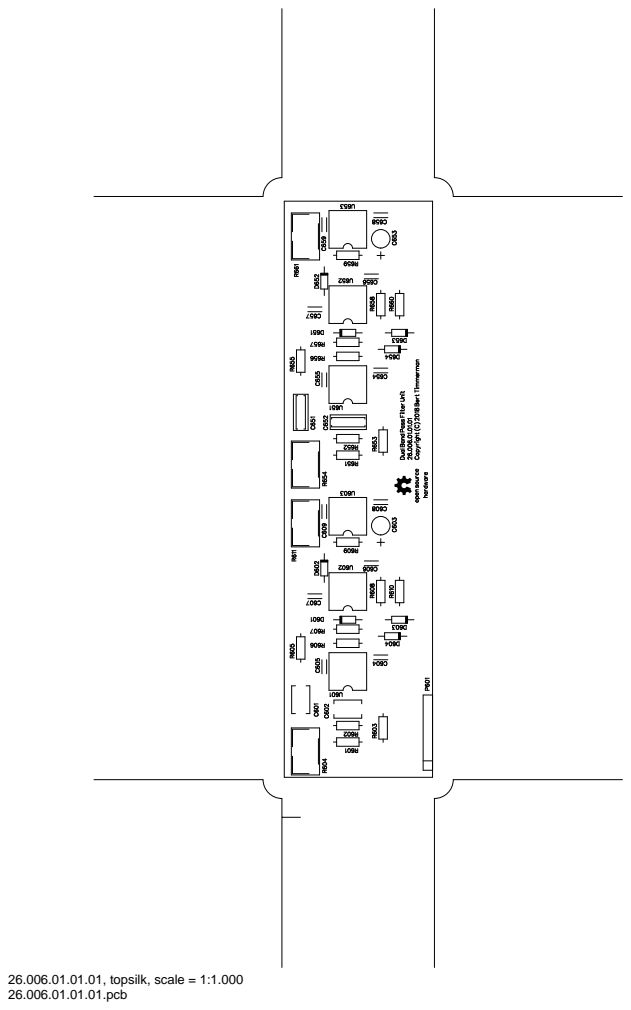
[picture p458: page 8]
26.006.01.01.01, topsilk, scale = 1:1.000

26.006.01.01.01, bottomsilk (mirrored), scale = 1:1.000

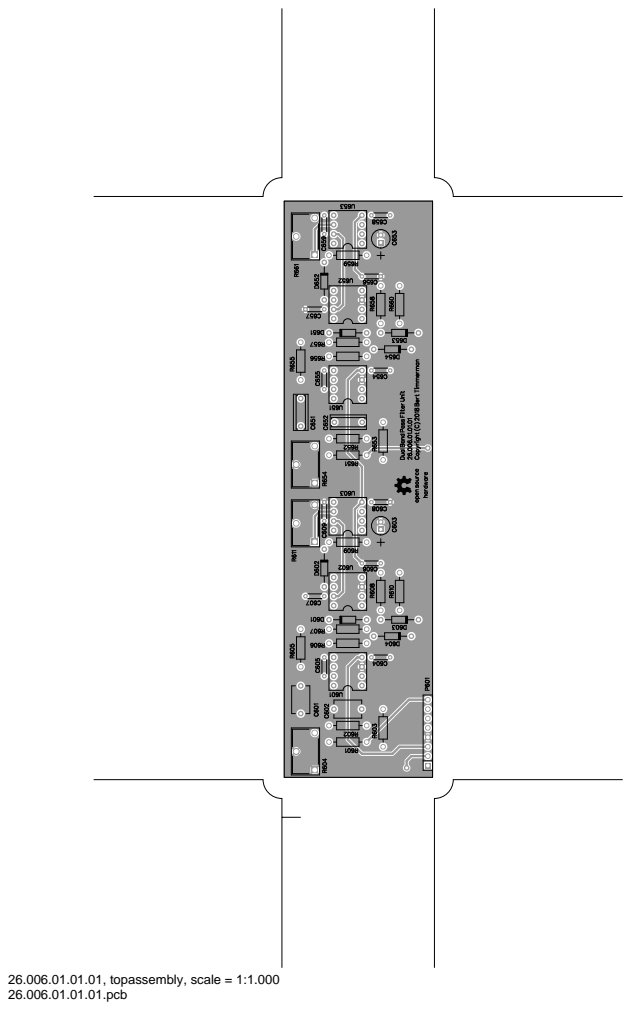
[picture p459: page 10]
26.006.01.01.01, topassembly, scale = 1:1.000

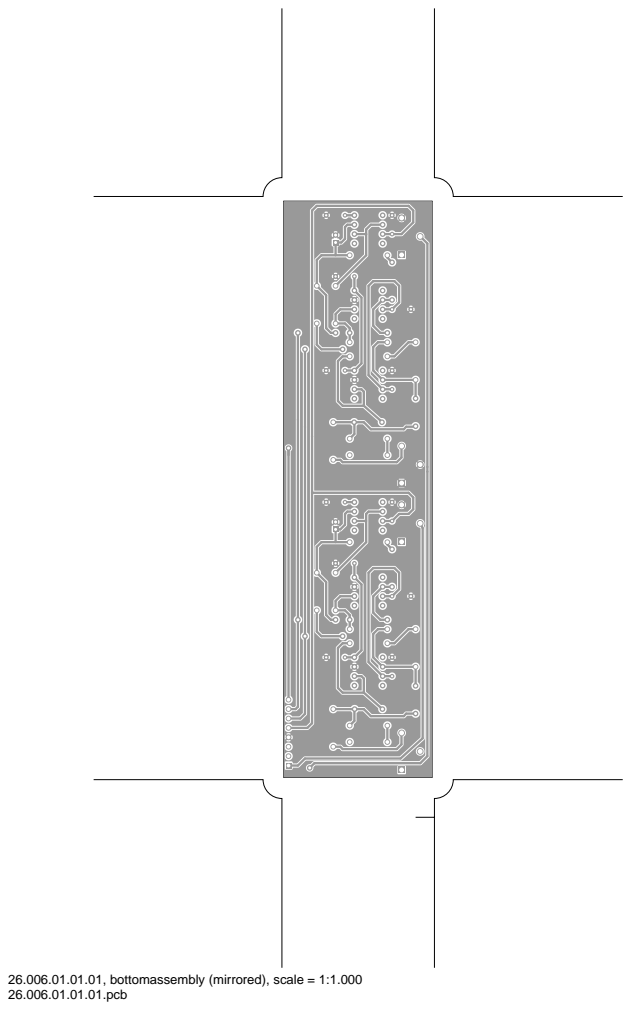
[picture p460: page 11]

26.006.01.01.01, bottomassembly (mirrored), scale = 1:1.000

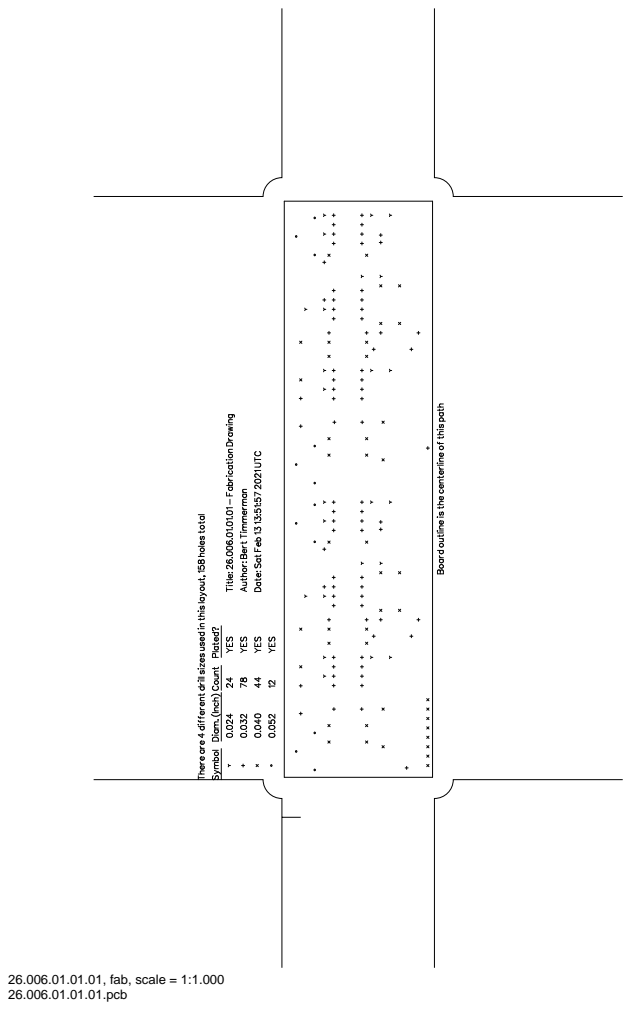
[picture p461: page 12]
26.006.01.01.01, fab, scale = 1:1.000
