lambert/26/ecad/pcb/plotfiles/26.006.02.01.01.pcb.pdf

## 26.006.02.01.01.pcb

## 1. Table of Contents (This Page) Created on Sat Feb 13 14:51:57 2021 2. top 3. bottom 4. outline 5. plated-drill 6. componentmask 7. soldermask 8. topsilk 9. bottomsilk 10. toppaste 11. bottompaste 12. topassembly 13. bottomassembly 14. fab

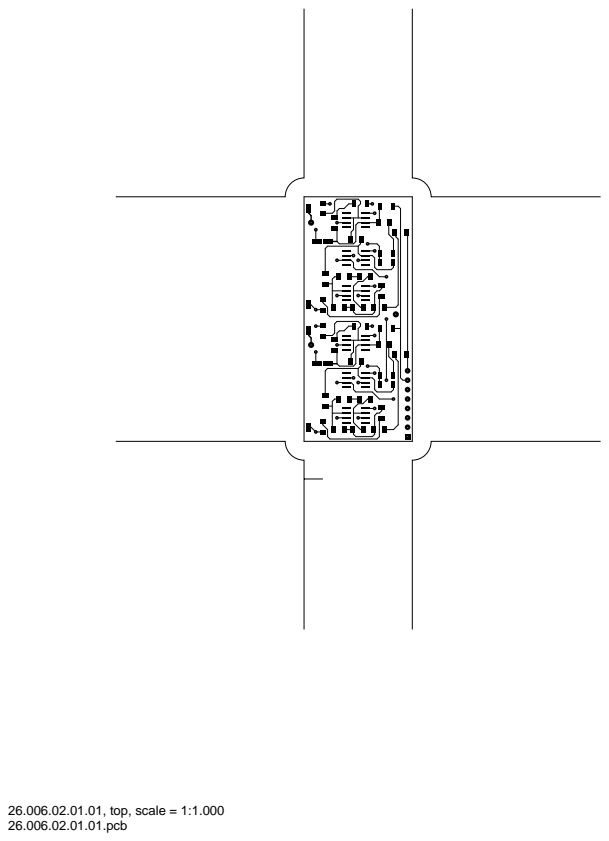
[picture p462: page 2]
26.006.02.01.01, top, scale = 1:1.000

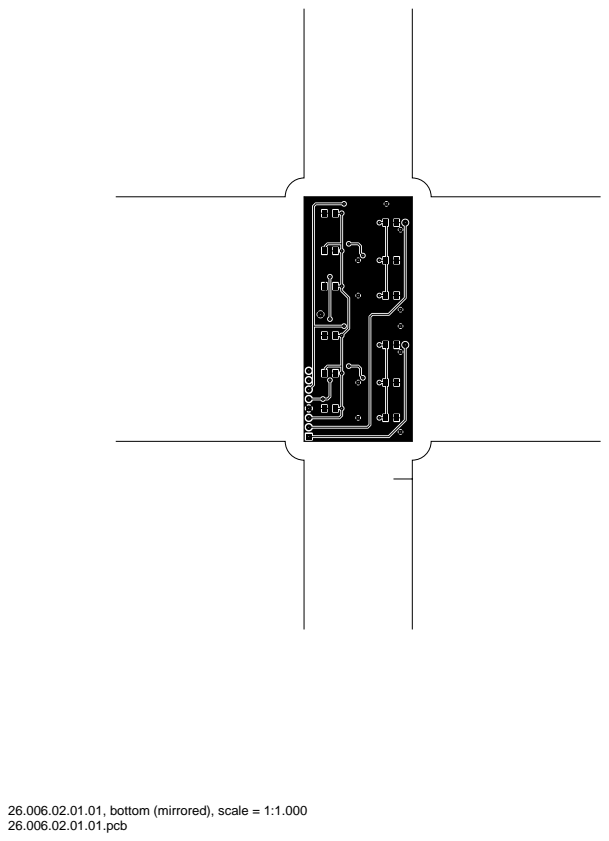
[picture p463: page 3]

26.006.02.01.01, bottom (mirrored), scale = 1:1.000

26.006.02.01.01, outline, scale = 1:1.000

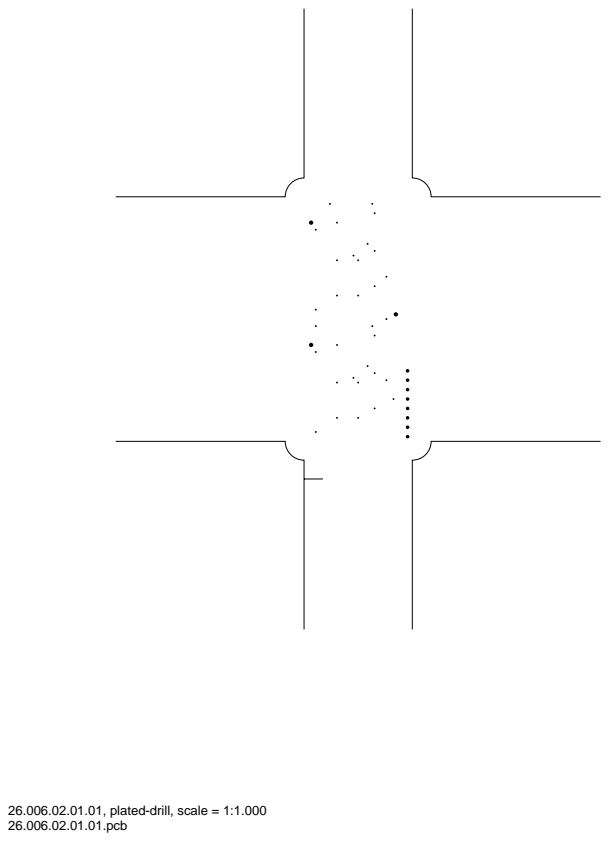
[picture p464: page 5]

26.006.02.01.01, plated-drill, scale = 1:1.000

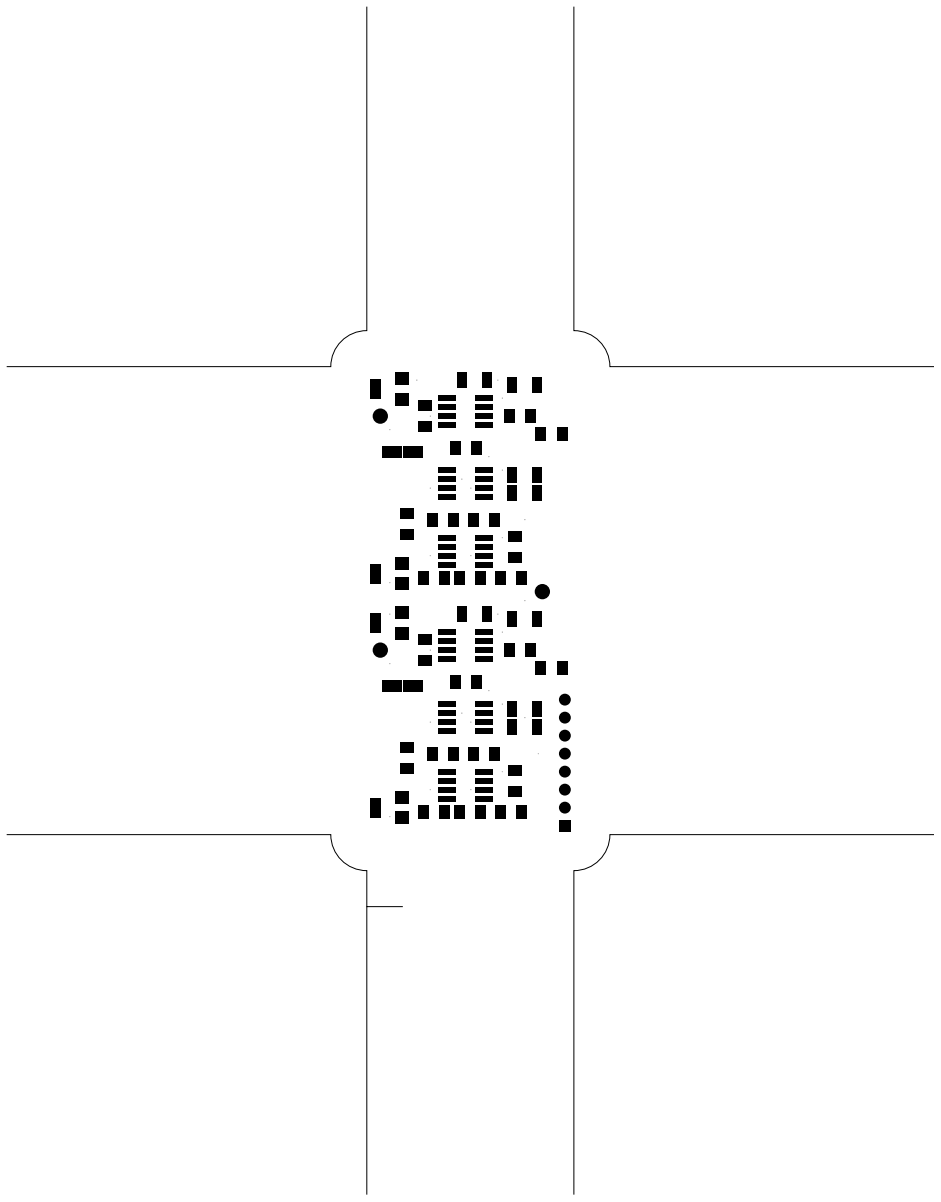
[picture p465: figure]

26.006.02.01.01, topmask, scale = 1:1.000

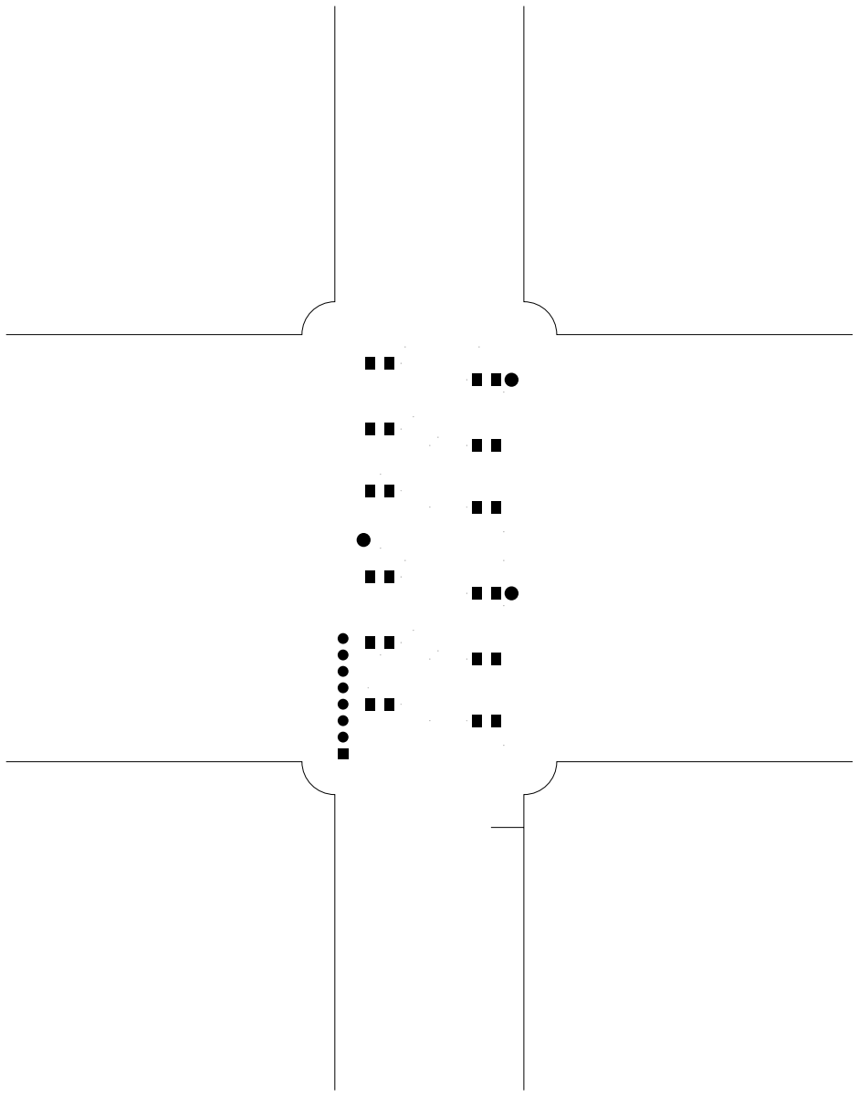
[picture p466: figure]

26.006.02.01.01, bottommask (mirrored), scale = 1:1.000

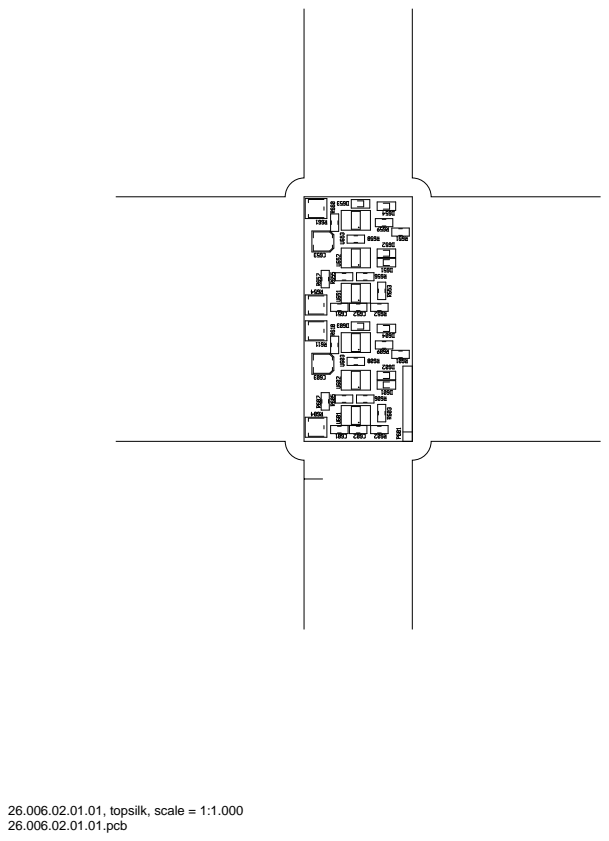
[picture p467: page 8]
26.006.02.01.01, topsilk, scale = 1:1.000

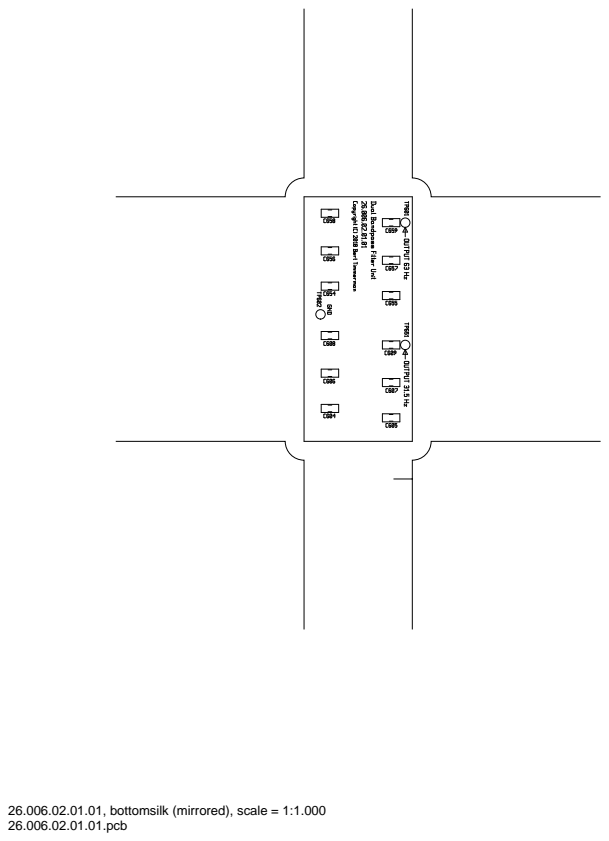
[picture p468: page 9]

26.006.02.01.01, bottomsilk (mirrored), scale = 1:1.000

26.006.02.01.01, toppaste, scale = 1:1.000

26.006.02.01.01, bottompaste (mirrored), scale = 1:1.000

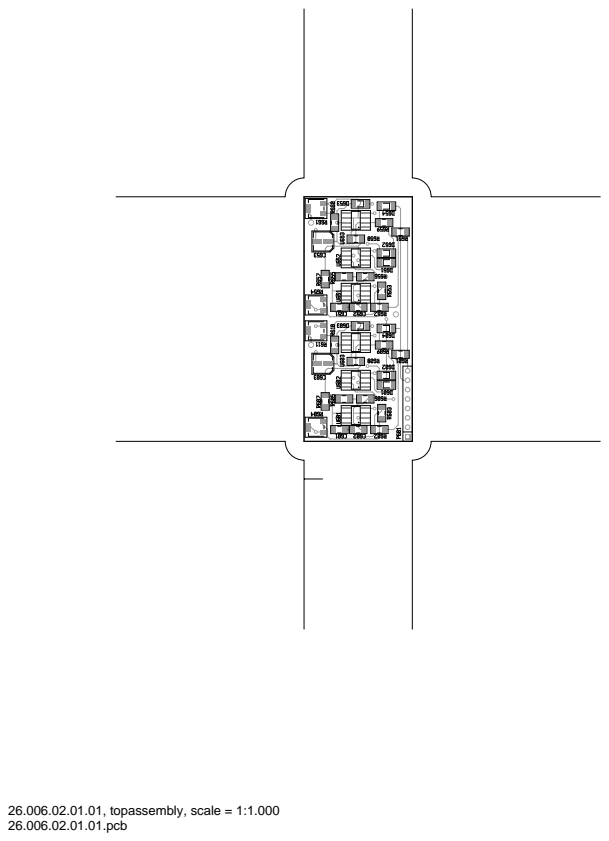
[picture p469: page 12]
26.006.02.01.01, topassembly, scale = 1:1.000

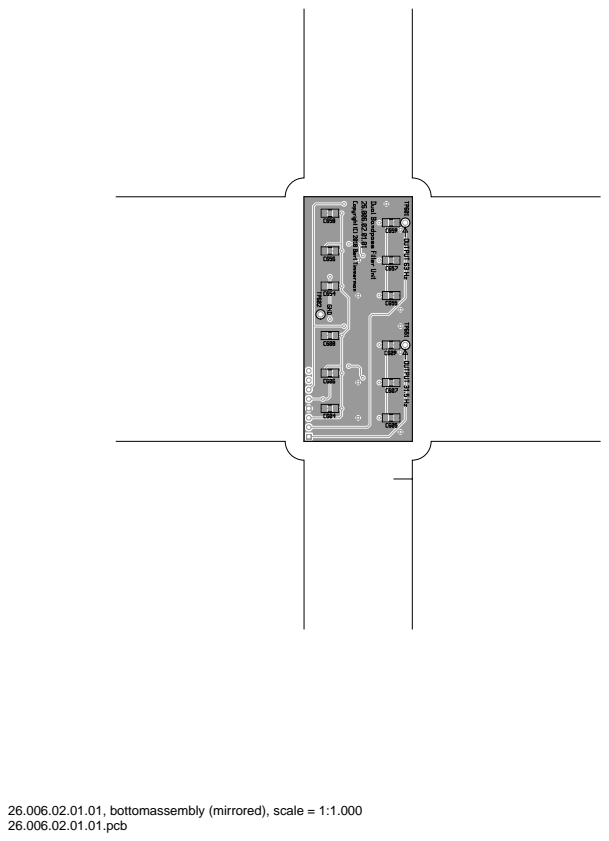
[picture p470: page 13]

26.006.02.01.01, bottomassembly (mirrored), scale = 1:1.000

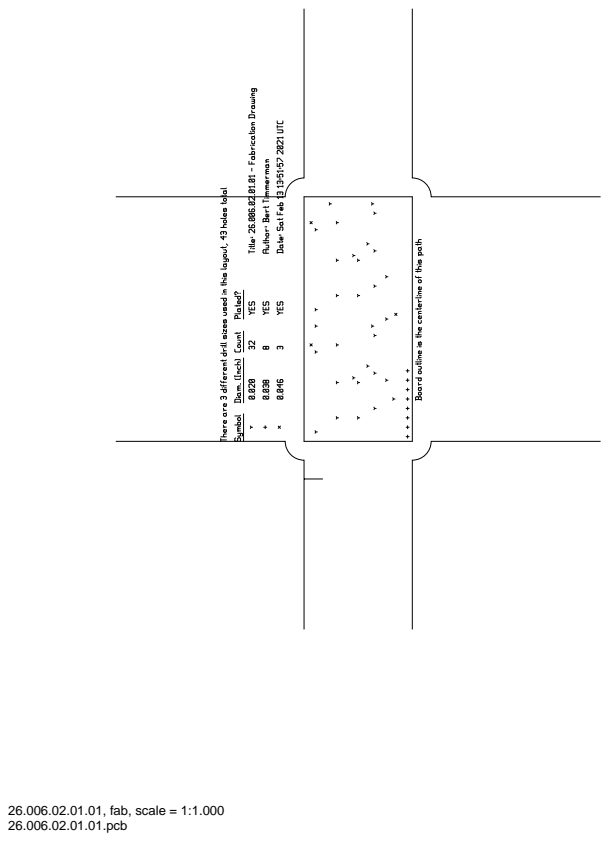
[picture p471: page 14]
26.006.02.01.01, fab, scale = 1:1.000
