lambert/26/(list of files, drawings)

Other design files:
ecad/pcb/26.001.00.01.01.pcb
ecad/pcb/26.002.00.01.01.pcb
ecad/pcb/26.003.00.01.01.pcb
ecad/pcb/26.004.00.01.01.pcb
ecad/pcb/26.005.00.01.01.pcb
ecad/pcb/26.006.00.01.01.pcb
ecad/pcb/26.006.01.01.01.pcb
ecad/pcb/26.006.02.01.01.pcb
ecad/pcb/26.007.01.01.01.pcb
ecad/pcb/26.999.00.01.01.pcb
ecad/pcb/26.999.01.01.01.pcb
