lambert/26/(commit log)

2017-08-02 Added schematics.
    [26.000.00.00.01.sch, 26.000.00.01.01.sch, 26.000.00.01.02.sch, 26.000.00.01.03.sch, 26.000.00.01.04.sch, 26.000.00.01.05.sch, 26.000.00.01.06.sch, 26.000.00.01.07.sch]
2017-08-02 Added pcb layout files.
    [26.001.00.01.01.pcb, 26.002.00.01.01.pcb, 26.003.00.01.01.pcb, 26.004.00.01.01.pcb, 26.005.00.01.01.pcb, 26.006.00.01.01.pcb, 26.006.01.01.01.pcb, 26.006.02.01.01.pcb]
2017-08-02 Added supporting files for schematics.
2017-08-08 Updated connector attributes.
    [26.006.00.01.01.sch, 26.006.01.01.01.sch]
2017-08-08 Renumbered refdes's.
    [26.006.02.01.01.sch, 26.007.01.01.01.sch, 26.008.01.01.01.sch]
2017-08-08 Updated the Import schematics attribute.
    [26.001.00.01.01.pcb, 26.002.00.01.01.pcb, 26.003.00.01.01.pcb, 26.004.00.01.01.pcb, 26.005.00.01.01.pcb, 26.006.00.01.01.pcb, 26.006.01.01.01.pcb, 26.006.02.01.01.pcb]
2017-08-15 Added a front panel schematic.
    [26.001.00.01.01.sch]
2017-08-15 Updated the front pcb schematic.
    [26.002.00.01.01.sch]
2017-09-18 Updated the PTH prototype rev. 1 pcb.
    [26.006.01.01.01.pcb]
2017-09-18 Updated the prototype rev. 1 schematic.
    [26.006.01.01.01.sch]
2017-09-18 Updated the 31.5 Hz and 63 Hz module schematic.
    [26.000.00.01.03.sch]
2017-09-18 Updated the main pcb.
    [26.003.00.01.01.pcb]
2017-09-18 Updated the shielding pcb.
    [26.004.00.01.01.pcb]
2017-09-18 Updated the strut pcb.
    [26.005.00.01.01.pcb]
2017-09-18 Updated the Makefile for pcb.
2017-09-18 Added eyecandy for the PTH prototype.
2017-09-18 Added eyecandy for the PTH prototype rev. 1 pcb.
2017-09-18 Added a README for the pcb directory.
2018-01-05 Added mechanical CAD files.
    [26.000.00.01.00_assembly_SW_ISO_view.dwg, 26.000.00.01.01_assembly_ISO_views.dwg, 26.000.00.01.02_assembly_top_view.dwg, 26.000.00.01.03_assembly_bottom_view.dwg, 26.000.00.01.04_assembly_front_view.dwg, 26.000.00.01.05_assembly_back_view.dwg, 26.000.00.01.06_assembly_left_view.dwg, 26.000.00.01.07_assembly_right_view.dwg]
2018-02-24 Added gerbers in zip file.
2018-02-24 Added mcad partslists.
    [26.000.00.01.01_assembly_partlist.csv, 26.001.00.01.01_front_panel_assembly_partlist.csv, 26.002.00.01.01_front_pcb_assembly_placement.csv, 26.003.00.01.01_main_pcb_assembly_placement.csv]
2018-05-13 Removed obsolete schematics.
    [26.006.00.01.51.sch, 26.006.00.01.52.sch, 26.006.00.01.53.sch]
2018-05-13 Updated the cover page for the schematics
    [26.000.00.00.01.sch]
2018-05-13 Updated the toplevel schematic.
    [26.000.00.01.02.sch]
2018-05-13 Updated the 125 Hz and 250 Hz module board schematic.
    [26.000.00.01.04.sch]
2018-05-21 Updated the top level schematic.
    [26.000.00.01.02.sch]
2018-05-21 Modified refdes and part number locations and justification.
    [26.000.00.01.03.sch]
2018-05-21 Corrections on opamps.
    [26.000.00.01.05.sch]
2018-05-21 Corrections on connector (NC symbols added).
    [26.003.00.01.01.sch]
2018-05-21 Added a schematic for the shielding pcb (DFM).
    [26.004.00.01.01.sch]
2018-05-21 Added a schematic for the strut pcb (DFM).
    [26.005.00.01.01.sch]
2018-05-21 Added a schematic for gnucap simulation (graphic representation only).
    [26.006.00.02.01.sch]
2018-05-21 Added eyecandy for the 26.006.01 pcb.
2018-05-21 Renumbered refdesses on 26.006.01 pcb.
    [26.006.01.01.01.pcb]
2018-05-21 Renumbered the 26.006.02 pcb.
    [26.006.02.01.01.pcb]
2018-05-21 Stop ignoring pcb eyecandy.
2018-05-21 Correction in the title.
    [26.006.00.02.01.sch]
2018-05-22 Updated gnucap 26.006.00.02.01 circuit.
2018-05-22 Removed obsolete file.
    [26.006.00.54.01.sch]
2018-05-24 Updated 26.006.00.02.01.sch.
    [26.006.00.02.01.sch]
2018-05-24 Added 26.006.00.03.01.sch.
    [26.006.00.03.01.sch]
2018-05-24 Updated 26.006.00.52.01.sch
    [26.006.00.52.01.sch]
2018-05-24 Updated 26.006.00.53.01.sch.
    [26.006.00.53.01.sch]
2018-05-25 Reordered 31.5 Hz module gnucap files.
2018-05-25 Use a single circuit and data file for multiple graphs.
2018-05-26 Print all in the first transient graph.
2018-05-30 Added simulations for the input stage of the main board.
2018-06-03 Correction in power symbols.
    [26.000.00.01.02.sch]
2018-06-04 Moved the diode model line.
2018-06-04 Corrections in netname labels and power symbols.
    [26.000.00.01.01.sch, 26.006.01.01.01.sch]
2018-06-04 Correction in label.
    [26.006.00.03.01.sch]
2018-06-05 Changed a netname.
    [26.006.02.01.01.sch]
2018-06-05 Added a schematic.
    [26.003.00.02.01.sch]
2018-06-05 Added pcb eyecandy.
2018-06-05 Updated the pcb README.
2018-06-29 Added a schematic for a CA3140AM breakout.
    [26.999.00.01.01.sch]
2018-06-29 Added a CA3140AM breakout board.
    [26.999.00.01.01.pcb]
2018-06-29 Updated the pcb Makefile.
2018-06-29 Added eyecandy for the CA3140AM breakout board.
2018-07-10 Added zipfile with gerbers.
2018-07-17 Added pcb verification for 26-006-01.
2018-07-29 Correction in drill hole size and footprints for 26-999.
    [26.999.01.01.01.pcb, 26.999.01.01.01.sch]
2018-07-29 Added files for 26.999.01.01.01.
    [26.999.01.01.01.GBL, 26.999.01.01.01.GBO, 26.999.01.01.01.GBS, 26.999.01.01.01.GKO, 26.999.01.01.01.GTL, 26.999.01.01.01.GTO, 26.999.01.01.01.GTS, 26.999.01.01.01.XLN]
2018-07-29 Added files for 26.999.00.01.01.
    [26.999.00.01.01.GBL, 26.999.00.01.01.GBO, 26.999.00.01.01.GBS, 26.999.00.01.01.GKO, 26.999.00.01.01.GTL, 26.999.00.01.01.GTO, 26.999.00.01.01.GTS, 26.999.00.01.01.XLN]
2018-07-29 Updated 26.999.01.01.01.
    [26.999.01.01.01.GBL, 26.999.01.01.01.GBO, 26.999.01.01.01.GBS, 26.999.01.01.01.GKO, 26.999.01.01.01.GTL, 26.999.01.01.01.GTO, 26.999.01.01.01.GTS, 26.999.01.01.01.gbp]
2018-07-29 Added gnetlist files.
    [26.001.00.01.01.sch.csv, 26.002.00.01.01.sch.csv, 26.003.00.01.01.sch.csv, 26.006.00.01.01.sch.csv, 26.006.01.01.01.sch.csv, 26.006.02.01.01.sch.csv, 26.007.01.01.01.sch.csv, 26.008.01.01.01.sch.csv]
2018-07-29 Added files generated by pcb.
    [26.001.00.01.01.GBL, 26.001.00.01.01.GBO, 26.001.00.01.01.GBS, 26.001.00.01.01.GKO, 26.001.00.01.01.GTL, 26.001.00.01.01.GTO, 26.001.00.01.01.GTS, 26.002.00.01.01.GBL]
2018-08-05 Updated schematics.
    [26.000.00.01.02.sch, 26.001.00.01.01.sch, 26.001.00.01.01.sch.csv, 26.002.00.01.01.sch, 26.002.00.01.01.sch.csv, 26.003.00.01.01.sch, 26.003.00.01.01.sch.csv, 26_OCTAVE_FILTER_bom.csv]
2018-08-06 Unembed a symbol.
    [26.002.00.01.01.sch]
2018-08-07 Added vendor part numbers.
    [26.002.00.01.01.sch]
2018-08-07 Updated generated files from schematic.
    [26.002.00.01.01.sch.csv]
2018-08-07 Updated pcb files.
    [26.002.00.01.01.pcb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]
2018-08-10 Added zip file with gerbers.
2018-08-10 Update and rename 26.000.00.01.01_assembly_partlist.csv to 26.000.00.01.01_assembly_partlist.md
    [26.000.00.01.01_assembly_partlist.csv]
2018-08-10 Update and rename 26.001.00.01.01_front_panel_assembly_partlist.csv to 26.001.00.01.01_front_panel_assembly_partlist.md
    [26.001.00.01.01_front_panel_assembly_partlist.csv]
2018-08-10 Updated the front pcb.
    [26.000.00.01.02.sch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]
2018-08-10 Updated the front panel.
    [26.001.00.01.01.GBL, 26.001.00.01.01.GBO, 26.001.00.01.01.GBS, 26.001.00.01.01.GKO, 26.001.00.01.01.GTL, 26.001.00.01.01.GTO, 26.001.00.01.01.GTS, 26.001.00.01.01.XLN]
2018-08-10 Updated the side pcb.
    [26.005.00.01.01.pcb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]
2018-08-10 Updated the SOIC to DIL pcbs.
    [26.999.00.01.01.GBL, 26.999.00.01.01.GBO, 26.999.00.01.01.GBS, 26.999.00.01.01.GKO, 26.999.00.01.01.GTL, 26.999.00.01.01.GTO, 26.999.00.01.01.GTS, 26.999.00.01.01.gbp]
2018-08-10 Updated the daughter pcbs.
    [26.006.00.01.01.GBL, 26.006.00.01.01.GBS, 26.006.00.01.01.GKO, 26.006.00.01.01.GTL, 26.006.00.01.01.GTO, 26.006.00.01.01.GTS, 26.006.01.01.01.GBL, 26.006.01.01.01.GBS]
2020-02-03 Updated the schematics.
    [26.000.00.01.02.sch, 26.002.00.01.01.sch, 26.003.00.01.01.sch]
2020-02-03 Change modes of mcad drawings.
    [26.000.00.01.00_assembly_SW_ISO_view.dwg, 26.001.00.03.01_front_panel_mechanical.dwg, 26.002.00.01.01_front_pcb_assembly.dwg, 26.006.00.02.02_filter_pcb_drill_info.dwg, 26.006.01.01.01_filter_pcb_assembly.dwg]
2020-02-07 Reorganizing gncap files (WIP).
    [26.000.00.02.01.sch, 26.000.00.02.02.sch, 26.000.00.02.03.sch, 26.000.00.02.04.sch, 26.000.00.02.05.sch, 26.000.00.02.06.sch, 26.000.00.02.07.sch, 26.000.00.02.08.sch]
2020-02-07 Updating and reorganizing gnucap files (WIP)
    [26.000.00.02.02.sch, 26.000.00.02.03.sch, 26.000.00.02.04.sch, 26.000.00.02.06.sch, 26.000.00.02.09.sch, 26.000.00.02.13.sch, 26.000.00.02.16.sch, 26.000.00.02.17.sch]
2020-02-07 Updating and reorganizing gnucap files (WIP).
    [26.000.00.02.23.sch, 26.000.00.02.24.sch, 26.000.00.02.25.sch, 26.000.00.02.26.sch]
2021-02-13 Updated gnucap files.
    [26.000.00.02.27.sch, 26.000.00.02.28.sch, 26.000.00.02.29.sch, 26.000.00.02.30.sch, 26.000.00.02.31.sch, 26.000.00.02.32.sch, 26.000.00.02.33.sch, 26.000.00.02.34.sch]
2021-02-14 Added gschem files.
    [26.000.00.02.12.sch, 26.000.00.02.23.sch]
2021-02-14 Added LED series resistor calculation.
    [LED Series Resistor Calculation.xls]
2021-02-14 Expanded Y-axis scale.
2021-02-20 Deleted a gnucap circuit.
2022-04-22 Added CC BY-SA logos.
    [26.000.00.00.01.sch, 26.000.00.01.01.sch, 26.000.00.01.02.sch, 26.000.00.01.03.sch, 26.000.00.01.04.sch, 26.000.00.01.05.sch, 26.000.00.01.06.sch, 26.000.00.01.07.sch]
2022-05-01 Updated and added simulations.
    [26.001.00.00.01.sch, 26.001.00.01.01.sch, 26.001.00.01.02.sch, 26.001.00.01.03.sch, 26.002.00.00.01.sch, 26.002.00.01.01.sch, 26.002.00.01.02.sch, 26.002.00.02.02.sch]
2022-05-01 Added more simulations.
    [26.015.00.00.01.sch, 26.015.00.01.01.sch, 26.015.00.02.01.sch, 26.015.00.03.01.sch, 26.016.00.00.01.sch, 26.016.00.01.01.sch, 26.016.00.01.02.sch, 26.016.00.01.03.sch]
2024-05-23 Edited titles and added list of schematics to front page.
    [26.000.00.00.01.sch, 26.000.00.01.01.sch, 26.000.00.01.02.sch, 26.000.00.01.03.sch, 26.000.00.01.04.sch, 26.000.00.01.05.sch, 26.000.00.01.06.sch, 26.000.00.01.07.sch]
2024-06-09 Updated gnucap schematics.
    [26.000.00.00.01.sch, 26.000.00.00.02.sch, 26.000.00.00.03.sch, 26.001.00.00.01.sch, 26.001.00.01.01.sch, 26.001.00.01.02.sch, 26.001.00.01.03.sch, 26.002.00.00.01.sch]
2024-06-09 Updated gschem schematics.
    [26.000.00.00.01.sch, 26.000.00.01.01.sch, 26.000.00.01.02.sch, 26.000.00.01.03.sch, 26.000.00.01.04.sch, 26.000.00.01.05.sch, 26.000.00.01.06.sch, 26.000.00.01.07.sch]
